iamharveststorm/harvey/код/симуляция/управление с клавиатуры/assets/world/concrete_n.png

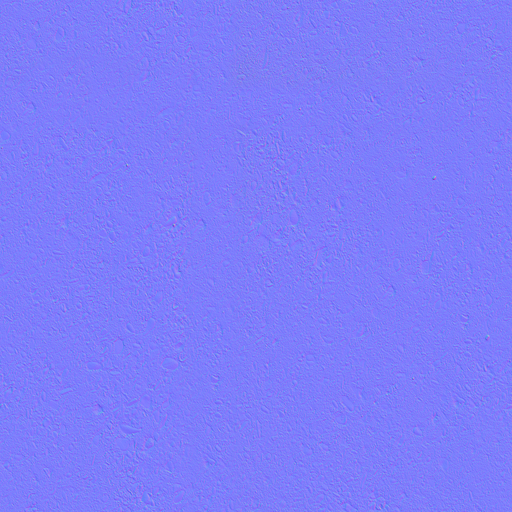
код/симуляция/управление с клавиатуры/assets/world/concrete_n.png
