iamharveststorm/harvey/код/симуляция/управление с клавиатуры/assets/world/pebbles_orm.png

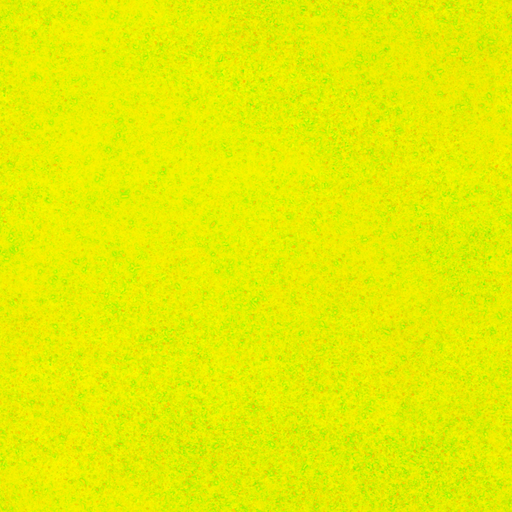
код/симуляция/управление с клавиатуры/assets/world/pebbles_orm.png
