iamharveststorm/harvey/README.md

# Харви — настольный робот-краб

DIY-робот для рабочего стола: компаньон и помощник с добрым характером. Шесть ног, две клешни, глаза-дисплеи. Мозг для речи и зрения работает на домашнем ПК, робот связан с ним по Wi-Fi.

**Начни с [Харви](<Харви.md>)** — там все заметки, модели, код и текущий этап.

## Версии

| Ветка git | Версия | Что это |
| --- | --- | --- |
| `kompakt` (метка `v2-kompakt`) | «Компакт» | STS3215 на ногах, хвост с присоской, Raspberry Pi 5 |
| `kompakt-mini` | «Компакт мини» | все 28 приводов — STS3032, без хвоста, Pi Zero 2 W, станция зарядки |

Чем отличаются и как переключиться — [Версии Харви](<заметки/Версии Харви.md>).

## Сейчас

Этап 1 — стенд одной ноги. Для мини всё заказано, детали приезжают 19–31 октября 2026: [чек-лист](<заметки/Чек-лист стенда мини.md>). Программа стенда и прошивка Pico 2 готовы и проверены в имитации.

## Папки

| Папка | Что внутри |
| --- | --- |
| [заметки](<заметки/>) | концепция, комплектация, питание, этапы, [журнал решений](<заметки/Журнал решений.md>) |
| [модели](<модели/Модели.md>) | CAD и STL: корпус, клешни, глаза, хвост, мини, стенды; рендеры и чертежи |
| [код/симуляция](<код/симуляция/Симуляция.md>) | MuJoCo: походка, сценарии, управление с клавиатуры, фотореализм |
| [код/стенд привода](<код/стенд привода/README.md>) | программа стенда: замеры приводов и ноги, отчёт в Excel |
| [схемы](<схемы/README.md>) | проводка «Компакт мини»: питание, шины приводов, Pi Zero, датчики (WireViz + schemdraw) |
| [код/прошивка](<код/прошивка/Прошивка.md>) | Pico 2 на MicroPython: шина приводов |
| [визуализация](<визуализация/>) | 3D-модель и интерактивный двойник «Компакта», двойник «Компакт мини» — открываются в браузере без интернета |
| [документы](<документы/Документы.md>) | даташиты приводов и плат, протокол шины Feetech |
| [фото](<фото/>) | эскизы, референсы, фото стенда |

## Как открыть

- **Obsidian:** «Открыть папку как хранилище» → эта папка. Главная заметка — «Харви».
- **Claude Code:** запускать в этой папке; контекст проекта — [CLAUDE.md](<CLAUDE.md>).
- **Окружения Python** живут вне OneDrive, в `C:\venvs\` (`harvey` — симуляция, `harvey-bench` — стенд, `harvey-cad` — CAD). Первые два батники в папках кода создают сами; как запускать CAD — в README папок `модели/`.

## Ранние онлайн-версии

Первые артефакты в Claude (до компоновки v2, местами устарели — источник правды здесь, в заметках): [концепт](https://claude.ai/artifact/2FwnsAK9YNNhDf2f2BEky4), [интерактивный двойник](https://claude.ai/artifact/RYYA5ZLK6qtaRUAYd5tzXc), [3D-модель](https://claude.ai/artifact/Ps9CTr6259VduU2Yr22FZN), [комплектация](https://claude.ai/artifact/6K368x5LdZn2f412QVXJA1), [совместимость](https://claude.ai/artifact/D9gDPVZMyHfYxsEXmXBaE7), [питание](https://claude.ai/artifact/VXmcD6U4bhPNbsvyJew3gP), [сборка в Onshape](https://claude.ai/artifact/CMEwwumpoMRSfavFtf1Tat), [этап 1](https://claude.ai/artifact/AMX4DpM3XnacjujbDYmoD6).
