iamharveststorm/harvey/схемы/README.md

---
title: Схемы «Компакт мини» — проводка и шина
date: 2026-10-25
tags: [харви, мини, схемы, питание, проводка]
aliases: [Проводка мини, Схемы мини]
---
# Схемы «Компакт мини»: проводка, токи, шина приводов

Семь листов, все строятся из кода (`make_wiring.py`), поэтому правятся числами, а не мышкой. Источник чисел — [[Компакт мини]], [[Комплектация мини]], [[Питание и проводка]] (принципы) и [[STS3032-C036 — даташит Feetech (6 В).pdf|даташит STS3032-C036]].

| Лист | Что на нём | Файлы |
| --- | --- | --- |
| **Питание и логика** | батарея → BMS → XT30 → плата питания (предохранитель, выключатель, INA226) → DC-DC 6 В и 5 В; заряд со станции; Pi Zero 2 W ↔ RP2350 ↔ плата шин | `mini_power.svg` / `.png` / `.html`, спецификация `mini_power.bom.tsv` |
| **Шины приводов** | 3 шины, 9 отводов от платы шин, 28 приводов с номерами ID, кабели и токи | `mini_bus.svg` / `.png` / `.html`, `mini_bus.bom.tsv` |
| **Pi Zero 2 W** | камера (шлейф CSI), 2 дисплея глаз (SPI), 2 микрофона и усилитель с динамиком (I2S), 4 сенсорные кнопки | `mini_pi.svg` / `.png` / `.html`, `mini_pi.bom.tsv` |
| **Датчики RP2350** | 6 датчиков края VL53L4CD, IMU BMI270, 2 ИК-приёмника маяка, сигнал INA226 | `mini_sensors.svg` / `.png` / `.html`, `mini_sensors.bom.tsv` |
| **Интерфейс шины** | принципиальная схема одной шины: 2 буфера LVC и автопереключение направления по схеме Feetech | `bus_buffer.svg` / `.png` |
| **Станция: питание** | USB-C 5 В 3 А → PTC 3 А → контакты pogo и плата маяка | `station.svg` / `.png` / `.html`, `station.bom.tsv` |
| **Станция: маяк** | RP2350-Zero: пачки 38 кГц по очереди на левый (0,6 мс) и правый (1,2 мс) светодиод TSAL6200 через ключи AO3400A | `beacon.svg` / `.png` |

Листы проводки широкие — смотреть удобнее `.html` или `.svg` в браузере (масштаб колесом). В `.html` под схемой — таблица проводов и спецификация.

![[bus_buffer.png]]

![[mini_bus.png]]

![[mini_power.png]]

![[mini_pi.png]]

![[mini_sensors.png]]

![[beacon.png]]

![[station.png]]

## Токи и сечения

| Участок | Напряжение | Средний ток | Пик | Провод |
| --- | --- | --- | --- | --- |
| Батарея → BMS → XT30 → плата питания → выключатель | 7,4 В (6,0–8,4) | 1,5–2 А при ходьбе | ~10 А | 18 AWG силикон |
| Плата питания → DC-DC 6 В | 7,4 В | 1–1,5 А | ~9 А | 18 AWG |
| DC-DC 6 В → плата шин (все 28 приводов) | 6,0 В | 1–2 А при ходьбе | 8–10 А | 18 AWG |
| Плата шин → нога (3 привода) | 6,0 В | 0,1–0,6 А | 3,6 А (3 × упор 1,2 А) | 22 AWG |
| Плата шин → клешня (4 привода) | 6,0 В | 0,1–0,3 А | 4,8 А | 22 AWG |
| Плата шин → глаза (2 привода) | 6,0 В | до 0,1 А | 2,4 А | 22 AWG |
| Привод → привод внутри конечности | 6,0 В | — | 1,2 А × число приводов дальше | 1,25 мм, 28 AWG (из комплекта) |
| Плата питания → DC-DC 5 В → Pi Zero 2 W | 7,4 / 5 В | 0,5–1,5 А (5 В) | — | 22 AWG |
| Станция → пластины на брюхе → модуль заряда | 5 В | до 3 А | — | 20 AWG |
| Модуль заряда → батарея | 8,4 В | до 1,8 А | — | 22 AWG |
| Логика, шины A/B/C, I2C | 3,3 В | — | — | 28 AWG |
| Pi → камера (шлейф CSI) | 3,3 В | 0,2–0,25 А | — | шлейф Zero 22 → 15 pin |
| Pi → глаз (через стебелёк, × 2) | 3,3 В | ~35 мА с подсветкой | — | 8 × 30 AWG силикон, петля на поворот |
| Pi → усилитель → динамик | 5 В | до 0,3 А | — | 28 AWG; динамик — 26 AWG |
| Pi → микрофоны, кнопки; RP2350 → датчики | 3,3 В | мА | — | 30 AWG |

Бюджет: ходьба 8–12 Вт → 1,5–2 ч от 22 Вт·ч (оценка из симуляции; стенд ноги её проверит — замер Н5).

## Номера приводов (ID)

ID = 10 × конечность + сустав. Шина A — левые ноги, B — правые ноги, C — клешни и глаза.

| Конечность | Шина | ID |
| --- | --- | --- |
| левая передняя / средняя / задняя нога (LF, LM, LB) | A | 11–13 · 21–23 · 31–33 (поворот, бедро, колено) |
| правая передняя / средняя / задняя нога (RF, RM, RB) | B | 41–43 · 51–53 · 61–63 |
| левая / правая клешня (CL, CR) | C | 71–74 · 81–84 (поворот плеча, подъём, локоть, захват) |
| глаза левый / правый (EY) | C | 91 · 92 |

На стенде ноги номера 1–3 — это временно; в роботе их перепишет программа стенда (пункт 2 меню).

## Выводы RP2350-Zero (предварительно)

У RP2350-Zero 20 выводов (GP0–GP15, GP26–GP29) — **заняты все, кроме двух**. Поэтому 4 сенсорные кнопки перенесены на Pi Zero: там свободных выводов много, а реакция на поглаживание и так работает на борту без ПК.

| Вывод | Назначение | Почему здесь |
| --- | --- | --- |
| GP0 / GP1 | шина A (левые ноги): UART0 TX / RX | аппаратный UART |
| GP4 / GP5 | шина B (правые ноги): UART1 TX / RX | второй аппаратный UART |
| GP8 / GP9 | шина C (клешни, глаза): UART на PIO | аппаратных UART всего два |
| GP12 / GP13 | I2C0 SDA / SCL: INA226, BMI270, 6 × VL53L4CD | одна шина на все датчики, 400 кГц |
| GP2, GP3 | XSHUT датчиков края вперёд (слева, справа) | у VL53L4CD один адрес: при включении поднимаем XSHUT по одному и меняем адрес |
| GP6, GP7 | XSHUT датчиков края назад | |
| GP10, GP11 | XSHUT датчиков края по бокам | |
| GP14 / GP15 | ИК-приёмники TSOP38238 слева / справа | направление на маяк станции без ПК |
| GP28 | ИК-приёмник TSOP38238 по центру, под камерой | по какую сторону оси станции корпус — заход в темноте |
| GP26 | INT1 BMI270 | прерывание: рывок, падение, «подняли» — мгновенно, без опроса |
| GP27 | ALERT INA226 | прерывание: низкий заряд, перегрузка |
| GP29 | **резерв** (АЦП) | например, второй замер батареи или датчик касания на брюхе |
| USB-C | связь с Pi Zero 2 W (USB CDC) и питание 5 В от Pi | данные и питание одним кабелем |

## Выводы Pi Zero 2 W (предварительно)

| Пин гребёнки | GPIO | Назначение |
| --- | --- | --- |
| 2 / 4 | — | 5 В: вход от DC-DC 5 В / питание усилителя |
| 1 / 17 | — | 3,3 В: глаза / микрофоны и кнопки |
| 6, 9, 14, 20, 25 | — | GND |
| 23 / 19 | GPIO11 / GPIO10 | SPI0 SCLK / MOSI — оба глаза |
| 24 / 26 | GPIO8 / GPIO7 | SPI0 CE0 — левый глаз / CE1 — правый глаз |
| 22 / 18 | GPIO25 / GPIO24 | DC / RST — общие для обоих глаз |
| 32 | GPIO12 | PWM0 — яркость подсветки глаз |
| 12 / 35 | GPIO18 / GPIO19 | I2S BCLK / LRCLK — микрофоны и усилитель |
| 38 | GPIO20 | I2S DIN ← оба микрофона (левый L/R → GND, правый L/R → 3,3 В) |
| 40 | GPIO21 | I2S DOUT → усилитель MAX98357A |
| 37 | GPIO26 | SD усилителя: 0 — тишина |
| 29, 31, 36, 11 | GPIO5, 6, 16, 17 | 4 сенсорные кнопки TTP223 на крышке |
| CSI | — | Camera Module 3 Wide (шлейф Zero 22 → 15 pin) |
| USB OTG | — | RP2350-Zero |

Свободны: GPIO14/15 (UART), GPIO2/3 (I2C1), GPIO4, GPIO13, GPIO22, GPIO23, GPIO27.

## Что выяснилось при рисовании — поправить до закупки

1. **Pogo-контакты станции.** В списке они на ≥ 2 А, а заряд идёт до 3 А при 5 В (IP2326, 15 Вт). Брать pogo **на 3–5 А** — или ограничить ток заряда до 2 А (10 Вт, заряд дольше).
2. **Выключатель** несёт весь ток робота, пик ~10 А. Мини-тумблеры на 3 А не годятся: нужен ≥ 10 А (или выключатель-кнопка с MOSFET).
3. **Провод 22 AWG** — для отводов от платы шин к конечностям (пик 3,6–4,8 А). В списке были только 18 и 26 AWG.
4. **Разъём 1,25 мм** рассчитан примерно на 1 А на контакт. Первый привод конечности пропускает ток всех следующих: у ноги в упоре — до 3,6 А, у клешни — до 4,8 А. Упор всех приводов сразу редок, но на стенде ноги стоит потрогать разъём после 10 минут шага (замер Н4). Если греется — питание к каждому приводу отдельным проводом от платы шин.
5. **Сколько разъёмов у STS3032?** На чертеже Feetech виден один. Если так и есть, цепочка привод → привод собирается тройниками из комплекта разъёмов 1,25 мм. Схема одинакова в обоих случаях.
6. **Станция.** В сводке [[Компакт мини]] было «блок питания 12 В 2 А», в [[Комплектация мини]] и здесь — USB-C 5 В 3 А (модуль заряда IP2326 принимает 5 В). Сводка исправлена на 5 В.
7. **Все выводы RP2350-Zero заняты.** Кнопки касания перенесены на Pi Zero; на RP2350 остались прерывания IMU и INA226 и 1 резервный вывод (GP28 занял центральный ИК-приёмник). Если понадобится ещё что-то, следующий шаг — расширитель выводов по I2C (например, PCA9555) или RP2350 побольше.
8. **3,3 В от Pi** питают камеру (0,2–0,25 А), оба глаза и микрофоны — всего около 0,35 А. Это в пределах, но запас небольшой. Если глаза будут мерцать при съёмке, подсветку нужно питать от отдельного стабилизатора 3,3 В.
9. **Глаза — 8 проводов через подвижный стебелёк.** Нужен тонкий силиконовый провод (30 AWG) с петлёй на поворот глаза от −90° до +20°, частота SPI — не выше 32 МГц. Двум глазам 160 × 160 при 30 кадр/с нужно около 25 Мбит/с, так что этого хватает.
10. **Кнопки на съёмной крышке.** На крышку идут 6 проводов (3,3 В, GND, 4 сигнала) — нужен разъём, чтобы крышку можно было снять. Микроразъём JST 1,25 мм на 6 контактов.

## Станция-«гнездо»

**Маяк: два светодиода и перегородка.** Один светодиод даёт Харви только направление на себя, но не ось станции. Сбоку Харви приходил к контактам по диагонали и промахивался мимо пластин (допуск вбок ±3,5 мм). Поэтому светодиодов два, левый и правый, а между ними перегородка к Харви. Оба светодиода видны только в узком клине вдоль оси. Центральный приёмник Харви видит оба — значит, Харви на оси; видит только левый — Харви левее оси. В темноте метка AprilTag не видна, а маяк работает.

**Почему RP2350-Zero, а не NE556.** Светодиоды нужно различать. Они светят по очереди пачками разной длины, и TSOP382 повторяет длину пачки на выходе: tpo = tpi ± 5/f0, то есть ±132 мкс (документы/TSOP382 — даташит Vishay.pdf, стр. 3). Нарезать две разные пачки по очереди на двух таймерах NE556 сложно. RP2350-Zero делает это одной программой, и плата та же, что «спинной мозг» Харви.

| Что | Расчёт | Итог |
| --- | --- | --- |
| Пачки | левый 0,6 мс, пауза 0,6, правый 1,2 мс, пауза 0,6 (`код/прошивка/станция/beacon_station.py`) | 23 и 46 периодов, пауза 23; TSOP382: пачка ≥ 10, пауза ≥ 12, ≤ 1700 пачек/с — здесь 667 |
| Несущая | ШИМ RP2350 38 кГц, заполнение 1/3 | — |
| Ключ AO3400A | Vgs(th) ≤ 1,45 В, Rds(on) < 48 мОм при 2,5 В (документы/AO3400A — даташит AOS.pdf) | открывается от 3,3 В вывода |
| Светодиод TSAL6200 | (5 − 1,35) В / 33 Ом | ~110 мА в импульсе (IFM 200 мА), в среднем ≤ 15 мА |

**Где что стоит** (модели/мини, `dock_tower`):
- светодиоды — в стенке башенки на высоте 12 мм, в 3,5 мм по обе стороны оси;
- перегородка — 42,5 мм к Харви, высотой 31 мм, толщиной 1,5 мм. Она ниже метки, иначе камера на оси видит её ребром поперёк метки;
- метка — в окне на высоте 33–63 мм, башенка 67 мм;
- на Харви три TSOP38238: боковые по сторонам камеры развёрнуты наружу на ±30°, центральный стоит под объективом и смотрит вперёд.

Клин, где центральный приёмник видит оба светодиода: половина ширины ≈ 2,75 · D / 42,5 − 3,5 мм на расстоянии D. У контактов это ~1 мм, в 30 см — ~16 мм. Проверка `check_beacon` в модели — что видит каждый приёмник:

| Где Харви (от стенки корпуса до башенки, сдвиг вбок) | слева | центр | справа |
| --- | --- | --- | --- |
| 300 мм, по оси | L | LR | R |
| 300 мм, +15 мм | L | L | LR |
| 300 мм, −15 мм | LR | R | R |
| 100 мм, по оси | L | LR | R |
| 100 мм, ±15 мм | — / L | L / R | R / — |
| 20 мм — уже над площадкой | — | — | — |

Над площадкой маяк не виден: приёмники уже у перегородки. Дальше Харви идёт по курсу гироскопа и останавливается по датчикам края.

**Что проверить на стенде:**
- длина пачек на выходе TSOP (осциллограф или `beacon.py`);
- граница клина у реальной перегородки — отражения от стола могут его расширить; если так, ток светодиодов уменьшить резистором побольше;
- не греются ли резисторы 33 Ом.

## Как перестроить

Двойной клик по `make_schemes.bat` (окружение `C:\venvs\harvey-schemes`: WireViz 0.4, schemdraw 0.23, Graphviz 16). Числа, провода и подписи — в `make_wiring.py`; `.yml` генерируются из него.

Related: [[Компакт мини]] · [[Комплектация мини]] · [[Питание и проводка]] · [[Чек-лист стенда мини]] · [[код/прошивка/pico/README|Pico 2 — шина приводов]] · [[Журнал решений]]
