iamharveststorm/harvey/модели/стенд кисти/README.md

# Харви — детали стенда кисти (STS3032-C036)

Кисть клешни для этапа 1: запястье (привод 21) поворачивает кисть вокруг оси предплечья, захват (привод 22) двигает верхний палец, нижний палец неподвижный. Пальцы 26 мм согнуты вниз на 30°, на рабочих гранях — накладки из TPU. Всё сделано под [[STS3032-C036 — даташит Feetech (6 В).pdf|STS3032-C036]], размеры — с чертежа на с. 6 даташита.

![[рендер кисти.png]]

Рендер — Blender: `python export_render_parts.py`, затем `blender --background --python render_hand.py` (папка `render_parts/` — промежуточные STL для рендера, их не печатать). Чертёж ладони — [[ХАРВИ.02.002 Ладонь кисти.pdf]].

![[сборка кисти.png]]

## Детали (папка `stl/`)

| Файл | Сколько | Материал | Как печатать | Зачем |
| --- | --- | --- | --- | --- |
| `harvey_hand_wrist_stand.stl` | 1 | PETG | основанием на стол | стойка: держит привод 21 валом вперёд, ось на 40 мм над доской |
| `harvey_hand_palm.stl` | 1 | PETG | стенкой на стол, с поддержками под пальцем | ладонь: на качалку привода 21, держит привод 22 и нижний палец |
| `harvey_hand_jaw.stl` | 1 | PETG | плашмя | верхний подвижный палец на качалке привода 22 |
| `harvey_hand_pad_TPU_x2.stl` | 2 | TPU 95A | плашмя, насечкой вверх | накладки на пальцы, вклеить в пазы |
| `harvey_hand_grip_lever_25mm.stl` | 1 | PETG | плашмя | рычаг 25 мм для замера силы захвата (замер 10) |
| `harvey_hand_cradle_sts3032.stl` | 1 | PETG | основанием на стол | держатель одного STS3032 валом вверх — для замеров без кисти |

`_сборка_для_просмотра.stl` — вся кисть вместе с приводами для просмотра, её не печатать.

## Крепёж

- К приводу — 4 винта M2 × 6 в резьбу торца (ряды через 16 мм, шаг 9 мм); головки утоплены в пластине.
- К качалке — винты M2 × 6 в резьбу качалки (8 × M2 на Ø10): верхний палец — 4 винта через одно, ладонь на качалке запястья — 3 винта (четвёртое место закрыто стенкой ладони, к нему не подлезть ключом).
- Ключ — шестигранник 1,5 мм (под M2 с внутренним шестигранником).
- Стойка и держатель — к доске шурупами 4 мм.

## Сборка

1. Привод 21 вставить в стойку сзади (качалка проходит в окно), прикрутить 4 винтами спереди.
2. Привод 22 вставить в ладонь со стороны корпуса, прикрутить 4 винтами со стороны пальцев.
3. Верхний палец — на качалку привода 22. Перед этим выставить привод 22 в положение «закрыто» (пальцы сомкнуты), чтобы рабочий ход был на раскрытие.
4. Ладонь — на качалку привода 21.
5. Вклеить накладки TPU в пазы пальцев. Сомкнутые пальцы с накладками оставляют зазор 1 мм — привод дожимает.

## Перед печатью — измерить

В начале `harvey_hand_parts.py` значения с пометкой «ИЗМЕРИТЬ» взяты с чертежа даташита. Самые важные — расстояние от оси вала до ближнего торца корпуса (`shaft_from_end`, по чертежу ~5,7 мм) и высота качалки над торцом (`horn_top`, ~4,8 мм). Если штангенциркуль покажет другое:

    pip install manifold3d trimesh numpy
    python harvey_hand_parts.py     # пересоздаст stl/ и проверит столкновения

Скрипт проверяет пересечения деталей и приводов во всём ходе: запястье ±90°, захват 0…60°. Сейчас столкновений нет.

![[детали кисти.png]]
