iamharveststorm/harvey/код/прошивка/rp2350/README.md

---
title: RP2350 — «спинной мозг» «Компакт мини»
date: 2026-11-02
tags: [харви, мини, прошивка, micropython, rp2350]
aliases: [Спинной мозг мини, Прошивка RP2350]
---
# RP2350-Zero — «спинной мозг» «Компакт мини»

MicroPython на RP2350-Zero: три шины приводов, 6 датчиков края, IMU, ток батареи, ИК-маяк станции — и рефлексы, которые нельзя ждать от Pi или ПК. С головой (Pi Zero 2 W) говорит строками JSON по USB.

**ПРЕДВАРИТЕЛЬНО.** Выводы — по [[схемы/README|схемам]], железа ещё нет. Всё проверено на ПК против имитаций датчиков, написанных по их даташитам. Что нужно проверить на стенде — в конце.

## Что делает

| Каждый проход (~5 мс) | 10 раз в секунду | 20 раз в секунду |
| --- | --- | --- |
| датчики края, IMU, команды от Pi, рефлексы | батарея (INA226), маяк (TSOP38238) | телеметрия на Pi |

**Рефлексы** (`reflex.py`):
- **Край стола.** Команда движения в сторону, где под датчиками пусто, не уходит к приводам, а Pi получает событие `edge`. Отойти от края можно. Поворот у края запрещён: задние ноги могут сойти со стола.
- **Подняли или падает.** Все 6 датчиков не видят стол, или IMU фиксирует свободное падение (< 0,35 g дольше 30 мс). Тогда все приводы отпускаются, чтобы не бороться с рукой и не ломать шестерни.
- **Батарея.** Ниже 6,8 В — событие `bat_low`, пора на станцию. Ниже 6,4 В — `bat_critical`: можно только стоять или садиться.
- **На станции.** Ток заряда больше 50 мА — событие `docked`.

## Файлы

| Файл | Что | Источник чисел |
| --- | --- | --- |
| `pins.py` | выводы и пороги | [[схемы/README]], [[Комплектация мини]] |
| `vl53l4cd.py` | датчик края: запуск, замер, смена адреса | [[VL53L4CD — даташит ST.pdf]]; регистры — драйвер Adafruit (MIT), перенесённый с ULD ST |
| `edge.py` | 6 датчиков на одной шине: по очереди XSHUT → свой адрес 0x30–0x35, калибровка «стол» (только замеры в ±15 мм от расчётного `pins.EDGE_NOMINAL_MM`), край | там же, разд. 2 (XSHUT, загрузка ≤ 1,2 мс) |
| `bmi270.py` + `bmi270_config.bin` | IMU: запуск с файлом конфигурации 8 КБ, ускорение и вращение | [[BMI270 — даташит Bosch.pdf]], стр. 18–22; файл — Bosch API v2.86.1 (BSD-3, `BMI270-CONFIG-LICENSE.txt`) |
| `ina226.py` | напряжение, ток, мощность батареи, тревога «низкий заряд» | [[INA226 — даташит TI.pdf]], табл. 7-1…7-12, ф. 1 |
| `imu_events.py` | наклон, падение, удар, опрокидывание | пороги — оценка, уточнить |
| `beacon.py` | 3 × TSOP38238 (слева, по центру, справа): длина пачки → какой светодиод станции; куда маяк и по какую сторону оси корпус | [[TSOP382 — даташит Vishay.pdf]], стр. 3: tpo = tpi ± 5/f0 |
| `link.py` | формат сообщений с Pi (им же пользуется голова) | — |
| `reflex.py` | решения рефлексов, номер шины по ID | — |
| `spine.py` | главный цикл: всё вместе | — |
| `pio_uart.py` | третий UART на PIO для шины C | примеры MicroPython rp2 |
| `main.py` | запуск на плате: собирает настоящие устройства | — |

Драйвер шины приводов — общий со стендом: `код/прошивка/pico/sts_bus.py` (копируется на плату рядом).

## Связь с Pi

Одна строка — одно сообщение JSON; формат описан в начале `link.py`.

- **Pi → RP2350:**
  - `j` — цели суставов и куда хочет ехать корпус;
  - `cal` — запомнить стол под датчиками;
  - `relax` — отпустить приводы;
  - `pos?` — где сейчас приводы (для калибровки нулей; ответ `pos`);
  - `hello` — представиться.
- **RP2350 → Pi:**
  - `tel` — телеметрия: расстояния до стола, край, наклон, ускорение, вращение (`gyr`, °/с — по нему голова считает курс), батарея, маяк (`ir` — пачки левого и правого светодиода на каждом приёмнике, `beacon` — куда маяк, `axis` — по какую сторону оси станции корпус);
  - `ev` — событие: `edge`, `fall`, `shock`, `tip`, `lifted`, `bat_low`, `bat_critical`, `docked`;
  - `err` — ошибка;
  - `pos` — позиции приводов по запросу `pos?` и кто не ответил;
  - `hello` — версия протокола и список недостающих устройств.

## Проверка на ПК

```bash
C:\venvs\harvey-bench\Scripts\python.exe -m pytest -q tests
```

173 теста, < 1 с. Вся прошивка без правок работает и в симуляции мини — с имитациями датчиков по физике MuJoCo
(`код/симуляция/мини/mini_sensors.py`, `mini_robot.py`). Имитации в `tests/fakes.py` ведут себя по даташитам:
- INA226 считает ток через шунт и калибровку;
- BMI270 принимает файл конфигурации частями и отказывает, если в нём хоть один неверный байт;
- VL53L4CD отвечает на 0x29 только при поднятом XSHUT и меняет адрес;
- готовность замера VL53L4CD учитывает полярность прерывания.

Пересчёт времени замера VL53L4CD сравнивается с кодом Adafruit на 24 сочетаниях.

Качество кода:
- покрытие 95 %, без тестов только `main.py` и `pio_uart.py` — им нужна плата;
- самая сложная функция — 7 (порог 10);
- повторяющегося кода нет;
- тесты ловят 87–100 % подстроенных ошибок (мутаций) по модулям.

## Стенд без приводов (Pico 2 H)

У Pico 2 H тот же чип RP2350, что у RP2350-Zero, и выводы с теми же номерами. Поэтому до приезда приводов на ней проверяется почти вся прошивка «спинного мозга».

```bash
C:\venvs\harvey-bench\Scripts\python.exe -m pip install mpremote
C:\venvs\harvey-bench\Scripts\python.exe bench_pc.py
```

Порт плата находит сама: USB VID 0x2E8A. `bench_pc.py` делает три шага, их можно запускать по отдельности — `copy`, `selftest`, `link`:
1. **`copy`** — копирует на плату прошивку, `sts_bus.py`, `beacon_station.py` и `bmi270_config.bin`.
2. **`selftest`** — запускает на плате `selftest.py` и печатает отчёт «ОК / НЕТ» с подсказкой, что проверить.
3. **`link`** — перезагружает плату (стартует `main.py`) и проверяет связь по USB: ответ на `hello`, телеметрия 20 раз в секунду, цели 28 приводов без ошибок, ответ на `pos?`.

**Перемычки для самопроверки:**

| Перемычка | Что проверяет |
| --- | --- |
| GP0 → GP1 | шина A (UART0) на 1 Мбит/с |
| GP4 → GP5 | шина B (UART1) |
| GP8 → GP9 | шина C (UART на PIO): по байту и **сплошным потоком** |
| GP16 → GP14, GP28, GP15 | маяк: GP16 изображает выход TSOP38238 — пачки станции 0,6 и 1,2 мс. Каждый из трёх входов должен насчитать по 30 пачек левого и правого светодиода |
| датчики на GP12 SDA / GP13 SCL, 3,3 В | что найдено на I2C. Если подключены — расстояние VL53L4CD, напряжение INA226, ускорение BMI270 (~1 g) |

Ещё меряется проход главного цикла без устройств (бюджет 5 мс). Без перемычки проверка честно скажет «НЕТ» — так видно, какой вывод не работает.

**Почему поток через PIO — отдельная проверка.** У PIO-UART очередь приёма всего 4 байта. Ответ привода — около 20 байт подряд, по байту каждые 10 мкс. Если MicroPython не успевает их забирать, байты теряются, и на шине C (клешни, глаза) это будет выглядеть как «привод не отвечает».

## Залить на плату

1. Прошить MicroPython для RP2350 (как для Pico 2 — [[код/прошивка/pico/README|Pico 2]]).
2. Скопировать в корень платы (Thonny → «Сохранить как… → Raspberry Pi Pico»): все `.py` из этой папки, `bmi270_config.bin` и `../pico/sts_bus.py`. Папку `tests/` не нужно.
3. После перезагрузки `main.py` стартует сам и шлёт `{"t":"hello",…}` с перечнем недостающих устройств.

## Проверить на стенде

1. **Выводы.** Прозвонить все выводы по `pins.py` и схеме: до пайки, а не после.
2. **Шина C на PIO.** Работает ли третий UART (`pio_uart.py`) на 1 Мбит/с: `ping` всех ID шины C и `bus_test.py` на ней.
3. **Датчики края.** Все шесть отвечают на адресах 0x30–0x35. Расстояние до стола у каждого стабильно ±3 мм, а запас края 25 мм не даёт ложных срабатываний на ворсе и стыках стола. Совпадает ли расстояние до стола с расчётным `EDGE_NOMINAL_MM` (72 / 104 мм) — иначе поправить. Боковые лучи пологие (3,5 : 1): в симуляции на повороте у предметов их показания гуляют на 20–30 мм.
4. **Знак тока INA226.** Тока заряда — «−» (иначе поменять знак в `spine.CHARGE_A`). Пиковый ток робота не выходит за 8,19 А: это предел шунта 10 мОм (81,92 мВ).
5. **Оси BMI270** — как датчик стоит в корпусе. Пороги падения, удара и наклона подобрать на стенде и в симуляции.
6. **Маяк.** Сколько пачек каждого светодиода за 100 мс видят три приёмника с 10, 30 и 100 см. Подходят ли `SEEN_MIN = 20`, `SEEN_CODE = 10` и граница 0,9 мс между пачками 0,6 и 1,2 мс. Ширина клина «оба светодиода» у центрального приёмника — сверить с [[схемы/README|расчётом]].
7. **Момент после `relax`.** Spine считает, что запись цели (`sync_write` в регистр 42) снова включает момент приводов STS. Проверить: отпустить приводы, прислать `j` — встаёт ли робот. Если нет — перед целями писать Torque Enable (40) = 1.

Related: [[Компакт мини]] · [[схемы/README|Схемы мини]] · [[код/голова/README|Голова]] · [[код/прошивка/pico/README|Pico 2 — шина приводов]] · [[Журнал решений]]
