iamharveststorm/harvey/код/прошивка/pico/README.md

# Pico 2 — шина приводов (замер 12 стенда)

Первая прошивка «спинного мозга»: Pico 2 сама говорит с приводами по шине Feetech. Проверяет то, что нельзя проверить с ноутбука: три привода на одной шине от Pico, 10 минут, общая команда всем одним пакетом и опрос каждого. Норма — обмен с приводом **≤ 1 мс** и **ни одной ошибки**.

## Файлы

- `sts_bus.py` — драйвер шины на MicroPython: пакеты, эхо полудуплекса, чтение и запись регистров, общая запись (sync write). Тот же протокол, что в `код/стенд привода/harvey_bench/sts.py`.
- `bus_test.py` — сам замер. Наверху файла — настройки: номера приводов, длительность, качать ли суставы (±5°).
- `pc_check.py` — проверка прошивки на ПК без железа: вместо UART — имитация трёх STS3032, с эхом и без. Запускать обычным Python: `python pc_check.py`.

## Подключение

| Pico 2 H | Waveshare Bus Servo Adapter (A) |
| --- | --- |
| GP0 (ножка 1) — TX | RX |
| GP1 (ножка 2) — RX | TX |
| GND (ножка 3) | GND |

- Провода — Dupont «папа-мама»: на адаптере штырьки, Pico стоит в макетке.
- **Перемычки A/B** на адаптере переставь на внешний UART (по надписи на плате: USB — работа с ПК, UART/ESP32 — с Pico). Сверь с надписью на своей плате: если не уверен — пришли фото.
- **Питание приводов:** лабораторный блок, **6,0 В, предел 3 А** — в зелёный клеммник адаптера (+ и −). Pico питается от USB ноутбука.
- Приводы — в белые разъёмы адаптера через переходник 1,25 → 5264 из коробки привода.
- Номера приводов (1, 2, 3) назначаются заранее программой стенда через URT-1 — пункт 2 меню.

## Установка (один раз)

Уже сделано на этом ПК (17.10.2026): Thonny 5.0 установлен, MicroPython скачан, в окружение стенда добавлен `mpremote` (загрузка файлов из командной строки).

1. MicroPython для **Raspberry Pi Pico 2** лежит в `firmware/RPI_PICO2-20260824-v1.29.0.uf2` (в git не хранится — новая версия: micropython.org/download/RPI_PICO2).
2. Зажми кнопку **BOOTSEL** на Pico и подключи USB — появится диск RP2350. Перетащи туда `.uf2` — Pico перезагрузится, диск пропадёт: это нормально.
3. Открой **Thonny** (меню «Пуск»). Внизу справа выбери интерпретатор «MicroPython (Raspberry Pi Pico)» — внизу появится `>>>`.
4. В Thonny открой `sts_bus.py` и `bus_test.py` и сохрани оба **на Pico** (Файл → Сохранить как → Raspberry Pi Pico).

## Запуск

Открой `bus_test.py` на Pico → **Run (F5)**. Каждые 10 с — строка: циклы, ошибки, среднее и максимальное время обмена, напряжение, температура приводов. В конце — итог «ОК / НЕ ОК». Остановить — **Stop** или Ctrl+C: приводы отпустятся.

Скопируй вывод из Thonny и пришли — разберём. Если приводы «не отвечают»:
- нет 6 В на клеммнике или перепутаны + и −;
- перемычки адаптера остались на USB;
- TX и RX перепутаны (GP0 должен идти в RX адаптера);
- нет общей земли Pico и адаптера.

Related: [[код/прошивка/Прошивка|Прошивка]] · [[код/стенд привода/README|Стенд привода]] · [[Чек-лист стенда мини]]
