iamharveststorm/harvey/graphify-out/GRAPH_REPORT.md

# Graph Report - Harvey  (2026-11-02)

## Corpus Check
- 137 files · ~2,686,158 words
- Verdict: corpus is large enough that graph structure adds value.
- Unclassified: 243 file(s) not represented in the graph (top: .stl 221, .bat 9, (none) 3)

## Summary
- 2440 nodes · 5362 edges · 98 communities (82 shown, 16 thin omitted)
- Extraction: 88% EXTRACTED · 12% INFERRED · 0% AMBIGUOUS · INFERRED: 660 edges (avg confidence: 0.86)
- Token cost: 0 input · 0 output

## Graph Freshness
- Built from commit: `54f8ecb0`
- Run `git rev-parse HEAD` and compare to check if the graph is stale.
- Run `graphify update .` after code changes (no API cost).

## Community Hubs (Navigation)
- Teleop
- run_gui
- boxr
- harvey_hand_parts.py
- harvey_drawings.py
- Mini
- harvey_body_parts.py
- Журнал решений
- Комплектация «Компакт мини» — что купить и что напечатать
- Харви — главная заметка
- test_spine.py
- harvey_layout.py
- harvey_leg_parts.py
- harvey_sim.py
- Компакт мини — симуляция (README)
- harvey_mini_parts.py
- sts.py
- sts_bus.py
- Leg
- json
- test_head_parts.py
- numpy
- Bench
- harvey_eye_parts.py
- export_sim
- result
- Servo
- harvey_world.py
- math
- pathlib
- harvey_grasp.py
- harvey_terrain.py
- Харви 1.0 — питание и проводка
- test_head.py
- disk_on_horn
- mujoco
- AdaptiveGait
- bench.py
- Pico 2 — даташит
- render_desk.py
- Харви — детали стенда одной ноги (PDF)
- test_bench.py
- test_drivers.py
- Terrain
- check
- test_logic.py
- harvey_head/main.py
- стенд привода/tests/conftest.py
- FakeServo
- rp2350/main.py
- test_eyes.py
- PhotoView
- FE-URT-1 — адаптер шины (таблица, конвертирована)
- test_edges_of_rules.py
- Харви — этап 1: покупки и стенд одной ноги
- RemoteTeleop
- sys
- LegGeometry
- pytest
- LegCal
- test_exact.py
- Привод Feetech STS3215-C018 (12 В, 30 кг·см)
- Feetech — протокол связи (SCS/SMS)
- INA226
- check_dock
- test_leg.py
- MiniTeleop
- Feetech — таблица регистров (конвертирована)
- README папки проекта Харви
- harvey_tail_parts.py
- time
- export_robot.py
- harvey_teleop.py
- harvey_mini_teleop.py
- Харви «Компакт мини»
- leg_check.py
- harvey_mini.py
- run_bench_linux.sh
- encode
- VL53L4CD
- Audio
- Head
- Animator
- Spine
- test_keys.py
- SerialBus
- FakeBus
- ImuEvents
- ._macro_pick
- posed
- клешни/export_render_parts.py
- GC9D01
- world_model
- leg_assembly
- run_grip_test
- run_test
- Компоновка v2, вид сверху (поза «стоит, клешни поджаты»)

## God Nodes (most connected - your core abstractions)
1. `Журнал решений` - 60 edges
2. `boxr()` - 55 edges
3. `result()` - 50 edges
4. `Bench` - 44 edges
5. `Leg` - 39 edges
6. `MiniTeleop` - 38 edges
7. `answer()` - 37 edges
8. `Харви — главная заметка` - 36 edges
9. `make()` - 31 edges
10. `Mini` - 28 edges

## Surprising Connections (you probably didn't know these)
- `Встроенная защита STS3215 (70 °C, 2 А / 2 с, 4–14 В)` --semantically_similar_to--> `Защиты STS3215: перегрузка, ток >2 А, напряжение 4–14 В, 70 °C`  [INFERRED] [semantically similar]
  заметки/Питание и проводка.md → документы/STS3215-C018 — даташит Feetech (12 В).pdf
- `Регистр ID (адрес 5; 254 — широковещательный)` --semantically_similar_to--> `Регистр ID (адрес 5) и блокировка EPROM`  [INFERRED] [semantically similar]
  graphify-out/converted/Feetech — таблица регистров_c742f36f.md → документы/Feetech — протокол связи.pdf
- `Цель: позиция, время, скорость (адреса 42–46)` --semantically_similar_to--> `Регистр цели 0x2A: позиция, время, скорость (6 байт)`  [INFERRED] [semantically similar]
  graphify-out/converted/Feetech — таблица регистров_c742f36f.md → документы/Feetech — протокол связи.pdf
- `Протирка стола салфеткой (мини)` --semantically_similar_to--> `sc_wipe()`  [INFERRED] [semantically similar]
  код/симуляция/мини/mini_салфетка.png → код/симуляция/управление с клавиатуры/harvey_scenarios.py
- `Два привода STS3032 (запястье и захват) в чёрных корпусах` --references--> `Привод Feetech STS3032-C036 (6 В, 4,5 кг·см)`  [INFERRED]
  модели/стенд кисти/рендер кисти.png → документы/STS3032-C036 — даташит Feetech (6 В).pdf

## Import Cycles
- None detected.

## Hyperedges (group relationships)
- **Детали стенда одной ноги этапа 1** — документы_harvey_stage1_parts_cradle_servo, документы_harvey_stage1_parts_coxa_bracket, документы_harvey_stage1_parts_coxa_strap, документы_harvey_stage1_parts_femur_plate, документы_harvey_stage1_parts_knee_sleeve, документы_harvey_stage1_parts_tibia_fork, документы_harvey_stage1_parts_foot_tpu, документы_harvey_stage1_parts_lever_100mm [EXTRACTED 1.00]
- **Защита питания Харви** — заметки_питание_и_проводка_аварийная_отсечка_приводов, заметки_питание_и_проводка_мёртвые_контакты_идеальный_диод, заметки_питание_и_проводка_порядок_включения, заметки_питание_и_проводка_пороги_напряжения_pico, заметки_питание_и_проводка_отдельные_dc_dc_и_звезда_земли [EXTRACTED 1.00]
- **Кинематическая цепь кисти: стойка → запястье #21 → ладонь → захват #22 → челюсть против пальца** — модели_стенд_кисти_сборка_кисти_стойка_запястья, модели_стенд_кисти_сборка_кисти_привод_запястья_21, модели_стенд_кисти_сборка_кисти_ладонь, модели_стенд_кисти_сборка_кисти_привод_захвата_22, модели_стенд_кисти_сборка_кисти_верхняя_челюсть, модели_стенд_кисти_сборка_кисти_нижний_палец [EXTRACTED 1.00]
- **Blender-рендеры «Компакт мини» на столе (render_desk.py, HARVEY_ROBOT=mini)** — модели_рендер_мини_1, модели_рендер_мини_2, модели_рендер_мини_3, модели_рендер_render_desk, модели_мини_export_render [EXTRACTED 1.00]
- **Параметрический скрипт → STL → чертёж ГОСТ** — модели_стенд_ноги_harvey_leg_parts, модели_стенд_кисти_harvey_hand_parts, модели_чертежи_readme_чертежи_гост_freecad, модели_чертежи_харви_01_001_рычаг_100_мм, модели_чертежи_харви_02_002_ладонь_кисти [EXTRACTED 1.00]
- **Правила движения v2: CAD-проверка, симуляция и прошивка** — модели_корпус_readme_правила_движения, модели_корпус_harvey_layout, код_симуляция_управление_с_клавиатуры_readme_mujoco_simulation, код_прошивка_прошивка, модели_клешни_readme_клешня_5_суставов, модели_хвост_readme_хвост_с_присоской, модели_глаза_readme_глаз_стебелёк_gc9a01 [EXTRACTED 1.00]
- **Оснастка стенда: стойка запястья, люлька STS3032, рычаг 25 мм** — модели_стенд_кисти_детали_кисти_wrist_stand, модели_стенд_кисти_детали_кисти_cradle_sts3032, модели_стенд_кисти_детали_кисти_grip_lever [INFERRED 0.75]
- **Сборка клешни: ладонь + челюсть + накладки TPU** — модели_стенд_кисти_детали_кисти_palm, модели_стенд_кисти_детали_кисти_jaw, модели_стенд_кисти_детали_кисти_pad_tpu [INFERRED 0.85]
- **Узнаваемые части «Компакт» v2 на рендере: глаза-стебельки, клешни, шесть ног, хвост** — модели_рендер_харви_открытый_1_глаза_стебельки, модели_рендер_харви_открытый_1_клешни, модели_рендер_харви_открытый_1_шесть_ног, модели_рендер_харви_открытый_3_хвост [INFERRED 0.85]
- **Рендеры стендов этапа 1: кисть клешни и одна нога** — модели_стенд_кисти_рендер_кисти, модели_стенд_ноги_рендер_ног, модели_стенд_кисти_harvey_hand_parts, модели_стенд_ноги_harvey_leg_parts [INFERRED 0.85]
- **Обзор камеры мини: вид V, поза «поджато», телеуправление** — код_симуляция_мини_mini_глазами_харви_camera_view, код_симуляция_мини_mini_глазами_харви_tucked_pose, код_симуляция_мини_harvey_mini_teleop [INFERRED 0.85]
- **Неподвижная камера мини и поза «поджато» ради обзора** — заметки_журнал_решений_мини_камера_неподвижна, код_симуляция_мини_readme_поза_поджато_для_камеры, код_симуляция_мини_readme_вид_глазами_харви [INFERRED 0.85]
- **Полоса препятствий на полу (harvey_world)** — код_симуляция_управление_с_клавиатуры_harvey_world, код_симуляция_управление_с_клавиатуры_мир_полоса_ramp_board, код_симуляция_управление_с_клавиатуры_мир_полоса_surface_zones, код_симуляция_управление_с_клавиатуры_мир_склоны_slopes_zone [INFERRED 0.85]
- **Режим «фото»: Харви на поверхностях физики веществ (песок, галька, трава, склон)** — код_симуляция_управление_с_клавиатуры_фото_песок_следы, код_симуляция_управление_с_клавиатуры_фото_галька, код_симуляция_управление_с_клавиатуры_фото_трава, код_симуляция_управление_с_клавиатуры_фото_склон, код_симуляция_управление_с_клавиатуры_harvey_terrain, код_симуляция_управление_с_клавиатуры_harvey_photo [INFERRED 0.85]
- **Варианты полудуплексной шины от Pico 2: Waveshare адаптер или буферы LVC** — заметки_комплектация_мини_waveshare_bus_servo_adapter, заметки_комплектация_мини_буферы_lvc_5в, заметки_чек_лист_стенда_мини_pico_2_h, код_прошивка_pico_readme [INFERRED 0.85]
- **Стенд ноги «Компакт мини»: закупка → замер размеров → печать → замеры Н1–Н5** — заметки_чек_лист_стенда_мини, заметки_комплектация_мини_horn_top_shaft_from_end, заметки_журнал_решений_печать_после_замера_horn_top, код_стенд_привода_readme_режим_компакт_мини, код_стенд_привода_readme_нога_замеры_н1_н5, документы_sts3032_c036_даташит_feetech_6_в [INFERRED 0.85]
- **Подвижные узлы компоновки v2 и их зоны движения** — модели_корпус_компоновка_вид_сверху_зоны_движения, модели_корпус_компоновка_вид_сверху_глаза_на_углах, модели_корпус_компоновка_вид_сверху_плечи_клешней, модели_корпус_компоновка_вид_сверху_хвост_за_подносом [INFERRED 0.85]
- **Шина Feetech: драйвер стенда, драйвер Pico, имитации** — код_стенд_привода_harvey_bench_sts, код_прошивка_pico_sts_bus, код_прошивка_pico_readme_замер_12_шина_от_pico, код_стенд_привода_readme_sim_mode, код_прошивка_pico_readme_проверка_на_пк_без_железа [INFERRED 0.85]
- **Рендеры «Компакта» на столе: 2 варианта корпуса (открытый/мягкий) × ракурсы из render_desk.py** — модели_рендер_харви_мягкий_2, модели_рендер_харви_мягкий_3, модели_рендер_харви_открытый_1, модели_рендер_харви_открытый_2, модели_рендер_харви_открытый_3, модели_рендер_render_desk [INFERRED 0.95]
- **Кадры mini_photo.py: стол, предметы, салфетка, привет** — код_симуляция_мини_mini_photo, код_симуляция_мини_mini_стол, код_симуляция_мини_mini_и_предметы, код_симуляция_мини_mini_салфетка, код_симуляция_мини_mini_привет [INFERRED 0.95]
- **Функции harvey_hand_parts.py, порождающие сборку на рендере** — модели_стенд_кисти_harvey_hand_parts_wrist_stand, модели_стенд_кисти_harvey_hand_parts_palm, модели_стенд_кисти_harvey_hand_parts_jaw, модели_стенд_кисти_harvey_hand_parts_assembly, модели_стенд_кисти_сборка_кисти [INFERRED 0.95]

## Communities (98 total, 16 thin omitted)

### Community 0 - "Teleop"
Cohesion: 0.06
Nodes (18): shared(), tp(), KeyReader, run_gui(), act(), close(), keyname(), norm() (+10 more)

### Community 1 - "run_gui"
Cohesion: 0.16
Nodes (8): keyname(), RemoteMini, run_gui(), close(), press(), release(), tick(), toggle_view()

### Community 2 - "boxr"
Cohesion: 0.10
Nodes (21): arm_plate(), base(), elbow_sleeve(), finger_bar(), flange_plate_cut(), forearm(), hand(), hull() (+13 more)

### Community 3 - "harvey_hand_parts.py"
Cohesion: 0.07
Nodes (37): assembly(), box(), check(), cyl(), finger_bar(), grip_lever(), horn_disk(), jaw() (+29 more)

### Community 4 - "harvey_drawings.py"
Cohesion: 0.05
Nodes (36): test_beacon_counts_pulses_per_window(), box(), build(), cut(), cylx(), cyly(), cylz(), dim_circle() (+28 more)

### Community 5 - "Mini"
Cohesion: 0.20
Nodes (14): Mini, fn(), fn(), test_dock(), test_pen(), test_stand(), test_tip(), test_turn() (+6 more)

### Community 6 - "harvey_body_parts.py"
Cohesion: 0.07
Nodes (22): run(), belly(), camera_assembly(), camera_mount(), check(), test(), claw_base_world(), deck() (+14 more)

### Community 7 - "Журнал решений"
Cohesion: 0.07
Nodes (4): Планка-фиксатор привода бедра (harvey_coxa_strap.stl), Журнал решений, Перепроверка 15.10: перепечатать 4 детали, новая стойка ноги, Боковые датчики края с наклоном луча 3,5 : 1

### Community 8 - "Комплектация «Компакт мини» — что купить и что напечатать"
Cohesion: 0.06
Nodes (45): STS3032-C036 — даташит Feetech (6 В), STS3215-C018 — даташит Feetech (12 В), Документы — даташиты и PDF, FE-URT-1 — адаптер шины (xlsx), Feetech — таблица регистров (xlsx), Комплектация «Компакт мини» — что купить и что напечатать, 3D-печать мини: 41 деталь, ≈ 157 г (PLA / PETG / TPU), Размеры horn_top (4,8 мм) и shaft_from_end (5,7 мм) — измерить до печати (+37 more)

### Community 9 - "Харви — главная заметка"
Cohesion: 0.10
Nodes (39): Харви — галерея, Компоновка v2 — вид сверху (цвета по узлам), Режим «фото» (Filament PBR): песок со следами, галька, трава, Рендеры «Компакт мини» на столе 1 : 1 (Blender, Cycles), Рендеры на столе: открытая рама и мягкий кожух, Чертежи ГОСТ: ХАРВИ.01.001 Рычаг 100 мм, ХАРВИ.02.002 Ладонь кисти, Харви «Компакт» — сборка в Onshape и физическая проверка, Variable Studio «Параметры» (#coxa, #femur, #tibia, #body_*) (+31 more)

### Community 10 - "test_spine.py"
Cohesion: 0.09
Nodes (27): FakeBus, FakePort, Beacon, Clock, Imu, Ina, make(), step() (+19 more)

### Community 11 - "harvey_layout.py"
Cohesion: 0.11
Nodes (14): check(), claw(), claw_ok(), claw_parts_chassis(), eye(), eye_ok(), flat(), inter() (+6 more)

### Community 12 - "harvey_leg_parts.py"
Cohesion: 0.13
Nodes (15): to_trimesh(), box(), coxa_bracket(), cradle(), cyl(), femur_plate(), flange_cut(), foot() (+7 more)

### Community 13 - "harvey_sim.py"
Cohesion: 0.07
Nodes (27): Связь с Pi, inertial(), PB, stand(), urdf(), walk(), arm_ik(), arm_xml() (+19 more)

### Community 14 - "Компакт мини — симуляция (README)"
Cohesion: 0.14
Nodes (15): Зарядка мини: латунные пластины на брюхе + станция с AprilTag и ИК-маяком, Питание мини: 2 × 18650 (2S, ~22 Вт·ч), BMS 2S, IP2326, DC-DC 6 В ≥ 6 А и 5 В 3 А, Станция-«гнездо» мини: USB-C 5 В 3 А, ИК-маяк 940 нм / 38 кГц, метка AprilTag, Скриншот: вид глазами Харви (мини), Камера Module 3 Wide — вид глазами Харви (клавиша V), Компакт мини — симуляция (README), Вид глазами Харви: неподвижная Camera Module 3 Wide, наклон корпусом ±12°, Выбор движка: MuJoCo + Filament вместо Isaac Sim, Unreal/Unity, Genesis, Gazebo (+7 more)

### Community 15 - "harvey_mini_parts.py"
Cohesion: 0.11
Nodes (17): chassis(), coxa_servo_leg(), coxa_servos(), edge_sensors(), electronics(), eye_servo_body(), eye_servos(), fixed_parts() (+9 more)

### Community 16 - "sts.py"
Cohesion: 0.21
Nodes (13): checksum(), make_packet(), parse_status(), _status(), test_echo_is_recognisable(), test_leg_ik_fk_roundtrip_and_stance(), test_packet_ping_matches_reference(), test_packet_read_position() (+5 more)

### Community 17 - "sts_bus.py"
Cohesion: 0.14
Nodes (10): run(), main(), Bus, BusError, checksum(), find_status(), le16(), make_packet() (+2 more)

### Community 18 - "Leg"
Cohesion: 0.10
Nodes (3): clamp(), Leg, test_center_all_with_empty_bus_records_nothing()

### Community 19 - "json"
Cohesion: 0.15
Nodes (8): currents(), run(), add(), body_map(), leg_map(), main(), pack(), pack()

### Community 20 - "test_head_parts.py"
Cohesion: 0.09
Nodes (18): load_vendor_init(), Mood, Reaction, test_equal_priority_replaces_and_expired_is_replaced_by_anything(), test_reaction_ends_exactly_on_time(), test_sleepy_and_asleep_exactly_at_limits(), display(), FakeDC (+10 more)

### Community 21 - "numpy"
Cohesion: 0.15
Nodes (14): build_tail(), legs_push(), rel(), T, tail_ik(), tail_move(), test_handover(), test_pick_place() (+6 more)

### Community 23 - "harvey_eye_parts.py"
Cohesion: 0.16
Nodes (12): back_cover(), bumper(), display(), eye_center(), horn_adapter(), housing(), housing_radius(), housing_x() (+4 more)

### Community 24 - "export_sim"
Cohesion: 0.15
Nodes (17): claw_assembly(), T_ay(), T_fore(), T_hand(), T_up(), elbow_servo_up(), export_sim(), export_stl() (+9 more)

### Community 25 - "result"
Cohesion: 0.07
Nodes (35): answer(), result(), test_backlash_not_measured(), test_backlash_over_one_degree_fails(), test_heat_mean_current_over_norm_fails(), test_heat_stops_after_five_seconds_of_overcurrent(), test_heat_stops_at_70_degrees(), test_repeatability_fails_when_returns_scatter() (+27 more)

### Community 26 - "Servo"
Cohesion: 0.12
Nodes (9): Servo, State, to_signed(), u16(), test_amps_from_register_or_from_load(), test_fake_bus_set_id_and_move(), test_set_middle_makes_position_2048(), test_sign_magnitude() (+1 more)

### Community 27 - "harvey_world.py"
Cohesion: 0.11
Nodes (12): apply(), asset_xml(), grab_equalities(), load_assets(), pbr_material(), props_xml(), _ramp(), robot_visual() (+4 more)

### Community 28 - "math"
Cohesion: 0.15
Nodes (10): claw_ok(), assets(), bodies(), _hex_mesh(), _hex_ring(), _hex_tip_mesh(), _mesh(), test_claw_rules() (+2 more)

### Community 29 - "pathlib"
Cohesion: 0.06
Nodes (20): _firmware_dir(), project_file(), selftest(), test_keysyms_elsewhere(), test_windows_keycodes_do_not_depend_on_layout(), _header(), _log_sheet(), _results_sheet() (+12 more)

### Community 30 - "harvey_grasp.py"
Cohesion: 0.21
Nodes (12): build(), build_cup(), finger_mid(), G, obj_forces(), path(), pen_test(), phone_test() (+4 more)

### Community 31 - "harvey_terrain.py"
Cohesion: 0.08
Nodes (23): grass_assets(), grass_geoms(), settle(), stone_assets(), _stone_list(), stones_xml(), _tuft_mesh(), Харви — управление в симуляции (README) (+15 more)

### Community 32 - "Харви 1.0 — питание и проводка"
Cohesion: 0.05
Nodes (58): Pi 5 + AI HAT+ («голова») и Pico 2 («спинной мозг»), Pi Zero 2 W + RP2350-Zero («спинной мозг»), Питание мини: 2 × 18650 (2S, ~22 Вт·ч), DC-DC 6 В 6 А, Без ПК — «сонный питомец»: ходит, не падает, эмоции, сам заряжается, Харви — комплектация и бюджет v0.2, AI HAT+ 26 TOPS (Hailo-8), Raspberry Pi Camera Module 3 Wide, IMU BMI270 / ICM-42688 (+50 more)

### Community 33 - "test_head.py"
Cohesion: 0.08
Nodes (19): backoff(), SpineLink, Port, test_spine_backoff_grows_then_resets_after_success(), opener(), Brain, Display, head() (+11 more)

### Community 34 - "disk_on_horn"
Cohesion: 0.13
Nodes (11): coxa_bracket(), disk_on_horn(), eye_stalk(), femur_link(), forearm(), hull(), plate_on_face(), rod() (+3 more)

### Community 35 - "mujoco"
Cohesion: 0.18
Nodes (16): eye_force(), trial(), edge_sensor(), feet_x(), sc_battery(), sc_edge(), sc_failure(), sc_obstacles() (+8 more)

### Community 37 - "bench.py"
Cohesion: 0.10
Nodes (18): compact_actions(), main(), mini_actions(), whole_leg(), open_bench(), parse_args(), release(), run_menu() (+10 more)

### Community 38 - "Pico 2 — даташит"
Cohesion: 0.15
Nodes (15): AI HAT+ — краткое описание, Raspberry Pi AI HAT+ (13/26 TOPS), Ускоритель Hailo-8 / Hailo-8L (NPU), Связь AI HAT+ по PCIe Gen 3, Pico 2 — даташит, Служебные GPIO23/24/25/29 (SMPS PS, VBUS sense, LED, VSYS/3), MicroPython на Pico 2, Питание Pico 2: VSYS 1,8–5,5 В, SMPS RT6150, 3V3 ≤ 300 мА (+7 more)

### Community 39 - "render_desk.py"
Cohesion: 0.07
Nodes (33): v2 «Компакт» (метка v2-kompakt, ветка kompakt), сохранена 16.10.2026, Круглые дисплеи-глаза GC9A01 1,28″, Версия корпуса «Компакт», Две мощные многосуставные клешни, Глаза на стебельках с магнитной муфтой, Клешня с пятью суставами (звенья 54 / 60 / ≈43 мм), Панцирь 150 × 140 × 70 мм и поднос на спине 87 × 105 мм, Управление мини с клавиатуры (harvey_mini_teleop.py, run_mini_windows.bat): Filament PBR, физика в отдельном процессе (+25 more)

### Community 40 - "Харви — детали стенда одной ноги (PDF)"
Cohesion: 0.20
Nodes (10): Харви — детали стенда одной ноги (PDF), Кронштейн основания (harvey_coxa_bracket.stl), Держатель привода валом вверх (harvey_cradle_servo.stl), Пластина бедра ×2 (harvey_femur_plate_x2.stl), Стопа TPU 95A (harvey_foot_TPU.stl), Обхват привода колена (harvey_knee_sleeve.stl), Рычаг 100 мм (harvey_lever_100mm.stl), Печать и крепёж: PETG 0,2 мм, 40% гироид, вставки M3, зазор 0,3 мм (+2 more)

### Community 41 - "test_bench.py"
Cohesion: 0.06
Nodes (39): heat_abort(), heat_ok(), measure_servo(), model_label(), scaled_lsb(), scan_note(), big(), make() (+31 more)

### Community 42 - "test_drivers.py"
Cohesion: 0.08
Nodes (14): BMI270, init_chunks(), s16(), imu(), FakeBMI270, FakeI2C, test_bmi270_loads_config_and_starts(), test_bmi270_missing_raises() (+6 more)

### Community 44 - "check"
Cohesion: 0.08
Nodes (15): check(), check_beacon(), check_stand(), claw_ok(), claw_points(), display(), dock_cover(), put() (+7 more)

### Community 45 - "test_logic.py"
Cohesion: 0.09
Nodes (21): baseline(), EdgeArray, is_edge(), battery_level(), blocked(), bus_of(), decide(), lifted() (+13 more)

### Community 46 - "harvey_head/main.py"
Cohesion: 0.11
Nodes (12): open_eyes(), BrainLink, pump_out(), hardware(), main(), NoSpine, run(), test_brain_connected_flag() (+4 more)

### Community 47 - "стенд привода/tests/conftest.py"
Cohesion: 0.15
Nodes (7): FakeLegBus, Режим без железа (SIM): имитация привода, bench(), bus(), calibrated(), in_tmp(), leg()

### Community 49 - "rp2350/main.py"
Cohesion: 0.08
Nodes (10): Beacon, bearing(), build(), run(), try_make(), UsbPort, PioUart, _rx() (+2 more)

### Community 50 - "test_eyes.py"
Cohesion: 0.13
Nodes (17): blend(), lerp(), _lids(), Look, render(), to_rgb565(), sheet(), pupil_x() (+9 more)

### Community 52 - "FE-URT-1 — адаптер шины (таблица, конвертирована)"
Cohesion: 0.21
Nodes (12): Приводы — шинные Feetech STS (STS3215 C018 на ногах, STS3032 на кистях), FE-URT-1 — адаптер шины (таблица, конвертирована), FE-URT-1 — USB → TTL/RS485 программатор шины Feetech, Аппаратное автоматическое переключение направления полудуплекса, Драйвер CH340C, Порты SMS (RS485, 5264-4AW) и SCS (TTL, 5264-3AW), 28 × STS3032 (ноги 6 × 3, клешни 2 × 4, глаза 2), Feetech STS3032 (6 В, 4,5 кг·см) (+4 more)

### Community 53 - "test_edges_of_rules.py"
Cohesion: 0.11
Nodes (9): config(), FakePin, FakeVL53L4CD, test_vl53l4cd_wrong_model_raises(), adafruit_range_config(), test_deadband_is_standing(), test_init_sets_continuous_mode_and_timing(), test_range_config_equals_adafruit() (+1 more)

### Community 54 - "Харви — этап 1: покупки и стенд одной ноги"
Cohesion: 0.18
Nodes (14): Первые тесты мини: 4 × STS3032, URT-1, стенд одной ноги (~25 г печати), Харви — этап 1: покупки и стенд одной ноги, Архив Harvey_leg_CAD.zip (детали стенда ноги), Замер люфта лазерной указкой (1° ≈ 17 мм на 1 м), Замер момента: рычаг 100 мм на кухонные весы, Лабораторный блок питания с ограничением тока, Назначение ID приводов: 1–3 нога, 21–22 кисть, Протокол стенда: 12 замеров (+6 more)

### Community 56 - "sys"
Cohesion: 0.15
Nodes (6): coxa_case(), coxa_metal(), leg(), s15_case_y(), s15_metal_y(), tower()

### Community 58 - "pytest"
Cohesion: 0.11
Nodes (20): arm_ik(), test_fast_and_space(), test_grip_limit_steps_and_bounds(), test_pitch_is_limited_to_12_degrees(), foot_world(), mini(), test_28_servos_all_in_the_model(), test_arm_ik_fk_roundtrip() (+12 more)

### Community 59 - "LegCal"
Cohesion: 0.30
Nodes (7): LegCal, test_broken_calibration_file_falls_back_to_defaults(), test_calibration_makes_pose_g_the_middle_and_saves(), test_calibration_survives_save_and_load(), test_missing_checked_flag_means_not_checked(), test_to_pos_uses_offset_and_direction(), test_leg_calibration_mapping()

### Community 60 - "test_exact.py"
Cohesion: 0.14
Nodes (10): TouchDetector, golden_path(), test_eye_matches_golden(), test_repeated_press_and_release_are_ignored(), test_stroke_window_is_inclusive(), test_tap_and_hold_limits_are_inclusive(), test_two_fingers_are_not_a_tap(), test_short_touch_is_tap_long_is_hold() (+2 more)

### Community 62 - "Привод Feetech STS3215-C018 (12 В, 30 кг·см)"
Cohesion: 0.27
Nodes (10): Полудуплексная асинхронная шина 8N1, Порядок сборки ноги: ID 1/2/3, середина 2048, ось бедра 55 мм над столом, Размеры привода для сверки (servo_L 45,2, W 24,7, H 32, shaft_from_end 12,5, flange_D 20), Защиты STS3032: перегрузка, напряжение 4–7,4 В, 70 °C, Привод Feetech STS3032-C036 (6 В, 4,5 кг·см), 12-битный магнитный энкодер: 4096 отсчётов, 0,088°, середина 2048, Калибровка середины: 128 в адрес 40, Режимы 0–3: серво, скорость замкн./разомкн., шаговый; многооборотный ±7 (+2 more)

### Community 63 - "Feetech — протокол связи (SCS/SMS)"
Cohesion: 0.16
Nodes (15): Цель: позиция, время, скорость (адреса 42–46), Feetech — протокол связи (SCS/SMS), Широковещательный ID 254 (0xFE), Порядок байт SMS/STS: младший байт первым, Контрольная сумма ~(ID+Len+Instr+Params) & 0xFF, Регистр цели 0x2A: позиция, время, скорость (6 байт), Регистр ID (адрес 5) и блокировка EPROM, Пакет инструкции 0xFF 0xFF ID Len Instr Params Checksum (+7 more)

### Community 64 - "INA226"
Cohesion: 0.15
Nodes (8): INA226, signed16(), ina(), FakeINA226, test_ina226_configures_and_reads_battery(), test_ina226_low_battery_alert(), test_ina226_missing_raises(), test_ina226_negative_current_while_charging()

### Community 65 - "check_dock"
Cohesion: 0.22
Nodes (5): check_dock(), dock_pad(), dock_pogo(), dock_tower(), leg_pose_for_drop()

### Community 66 - "test_leg.py"
Cohesion: 0.05
Nodes (26): abort_reason(), direction(), gait_ok(), middle_offset(), parse_grams(), stall_current(), stance_ok(), step_pose() (+18 more)

### Community 68 - "Feetech — таблица регистров (конвертирована)"
Cohesion: 0.25
Nodes (11): Feetech — таблица регистров (конвертирована), Блокировка записи EPROM (адрес 48), Защита от перегрузки (регистры 37–39: момент, время, порог 80%), Максимальный момент (адрес 16), Включение момента (адрес 40), Регистр ID (адрес 5; 254 — широковещательный), Регистр скорости шины (адрес 6; 0 = 1 Мбит/с), Обратная связь: позиция, скорость, нагрузка, напряжение, температура (56–63) (+3 more)

### Community 69 - "README папки проекта Харви"
Cohesion: 0.16
Nodes (12): CLAUDE.md — контекст проекта Харви, Ветки kompakt (v2-kompakt) и kompakt-mini, Структура папки проекта (заметки, визуализация, модели, документы, фото, код), README папки проекта Харви, Obsidian-хранилище на всю папку harvey, Окружения Python в C:\venvs (harvey, harvey-bench, harvey-cad), Онлайн-версии документов (артефакты claude.ai), Версии: kompakt «Компакт» и kompakt-mini «Компакт мини» (+4 more)

### Community 70 - "harvey_tail_parts.py"
Cohesion: 0.15
Nodes (11): arm_plate(), base(), cup(), cup_holder(), elbow_sleeve(), forearm(), j2_cols(), link_parts() (+3 more)

### Community 71 - "time"
Cohesion: 0.16
Nodes (10): const(), sleep_ms(), sleep_us(), ticks_ms(), calibration(), test_ina226_calibration_matches_datasheet_example(), test_range_config_grows_with_budget_and_checks_limits(), _encode_timeout() (+2 more)

### Community 72 - "export_robot.py"
Cohesion: 0.19
Nodes (13): Мягкий вариант: графитовый скруглённый панцирь (soft_cover), claws(), coxa_servo_split(), eyes(), frame(), leg_servo_split(), legs(), robot() (+5 more)

### Community 73 - "harvey_teleop.py"
Cohesion: 0.13
Nodes (6): edge_seen(), Управление с клавиатуры и панель управления, Адаптивная походка: корпус ровно по IMU, поиск опоры, шаг выше на неровном, run_linux.sh script, Скриншот: склоны и ступени полосы препятствий, Склоны 10°/15°/20°/25°, косой склон 15° и ступени

### Community 74 - "harvey_mini_teleop.py"
Cohesion: 0.14
Nodes (12): main(), world_model(), Скриншот: мини на столе среди предметов, Реквизит рабочего стола (ручки, карандаш, блокнот, кейс наушников, книга, лампа, ноутбук), Скриншот: приветствие правой клешнёй (мини), Жест «привет» — клешня поднята вверх, Скриншот: протирка салфеткой (мини), Протирка стола салфеткой (мини) (+4 more)

### Community 75 - "Харви «Компакт мини»"
Cohesion: 0.06
Nodes (36): Харви «Компакт мини», Бюджет мини ≈ 115–158 тыс. ₽ (почти как «Компакт»), Задачи мини: протереть стол, подать ручку, общаться, сам заряжаться, Масса мини 893 г (560 г — приводы); цель ≤ 0,8 кг не достигнута, Проверить на стенде до заказа 30 приводов: нагрев бедра, размеры, ток, дисплей, видео, CAD-проверка мини (harvey_mini_parts.py): 0 столкновений, 332 позы клешни, Симуляция мини (harvey_mini.py): ходьба 6,2 см/с, ручка, салфетка, станция, Бюджет «Компакт» 107–179 тыс. ₽ (+28 more)

### Community 76 - "leg_check.py"
Cohesion: 0.21
Nodes (5): coxa_servo(), ik(), links(), plates(), servo()

### Community 77 - "harvey_mini.py"
Cohesion: 0.17
Nodes (11): arm_fk(), build_xml(), dock_xml(), joint_names(), leg_ik(), load_assets(), neutral(), test_edge() (+3 more)

### Community 79 - "encode"
Cohesion: 0.18
Nodes (10): serve(), decode(), encode(), joints(), LineReader, test_decode_needs_object_with_type(), test_line_of_exactly_max_length_is_kept(), test_encode_decode_roundtrip() (+2 more)

### Community 80 - "VL53L4CD"
Cohesion: 0.32
Nodes (3): test_vl53l4cd_init_measure_and_new_address(), test_ready_follows_interrupt_polarity(), VL53L4CD

### Community 81 - "Audio"
Cohesion: 0.18
Nodes (10): Audio, play_cmd(), record_cmd(), Голова «Компакт мини» — Pi Zero 2 W, Как устроено, Проверить на стенде, Проверка на ПК, Установка на Pi Zero 2 W (Raspberry Pi OS Bookworm Lite) (+2 more)

### Community 82 - "Head"
Cohesion: 0.22
Nodes (4): Head, NoSpine, test_look_defaults_and_link_log(), test_telemetry_period_boundary_and_bad_battery_field()

### Community 83 - "Animator"
Cohesion: 0.26
Nodes (8): Animator, animation(), test_blink_ends_exactly_after_its_duration(), test_glance_moves_gaze_in_small_steps_and_reschedules(), test_transition_starts_from_current_look(), test_animator_moves_smoothly_and_blinks(), test_asleep_does_not_blink(), test_look_at_is_clamped()

### Community 85 - "test_keys.py"
Cohesion: 0.15
Nodes (5): test_eye_keys(), test_hex_prism_and_tip_meshes(), test_presets(), test_walk_keys_add_up_and_release(), vertices()

### Community 86 - "SerialBus"
Cohesion: 0.19
Nodes (5): BusError, le16(), SerialBus, test_scan_survives_a_servo_that_does_not_answer_model(), no_answer()

### Community 88 - "ImuEvents"
Cohesion: 0.22
Nodes (8): ImuEvents, magnitude(), tilt(), test_magnitude(), test_thresholds_are_strict(), test_freefall_needs_30_ms(), test_shock_and_tip(), test_tilt()

### Community 90 - "posed"
Cohesion: 0.20
Nodes (8): best_q(), hits(), ik(), posed(), T(), rot(), sweep(), tip_in_forearm()

### Community 91 - "клешни/export_render_parts.py"
Cohesion: 0.27
Nodes (8): pad_pair(), s15_case(), s15_metal(), s32_case(), s32_metal(), scene(), Рендер клешней на стендах (Blender), Многосуставная клешня: цепочка шинных приводов с печатными кронштейнами и вилкой-захватом

### Community 94 - "leg_assembly"
Cohesion: 0.38
Nodes (5): foot(), leg_assembly(), T_fem(), T_leg(), T_tib()

### Community 96 - "run_test"
Cohesion: 0.40
Nodes (3): run_test(), note(), pos()

### Community 97 - "Компоновка v2, вид сверху (поза «стоит, клешни поджаты»)"
Cohesion: 0.33
Nodes (6): Компоновка v2, вид сверху (поза «стоит, клешни поджаты»), Глаза-стебельки на передних углах рамы (~x 90, y ±80 мм), Зоны движения: ноги ±20° в основании, клешни поворот ±15°, хвост ±60°, Плечи клешней спереди (x≈105, y≈±30 мм), Хвост позади рамы (x≈−80 мм), Электроника в центре рамы (жёлтые блоки)

## Ambiguous Edges - Review These
- `Рычаг-качалка 25 мм (grip_lever)` → `Сервопривод Feetech STS3032-C036`  [AMBIGUOUS]
  модели/стенд кисти/детали кисти.png · relation: conceptually_related_to
- `Связь AI HAT+ по PCIe Gen 3` → `PCIe 2.0 x1 у Raspberry Pi 5`  [AMBIGUOUS]
  документы/AI HAT+ — краткое описание.pdf · relation: conceptually_related_to
- `Шинный протокол Feetech STS (TTL, обратная связь по положению, нагрузке, температуре)` → `Таблица регистров SCS15 (прошивка SCServo1.1)`  [AMBIGUOUS]
  graphify-out/converted/Feetech — таблица регистров_c742f36f.md · relation: conceptually_related_to
- `Нужна именно версия C018 (не C001 / C044 / C046), STS, а не SCS` → `Таблица регистров SCS15 (прошивка SCServo1.1)`  [AMBIGUOUS]
  graphify-out/converted/Feetech — таблица регистров_c742f36f.md · relation: conceptually_related_to

## Knowledge Gaps
- **80 isolated node(s):** `Датчики края — между клешнями, ~25 мм от центра`, `Компоновка v2 на настоящих деталях: 0 столкновений при правилах движения`, `Походка на пяти ногах (при отказе ноги)`, `Протирка стола с ограничением усилия по току привода`, `Более 40 смоделированных сценариев` (+75 more)
  These have ≤1 connection - possible missing edges or undocumented components. (Counts symbols only; 780 node(s) total have ≤1 connection when file, concept and rationale nodes are included.)
- **16 thin communities (<3 nodes) omitted from report** — run `graphify query` to explore isolated nodes.

## Suggested Questions
_Questions this graph is uniquely positioned to answer:_

- **Why does `Харви — стенд привода и ноги (README)` connect `Комплектация «Компакт мини» — что купить и что напечатать` to `bench.py`, `README папки проекта Харви`, `render_desk.py`, `Харви — главная заметка`, `стенд привода/tests/conftest.py`, `sts.py`, `Харви — этап 1: покупки и стенд одной ноги`, `pathlib`, `Feetech — протокол связи (SCS/SMS)`?**
  _High betweenness centrality (0.057) - this node is a cross-community bridge._
- **Are the 44 inferred relationships involving `boxr()` (e.g. with `stalk()` and `base()`) actually correct?**
  _`boxr()` has 44 INFERRED edges - model-reasoned connections that need verification._
- **What connects `Датчики края — между клешнями, ~25 мм от центра`, `Компоновка v2 на настоящих деталях: 0 столкновений при правилах движения`, `Походка на пяти ногах (при отказе ноги)` to the rest of the system?**
  _80 weakly-connected nodes found - possible documentation gaps or missing edges._
- **Should `Teleop` be split into smaller, more focused modules?**
  _Cohesion score 0.06363636363636363 - nodes in this community are weakly interconnected._
- **Why does `Харви — главная заметка` connect `Харви — главная заметка` to `Харви 1.0 — питание и проводка`, `README папки проекта Харви`, `Журнал решений`, `Комплектация «Компакт мини» — что купить и что напечатать`, `Харви — детали стенда одной ноги (PDF)`, `render_desk.py`, `Харви «Компакт мини»`, `Компакт мини — симуляция (README)`, `Харви — этап 1: покупки и стенд одной ноги`?**
  _High betweenness centrality (0.039) - this node is a cross-community bridge._

### Low-confidence Hints
_AMBIGUOUS edges — the extractor was unsure. Verify before acting on these._

- **What is the exact relationship between `Рычаг-качалка 25 мм (grip_lever)` and `Сервопривод Feetech STS3032-C036`?**
  _Edge tagged AMBIGUOUS (relation: conceptually_related_to) - confidence is low._
- **What is the exact relationship between `Связь AI HAT+ по PCIe Gen 3` and `PCIe 2.0 x1 у Raspberry Pi 5`?**
  _Edge tagged AMBIGUOUS (relation: conceptually_related_to) - confidence is low._
