iamharveststorm/harvey/заметки/Комплектация мини.md

---
title: Комплектация «Компакт мини»
date: 2026-10-16
tags: [харви, мини, закупка, печать]
aliases: [Запчасти мини, BOM мини]
---
# Харви «Компакт мини» — что купить и что напечатать

Полный список для сборки, отдельно — что нужно для первых тестов, и всё для 3D-печати. Цены ориентировочные, ₽ (осень 2026). Нижняя граница — заказ из Китая, верхняя — маркетплейсы. Приводы — по реальным ценам (16.10.2026), характеристики — [[STS3032-C036 — даташит Feetech (6 В).pdf|даташит STS3032-C036]]: STS3032-C036 в Feetech Official Store на AliExpress — **3 280 ₽**, на Ozon — 4 170 ₽. Конструкция — [[Компакт мини]], детали — [[модели/мини/README|модели/мини]].

## 0. Что уже есть (заказ этапа 1 «Компакта») и что докупить для тестов мини

> Отмечать покупки — в [[Чек-лист стенда мини]]: там всё для стенда по пунктам, включая инструмент. С этапа 1 «Компакта» ничего не куплено (подтверждено 17.10.2026): таблица ниже — что было запланировано, а не что есть. Заказано пока 2 привода — для ноги нужен ещё хотя бы 1. Вариант «2pcs» в Feetech Official Store — 5 989 ₽ за два (2 995 ₽/шт.), дешевле, чем по одному.

По заметке [[Этап 1 — покупки и стенд одной ноги]] и программе стенда (лабораторный блок RDD-3010S) считаю, что заказано и есть:

| Есть | Для мини |
| --- | --- |
| 2 × STS3032-**C036** | ✅ та же версия, что в CAD мини |
| FE-URT-1 | ✅ |
| Pico 2 (RP2350) | 🚚 заказана 17.10.2026: **Pico 2 H**, AliExpress, Joyful Chip Store (1005012769530076), 1 899 + 333 ₽, ожидается 27–30 окт.; кабель micro-USB с данными (Ozon, EMYX 1 м) — заказан Было: ❌ ещё не куплена — брать **Pico 2 H** (штырьки уже припаяны, сразу в макетку) + кабель micro-USB с передачей данных; в робот потом RP2350-Zero (тот же чип, меньше) |
| 74LVC1G125 + 1G126, макетка, Dupont | для стенда не нужны: вместо буферов взят адаптер Waveshare (A); макетка и Dupont заказаны |
| Лабораторный блок RDD-3010S | ✅ выставить **6,0 В** и предел 3 А (у C036 упор 1,2 А), не 12 В |
| Ваттметр, мультиметр с термопарой, весы, лазерная указка | ✅ те же замеры |
| Набор крепежа M2–M3, PETG | ✅ проверить, хватит ли M2 × 6 (на ногу со стендом — 28 шт.) |
| 3 × STS3215-C018, удлинители 5264, адаптер 12 В 10 А, винты PA2.0 | ❌ только для «Компакта» |

**Для стенда ноги мини и проверки шины от Pico заказано всё (17.10.2026), ждём 20–30 окт.:** 2 × STS3032-C036 (AliExpress, Feetech Official Store), винты M2 × 6, провода Dupont 120 шт. (Ozon), Pico 2 H и кабель micro-USB. Также заказаны макетная плата MB-102 830 и комплект разъёмов 3-pin 1,25 мм (Micro JST, без защёлки) с проводами 95 мм, 5 пар (Ozon) — подойдёт, если на приводе разъём без защёлки. Waveshare Bus Servo Adapter (A) — заказан на Ozon (артикул 3951158167, 999 ₽, с 27 окт.): вход UART (TX, RX, GND), перемычки A/B — USB или внешний UART, разъёмы приводов 5264, питание через клеммник или гнездо 5,5 × 2,1. Подключение: Pico GP0 (TX) → RX платы, GP1 (RX) → TX платы, GND — GND; питание приводов 6,0 В от лабораторного блока в клеммник.

**Докупить для этапа 1 мини (нога на стенде):**

| Позиция | Кол-во | ₽ |
| --- | --- | --- |
| STS3032-C036 (та же версия) | 2 (будет 4: 3 — нога, 1 — запас / клешня) | 6 560–8 340 |
| Кабели 3-pin 1,25 мм (15 и 20 см) и переходник 1,25 ↔ 5264 для URT-1 | — | в комплекте с приводом |
| Винты M2 × 6 — если в наборе меньше 50 | 50 | 150–300 |
| TPU для стопы (или стопа из PETG + резиновая накладка) | — | 0–700 |
| **Итого** | | **≈ 6 700–9 400** |

**Где брать.** AliExpress, Feetech Official Store, товар 1005006493400628 — вариант **«STS3032-C036»** (3 280 ₽), а не «servo with URT-1» (3 959 ₽): URT-1 уже есть. На Ozon (артикул 4889735099) тот же привод дороже — 4 168 ₽. В комплекте — кабели 1,25 мм, переходник на 5264 и винты. На стенде проверить, читается ли ток из регистров: в описании магазина обратная связь по току есть, в старом даташите — нет.

**Докупить для этапа 1б (электроника на столе):**

| Позиция | Кол-во | ₽ |
| --- | --- | --- |
| Pi Zero 2 **WH** (с гребёнкой) | 1 | 1 800–3 000 |
| microSD 32 ГБ A1 | 1 | 500–900 |
| Camera Module 3 Wide + шлейф для Zero (22 → 15 pin) | 1 + 1 | 3 650–5 300 |
| Круглый дисплей 0,71″ GC9D01 | 2 | 800–1 800 |
| INMP441 + MAX98357A + динамик 20 мм | 1 + 1 + 1 | 500–1 100 |
| **Итого** | | **≈ 7 250–12 100** |

**Докупить для проверки шины от Pico 2** (замер 12, в самом конце; для ноги на стенде не нужно):

| Позиция | Кол-во | ₽ | Как искать |
| --- | --- | --- | --- |
| Вариант без пайки: Waveshare Bus Servo Adapter (A) — полудуплекс уже на плате, вход UART от Pico | 1 | 600–1 200 | «Waveshare Bus Servo Adapter (A)»; в описании должен быть вход UART и перемычка USB / UART |
| Или по схеме Feetech: SN74LVC1G125DBVR + SN74LVC1G126DBVR (SOT-23-5), по 5 шт. | 5 + 5 | 150–400 | «SN74LVC1G125DBVR», «SN74LVC1G126DBVR» |
| Переходники SOT-23 → DIP (для схемы Feetech) | 4 | 100–250 | «переходник SOT23 DIP», «SOT23-6 to DIP» |
| Резисторы 10 кОм, конденсаторы 100 нФ | по 5–10 | 50–150 | набор резисторов / керамика 0,1 мкФ |
| Макетная плата 830 точек (MB-102) | 1 | 150–350 | «макетная плата 830» |
| Провода Dupont 20 см: папа-папа, папа-мама, мама-мама по 40 | набор | 150–350 | «провода Dupont 120 шт» |
| Кабель 3-pin 1,25 мм с одним свободным концом — **скорее всего не нужен**: переходник 1,25 ↔ 5264 из комплекта привода втыкается в 5264 адаптера шины, а в его гнездо 5264 входят штыри Dupont «папа». Если всё же нужен — сначала посмотреть разъём на приводе (с защёлкой — GH 1,25, без — Micro JST 1,25 / PicoBlade) | 2–3 | 100–400 | «Micro JST 1.25 3 pin с проводами» |
| Raspberry Pi **Pico 2 H** (RP2350, штырьки припаяны) + кабель micro-USB с данными | 1 + 1 | 800–1 400 | «Raspberry Pi Pico 2 H»; на чипе должно быть RP2350 |
| **Итого** | | **≈ 1 400–2 900** без пайки / **≈ 1 550–3 200** по схеме Feetech | |

Буферы — именно LVC: их входы выдерживают 5 В с шины, обычные 74HC при питании 3,3 В — нет.

Можно добавить сразу, чтобы проверить на настоящем столе, — по одному VL53L4CD и BMI270 (+1 000–2 700 ₽). Остальное (26 приводов, питание, станция) — после того, как нога пройдёт стенд.

## 1. Первые тесты (купить сначала — до остальных 26 приводов)

Цель: до большого заказа убедиться, что STS3032 держит ногу без перегрева, и снять реальные размеры для CAD.

| Позиция | Кол-во | ₽ | Зачем |
| --- | --- | --- | --- |
| Feetech STS3032-C036 | 4 | 13 100–16 700 | 3 — нога на стенде, 1 — запасной / первый привод клешни |
| USB-адаптер шины Feetech URT-1 | 1 | 600–1 200 | связь с ПК, назначение ID, программа `код/стенд привода` |
| Блок питания 6 В 5 А (или лабораторный, если есть) | 1 | 500–1 200 | питание приводов |
| Винты M2 × 6 и M2 × 8 | ~40 | (из набора ниже) | нога: 24 винта, стенд: 4 |
| Кабель 3-pin шаг 1,25 мм (как у STS3032), 15 см | — | в комплекте с приводом | цепочка приводов |
| Пластик PLA ~25 г + TPU ~1 г | — | (из катушки) | стенд, 1 нога |
| Кухонные весы, штангенциркуль | — | есть дома | сила стопы, размеры |
| **Итого этап 1** | | **≈ 14 200–19 100** | |

**Напечатать для этапа 1** (~25 г): `leg_stand`, `coxa_bracket`, `femur_link`, `tibia`, `foot` (TPU) — по 1 шт.

**Когда печатать — после того, как приедут приводы.** Сначала измерить два размера, которых нет на чертеже: высоту качалки над корпусом (`horn_top`, в CAD 4,8 мм) и расстояние от вала до торца (`shaft_from_end`, в CAD 5,7 мм). Если они отличаются больше чем на 0,3 мм — поправить CAD и перевыгрузить STL. Потом печать (~1,5 ч на комплект). До этого печатать нет смысла: при ошибке в 1 мм кронштейн не сядет на привод, а диск не совпадёт с качалкой.

**Что проверить на стенде** — программа делает это по шагам: `код/стенд привода/run_bench_mini_windows.bat` (описание — [[код/стенд привода/README|Стенд привода]]), шина от Pico — [[код/прошивка/pico/README|Pico 2]].
1. Штангенциркулем — размеры STS3032 с пометкой «ИЗМЕРИТЬ» в `модели/стенд кисти/harvey_hand_parts.py`. По даташиту C036 корпус 23 × 12 × 27,5 мм, с качалками 37,2, резьба 6 × M2 на обоих торцах через 9 мм — как в CAD; сверить высоту качалки и расстояние от вала до торца.
2. Нога стоит на весах в позе стойки: бедро +20°, колено −110°. Нужно держать 3–4 Н (весы покажут 300–400 г) — такая нагрузка на одну ногу у робота массой 893 г, стоящего на трёх ногах.
3. 10 минут шагать на месте с этой нагрузкой. Читать температуру и ток приводов из регистров. Если бедро греется выше ~60 °C — укорачиваем ноги или облегчаем корпус.
4. Ток в стойке и в шаге — по нему подтвердить батарею (оценка 1,5–2 ч).

**Этап 1б — электроника на столе** (можно параллельно). Купить из списка ниже: Pi Zero 2 W, microSD, камеру со шлейфом, 2 дисплея, микрофоны, усилитель, динамик — ≈ 7 000–12 000 ₽.
Проверить:
- видео 720p по Wi-Fi 2,4 ГГц на ПК и задержку;
- одновременную работу двух дисплеев глаз;
- голос туда и обратно.

## 2. Полный список для сборки

### Приводы и шина
| Позиция | Кол-во | ₽ | Куда |
| --- | --- | --- | --- |
| Feetech STS3032-C036 | 30 (28 + 2 запасных) | 98 400–125 100 | 18 — ноги, 8 — клешни, 2 — глаза; 4 уже есть после этапа 1, докупить 26 (≈ 85 300 ₽ на AliExpress) |
| USB-адаптер URT-1 | 1 | 600–1 200 | настройка с ПК |
| Кабели 3-pin шаг 1,25 мм (разъём STS3032): 30 см (короткие — в комплекте с приводами) | 4 | 100–300 | цепочки: левые ноги (9), правые ноги (9), клешни и глаза (10) |
| Интерфейс шины по схеме Feetech ([[схемы/README|схема bus_buffer]]): SN74LVC1G125 + 1G126, PNP-транзистор BC857 / MMBT3906, резисторы 10 кОм × 2 и 20 кОм, конденсаторы 100 нФ × 2 — на каждую шину; макетка | 3 комплекта | 400–800 | 3 шины от RP2350 |

### Мозг
| Позиция | Кол-во | ₽ |
| --- | --- | --- |
| Raspberry Pi Zero 2 W (лучше WH — с распаянной гребёнкой) | 1 | 1 800–3 000 |
| microSD 32 ГБ, класс A1 | 1 | 500–900 |
| Waveshare RP2350-Zero | 1 | 400–800 |
| Макетная плата-переходник над гребёнкой Pi Zero (pHAT) | 1 | 150–400 |

### Сенсоры, звук, глаза
| Позиция | Кол-во | ₽ | Зачем |
| --- | --- | --- | --- |
| Raspberry Pi Camera Module 3 Wide | 1 | 3 500–5 000 | в передней стенке |
| Шлейф камеры для Zero (22 → 15 pin), 5–10 см | 1 | 150–300 | у Zero узкий разъём |
| Круглый дисплей 0,71″ GC9D01, 160 × 160, SPI | 2 | 800–1 800 | глаза (модуль сверить с моделью: Ø24 × 4,5 мм) |
| VL53L4CD — малые платы ~13 × 18 мм | 6 | 3 000–7 200 | датчики края: 2 вперёд, 2 назад, по 1 в стороны |
| IMU BMI270 или ICM-42688-P | 1 | 500–1 500 | наклон, падение, «подняли» |
| INA226 (шунт 10 мОм) | 1 | 200–500 | заряд, ток, начало зарядки |
| Микрофон I2S INMP441 | 2 | 300–600 | голос, направление на говорящего |
| Усилитель I2S MAX98357A | 1 | 200–400 | |
| Динамик 20 мм, 8 Ом, 1 Вт | 1 | 150–400 | под решёткой крышки |
| Сенсорная кнопка TTP223 | 4 | 100–300 | «погладить»; подключены к Pi Zero (на RP2350 нет свободных выводов) |
| ИК-приёмник TSOP38238 | 3 | 150–450 | найти станцию без ПК и в темноте: слева и справа — куда повернуть, по центру (GP28) — по какую сторону оси |
| Резисторы: подтяжка I2C 2,2 кОм × 2, 100 кОм (SD усилителя) | 3 | — (из набора) | по [[схемы/README|схемам]] |

### Питание
| Позиция | Кол-во | ₽ | Зачем |
| --- | --- | --- | --- |
| 18650 высокотоковые (уровня Molicel P28A / Samsung 30Q) | 2 | 1 200–2 400 | 2S, ~22 Вт·ч |
| Плата защиты BMS 2S 10–15 А с балансировкой | 1 | 200–500 | |
| Конденсаторы низкоимпедансные: 1000 мкФ 10 В × 2 (плата шин и плата питания), 470 мкФ 6,3 В (вход Pi) | 3 | 100–300 | рывки приводов не перезагружают Pi |
| Модуль заряда IP2326 (вход 5 В → 2S, 15 Вт) | 1 | 150–400 | заряд от станции 5 В |
| Понижающий DC-DC 6 В, ≥ 6 А длительно, ~17 × 23 мм | 1 | 400–1 000 | все приводы; пик при рывке 8–10 А — модель подобрать по пиковому току |
| Понижающий DC-DC 5 В 3 А (Mini560 или аналог) | 1 | 150–400 | Pi Zero, дисплеи, датчики |
| Выключатель **≥ 10 А** (несёт весь ток робота), предохранитель 10 А, разъём XT30, провода силикон 18, **22** (отводы к конечностям, пик 3,6–4,8 А) и 26 AWG, тонкий силиконовый **30 AWG** (глаза через стебельки, датчики); разъём JST 1,25 мм на 6 контактов для съёмной крышки (кнопки) | 1 | 600–1 200 | проводка — [[схемы/README|схемы мини]] |

### Механика и крепёж
| Позиция | Кол-во | ₽ | Куда |
| --- | --- | --- | --- |
| Винты M2 × 6 | ~220 | | диски на качалки (4 на сустав) и пластины на торцы приводов (4 на привод) |
| Винты M2 × 8 | ~20 | | крышка, губки |
| Винты M2 × 4–5, гайки M2 | ~30 + 50 | | датчики края, камера, пластины брюха |
| Латунные вставки M2 × 3 (Ø3,2) | 8 | | 4 стойки крышки |
| **Весь крепёж M2 — набор ~300–400 шт.** | | 500–1 000 | |
| Винты M2,5 × 5 + стойки M2,5 × 5 | 4 + 4 | 100–200 | Pi Zero |
| Латунный лист 0,5 мм (2 пластины 40 × 12 мм) | 1 | 100–300 | контакты зарядки на брюхе |
| Pogo-контакты Ø5, ход 1,5 мм, **3–5 А** (заряд идёт до 3 А при 5 В — см. [[схемы/README|схемы]]) | 2 (+2) | 200–500 | станция |
| PLA ~250 г (с запасом), TPU 95A ~30 г | — | 400–800 | печать |

### Станция-«гнездо»
| Позиция | Кол-во | ₽ |
| --- | --- | --- |
| Блок питания USB-C 5 В 3 А + плата-разъём USB-C **с резисторами 5,1 кОм на CC** (без них адаптер не даст 5 В) | 1 | 500–1 000 |
| Маяк: Waveshare RP2350-Zero (пачки 38 кГц, прошивка `код/прошивка/станция`), 2 ИК-светодиода TSAL6200 (левый и правый — по разные стороны перегородки), 2 ключа AO3400A, резисторы 33 Ом × 2 · 100 Ом × 2 · 100 кОм × 2, конденсатор 10 мкФ, макетка 3 × 4 см — [[схемы/README|схема beacon]] | 1 | 500–950 |
| Самовосстанавливающийся предохранитель PTC 3 А — контакты станции открыты (монета, скрепка) | 1 | 30–80 |
| Метка AprilTag 30 × 30 мм (распечатать, наклеить в окно башенки) | 1 | — |

### Итого
| Раздел | ₽ |
| --- | --- |
| Приводы и шина | 99 500–127 400 |
| Мозг | 2 850–5 100 |
| Сенсоры, звук, глаза | 9 050–18 950 |
| Питание | 2 800–6 200 |
| Механика, крепёж, пластик | 1 300–2 800 |
| Станция | 950–1 950 |
| **Всего** | **≈ 116 900–162 700** |

**Изменения по схемам проводки (25.10.2026)** — [[схемы/README|Схемы мини]]: pogo на 3–5 А вместо 2 А, выключатель ≥ 10 А, провода 22 и 30 AWG, разъём крышки JST 1,25 мм на 6 контактов, транзисторы и резисторы интерфейса шин, конденсаторы 1000 и 470 мкФ, переходник над гребёнкой Pi Zero. Итог вырос примерно на 0,5–1 тыс. ₽.

Больше 4/5 суммы — приводы. Из этапа 1 в общий список уже входят 4 привода, URT-1 и крепёж: после этапа 1 осталось докупить на ≈ 100–145 тыс. ₽.

**Как удешевить приводы.** Перед большим заказом (26 шт.) написать в Feetech Official Store про оптовую цену. Ещё — ждать распродаж AliExpress (11.11, «чёрная пятница», весенняя). Каждые −10 % на приводах — это −8,5 тыс. ₽.

### Сколько крепежа куда

| Узел | Винтов M2 | Как считали |
| --- | --- | --- |
| Нога | 24 | 4 — привод поворота в дно гнезда, затем 5 сочленений по 4: диск на качалку поворота, пластина привода бедра, диск бедра, пластина привода колена, диск голени |
| 6 ног | 144 | |
| Клешня | 34 | 4 — привод плеча, 7 сочленений × 4, 2 — неподвижная губка |
| 2 клешни | 68 | |
| Глаза | 12 | |
| Корпус и прочее | ~24 | крышка, датчики, камера, пластины брюха |
| **Всего** | **~250** | |

## 3. 3D-печать

STL — в `модели/мини/stl/`: в имени файла — сколько штук и из какого материала. Масса — при 3 периметрах и заполнении 25 %.

| Деталь | Шт. | Материал | Масса на всё, г | Габарит, мм | Как класть на стол |
| --- | --- | --- | --- | --- | --- |
| `chassis` — ванна корпуса | 1 | PLA / PETG | 34,5 | 114 × 88 × 35 | дном вниз, поддержки — под окно камеры |
| `lid` — крышка | 1 | PLA / PETG | 21,5 | 114 × 88 × 5 | верхом вниз |
| `coxa_bracket` — кронштейн основания | 6 | PETG | 17,5 | 43 × 25 × 37 | полкой вниз, поддержки под стенку |
| `femur_link` — бедро | 6 | PETG | 16,7 | 46 × 9 × 22 | плашмя, диском вниз |
| `tibia` — голень | 6 | PETG | 7,8 | 50 × 26 × 16 | диском вниз, поддержки под излом |
| `foot` — стопа | 6 | TPU 95A, 100 % | 3,7 | Ø10 × 12 | сферой вверх |
| `yaw_bracket` — кронштейн плеча | 2 | PETG | 3,4 | 27 × 25 × 27 | полкой вниз |
| `upper_arm` — плечо клешни | 2 | PETG | 6,0 | 56 × 9 × 22 | плашмя |
| `forearm` — предплечье | 2 | PETG | 3,5 | 52 × 30 × 48 | диском вниз, поддержки |
| `fixed_jaw`, `fixed_jaw_R` | 1 + 1 | PETG | 1,5 | 36 × 18 × 13 | плашмя |
| `moving_jaw`, `moving_jaw_R` | 1 + 1 | PETG | 1,6 | 34 × 15 × 8 | диском вниз |
| `eye_stalk`, `eye_stalk_R` | 1 + 1 | PETG | 2,4 | 6 × 27 × 59 | на боку, поддержки под кольцо |
| `dock_pad` — площадка станции | 1 | PLA | 7 | 64 × 56 × 4 | низом вниз |
| `dock_tower` — башенка станции с отсеком электроники и перегородкой маяка | 1 | PLA | 25 | 136 × 64 × 67 | основанием вниз, отсек открыт назад; перегородка печатается стоя вместе с башенкой |
| `dock_cover` — крышка отсека (окно USB-C, 2 × M2) | 1 | PLA | 2 | 48 × 47 × 1,6 | плашмя |
| `calib_jig` — калибровочная подставка (поза A для нулей приводов) | 1 | PLA | 80 | 195 × 216 × 34 | плитой на стол; нужна один раз после сборки |
| `leg_stand` — стенд ноги (этап 1) | 1 | PLA | 13 | 70 × 70 × 52 | основанием вниз, поддержки под гнездо |
| **Всего** | 43 | | **≈ 247 г** | | робот 120 г, станция и стенд 47 г, подставка 80 г |

Масса — сразу на все штуки детали. В массу робота (893 г) входят только детали на самом роботе: 120 г.

**Настройки.** Сопло 0,4, слой 0,16–0,2 мм, 3 периметра, 25 % гироид.
- Детали ног и клешней лучше печатать из PETG: прочнее на изгиб, винты M2 держит лучше PLA. Ванну и крышку можно из PLA.
- Отверстия под M2 в модели — Ø2,3 мм. Винты вкручиваются в резьбу приводов и качалок, не в пластик.
- Перед печатью всех 6 комплектов ноги напечатать 1 комплект на стенд (этап 1) и проверить посадку на настоящих STS3032.

**Время печати (оценка):** один комплект ноги — ~1,5 ч, 6 ног — ~9 ч; клешни — ~2 ч; ванна и крышка — ~4 ч; станция и стенд — ~2 ч. Итого ~17 ч.

Related: [[Компакт мини]] · [[Харви]] · [[Журнал решений]] · [[модели/мини/README|Детали мини]]
