iamharveststorm/harvey/документы/Документы.md

# Документы

Даташиты, описания плат и PDF для печати. Сюда же — новые схемы и статьи.

## Приводы и шина

- [[STS3215-C018 — даташит Feetech (12 В).pdf]] — приводы ног, подъёма и локтя клешней и хвоста
- [[STS3032-C036 — даташит Feetech (6 В).pdf]] — запястья, захваты, повороты плеч, глаза, камера, хвост
- [[Feetech — протокол связи.pdf]] — протокол шины
- [[Feetech — таблица регистров.xlsx]] — регистры приводов
- [[FE-URT-1 — адаптер шины.xlsx]] — адаптер шины к компьютеру

## Электроника

- [[Raspberry Pi 5 — краткое описание.pdf]]
- [[AI HAT+ — краткое описание.pdf]]
- [[Pico 2 — даташит.pdf]] · [[Pico 2 — краткое описание.pdf]]

## «Компакт мини»: датчики, глаза, станция (скачаны 02.11.2026)

- [[VL53L4CD — даташит ST.pdf]] — датчики края (DS13812): адрес 0x52 (7 бит — 0x29), XSHUT, загрузка ≤ 1,2 мс, 2,6–3,5 В, I2C до 1 МГц. Регистров в даташите нет — ST даёт драйвер ULD; порт в прошивке — по драйверу Adafruit (MIT), перенесённому с ULD
- [[BMI270 — даташит Bosch.pdf]] — IMU (BST-BMI270-DS000-08): CHIP_ID 0x24, адрес 0x68 (SDO на GND), запуск с файлом конфигурации 8 КБ (стр. 18–19), диапазоны ACC_RANGE / GYR_RANGE
- [[INA226 — даташит TI.pdf]] — ток и напряжение батареи (SBOS547C): регистры 00h–07h, FEh = 5449h, шина 1,25 мВ, шунт 2,5 мкВ, CAL = 0,00512 / (Current_LSB × R)
- [[TSOP382 — даташит Vishay.pdf]] — ИК-приёмник маяка: 2,0–5,5 В, пачки ≥ 10 периодов, пауза ≥ 12, ≤ 1700 пачек/с; непрерывную несущую подавляет
- [[NE556 — даташит TI.pdf]] — сдвоенный таймер маяка станции: tH = 0,693 (RA + RB) C, tL = 0,693 RB C (ф. 1–2)
- [[TSAL6200 — даташит Vishay.pdf]] — ИК-светодиод 940 нм маяка: IF 100 мА, VF 1,35 В, ±17°
- [[GC9D01N — даташит Galaxycore.pdf]] — контроллер круглых дисплеев глаз 160 × 160: команды 2Ah/2Bh/2Ch/36h/3Ah, 5 мс после 11h, такт записи SPI ≥ 10 нс
- [[GC9D01 — код запуска Waveshare 0.71.txt]] — последовательность запуска панели 0,71″ от производителя модуля (из демо Waveshare)

## Печать

- [[harvey-stage1-parts.pdf]] — детали этапа 1, настройки печати, порядок сборки

Related: [[Харви]] · [[Комплектация и бюджет v0.2]] · [[Питание и проводка]] · [[Комплектация мини]] · [[Чек-лист стенда мини]] · [[код/стенд привода/README|Стенд привода]] · [[Журнал решений]]
