iamharveststorm/harvey/заметки/Комплектация и бюджет v0.2.md

# Харви — комплектация и бюджет v0.2

Oct 9, 2026 · @HarvestStorm

## Итог

Харви в версии «Компакт» обойдётся примерно в **107–179 тыс. ₽** без 3D-принтера и инструментов. Больше половины суммы — сервоприводы.

| Раздел | От, ₽ | До, ₽ |
| --- | --- | --- |
| Приводы | 61 000 | 101 500 |
| Вычисления на борту | 22 800 | 34 300 |
| Сенсоры, звук, дисплеи | 13 900 | 25 700 |
| Питание | 3 700 | 7 500 |
| Корпус и крепёж | 3 600 | 6 900 |
| Станция-гнездо | 1 500 | 3 300 |
| **Итого** | **106 500** | **179 200** |

Нижняя граница — заказ напрямую из Китая (AliExpress, магазины Seeed и Feetech), верхняя — российские маркетплейсы с наценкой и быстрой доставкой. Пересчёт по курсу около 78 ₽ за доллар (ЦБ, лето 2026). Цены ориентировочные: память для одноплатников в 2026 году сильно подорожала, Raspberry Pi повышал цены несколько раз.

## Приводы

Все приводы — шинные Feetech с обратной связью по положению, нагрузке и температуре, на одном протоколе STS.

| Позиция | Кол-во | Цена за шт., ₽ | Сумма, ₽ | Куда |
| --- | --- | --- | --- | --- |
| [Feetech STS3215-C018](https://robotshop.com/products/feetech-12v-30kgcm-magnetic-encoding-servo-sts3215): 12 В, 30 кг·см пик, 10 кг·см номинал, 55 г | 24 | 1 900–2 800 | 45 600–67 200 | 18 в ногах, плечо и локоть обеих клешней и хвоста |
| STS3215-C018, запас | 2 | 1 900–2 800 | 3 800–5 600 | замена при поломке |
| [Feetech STS3032](https://aifitlab.com/collections/servo-motor/products/feetech-sts3032-servo-motor): 6 В, 4,5 кг·см, 20 г | 11 | 1 000–2 500 | 11 000–27 500 | поворот плеча, запястье и захват обеих клешней, стебельки глаз, наклон камеры, поворот и запястье хвоста |
| USB-адаптер шины Feetech (URT-1 или аналог) | 1 | 600–1 200 | 600–1 200 | калибровка и назначение ID с ноутбука |

STS3215 работает [от 4 до 14 В](https://eckstein-shop.de/Motors?mf=1602), поэтому питается прямо от аккумулятора 3S (до 12,6 В) без стабилизатора. Номинальный момент 10 кг·см с запасом перекрывает расчётную нагрузку бедра в версии «Компакт» с грузом 0,5 кг на спине (≈ 6,8 кг·см). За рубежом STS3215-C018 стоит [около 22–26 $](https://aifitlab.com/collections/servo-motor/products/feetech-sts3215-servo-motor).

## Вычисления на борту

Raspberry Pi 5 с ускорителем AI HAT+ — «голова» Харви, Pico 2 — «спинной мозг» для приводов и датчиков края.

| Позиция | Кол-во | Цена, ₽ | Зачем |
| --- | --- | --- | --- |
| Raspberry Pi 5, 8 ГБ ([125 $ после повышения цен](https://trashbox.ru/link/2026-02-02-raspberry-pi-snova-podnimaet-ceny)) | 1 | 11 000–16 000 | Wi-Fi, камера, звук, глаза, слово «Харви» |
| [AI HAT+ 26 TOPS](https://tomshardware.com/raspberry-pi/raspberry-pi-release-higher-performance-ai-hat-13-and-26-tops-variants) (Hailo-8, 110–132 $) | 1 | 10 000–15 000 | YOLO на борту для наведения клешней |
| Active Cooler для Pi 5 | 1 | 500–900 | охлаждение под нагрузкой |
| microSD 64 ГБ, класс A2 | 1 | 800–1 500 | система и калибровка |
| Raspberry Pi Pico 2 | 1 | 500–900 | походка, датчики края, аварийная остановка |

AI HAT+ занимает разъём PCIe, поэтому NVMe-диск вместе с ним не поставить — система живёт на microSD. Сэкономить на старте 10–15 тыс. ₽ можно, отложив AI HAT+: пока зрение считается на ноутбуке, он не нужен.

## Сенсоры, звук и дисплеи

Вместо старой платы ReSpeaker 4-Mic для Pi берём USB-массив на XMOS XVF3800: старая плата [снята с производства](https://www.switch-science.com/products/3885) и не имеет выхода звука, а у Pi 5 нет аналогового аудиовыхода.

| Позиция | Кол-во | Цена за шт., ₽ | Сумма, ₽ | Зачем |
| --- | --- | --- | --- | --- |
| Raspberry Pi Camera Module 3 Wide + кабель для Pi 5 | 1 | 3 500–5 000 | 3 500–5 000 | стол, предметы, лицо |
| [reSpeaker XVF3800, 4 микрофона, USB](https://thepihut.com/products/respeaker-xmos-xvf3800-ai-powered-4-mic-array-for-clear-voice-even-in-noise) | 1 | 5 000–8 000 | 5 000–8 000 | версия без XIAO ESP32S3 (заводская USB-прошивка); направление на говорящего, подавление эха — только если звук идёт через него |
| Динамик 2–3 Вт, подключается к выходу reSpeaker | 1 | 500–1 000 | 500–1 000 | голос и звуки |
| Круглый дисплей GC9A01 1,28″ | 2 | 400–800 | 800–1 600 | глаза |
| IMU BMI270 или ICM-42688 | 1 | 500–1 500 | 500–1 500 | наклон, падение, «меня подняли» |
| ToF-датчик VL53L4CD (модуль) | 6 | 500–1 200 | 3 000–7 200 | край стола: 2 вперёд (между клешнями), 2 назад, по 1 в стороны; дальность до ~1,3 м — луч 2,3 : 1 (~112 мм) в середине диапазона, а не на пределе, как у VL6180X (100 мм); у всех адрес 0x29 — каждому линия XSHUT на Pico (GP14–GP19) |
| Датчик тока INA226 | 1 | 200–500 | 200–500 | заряд батареи, начало зарядки |
| Сенсорная кнопка TTP223 | 4 | 25–75 | 100–300 | «погладить» Харви |
| 3 буфера полудуплексной шины (три шины приводов), макетка, разъёмы | 1 | 300–600 | 300–600 | связь Pico с приводами |

XVF3800 подавляет эхо от собственного динамика, поэтому Харви слышит тебя, даже когда говорит или шумит приводами.

## Питание

Сборка 3S из трёх высокотоковых банок 21700 даёт около 50 Вт·ч, это 1,5–2 часа работы.

| Позиция | Кол-во | Цена за шт., ₽ | Сумма, ₽ | Зачем |
| --- | --- | --- | --- | --- |
| Аккумулятор 21700 высокотоковый (уровня Molicel P45B или Samsung 40T) | 3 | 600–1 200 | 1 800–3 600 | основная батарея |
| Плата защиты BMS 3S с балансировкой, 40 А | 1 | 300–700 | 300–700 | защита от перезаряда, разряда и КЗ |
| DC-DC 5 В 5 А | 1 | 500–1 000 | 500–1 000 | питание Pi 5 |
| DC-DC 6 В 8 А | 1 | 300–700 | 300–700 | питание STS3032 |
| Провода 14–20 AWG, разъёмы XT30, предохранитель 20 А, выключатель | 1 | 800–1 500 | 800–1 500 | силовая разводка |

STS3215 питаются от батареи напрямую, через распределительную плату с предохранителями и силовой ключ аварийной отсечки — полная схема, сечения проводов и ещё \~2,5–5 тыс. ₽ на плату, ключ, «идеальный диод» зарядного входа и конденсаторы в документе «Харви 1.0 — питание и проводка». Пиковый ток при одновременном рывке многих приводов достигает 10–20 А, поэтому нужны высокотоковые банки, толстые силовые провода и предохранитель.

## Корпус и крепёж

Корпус версии «Компакт» 150 × 140 × 70 мм печатается на 3D-принтере, размеры — на эскизном чертеже.

| Позиция | Кол-во | Цена, ₽ | Зачем |
| --- | --- | --- | --- |
| Пластик PETG | 2 кг | 1 500–3 000 | каркас, ноги, панцирь, гнездо |
| Пластик TPU | 0,5 кг | 1 000–1 800 | подушечки ног, кончики клешней |
| Винты M2–M3 и резьбовые вставки | набор | 800–1 500 | разборный корпус |
| Неодимовые магниты 6 × 3 мм | \~20 шт. | 300–600 | панцирь, фиксация в гнезде |

Хвост — третья рука с присоской: 2 × STS3215 и 2 × STS3032 учтены в приводах, плюс мини-насос 6 В, клапан сброса, присоска Ø20–25 мм с сильфоном и трубка — ещё 800–1 500 ₽; пальцами плоский телефон со стола поднять не получается, а хвост кладёт его на спину и помогает Харви перевернуться. Защита глаз — ещё 300–700 ₽: 2 линзы из поликарбоната Ø41,5 × 1,5 мм, бамперы из TPU (печать) и 8 магнитов 6 × 3 мм на муфты стебельков (по 2 + 2 на глаз). Суммы рассчитаны на свой 3D-принтер. Печать на заказ обойдётся ориентировочно ещё в 8–15 тыс. ₽, и каждая доработка детали будет стоить заново.

## Станция-гнездо

Контактная зарядка: Харви ложится брюхом на подпружиненные площадки, полный заряд занимает около 1,5 часа.

| Позиция | Кол-во | Цена, ₽ | Зачем |
| --- | --- | --- | --- |
| Зарядное устройство 12,6 В 3 А (режим CC/CV) | 1 | 700–1 500 | заряд сборки 3S |
| Подпружиненные контакты, медные площадки, магниты | набор | 500–1 000 | контакт и самоцентровка |
| Схема включения: MOSFET и маленький микроконтроллер | 1 | 300–800 | напряжение только когда Харви на месте |

Чаша гнезда печатается из PETG корпуса, метка ArUco для поиска печатается на обычном принтере.

## Инструменты и порядок закупки

Покупать лучше по этапам: сначала проверить одну ногу и только потом заказывать все 24 STS3215.

Если инструментов нет, ориентировочно понадобятся:

| Инструмент | Цена, ₽ |
| --- | --- |
| Паяльная станция | 3 000–6 000 |
| Мультиметр | 1 000–3 000 |
| Лабораторный блок питания 0–30 В 5 А | 3 000–6 000 |
| 3D-принтер начального уровня | 25 000–45 000 |

Порядок закупки:

1. Одна нога: 3 × STS3215, USB-адаптер шины, лабораторный блок питания — около 7–10 тыс. ₽. Проверка нагрева и тока под грузом.
2. «Голова» без ускорителя: Pi 5, Pico 2, камера, микрофоны, дисплеи, датчики. Харви уже говорит и видит, зрение считает ноутбук.
3. Остальные приводы, питание и корпус: сборка и обучение походки.
4. AI HAT+ и станция-гнездо: наведение клешней на борту и самостоятельная зарядка.

## Источники

- [[STS3215-C018 — даташит Feetech (12 В).pdf|STS3215-C018: заводской даташит Feetech]] (в папке `документы/`)
- [STS3215-C018: характеристики](https://robotshop.com/products/feetech-12v-30kgcm-magnetic-encoding-servo-sts3215) и [рабочее напряжение 4–14 В](https://eckstein-shop.de/Motors?mf=1602)
- [STS3215: цена](https://aifitlab.com/collections/servo-motor/products/feetech-sts3215-servo-motor)
- [STS3032: характеристики и цена](https://aifitlab.com/collections/servo-motor/products/feetech-sts3032-servo-motor)
- [Raspberry Pi: повышение цен 2026](https://trashbox.ru/link/2026-02-02-raspberry-pi-snova-podnimaet-ceny)
- [AI HAT+: варианты и цены](https://tomshardware.com/raspberry-pi/raspberry-pi-release-higher-performance-ai-hat-13-and-26-tops-variants), [SparkFun](https://www.sparkfun.com/raspberry-pi-ai-hat-26-tops.html)
- [ReSpeaker 4-Mic: снят с производства](https://www.switch-science.com/products/3885)
- [reSpeaker XVF3800](https://thepihut.com/products/respeaker-xmos-xvf3800-ai-powered-4-mic-array-for-clear-voice-even-in-noise)

Цены остальных позиций и инструментов — ориентировочные, по типичным ценам маркетплейсов.

## Связанные заметки

[[Харви]] · [[Концепция]] · [[Питание и проводка]] · [[Этап 1 — покупки и стенд одной ноги]] · [[Журнал решений]]
