iamharveststorm/harvey/код/прошивка/Прошивка.md

# Прошивка

Код для Pico 2 (MicroPython) и бортового компьютера.

- [[код/прошивка/pico/README|pico]] — шина приводов Feetech на Pico 2 и замер 12 стенда: три привода, 10 минут, обмен ≤ 1 мс, без ошибок. Проверено на имитации (`pc_check.py`).

Прошивка обязана соблюдать правила движения из [[модели/корпус/README|компоновки v2]] — при них конечности не задевают друг друга и раму.

Related: [[Харви]] · [[Питание и проводка]] · [[код/стенд привода/README|Стенд привода]]
