iamharveststorm/harvey/код/симуляция/Симуляция.md

# Симуляция

MuJoCo-модель Харви (компоновка v2: плечи клешней впереди передних ног, кисть с отогнутыми пальцами, глаза на углах, хвост с реальными пределами), сценарии проверок и управление с клавиатуры.

- [[код/симуляция/управление с клавиатуры/README|Симуляция и управление с клавиатуры]] — запуск `run_windows.bat`, все проверки
- Режим «фото» (Filament, PBR) — `run_photo_windows.bat`; физика веществ (песок со следами, камни, трава) — `harvey_terrain.py`; адаптивная походка — `harvey_gait.py`

- [[код/симуляция/мини/README|Компакт мини]] — модель маленькой версии из CAD: ходьба, ручка, салфетка, край стола, станция зарядки

Итоги проверок — [[Проверка совместимости и сценарии]].

Related: [[Харви]] · [[Журнал решений]]
