iamharveststorm/harvey/модели/мини/README.md

# Харви «Компакт мини» — детали для печати и компоновка

Маленький настольный Харви: протереть стол салфеткой, взять и подать ручку или карандаш. Все 28 приводов — STS3032.
Всё в одном параметрическом скрипте `harvey_mini_parts.py`: детали для печати, приводы и электроника габаритами, сборка в любой позе, проверка столкновений, масса, станция зарядки. Обзор версии — [[Компакт мини]].

![[мини_компоновка.png]]

## Размеры

| | Компакт мини | Компакт |
| --- | --- | --- |
| Корпус | 114 × 88 × 39 мм | 150 × 140 × 70 мм |
| Размах стоп в стойке | 198 мм | ~300 мм |
| Длина с поджатыми клешнями | ~220 мм | ~300 мм |
| Высота до верха глаз | ~119 мм | ~170 мм |
| Масса | **893 г** (печать 120 г, приводы 560 г, батарея 94 г) | ~2,85 кг |
| Приводы | 28 × STS3032 | 24 × STS3215 + 11 × STS3032 |

## Состав

| Деталь | Шт. | Масса всех, г | Что это |
| --- | --- | --- | --- |
| `chassis` | 1 | 34 | ванна корпуса: гнёзда 6 приводов ног и 2 приводов плеч, окно камеры, пазы под контакты зарядки |
| `lid` | 1 | 22 | крышка на 4 винтах M2: верх приводов плеч проходит сквозь неё, решётка динамика, площадки приводов глаз |
| `coxa_bracket` | 6 | 17,5 | кронштейн основания ноги: диск на качалке привода поворота (под корпусом) + стенка на опорном торце привода бедра |
| `femur_link` | 6 | 16,7 | бедро 30 мм: диск на качалке бедра, пластина на опорном торце привода колена |
| `tibia` | 6 | 7,8 | голень 48 мм с изломом к плоскости ноги |
| `foot` (TPU) | 6 | 3,7 | колпачок-стопа Ø10 |
| `yaw_bracket` | 2 | 3,4 | кронштейн плеча: диск на приводе поворота + стенка привода подъёма |
| `upper_arm` | 2 | 6,0 | плечо клешни 40 мм |
| `forearm` | 2 | 3,5 | предплечье 30 мм, держит привод захвата сверху |
| `fixed_jaw`, `moving_jaw` | 2 + 2 | 1,5 + 1,6 | губки (смыкаются вбок), правые — `_R` |
| `eye_stalk` | 2 | 2,4 | стебелёк 26 мм с рамкой круглого дисплея ~0,71″ |
| `leg_stand` | 1 | 12,7 | стенд одной ноги для первых тестов (гнездо как в корпусе, основание позади) |
| `dock_pad`, `dock_tower` | 1 + 1 | 7 + 16,6 | станция: площадка 64 × 56 × 4 мм с 2 подпружиненными контактами, башенка с меткой AprilTag и ИК-маяком |

STL — в `stl/` (в имени — сколько штук и материал). PLA: 3 периметра, заполнение 25 % (так посчитана масса). Стопы — TPU 95A, 100 %.

## Как собрано

- **Нога.** Привод поворота стоит в гнезде корпуса валом вниз. Кронштейн висит на его качалке под корпусом и держит привод бедра с опорного торца. Привод колена закреплён на бедре опорным торцом, голень — на его рабочей качалке. Оси суставов — как в симуляции.
- **Клешня.** Привод поворота плеча стоит в корпусе валом вверх и смотрит корпусом к средней линии, чтобы не задевать переднюю ногу. Плечо и предплечье устроены как у ноги. Привод захвата сидит на конце предплечья валом вниз. Неподвижная губка — на его корпусе, подвижная — на качалке.
- **Глаз.** Привод крена лежит на крышке валом вперёд, стебелёк — на качалке.
- **Корпус.**
  - Электроника лежит в три этажа: внизу 2 банки 18650 вдоль оси, над ними Pi Zero 2 W, сверху RP2350-Zero.
  - Спереди — DC-DC 6 В и 5 В, камера Module 3 в передней стенке между плечами.
  - Сзади — плата заряда и защиты 2S, микрофоны, IMU с INA226 и динамик под решёткой крышки.
  - 6 датчиков края VL53L4CD — снаружи стенок у дна.

## Правила движения (проверены, их соблюдают симуляция и прошивка)

1. **Клешни.**
   - Подъём −20…+90°, локоть −140…+60°.
   - Поворот внутрь до −10° (другая клешня), наружу до 70°. Пока клешня ниже крышки — наружу не больше 8°: там передняя нога.
   - Поднятая выше 60° — только прямо или наружу.
2. Клешня поднята выше 60° — свой глаз отклонён наружу на 45°.
3. **Ноги.** Поворот ±20°, соседние ноги навстречу — не больше 20° суммарно; бедро −45…+85°, колено −130…−60°.
4. Ниже крышки локоть, запястье и губки клешни не заходят за переднюю кромку корпуса (x ≤ 67 мм): там камера, ноги и датчики.
5. Поза «поджато» — (8°; 50°; −130°): кисти подняты и чуть наружу, камере закрыто 18 % кадра, центр свободен.

## Проверка

```bash
C:\venvs\harvey-cad\Scripts\python.exe harvey_mini_parts.py
```

Строит все детали и печатает массу. Проверяет столкновения:
- нога сама с собой и с корпусом: 9 поз × 5 поворотов;
- соседние ноги;
- клешня: 332 разрешённые позы — против корпуса, передней ноги, другой клешни, глаза и самой себя;
- глаза от −90 до +20°;
- детали внутри корпуса друг с другом;
- станция стоя и лёжа;
- калибровочная подставка `calib_jig` в позе A (стопы в гнёздах, корпус на опоре, губки клешней на столбиках): 0 мм³, и клешни не задевают ноги. Подставка 195 × 216 × 34 мм — помещается на стол принтера 220 × 220.

Итог: **0 столкновений**. На станции: стоя зазор брюха до контактов 11,7 мм, лёжа контакты поджаты на 1,3 мм из 1,5 мм хода. Затем скрипт выгружает STL и детали для симуляции (`код/симуляция/мини/assets`).

**Перед печатью** сверить штангенциркулем размеры STS3032 с пометкой «ИЗМЕРИТЬ» в `модели/стенд кисти/harvey_hand_parts.py`. Отдельно проверить:
- шаг резьбовых отверстий на опорном торце (модель считает его таким же, как на рабочем);
- размер модуля круглого дисплея 0,71″ (в модели Ø24 × 4,5 мм).

Что купить и как печатать — [[Комплектация мини]].

Related: [[Компакт мини]] · [[Харви]] · [[код/симуляция/мини/README|Симуляция мини]]
