iamharveststorm/harvey/код/стенд привода/README.md

# Харви — стенд привода и ноги

Программа проводит замеры стенда этапа 1 и сохраняет результаты в Excel. Два режима:

- **«Компакт»** — привод STS3215-C018, 12 В, замеры 1–7 (ниже). Запуск — `run_bench_windows.bat`.
- **«Компакт мини»** — приводы STS3032-C036, 6 В, и собранная нога на стенде. Запуск — `run_bench_mini_windows.bat`. Описание — в разделе «Компакт мини» ниже.

## «Компакт мини» — STS3032 и нога

Что проверяем: держит ли нога вес мини без перегрева, сколько она берёт тока (→ время работы от батареи) и реальные размеры привода для CAD. Список покупок — [[Чек-лист стенда мини]]. Нормы программы — из [[STS3032-C036 — даташит Feetech (6 В).pdf|даташит STS3032-C036]]: 6 В, упор 4,5 кг·см при 1,2 А, номинал 1,5 кг·см, 0,09 с/60°, люфт ≤ 0,5°, датчика тока нет, защита выше 7,4 В и 70 °C; протокол шины — [[Feetech — протокол связи.pdf|протокол Feetech]], адаптер — [[FE-URT-1 — адаптер шины.xlsx|FE-URT-1]] (питание 4,8–25 В, до 6 А).

### Подключение (проще, чем у «Компакта»)

1. **Блок питания:** включи без нагрузки, выставь **6,0 В** и предел тока **3 А**, выключи. **Никогда 12 В**: у STS3032 защита выше 7,4 В.
2. **Провода «банан — крокодил»:** красный — «+» блока → «+» клеммника FE-URT-1, чёрный — «−» → «−». Адаптер пропускает это питание к приводам (допускает 4,8–25 В, до 6 А) — резать провода, как у «Компакта», не нужно.
3. **Привод → адаптер:** переходник 1,25 → 5264 из коробки привода — в трёхконтактный разъём **TTL (SCS)** адаптера.
4. **Адаптер** — в USB ноутбука, драйвер CH340, если Windows не видит порт.
5. Включи блок питания. Ток покоя одного привода — 0,02 А по паспорту.

У привода разъём 1,25 мм. Если на корпусе **один** разъём, три привода ноги соединяй через тройник: его можно спаять из комплекта разъёмов 1,25 мм. Если разъёмов два — цепочкой, кабелями из коробки.

### Порядок

1. **Пункт 2 — номера.** По одному приводу на шине: поворот — 1, бедро — 2, колено — 3. Новый привод отвечает под номером 1.
2. **Пункт 4 — размеры.** Штангенциркулем, каждый размер 3 раза. Программа сравнит с CAD (допуск ±0,3 мм) и запишет `servo_measurements.json` — пришли его, поправлю детали перед печатью. Главные — `horn_top` и `shaft_from_end`.
3. **Пункты 5–8 — один привод** без нагрузки: ток покоя (датчика тока у STS3032 нет — программа спросит показания блока), скорость, люфт (указка скотчем на бедре или на диске), точность возврата.
4. **Печать и сборка ноги** (после замеров). **Пункт 3 — центровка**: все приводы встают в середину 2048. Надень детали так, чтобы нога была буквой **«Г»**: поворот прямо от стенда, бедро горизонтально, голень вертикально вниз. В этой позе стопа на 10 мм ниже стола — стенд ставь у края стола.
5. **Пункт 9 — калибровка.** Момент выключен; рукой точно поставь «Г» (бедро — по уровню в телефоне), программа запишет эту позу как середину каждого привода и спросит, в какую сторону двинулся каждый сустав. Файл `leg_calibration.json` — не удаляй.
6. **Пункт 14 — всё с ноги подряд:**

| № | Что | Как | Норма |
| --- | --- | --- | --- |
| Н1 | Позы | медленно по крайним позам из правил движения (позы со стопой ниже стола пропускает) | ошибка ≤ 2°, ничего не задевает |
| Н2 | Стойка на весах | стенд на подставке высотой с весы, стопа на весах; программа опускает стопу по 0,5 мм, пока ты не введёшь 300–400 г; держит 60 с | ≥ 300 г, просадка ≤ 10 %, нагрузка бедра ≤ 80 % |
| Н3 | Момент бедра | стопа давит в весы изо всех сил ≤ 1,5 с; момент = вес × плечо от оси бедра до стопы | ≥ 0,36 Н·м (паспорт 0,44); ток в упоре ≈ 1,2 А |
| Н4 | Шаг на месте 10 мин | опора 0,6 с с нажимом как в треноге, перенос 0,6 с с подъёмом на 12 мм; запись температуры и нагрузки трёх приводов каждые 2 с | бедро ≤ 60 °C |
| Н5 | Батарея | ток ноги × 6 + электроника 2,5 Вт, батарея 22 Вт·ч | оценка в заметке 1,5–2 ч |

**Стенд обязательно прижми** струбциной или книгой ≥ 2 кг: в замере Н3 нога поднимает до 1,5 кг.

### Безопасность в режиме мини

- перед каждым замером — напряжение 5,4–6,6 В и температура < 60 °C;
- углы суставов всегда в пределах правил движения: поворот ±20°, бедро −45…+85°, колено −130…−60°;
- упор — не дольше 1,5 с (защита привода срабатывает при 80 % упора дольше 2 с);
- шаг останавливается при 65 °C на датчике привода или напряжении ниже 5,4 В;
- при выходе, ошибке или Ctrl+C все приводы отпускаются.

После стенда ноги — проверка шины от Pico 2: `код/прошивка/pico/README.md`.

## «Компакт» — STS3215-C018

### Что нужно

- Python 3.10–3.13, ноутбук с Windows или Linux;
- адаптер шины FE-URT-1 (USB);
- лабораторный блок питания RDD-3010S;
- привод STS3215-C018, рычаг 100 мм и держатель из деталей для печати;
- весы, лазерная указка, мультиметр с термопарой, груз 1 кг (например, бутылка воды 1 л в пакете).

### Подключение — важно

1. **Блок питания:** переключатель сзади — на **220 В**. Включи **без нагрузки**, выставь **12,0 В** и предел тока **3 А**, выключи.
2. **Кабель «адаптер → привод»:** на штатном кабеле аккуратно вынь из разъёма **со стороны адаптера** средний (красный) контакт иголкой или перекуси красный провод и заизолируй. По этому кабелю идут только сигнал и земля: клемма адаптера рассчитана на 6–9 В, а 12 В ей нельзя.
3. **Кабель от адаптера** — в разъём **G-V-S** (SCS) адаптера и в одно гнездо привода.
4. **12 В в привод:** во второе гнездо привода — короткий кабель с разъёмом 5264, у которого красный провод идёт на **«+» (красную клемму)** блока, чёрный — на **«−» (чёрную)**. Жёлтая клемма GND — заземление корпуса, её не трогай. Жёлтый (сигнальный) провод этого кабеля ни к чему не подключай.
5. **Адаптер** — в USB ноутбука. Переключатель уровня на адаптере не трогай: для работы через USB он не нужен.
6. Включи блок питания.

Если Windows не видит адаптер (нет нового COM-порта в «Диспетчере устройств»), поставь драйвер **CH340/CH341**.

### Запуск

- Windows: двойной клик по `run_bench_windows.bat`, введи порт (например `COM5`). Окружение Python создаётся в `C:\venvs\harvey-bench`, вне OneDrive (другой путь — переменная `HARVEY_BENCH_VENV`).
- Linux: `./run_bench_linux.sh`, порт обычно `/dev/ttyUSB0`.
- Без железа: введи `SIM` или просто нажми Enter — программа сымитирует привод, можно заранее пройти все шаги.
- Подсказки в окне запуска — на английском: в `.bat` нельзя писать по-русски, cmd путает кодировку и ломает команды. Сама программа стенда говорит по-русски.

### Порядок

1. **«Найти приводы».** У нового привода номер 1.
2. **«Назначить номер»** — по одному приводу на шине: ноге дай номера 1, 2, 3 (основание, бедро, колено). Номер запоминается в приводе навсегда.
3. **«Все замеры 2–7 подряд»** — программа подскажет, что сделать перед каждым шагом, и спросит то, что видно только тебе: показания блока питания, весов, пятна указки, термопары. Чтобы пропустить вопрос, введи «-».
4. **«Сохранить отчёт и выйти»** — появятся `bench_results_<дата>.xlsx` (лист «Результаты» с нормами и итогом, лист «Нагрев» — запись каждые 2 с) и такой же `.json`. Пришли мне `.xlsx` — разберём числа.

### Что делает каждый замер

| № | Что | Как |
|---|---|---|
| 1 | Связь | ищет приводы с номерами 1–253 и читает модель (STS3215 — 777) |
| 2 | Ток покоя и в упоре | держит позицию 1 с, затем давит в преграду ≤ 2 с; сравнивает ток привода с экраном блока и уточняет масштаб тока (`bench_calibration.json`) |
| 3 | Момент | давит рычагом на весы ≤ 2 с при 12 В (по желанию и при 10,2 В); ты вводишь показание весов |
| 4 | Скорость | поворот на 90° и обратно без нагрузки, время по датчику привода |
| 5 | Люфт | привод держит позицию, ты качаешь рычаг и вводишь размах пятна указки |
| 6 | Точность возврата | 10 раз на 45° и обратно, разброс по датчику (и по указке, если отметишь) |
| 7 | Нагрев | груз 1 кг на рычаге 100 мм (номинал 10 кг·см) 10 мин, запись температуры и тока |

### Безопасность в программе

- перед каждым замером с моментом — проверка напряжения 10–13 В и температуры < 60 °C;
- упор — не дольше 2 с, после него усилие сразу снимается;
- нагрев останавливается при 70 °C или токе > 2,2 А дольше 5 с;
- при выходе, ошибке или Ctrl+C все приводы отпускаются (команда «момент выкл.» всем сразу).

### Допущения, которые проверит стенд

Адреса регистров — таблица Feetech SMS/STS (та же, что в LeRobot и фирменном SDK). Масштаб тока по умолчанию — 6,5 мА на единицу; замер 2 сверяет его с блоком питания и запоминает поправку. Если программа покажет что-то странное (ноль тока, неверную модель), пришли текст из консоли.

## Файлы

- `harvey_bench/sts.py` — драйвер шины (пакеты, эхо полудуплекса, чтение и запись регистров), профили приводов и их нормы;
- `harvey_bench/bench.py` — замеры одного привода и меню: таблицы пунктов `compact_actions` / `mini_actions`, цикл `run_menu`, на выходе `release` отпускает все приводы;
- `harvey_bench/leg.py` — нога мини: кинематика из CAD, калибровка, позы, стойка, момент, шаг, оценка батареи;
- `harvey_bench/fake.py` — имитация приводов и ноги с весами (`--sim`);
- `harvey_bench/report.py` — отчёт Excel;
- `tests/` — 219 проверок на имитации (`python -m pytest`, ≈ 30 с): драйвер шины (`test_sts.py`), замеры одного привода (`test_bench.py`), нога (`test_leg.py`), меню и программа целиком (`test_bench_main.py`), отчёт Excel (`test_report.py`);
- `check_quality.bat` — тесты с покрытием, сложность (`crapper`), дубли (`dryer`); `check_quality.bat mutate leg` — ещё и мутанты (≈ 10 мин).

Related: [[Этап 1 — покупки и стенд одной ноги]] · [[Чек-лист стенда мини]] · [[код/прошивка/pico/README|Pico 2 — шина приводов]]
