iamharveststorm/harvey/модели/рендер/README.md

# Харви — рендеры и сетки для визуализаций

- `export_robot.py` — весь робот (компоновка v2) по материалам в позе «привет» → `parts/tech`, `parts/soft` (не печатать).
- `render_desk.py` — фотореалистичная сцена в Blender 5.2 (Cycles): дубовый стол в комнате, тёплый свет лампы, блокнот, ручки, телефон, кейс наушников, зажигалка, очки, кружка, растение. 3 ракурса × 2 варианта корпуса.
- `export_web.py` — сетки звеньев для `визуализация/3D-модель.html` и `визуализация/Интерактивный двойник.html` (`визуализация/lib/harvey_meshes.js`).
- `export_web_mini.py` — сетки «Компакт мини» для `визуализация/Двойник мини.html` (`визуализация/lib/harvey_mini_meshes.js`): берёт детали симуляции мини, поэтому после правок CAD сначала `модели/мини/harvey_mini_parts.py`, потом этот скрипт.

![[Харви_открытый_1.png]]

| | Открытый (основной) | Мягкий (кожух) |
| --- | --- | --- |
| Спереди | ![[Харви_открытый_1.png]] | ![[Харви_мягкий_1.png]] |
| Слева, весь стол | ![[Харви_открытый_2.png]] | ![[Харви_мягкий_2.png]] |
| Сверху сзади | ![[Харви_открытый_3.png]] | ![[Харви_мягкий_3.png]] |

## Как пересобрать

```bash
python export_robot.py
```

Потом в Blender (пути с кириллицей — через переменную):

```bash
set HARVEY_RENDER_DIR=C:\Users\iamha\OneDrive\Документы\Harvey\модели\рендер
"C:\Program Files\Blender Foundation\Blender 5.2\blender.exe" --background --python render_desk.py
```

Ресурсы Poly Haven (CC0) — в `C:\harvey-assets\polyhaven`: HDRI `lythwood_room`, текстура дуба `oak_veneer_01`, модели `office_notepads`, `stationery_supplies`, `vintage_lighter`, `desk_lamp_arm_01`, `potted_plant_02`, `round_spectacles`, `standing_picture_frame_01`. Телефон, кейс наушников в стиле Nothing Ear (2) (прозрачный корпус, белые вкладыши, без логотипов) и кружку сцена строит сама. Картинки глаз и экрана телефона — `tex/`.

## «Компакт мини» на том же столе

```bash
C:\venvs\harvey-cad\Scripts\python.exe ..\мини\export_render.py
```

Скрипт кладёт в `parts_mini/` детали по материалам в позе «машет клешнёй». Потом:

```bash
set HARVEY_ROBOT=mini && "C:\Program Files\Blender Foundation\Blender 5.2\blender.exe" --background --python render_desk.py
```

Получаются кадры `Мини_1…3.png`.

**Масштаб 1 : 1 для обоих роботов.**
- Предметы Poly Haven — в своих реальных размерах: лист A4 210 × 290 мм, ручки 131–161 мм, карандаш 194 мм, стакан Ø84 мм, зажигалка 39 × 53 мм.
- Свои модели — тоже реального размера: телефон 71,5 × 147 мм, кейс наушников 55,5 мм, кружка Ø82 × 92 мм.
- Предметы лежат на столе или друг на друге: ручки — на блокнотах, карандаши стоят в стакане с наклоном.
- Скрипт сам проверяет, что предметы не пересекаются и не уходят под стол.

**Исправлено 16.10.**
- Кружка была наполовину утоплена в стол, а её ручка и кофе привязаны неправильно.
- Лампа была уменьшена до 0,75; теперь она в реальном размере.
- Напольный цветок (горшок Ø47 см), сжатый до 0,36, убран со стола.
- Красная ручка была утоплена в блокнот.
- Два лишних карандаша набора лежали внутри робота.

- «Компакт» в выгрузке (`export_robot.py`) висел на 6,5 мм над столом: корпус ставился на фиксированную высоту. Теперь робот ставится на стол по самой нижней точке — стопы касаются стола.
- «Компакт» шире мини, поэтому он стоит на 6–7 см в стороне от бумаг (камеры сдвинуты вместе с ним). Ручка, зажигалка и кейс наушников справа — чуть дальше.

Кадры «Компакта» (`Харви_открытый_1…3`, `Харви_мягкий_1…3`) перерендерены 16.10 с этими исправлениями.
