iamharveststorm/harvey/модели/глаза/README.md

# Харви — глаза-стебельки (для печати)

Два глаза на передних углах корпуса, снаружи полос, где ходят клешни. Привод наклона STS3032 лежит вдоль корпуса (вал вперёд): глаз **наклоняется вбок** — «склоняет голову» для эмоций (−20…+20°) и складывается наружу до **−75°** (переворот, защита). Всё строит и проверяет `harvey_eye_parts.py`; правый глаз — зеркальный (`R_`).

## Устройство

- **Магнитная муфта**: переходник на качалку STS3032 (4 × M2) и диск стебелька — по 2 магнита 6 × 3 мм. Два конуса на стебельке входят в ямки переходника, поэтому после удара глаз встаёт обратно ровно, а привод не ломается.
- **Стебелёк**: трубка Ø11 с каналом Ø6 под кабель дисплея, коленом (вверх снаружи привода, потом над ним), заодно с задней крышкой оправы. Кабель выходит у основания внутрь — оставьте петлю на наклон.
- **Оправа**: модуль GC9A01 1,28″ (Ø40 × 4 мм) за линзой из поликарбоната Ø41,5 × 1,5 мм, окно Ø35; крышка — 3 × M2 саморез.
- **Бампер** из TPU натягивается на переднюю часть оправы.

## Что проверено

- Детали глаза между собой и с приводом — без пересечений во всём ходе −150…+45°; все детали цельные.
- Совместимость (`модели/корпус`): глаз не задевает ноги, раму и хвост при наклоне −75…+20°. Клешня, которая переносит предмет над головой, проходит мимо глаза, если тот отклонён наружу хотя бы на 20° — это правило прошивки (в симуляции и визуализациях оно уже работает). Бедро передней ноги — не выше 90° (иначе задевает сложенный глаз).

## Детали (папка `stl/`, на один глаз)

| Файл | Материал | Масса | Что это |
| --- | --- | --- | --- |
| `01_horn_adapter` | PETG | 1 г | переходник на качалку с гнёздами магнитов |
| `02_stalk_with_cover` | PETG | 9 г | стебелёк + задняя крышка оправы |
| `03_housing` | PETG | 8 г | оправа дисплея |
| `04_bumper_TPU` | TPU 95A | 5 г | бампер (в слайсере уменьшить внутренний Ø на 0,3 мм — натяг) |

## Покупное на два глаза

2 × GC9A01 1,28″, 2 × STS3032-C036, 8 магнитов 6 × 3 мм, 2 линзы ПК Ø41,5 × 1,5 мм, 8 × M2 × 6 (переходник), 6 × M2 × 6 саморезов (крышки), кабель 8 жил к SPI Pi 5.
