iamharveststorm/harvey/модели/клешни/README.md

# Харви — клешни (обе, для печати)

Две клешни по 5 суставов: поворот плеча **J1** (STS3032) → подъём плеча **J2** (STS3215) → плечо 54 мм → локоть **J3** (STS3215) → предплечье 60 мм → вращение запястья **J4** (STS3032) → кисть с захватом **J5** (STS3032). Левая клешня — зеркальная копия правой. Всё строит и проверяет `harvey_claw_parts.py`.

![[рендер клешней.png]]

## Что проверено скриптом

- Детали садятся на свои приводы без пересечений; все детали цельные.
- Ходы суставов без столкновений: подъём плеча **−15…+175°**, локоть **−105…+130°**, запястье — полный оборот, захват **0…60°** (до 90° свободно). Эти пределы надо прописать в приводы. Ниже −15° руке не нужно: кончики отогнутых пальцев достают до стола уже при −5°.
- Рабочие точки из сценариев симуляции: взять телефон или ручку со стола, поднять, положить на спину, поджать — **достижимы без столкновений**. Весь путь «телефон на спину» по суставам пройден с шагом — столкновений нет.
- Три промежуточные точки симуляции вплотную к плечу (55–67 мм) недостижимы: локоть пришлось бы сложить на 135–160°, корпуса приводов этого не дают. В симуляции они заменены точками подальше — проходят.
- Симуляция пересчитана с настоящими длинами и с отогнутыми пальцами (кончик на 41,6 мм вперёд и 17,5 мм вниз от оси запястья): телефон и ручка ложатся на спину и держатся при ходьбе, касаний с корпусом и глазами нет.
- **Совместимость с корпусом** (`модели/корпус/`): плечи стоят в (105; ±30; 65) мм — впереди передних ног; во всех рабочих позах клешня не задевает ноги, глаза, раму и вторую клешню при соблюдении правил движения (см. `harvey_layout.py`, `RULES`): в низких позах поворот ±15°, наружу до 75° — только с поднятой рукой, над головой и при укладке на спину — без поворота внутрь, внутрь обе клешни одновременно не поворачиваются.

## Отличия от симуляции (симуляция обновлена)

| | было | стало | почему |
| --- | --- | --- | --- |
| плечо J2 → J3 | 45 мм | **54 мм** | два корпуса STS3215 не помещаются: угол корпуса J2 выходит на 17,5 мм от оси, обхват J3 — на 36 мм |
| кисть до кончика | 35 мм | **≈ 43 мм** | привод захвата и пальцы 18 мм |
| вылет / до стола перед панцирем | 140 / 90 мм | 157 / 117 мм | следствие |

## Детали (папка `stl/`, `R_` — правая, `L_` — левая)

| Файл | На клешню | Материал | Масса | Что это |
| --- | --- | --- | --- | --- |
| `01_base` | 1 | PETG | 17 г | основание плеча: в панцирь, держит J1; опорное кольцо под диск поворота |
| `02_yaw_bracket` | 1 | PETG | 22 г | поворотная стойка: на качалку J1, держит J2 (длинной частью почти вниз, β = −100°: стойка компактная, выступает назад на 23 мм) |
| `03_arm_plate_outer`, `04_arm_plate_inner` | по 1 | PETG | 2 × 4 г | пластины плеча: фланцы J2 → обхват J3 |
| `05_elbow_sleeve` | 1 | PETG | 8 г | обхват привода локтя J3, 4 латунные вставки M3 |
| `06_forearm` | 1 | PETG | 17 г | предплечье: вилка на фланцах J3, рамка вокруг J4 |
| `07_hand` | 1 | PETG | 4 г | кисть: на качалку J4, держит J5, нижний палец |
| `08_jaw` | 1 | PETG | 1 г | верхний палец на качалке J5 |
| `09_pad_TPU` | 2 | TPU 95A | — | накладки на пальцы |
| `00_test_stand` | 1 общая | PETG | 150 г | подставка, чтобы проверять клешню на столе |

Пластик на клешню ≈ 90 г при 100 % (≈ 55 г при 40 %), приводы ≈ 170 г. Печать: PETG, слой 0,2 мм, 3 периметра, заполнение 40 %. Детали выгружены в рабочем положении — в слайсере положить на самую большую плоскую грань. `_сборка_для_просмотра.stl` — не печатать.

## Покупное на одну клешню

- Приводы: 2 × STS3215-C018, 3 × STS3032-C036 (уже в списке «Комплектации»).
- Винты M2 × 6 с внутренним шестигранником — 26 шт. (J1 → основание 4, стойка → качалка J1 3, J4 спереди 4 и сзади 4, кисть → качалка J4 3, J5 → кисть 4, палец → качалка J5 4); ключ 1,5 мм.
- Винты M3 × 5 во фланцы STS3215 — 16 шт.; M3 × 8 — 4 шт. и 4 латунные вставки M3 (пластины → обхват локтя).
- Самонарезающие винты PA2.0 **на 1,5 мм длиннее штатных винтов корпуса** STS3215 — 8 шт.: меняют задние винты корпуса J2 и J3, держат корпус в обхвате.
- Тефлоновая лента или шайба Ø39/44 мм на опорное кольцо основания.
- Кабели: 3 переходника 5264 ↔ 1,25 мм (у STS3032 разъём другой).
- На роботе основание — часть передней палубы корпуса (`модели/корпус/stl/03_front_deck.stl`); для подставки — 4 вставки, 4 × M3 × 8, 4 шурупа в доску.

## Порядок сборки

1. J1 снизу в основание, 4 × M2 сверху; основание — на подставку (или в переднюю палубу корпуса).
2. Тефлон на опорное кольцо. J1 в середину (2048) → стойку на качалку J1, винты M2 — **отвёрткой сквозь пустой обхват J2** (в дне обхвата колодцы над винтами: 4 места и центральный винт).
3. Только потом J2 — в обхват поворотной стойки, длинные винты корпуса — сквозь стенки.
4. J3 — в обхват локтя, длинные винты корпуса; вплавить 4 вставки M3.
5. J2 в середину → пластины на фланцы J2 (4 × M3 × 5 каждая) → к обхвату локтя (M3 × 8 во вставки).
6. J4 — в предплечье спереди: 4 × M2 в передний торец, 4 × M2 в задний.
7. J3 в середину → вилку предплечья защёлкнуть на фланцы J3 (уши немного разводятся), 4 × M3 × 5 с каждой стороны.
8. J5 — к пластине кисти, 4 × M2 со стороны пальцев (сквозь каналы для ключа).
9. J4 в середину → кисть на качалку J4, 3 × M2.
10. J5 в «закрыто» → верхний палец на качалку J5, 4 × M2; вклеить накладки TPU.
11. Прописать пределы суставов в приводы (см. выше).

## Обязательно измерить, когда придут приводы

1. **Разъёмы STS3215.** По чертежу даташита оба разъёма 5264 стоят на нижней стороне корпуса, в 7–17 мм от второго вала. Вставленный кабель может упереться в пластины плеча и уши предплечья, которые крутятся вокруг этого вала. Измерить высоту штекера над корпусом. Если упирается — повернуть привод разъёмами наружу или взять угловые штекеры. **Это касается и стенда ноги.**
2. Размеры STS3215 (длина, ширина, ось вала, фланцы) и положение винтов корпуса — значения с пометкой «ИЗМЕРИТЬ» в скриптах стендов и в `harvey_claw_parts.py`.
3. STS3032-C036: ось вала до торца и высота качалки (как для стенда кисти).

После правки чисел: `python harvey_claw_parts.py` — пересоберёт STL и заново проверит ходы, точки и путь.
