iamharveststorm/harvey/модели/корпус/README.md

# Харви — корпус: компоновка v2 и открытая рама

Здесь — как всё стоит вместе и на чём держится.

- `harvey_layout.py` — все конечности (готовые модели ног, клешней, хвоста, глаз) в системе корпуса, точки крепления и **правила движения** (`RULES`); `python harvey_layout.py` строит вид сверху и проверяет, что соседние конечности не задевают друг друга во всех рабочих позах.
- `harvey_body_parts.py` — открытая рама (14 деталей для печати) и электроника габаритами; `python harvey_body_parts.py` выгружает STL и проверяет раму, электронику, камеру и датчики против всех конечностей во всех позах.

![[компоновка_вид_сверху.png]]

## Точки крепления (мм, от центра корпуса на уровне осей бедра)

| Узел | Где | Почему так |
| --- | --- | --- |
| Ноги (оси оснований) | (±55; ±58), (0; ±66), (−55; ±58) — как раньше | походка уже проверена |
| Плечи клешней | (105; ±30; 65) | впереди передних ног: поворотная стойка клешни не задевает их кронштейны |
| Хвост | (−80; 0; 72) | колонна поворота за подносом |
| Глаза (оси наклона) | (70; ±80; 76) | снаружи полос, где руки переносят предметы над головой |
| Камера | (60; 0; 40), привод наклона | в «голове», под траекторией рук |
| Датчики края | вперёд (127; ±12), назад (−104; ±14), вбок (−28; ±52) | лучи ничем не закрыты |

## Правила движения (обязательны для прошивки)

1. Клешни: в низких позах (подъём < 80°) поворот ±15°; наружу до 75° — только с поднятой рукой; над головой и при укладке на спину — без поворота внутрь; внутрь обе клешни одновременно не поворачиваются.
2. Хвост: к столу — только назад (±30°) и когда робот стоит; вбок до ±100° — поднятым над горизонталью на 20° и больше.
3. Ноги: бедро выше 90° — только при перевороте (основание 0°); у передних ног — не выше 90°.
4. Глаза: пока своя клешня поднята (≥ 60°), глаз отклонён наружу на 20°.

Проверки: рама и электроника × все конечности — **0 столкновений**; конечности между собой — **0**.

## Рама (папка `stl/`)

| Файл | Размер, мм | Масса (40 %) | Что это |
| --- | --- | --- | --- |
| `01_belly` | 166 × 99 × 4 | 28 г | днище: ячейки аккумулятора, Pi, Pico, насос; снизу — 2 контакта зарядки, решётка динамика |
| `02_ring_frame` | 116 × 115 × 67 | 78 г | верхнее кольцо + 6 обхватов приводов оснований ног (удлинённые винты корпуса) + стойки до днища |
| `03_front_deck` | 81 × 104 × 32 | 26 г | передняя палуба: основания обеих клешней (кольца под диски поворота, J1 висят снизу), стенки до днища |
| `04_tail_mount` | 50 × 48 × 39 | 20 г | узел хвоста: основание T1, стенки, проход трубки, кнопка «стоп» сзади |
| `05_tray` | 87 × 105 × 14 | 13 г | поднос для телефона на 4 стойках (M3 во вставки кольца) |
| `06_eye_mount_L/R` | 22 × 50 × 30 | 2 × 4 г | держатели приводов глаз над кронштейнами ног |
| `07_camera_mount` | 18 × 36 × 28 | 2 г | кронштейн привода наклона камеры на палубе |
| `08_edge_sensor_1…6` | 11 × 18 × 23 | 6 × 1,4 г | кронштейны VL53L4CD, плата под 23,5° вниз |

Рама ≈ 180 г (PETG, 40 %). Печать: PETG, слой 0,2, 3–4 периметра; кольцо — верхней плоскостью на стол.

## Электроника — где стоит

- **Pi 5 + AI HAT+** — ребром в центральном канале между приводами ног (|y| ≤ 14 мм), лучше обдувается.
- **3 банки 21700 (3S)** — раздельно: по одной слева и справа внизу, третья под передней палубой; BMS 3S рядом.
- **Pico 2, насос и клапан** — сзади под хвостом; **DC-DC 5 В / 6 В** — внизу справа; **динамик** — под палубой, решётка в днище.

## Варианты

Основной — открытая рама (так видны приводы и проще обслуживать). Для рендеров есть «мягкий» вариант: графитовый скруглённый панцирь с крышкой вместо подноса (`модели/рендер/export_robot.py`, `soft_cover()`), он тоже проверен — 0 столкновений.
