iamharveststorm/harvey/модели/стенд ноги/README.md

# Харви — детали стенда одной ноги

![[рендер ног.png]]

## ⚠ Перепроверка 15.10.2026 — перепечатать 4 детали и напечатать стойку

В первой версии привод колена и его обхват **упирались в привод бедра и в кронштейн основания** при любом положении бедра: от 160 до 2 500 мм³ пересечения. Ногу было не собрать. Старая проверка `assembly_check.py` эту пару не смотрела. Теперь её заменяет полная проверка `leg_check.py`.

Что изменено:

| Деталь | Было | Стало | Перепечатать? |
| --- | --- | --- | --- |
| `harvey_coxa_bracket` | канал вокруг всего привода бедра и стенка над бедром | одна стенка; обхват только задней половины привода бедра, держат 4 удлинённых винта корпуса | **да** |
| `harvey_femur_plate_x2` | 45 мм между осями | **51 мм**, конец короче, карманы под головки винтов | **да, 2 шт.** |
| `harvey_knee_sleeve` | с задней стенкой | без задней стенки (она упиралась в кронштейн), держат 4 удлинённых винта корпуса | **да** |
| `harvey_coxa_strap` | планка-фиксатор | не нужна | — |
| рычаг, держатель, голень, стопа | — | без изменений | нет |

Описание в [[harvey-stage1-parts.pdf]] (папка `документы/`) относится к первой версии. Настройки печати и порядок сборки в нём верны, а размеры бедра и кронштейна — уже нет.

## Что проверено (`python leg_check.py`)

- Детали садятся на свои приводы без пересечений.
- Поворот основания ±60°: без столкновений. Стенка кронштейна стоит в 18,5 мм от оси основания, а угол корпуса привода основания — в 17,6 мм.
- Колено ходит −130…+30°. Сильнее не складывается: вилка голени ложится на пластины бедра. Пределы суставов прописать в приводы.
- Рабочая стойка (бедро +20°, колено −110°), покой «на корточках» (колено −125°) и **весь цикл шага с подъёмом стопы 25 мм** — без столкновений.
- Симуляция пересчитана с бедром 51 мм. Ходьба легче, чем было: на быстром шаге пик колена 1,87 вместо 2,40 Н·м, время выше номинала 7 вместо 14 %, запас устойчивости 21 вместо 17 мм. «Сесть — встать» работает.

## Покупное — добавилось

- Самонарезающие винты PA2.0 **на 1,5 мм длиннее штатных винтов корпуса** STS3215 — 8 шт. Ими заменяют задние винты корпуса привода бедра (4) и привода колена (4), винты проходят сквозь стенки обхватов.

## Обязательно измерить, когда придут приводы

1. **Разъёмы STS3215.** По чертежу даташита они на нижней стороне корпуса, в 7–17 мм от второго вала. Вставленный кабель может упереться в пластину бедра (привод бедра) и в ухо голени (привод колена). Если упирается — поставить привод разъёмами в другую сторону или взять угловые штекеры.
2. Размеры привода, фланца и положение винтов корпуса — значения с пометкой «ИЗМЕРИТЬ» в `harvey_leg_parts.py`. После правки:

        pip install manifold3d trimesh numpy
        python harvey_leg_parts.py        # пересоздаст stl/
        python leg_check.py               # полная проверка ноги

## Рендер

`python export_render_parts.py`, затем `blender --background --python render_legs.py`. Папка `render_parts/` — промежуточные файлы, их не печатать. На рендере — настоящая стойка `harvey_leg_tower`; на роботе привод основания держит панцирь.
