iamharveststorm/harvey/модели/хвост/README.md

# Харви — хвост с присоской (для печати)

«Третья рука» на корме: поворот **T1** (STS3032) → подъём **T2** (STS3215, длинной частью вниз) → плечо 70 мм → локоть **T3** (STS3215) → предплечье 70 мм → наклон запястья **T4** (STS3032) → держатель присоски (присоска Ø22 на сильфоне, 26 мм от оси запястья). Основание, поворотная стойка, пластины плеча и обхват локтя — те же узлы, что у клешни (`модели/клешни`), со своими длинами. Всё строит и проверяет `harvey_tail_parts.py`, пути из симуляции — `tail_path_check.py`.

## Что проверено

- Детали садятся на свои приводы без пересечений; все детали цельные.
- Ходы без столкновений: подъём **−40…+180°**, локоть **−130…+155°**, запястье — полный оборот. Эти пределы прописаны в симуляции (`harvey_tail.py`).
- Предплечье — вилка: уши на обоих фланцах T3, балки **снаружи** пластин плеча (±25…29 мм), поэтому локоть складывается почти вдвое; поперечина снизу (при сгибе уходит вверх, мимо обхвата локтя). Привод запястья держится задним торцом за плиту на балке +y, держатель присоски крутится внутри вилки.
- Все пути хвоста из симуляции — подбор телефона со стола сзади, передача клешням, переворот со спины (вбок 90°) — пройдены на модели по шагам без столкновений.
- Со стола сзади хвост берёт в положении «локоть вверх»: подъём не ниже −27°.
- Поза покоя — присоска над задней частью спины, на 95 мм над центром (ниже — задевает поворотную стойку).
- Совместимость с корпусом и ногами (`модели/корпус`): вбок хвост поворачивается до ±100° только поднятым на 20° над горизонталью, к столу — только назад (±30°) и когда робот стоит.

## Детали (папка `stl/`)

| Файл | Шт. | Материал | Масса (100 %) | Что это |
| --- | --- | --- | --- | --- |
| `01_base` | — | — | — | на роботе не печатается: основание — часть рамы (`модели/корпус/stl/04_tail_mount.stl`) |
| `02_yaw_bracket` | 1 | PETG | 20 г | поворотная стойка: на качалку T1, держит T2 |
| `03_arm_plate_outer`, `04_arm_plate_inner` | по 1 | PETG | 2 × 6 г | пластины плеча |
| `05_elbow_sleeve` | 1 | PETG | 8 г | обхват привода локтя T3, 4 вставки M3 |
| `06_forearm` | 1 | PETG | 26 г | предплечье-вилка с плитой под T4 и клипсами трубки |
| `07_cup_holder` | 1 | PETG | 3 г | держатель присоски: на качалку T4, гнездо штока Ø8, штуцер под трубку Ø4 |

## Покупное

- Приводы: 2 × STS3215-C018, 2 × STS3032-C036.
- Присоска Ø20–25 мм с сильфоном и штоком M8 (или Ø8 на клей), мини-насос 6 В, клапан сброса, силиконовая трубка 4/2,5 мм ≈ 40 см.
- Винты M2 × 10 — 6 шт. (плита → задний торец T4), M2 × 6 — 4 шт. (держатель → качалка T4), M3 × 5 — 16 шт. во фланцы, 4 вставки M3 + M3 × 8.

## Порядок сборки

1. T1 — в узел хвоста рамы снизу; поворотную стойку — на качалку T1 через пустой обхват T2 (колодцы для отвёртки), затем T2 в обхват, длинные винты корпуса.
2. T3 — в обхват локтя; пластины — на фланцы T2 и к обхвату.
3. T4 — задним торцом к плите предплечья (6 × M2 × 10); вилку — на фланцы T3.
4. Держатель присоски — на качалку T4; трубку — по клипсам предплечья к штуцеру.
5. Прописать пределы суставов (см. выше).
