iamharveststorm/harvey/код/симуляция/мини/README.md

# Харви «Компакт мини» — симуляция

MuJoCo-модель мини. Размеры, массы и видимые детали взяты из CAD: [[модели/мини/README|Компакт мини — детали]]. Приводы — STS3032 с ограничением момента и падением момента со скоростью, как у настоящих. Физика считается по простым формам, детали CAD только рисуются.

![[mini_стол.png]]

![[mini_салфетка.png]]

![[mini_привет.png]]

![[mini_и_предметы.png]]

## Запуск

```bash
python harvey_mini.py
```

Это все проверки, итог пишется в `mini_results.json`. Другие режимы:
- поведение по датчикам: `python mini_behave.py` (раздел ниже);
- выборочные проверки: `python harvey_mini.py walk pen dock` (`stand`, `walk`, `turn`, `pen`, `wipe`, `tip`, `edge`, `dock`);
- `python harvey_mini.py --view` — окно MuJoCo, Харви идёт;
- `python mini_photo.py` — фотореалистичные кадры на рабочем столе (Filament); нужен MuJoCo 3.15+.

После правок CAD сначала запустите `C:\venvs\harvey-cad\Scripts\python.exe модели/мини/harvey_mini_parts.py` — это обновит `assets/`.

## Управление с клавиатуры (фотореалистично)

Двойной клик по `run_mini_windows.bat` или `python harvey_mini_teleop.py`; простое окно MuJoCo — `--classic`, самопроверка без окон — `--test`.

![[mini_управление.png]]

**Сцена.** Тот же рабочий стол, что у «Компакта», в реальном масштабе 1 : 1: ручки, карандаш, блокнот, кружка, кейс наушников, зажигалка, книга, ноутбук, лампа. Ещё есть салфетка перед левой клешнёй и станция зарядки на столе слева сзади.

**Картинка** — рендер Filament: PBR-материалы, текстуры Poly Haven, мягкие тени, около 30 кадров/с на RTX 5070 Laptop. Физика — MuJoCo в отдельном процессе, с теми же приводами STS3032, что в проверках.

| Клавиши | Что делают |
| --- | --- |
| W / S, A / D, Q / E (зажать) | вперёд / назад, поворот, шаг вбок |
| F | быстрый шаг |
| R | присесть (для работы на столе) |
| Z | лечь на брюхо |
| Пробел | стоп |
| B | выбрать клешню: левая / правая / обе |
| I / K, J / L, U / O (зажать) | клешня вперёд / назад, влево / вправо, вверх / вниз |
| N / M (зажать) | раскрывать / сжимать губки (~90°/с, как привод захвата) |
| , / . | слабее / сильнее сжимать: предел момента привода захвата 0,01–0,20 Н·м |
| 1 / 2 / 3 / 4 | поджать / к столу / помахать / подать |
| T | взять ручку или карандаш перед выбранной клешнёй (предмет должен лежать вдоль клешни) |
| H | домой: дойти до станции в обход башенки и лечь на контакты |
| V | вид глазами Харви: его камера Module 3 Wide (67° × ~100°) / обычный вид |
| [ / ] | посмотреть вниз / вверх: корпус наклоняется ногами до ±12° (камера в корпусе неподвижна) |
| 7 / 8 / 9 | глаза: грусть / интерес / радость |
| G | защита края стола вкл/выкл |
| C | показать физические формы |
| 0 | начать заново |
| X / Esc | выход |

Мышь в фото-окне: левая кнопка — вращать, правая или колесо — приблизить. Клешни двигаются только в пределах правил движения из CAD: на запретную позу панель пишет «предел клешни».

### Ручки, карандаш и захват — как в жизни

Предметы на столе сделаны по настоящим (`mini_objects.py`):

| Предмет | Форма | Масса | Как ведёт себя |
| --- | --- | --- | --- |
| шариковая ручка | Ø9,6, колпачок с клипом, наконечник, центр тяжести смещён к колпачку | 11 г | клип не даёт укатиться |
| гелевая ручка | гладкая Ø11, резиновая зона хвата | 14 г | катится по столу |
| карандаш HB | шестигранник 7,2 мм под ключ, заточка, ластик в обойме, 182 мм | 7 г | ложится на грань, не катится |

**Трение.**
- Пластик по лакированному дубу — 0,35, дерево карандаша — 0,40, резина — 0,7, накладки губок из TPU по пластику — 0,9.
- В паре берётся трение более «важного» тела, а не большее из двух. Иначе в MuJoCo ручка скользила бы по столу с трением 0,8.
- Включены точный конус трения и коррекция проскальзывания. Без них лёгкий предмет медленно выползал из губок, хотя сила трения больше его веса. У настоящих губок такого нет.

**Захват.** Губки сжимаются, пока зажата M, и давят не сильнее заданного предела момента — как регистр Torque Limit у STS3032. На панели видно, что зажато и с какой силой. Клавиша T берёт предмет перед клешнёй сама. Если задний конец предмета лежит под корпусом, Харви сначала отступает назад. Иначе при подъёме брюхо придавливает хвост ручки, она наклоняется и выскакивает из губок, как рычаг.

**Проверка `--grip-test`:**

| Предмет | Предел момента | Поднят | Через 2 с | Сжатие |
| --- | --- | --- | --- | --- |
| ручка | 0,06 Н·м | 85 мм | 85 мм | 2,2 Н |
| гелевая ручка | 0,06 Н·м | 82 мм | 82 мм | 2,7 Н |
| карандаш | 0,06 Н·м | 93 мм | 93 мм | 0,6 Н |
| ручка | 0,01 Н·м | 84 мм | 84 мм | 0,4 Н |
| ручка | 0,004 Н·м | не взял | — | — |

После раскрытия губок предметы падают и откатываются на 8–13 мм.

### Вид глазами Харви (V)

![[mini_глазами_Харви.png]]

**Камера.** Стоит там, где в CAD объектив Camera Module 3 Wide: в передней стенке между плечами, на 8,5 мм выше осей бедра. Поле зрения — 67° по вертикали и около 100° по горизонтали, как у настоящей. Видно ровно то, что попадает в её кадр, и свои клешни тоже. Камера в мини **неподвижна**: отдельного привода нет, «осматривается» Харви корпусом. Поворачивается ногами, а наклоняет корпус клавишами [ / ] до ±12°: передние ноги поджимаются, задние вытягиваются, ходить в наклоне тоже можно.

**Поза «поджато» изменена ради камеры.** В прежней позе (0°, 15°, −115°) приводы захвата висели прямо перед объективом и закрывали 48 % кадра, включая центр. В новой позе (8°, 50°, −130°) кисти подняты и чуть разведены наружу: закрыто 18 %, центр свободен. Человеку, сидящему перед роботом, глаза видны полностью. Проверка CAD — по-прежнему 0 столкновений.

**Батарея — модель 22 Вт·ч.** Ток каждого привода считается по его моменту (у STS3032-C036 0,44 Н·м при 1,2 А). Сверху — 1,8 Вт на Pi Zero, дисплеи и датчики. На станции, когда оба контакта прижаты, батарея заряжается мощностью 12 Вт. Заряд показан на панели.

**Самопроверка (`--test`):**
- ходьба, поворот, шаг вбок, клешни работают;
- T — ручку взял (с отступом назад), поднял на 85 мм, подал на высоте 140 мм;
- H — дошёл до станции в обход башенки и лёг на контакты с точностью 1 мм, заряд растёт;
- шаг вбок к краю — остановился в 39 мм от края (по средней стопе).

**Боковые датчики края.** Их луч наклонён положе, чем у передних: 3,5 : 1, около 16° вниз, а у передних 2,3 : 1. Так край виден за 100 мм, потому что средние стопы выходят за корпус на 57 мм. С наклоном 2,3 : 1 запас был бы всего 12 мм.

## Поведение по датчикам

```bash
python mini_behave.py            # все сценарии, итог в behave_results.json (~8 мин)
```

Здесь Харви ведёт себя так, как будет на столе: только по своим датчикам, без ПК.
- **«Спинной мозг».** Работает настоящая прошивка RP2350 без правок: `Spine`, рефлексы, датчики края, маяк, протокол.
- **Имитации датчиков** (`mini_sensors.py`):
  - 6 лучей VL53L4CD;
  - IMU в центре корпуса;
  - INA226;
  - шины приводов: ID и позиции STS;
  - три ИК-приёмника и маяк станции из двух светодиодов с перегородкой. Расчёт по даташитам TSOP382 и TSAL6200, угловые кривые cos^n — **предварительно**; тень перегородки считает луч MuJoCo.
- **«Зрение»** — заглушка разбора кадра:
  - где рука в кадре камеры: ±50° × ±33,5°, до 60 см;
  - направление и расстояние до метки AprilTag на башенке. Столько же даёт настоящий разбор на голове: `код/голова/harvey_head/dock_tag.py`.
- **Голова — настоящая** (`код/голова/harvey_head`): `Head` + `Body` — поведение `behavior.py` и походка `gait.py`, цели суставов 50 раз в секунду, как на Pi. `mini_robot.py` даёт ей порт, как USB на роботе: `j` → Spine → физика.
- **Походка симуляции — та же, что у головы.** `harvey_mini.py` берёт из `gait.py` обратную задачу ног и шаг, поэтому тест «стопа туда, куда просили» сверяет код головы с MuJoCo.
- **Заряд** засчитывается, только когда каждый контакт под своей латунной пластиной (40 × 12 мм, контакт Ø5): допуск вбок ±3,5 мм, вдоль ±17,5 мм.

**Как Харви идёт домой без ПК:**
1. Найти станцию: метка в кадре или пачки маяка.
2. Повернуться к ней. По метке — сразу. По маяку — пройти сектор, где маяк видят оба боковых приёмника, туда и обратно и встать на середину.
3. Выйти на ось станции. Шагом вбок пройти клин, где центральный приёмник видит оба светодиода, туда и обратно и встать на середину клина. Станцию при этом держать перед собой: доворот на шаг вбок, курс против увода держит гироскоп. Потом снова повернуться к станции: с оси это и есть курс по оси.
4. Идти прямо с курсом по гироскопу. Вышел из клина — шаг вбок 5 мм/с.
5. Остановиться над контактами по передним датчикам края: площадка ближе стола, снова стол, башенка ближе. Отступить на 17 мм и лечь. Нет заряда за 3 с — отойти на 20 см, сразу снова выйти на ось и повторить один раз.

| Сценарий | Итог |
| --- | --- |
| Домой при свете (метка и маяк), 10 стартов в 18–35 см, с любого курса | **10 из 10** на зарядке за 14–36 с; промах вбок 0–3 мм, вдоль 1–14 мм |
| Домой в темноте (только маяк), те же 10 стартов | **10 из 10** за 35–90 с; промах вбок 0–3 мм, вдоль 0–16 мм. Самый дальний старт — 21 см вбок, 45° от оси — со второй попытки |
| Станция позади башенки | «не вижу станцию» за 13 с, остался на столе |
| Осмотреться | 365° за 18,5 с, корпус сдвинулся на 2 мм |
| Рука в 30 см под 30° | встал в 89 мм от руки за 6 с |
| Рука сзади | нашёл осмотром, подошёл на 89 мм |
| Рука за краем стола, 4 стороны | рефлекс остановил, поведение увело назад; ни разу не упал, наклон ≤ 0,6° |
| Подняли на 5 см (15 см/с) и поставили | приводы отпущены через 0,25 с; поставили — снова осматривается |

**Что нашла симуляция (03.11.2026):**
- **Метка 30 мм не выводит на ось станции.** Камера надёжно даёт только направление (±0,3°) и расстояние (±2 %). Поворот Харви на 2° в кадре неотличим от сдвига вбок на 13 мм: маленькая метка почти не искажается в перспективе. Это проверено на синтетических кадрах. Прежний итог «10 из 10 по метке» опирался на точную позу из заглушки — так не будет.
- **Один ИК-светодиод тоже даёт только направление.** Сбоку Харви приходил по диагонали: при 20 мм сдвига на старте он промахивался на 6,5 мм, а допуск ±3,5 мм. Ось станции дают два светодиода с перегородкой: оба видны только в клине вдоль оси, у контактов ~±1 мм.
- **Направление на маяк считается по самому заметному светодиоду, а не по сумме.** Иначе приёмник, который видит оба светодиода, «перевешивает»: сектор «прямо» сужался до 8° и смещался.
- **Корпус догоняет команду шага с запаздыванием ~0,3 с.** Края клина, замеченные на ходу, сдвинуты по ходу на 7–10 мм. Поэтому клин проходится туда и обратно, и четыре края усредняются.
- **Приёмник клина стоит в 71 мм перед центром корпуса.** Важен курс: 2,5° мимо оси — это 3 мм брюха мимо пластин. У станции нельзя доворачивать на метку, это раскачивает. Курс задаётся поворотом к станции с оси, дальше его держит гироскоп.
- **Резкая смена шага вбок дёргает корпус на несколько миллиметров:** опорные стопы перескакивают. Поэтому поправка на заходе — 5 мм/с.
- **У края площадки луч датчика края дрожит от шага:** «стол» — «площадка» — «стол». Башенку засчитывать, только если стол держался 0,6 с.
- **Направление на маяк приходит с опозданием до 100 мс**: окно счёта пачек. При проходе сектора в одну сторону это 2° мимо станции, поэтому проход туда и обратно.
- **Повороты по времени неточны.** Поэтому в телеметрии RP2350 есть вращение `gyr`, и повороты идут на угол.
- **Калибровка носом к предмету портила край.** Теперь берутся только замеры в ±15 мм от расчётного (72 / 104 мм).
- **Ноги на площадку не наступают**: стопы шире её. Остановка — по датчикам края.
- **Повторные проходы клина не сходятся** (04.11.2026). Середина клина в физике находится с точностью ±5–8 мм, а каждый круг «клин + поворот к маяку» стоит 20 с. Помогли другие правки: гироскоп держит курс на проходе, повтор после неудачной попытки идёт сразу на ось, сектор маяка проходится на 30 °/с.

## Мозг ведёт Харви

«Большой мозг» (`код/мозг`, `harvey_brain`) на ПК говорит с головой Харви в окне MuJoCo так же, как будет говорить с настоящей: мозг -> голова (`Head` + `Body`) -> прошивка RP2350 (`Spine`) -> робот.

```bash
run_brain_sim.bat                       # или: python mini_brain.py --with-brain
```

Откроются окно MuJoCo (камера следит за Харви) и отдельная консоль мозга (`harvey_brain --text`, нужен venv `C:\venvs\harvey-brain`, другой путь - в `HARVEY_BRAIN_VENV`). Набирайте фразы в консоли мозга:
- «Харви, иди домой» - Харви идёт к станции и встаёт на зарядку;
- «Харви, посмотри на меня» - осматривается;
- «иди ко мне» - идёт к руке (рука лежит на столе спереди-слева);
- «стоп» - останавливается.

В консоли симуляции печатаются смены поведения и глаз: «Поведение: home_search», «Глаза: happy», «Мозг: на связи / не на связи». Эмоции ответа видны и в консоли мозга. Без мозга Харви ведёт себя сам и раз в 5 с пробует подключиться. Закрыли окно MuJoCo - закрывается и консоль мозга.

Параметры: `--headless` (без окна), `--fast` (быстрее реального времени), `--seconds N`, `--port 8765`, `--with-brain`. Проверки: `tests/test_brain_link.py`, `test_brain_sim.py`, `test_brain_main.py`.

## Почему MuJoCo + Filament, а не другой движок

| Движок | Картинка | Физика маленького робота | Для нас |
| --- | --- | --- | --- |
| **MuJoCo + Filament** (сейчас) | PBR, мягкие тени, ~30 к/с | лучшая для приводов и контактов; на ней проверены ходьба и захват | ✅ уже работает |
| NVIDIA Isaac Sim (PhysX 5 + RTX) | трассировка лучей, почти фото | хорошая, для роботов | возможно; 8 ГБ видеопамяти — на нижней границе, установка ~20 ГБ |
| Unreal Engine 5 / Unity HDRP | лучшая (Lumen, HDRP) | игровая (Chaos, PhysX): контакты мелких приводов неточны | только как «картинка» для физики MuJoCo — плагин MuJoCo для Unity |
| Genesis | трассировка лучей | быстрая, на GPU | молодой проект, мало проверен |
| Gazebo / Webots | средняя | хорошая | не красивее Filament |

Если захочется «как в кино» в реальном времени, следующий шаг — Isaac Sim или связка MuJoCo + Unity. Физика при этом остаётся проверенной.

## Результаты (масса 893 г из CAD)

| Проверка | Итог |
| --- | --- |
| Стойка | бедро 26 % номинала STS3032, просвет под корпусом 22 мм |
| Ходьба трипод | 6,2 см/с, увод 4 мм за 8 с, наклон ≤ 0,5°; бедро в среднем 77 % номинала, пики 74 % предела; колено 50 % |
| Разворот на месте | 44°/с в сторону команды (при 45,8°/с заданных) |
| Ручка | присел на 16 мм, губки сверху, сжал, поднял на 68 мм, пронёс 2 с шагом, подал на высоте 105 мм — в пальцах; правила не нарушены; подъём плеча 15 % номинала |
| Протирка салфеткой | губки прижимают салфетку, рука ходит вперёд-назад, полосы смещаются разворотом корпуса; салфетка ходит за рукой (45 мм), правила не нарушены |
| Клешни вперёд | не клюёт носом (наклон 0,1°), но привод подъёма плеча — **96 % упора**: держать клешни вытянутыми долго нельзя |
| Край стола | передний датчик видит край за 67 мм до корпуса; запас до края у стопы 42 мм, у клешни 30 мм |
| Станция зарядки | 20 см шагом за 3,2 с, промах 5 мм вперёд и 2 мм вбок, опустился на 13 мм; на контактах 3,5 и 4,0 Н — заряжается |

**Что это значит для приводов.** При ходьбе бедро нагружено в среднем на ~76% номинала. Ходить можно, но долго без отдыха привод будет греться. Поэтому Харви ходит перебежками и отдыхает лёжа на брюхе. На стенде проверить нагрев STS3032 за 10 минут ходьбы.

**Что это значит для станции.**
- Промах вбок допустим до 4 мм: пластины на брюхе 40 × 12 мм, контакты Ø5.
- В симуляции Харви шёл к станции вслепую, по известному положению. На роботе путь подправляется по метке AprilTag на башенке (камера, ПК) или по ИК-маяку (без ПК).

## Тесты

```bash
C:\venvs\harvey\Scripts\python.exe -m pytest -q tests
```

122 теста за ~2 мин. Что проверяют:
- кинематика ног — обратная задача против MuJoCo: стопа приходит туда, куда просили, ±0,5 мм;
- клешни — прямая и обратная задача сходятся, правила движения 1, 2 и 4 соблюдаются;
- походка — треноги чередуются, подъём стопы 15 мм;
- сценарии с нормами: стойка, ходьба 5–8 см/с, поворот в сторону команды, ручка в пальцах, салфетка, станция заряжает;
- все клавиши управления и самопроверка `harvey_mini_teleop.py --test`;
- датчики для прошивки (`test_sensors.py`): лучи края по геометрии, край стола, IMU, маяк по углам, метка и рука в кадре, шины;
- робот через настоящий Spine (`test_robot.py`): ходьба, поворот, рефлекс края, «подняли», заряд только под пластинами, калибровка носом к предмету;
- поведение с нормами (`test_behave.py`): домой при свете и в темноте, станция сзади, осмотр, рука, рука за краем, подняли.

**Найдено тестами и исправлено (02.11.2026):**
- В модели привод локтя весил 0,0001 кг вместо 20 г, а привод подъёма плеча сидел в качающемся звене, хотя по CAD он на поворотном кронштейне. Клешни были легче на 20 г каждая. Теперь модель весит 896 г против 893 г в CAD.
- Замер поворота давал обратный знак: за 4 с при 45°/с курс проходит 180° и перескакивает через ±180°. Теперь угол копится по шагам.

Related: [[Компакт мини]] · [[код/симуляция/Симуляция|Симуляция]]
