iamharveststorm/harvey/Харви.md

# Харви — главная

Настольный робот-краб: шесть ног, две клешни, хвост с присоской, глаза-стебельки с дисплеями. Версия корпуса «Компакт», компоновка v2.

**Сейчас:** этап 1 — покупки и стенд одной ноги → [[Этап 1 — покупки и стенд одной ноги]]

**Версии:** «Компакт» (ветка `kompakt`, метка `v2-kompakt`) и «Компакт мини» (ветка `kompakt-mini`) — [[Версии Харви]]. Для мини всё на стенд ноги заказано (17.10.2026), детали приезжают 19–31 октября → [[Чек-лист стенда мини]].

![[Харви_открытый_1.png]]

Все рендеры, компоновка и чертежи — [[Галерея]].

## Заметки

1. [[Концепция]] — идея, характер, форма, железо
2. [[Комплектация и бюджет v0.2]] — что покупать и сколько стоит
3. [[Питание и проводка]] — батарея, токи, схема, защита
4. [[Проверка совместимости и сценарии]] — что проверили симуляция и модели деталей (компоновка v2 — 0 столкновений)
5. [[Сборка в Onshape и физическая проверка]] — CAD-модель и настройки печати
6. [[Этап 1 — покупки и стенд одной ноги]] — список покупок и протокол стенда
7. [[Журнал решений]] — что и почему решили
8. [[Галерея]] — все картинки проекта
9. [[Версии Харви]] — «Компакт» и «Компакт мини»: чем отличаются и как вернуться к каждой

### «Компакт мини»

1. [[Компакт мини]] — маленькая версия: 28 приводов STS3032, Pi Zero 2 W, без хвоста; размеры, масса, проверки
2. [[Комплектация мини]] — полный список для сборки и печати, смета по реальным ценам (≈ 116–161 тыс. ₽)
3. [[Чек-лист стенда мини]] — всё для стенда ноги по пунктам: что заказано, где и за сколько
4. [[схемы/README|Схемы мини]] — 5 листов: питание и логика, шины приводов с ID, Pi Zero (камера, глаза, звук, кнопки), датчики RP2350, интерфейс шины; токи, сечения, карты выводов

## Робот целиком (компоновка v2)

![[компоновка_вид_сверху.png]]

- [[модели/корпус/README|Корпус и компоновка]] — открытая рама из 14 деталей, где что стоит, **правила движения** для прошивки
- [[модели/клешни/README|Клешни]] — две клешни по 5 суставов, плечи впереди передних ног
- [[модели/хвост/README|Хвост]] — третья рука с присоской
- [[модели/глаза/README|Глаза]] — стебельки на передних углах, дисплеи GC9A01 на магнитной муфте
- [[модели/рендер/README|Рендеры]] — Харви на рабочем столе, открытый и мягкий варианты

## Визуализация (открывается в браузере)

Все собраны из настоящих деталей CAD:

- [3D-модель](<визуализация/3D-модель.html>) — **только «Компакт»**: вращать, стойка, клешни, хвост, мягкий кожух
- [Интерактивный двойник](<визуализация/Интерактивный двойник.html>) — **«Компакт»**: поза, досягаемость, камера, центр масс, столкновения
- [Двойник мини](<визуализация/Двойник мини.html>) — **«Компакт мини»**: поза, клешни по углам приводов с правилами движения, глаза (правило 2), камера (что закрывают клешни, видно ли лицо), 6 датчиков края, опора, момент бедра. Переключатель версий — вверху панели обоих двойников

## Этап 1 — стенды

- [[модели/стенд ноги/README|Стенд ноги]] — 7 STL в `модели/стенд ноги/stl/` (⚠ 15.10: перепечатать 4 детали — см. README)
- [[модели/стенд кисти/README|Стенд кисти]] — 6 STL под STS3032-C036
- [[модели/чертежи/README|Чертежи по ГОСТ]] — рычаг 100 мм и ладонь кисти (PDF, STEP, FreeCAD)
- [[harvey-stage1-parts.pdf]] — описание деталей, настройки печати, порядок сборки

Все модели — [[Модели]].

## Код

- [[Симуляция]] — MuJoCo, сценарии, управление с клавиатуры (`run_windows.bat`)
- [[код/стенд привода/README|Программа стенда]] — «Компакт»: замеры STS3215 (`run_bench_windows.bat`); мини: STS3032 и нога целиком (`run_bench_mini_windows.bat`), есть имитация без железа
- [[Прошивка]] — [[код/прошивка/pico/README|Pico 2: шина приводов]] (замер 12), MicroPython и Thonny уже установлены
- [[код/симуляция/мини/README|Симуляция мини]] — управление с клавиатуры, ручки и карандаш, вид глазами Харви
- [[модели/мини/README|Детали мини]] — CAD, STL, станция зарядки, стенд ноги

## Документы и фото

- [[Документы]] — даташиты приводов, плат, протокол шины
- [[Фото]] — эскизы, референсы, фото стенда (клади сюда)

Для Claude: [[CLAUDE]] — короткий контекст проекта.
