iamharveststorm/harvey/заметки/Журнал решений.md

# Журнал решений

| Дата | Решение | Почему |
| --- | --- | --- |
| 2026-10-09 | Версия «Компакт» вместо ~30 × 38 см | исходный габарит слишком большой для стола |
| 2026-10-09 | Шесть ног + две многосуставные клешни | устойчивость, лазание, работа с предметами |
| 2026-10-09 | Закупка поэтапно, сначала стенд одной ноги | проверить STS3215 до заказа ~20 приводов |
| 2026-10-10 | Скрипты симуляции — в `код/симуляция/управление с клавиатуры/`, окружение Python — в `C:\venvs\harvey` | порядок в папке проекта; OneDrive не синхронизирует ~9000 файлов окружения |
| 2026-10-14 | Программа стенда привода — в `код/стенд привода/`, окружение — в `C:\venvs\harvey-bench` | работает на ноутбуке, а не на Pico/Pi, поэтому не в `прошивка/`; окружение вне OneDrive |
| 2026-10-14 | Главная заметка `Харви.md`, детали стенда в `модели/стенд ноги/`, даташиты в `документы/` | весь проект доступен из Obsidian, граф связей связный |
| 2026-10-14 | Заводской даташит STS3215-C018 в `документы/`; числа проекта сверены с ним | все паспортные значения совпали; учтена встроенная защита привода (2 А / 2 с) |
| 2026-10-14 | Заводской [[STS3032-C036 — даташит Feetech (6 В).pdf|даташит STS3032-C036]] в `документы/` | электрика совпала с расчётами (4,5 кг·см, 1,2 А); найдено: разъём 1,25 мм вместо 5264 — нужны переходники; корпус C036 32 × 12 × 27,5 мм, а в CAD заложен 23,2 × 12,1 × 28,5 |
| 2026-10-14 | Кисть стенда — под STS3032-C036, модели в `модели/стенд кисти/` | под C036 есть заводской чертёж; размер в заметке Onshape исправлен; захват: верхний палец подвижный, нижний неподвижный |
| 2026-10-14 | Чертежи — FreeCAD 1.1 (ГОСТ, скриптом из параметров STL), рендеры — Blender 5.2 (Cycles) | обе программы бесплатные; чертёж и деталь из одних чисел, объёмы сверяются автоматически |
| 2026-10-14 | Ладонь на качалке запястья — 3 винта вместо 4; в проверку кисти добавлен доступ к винтам | 4-е место закрывала стенка, головки двух других упирались в рёбра — нашлось при выпуске чертежа |
| 2026-10-15 | Стойка ноги для стенда — печатная (`harvey_leg_tower`): держит заднюю часть привода основания, фланец на 110,6 мм над столом, колонна позади ноги | готовой стойки не было (держатель `cradle_servo` — только для одного привода с рычагом); проверено: поворот ±60° во всех позах без задеваний |
| 2026-10-15 | Датчиков края 6: 2 вперёд (между клешнями), 2 назад, по 1 в стороны | край виден в любую сторону движения; распиновка уже была на 6 (XSHUT GP14–GP19, адреса 0x30–0x35), в «Комплектации» ошибочно стояло 4 |
| 2026-10-15 | Датчики края — VL53L4CD вместо VL6180X, луч 2,3 : 1 (~23,5° вниз), порог 150 мм | с широкой стойкой (бедро 51) запас у края в худшем случае стал −10 мм; более пологий луч смотрит дальше, но ему нужно ~112 мм — больше паспортных 100 мм VL6180X; с VL53L4CD запас в симуляции 14–51 мм во всех сценариях; проверить на реальных поверхностях на этапе «голова» |
| 2026-10-15 | Нога: бедро 51 мм вместо 45; новый кронштейн основания (одна стенка, обхват задней половины привода бедра); обхват колена без задней стенки; приводы держат удлинённые винты корпуса; перепечатать 4 детали | в первой версии привод колена упирался в привод бедра и в кронштейн при любом угле бедра — ногу было не собрать; полная проверка leg_check.py; симуляция: ходьба легче (пик колена 1,87 вместо 2,40 Н·м) |
| 2026-10-15 | Пределы ноги: поворот ±60°, колено −130…+30°; покой — «на корточках» (стопы на месте, колено −125°) | старая поза покоя требовала колено −154°, конструкция складывается только до −130° |
| 2026-10-15 | Поза клешней «поджато» на 10 мм выше | в позе покоя кончики клешней задевали стол |
| 2026-10-15 | Клешни спроектированы целиком (`модели/клешни/`): плечо 54 мм вместо 45, кисть ≈ 43 мм вместо 35; J2 повёрнут на 45° назад-вниз; корпуса STS3215 держатся длинными винтами корпуса; диск поворота лежит на опорном кольце | при 45 мм два корпуса STS3215 не помещаются; симуляция пересчитана — моменты в норме (локоть 2,37 из 2,94 Н·м), телефон и ручка ложатся на спину; три точки вплотную к плечу заменены |
| 2026-10-15 | Пределы суставов клешни: подъём −45…+140°, локоть −105…+130°, захват 0…60° | ходы без столкновений по проверке модели |
| 2026-10-14 | Камера — только наклон (1 × STS3032), без поворота | влево-вправо Харви поворачивается корпусом, объектив Wide видит почти весь стол; шлейф камеры гнётся в одной оси — надёжнее, дешевле и легче |
| 2026-10-15 | **Компоновка v2**: плечи клешней — в (105; ±30; 65) мм, впереди передних ног; привод подъёма клешни — почти вниз (β = −100° вместо −135°) | при старых плечах (85; ±50) поворотная стойка клешни (выступала назад на 37 мм) пересекалась с кронштейном и приводом передней ноги во всех позах; с β = −100° стойка — компактная колонна (23 мм назад), подъём стал −15…+175° (для стола хватает −5° — пальцы отогнуты); ноги не двигали — их походка уже проверена |
| 2026-10-15 | Глаза-стебельки — на передних углах (ось в (70; ±80; 76) мм), привод вдоль корпуса: глаз наклоняется вбок (эмоции) и складывается наружу до −75° | клешня переносит предметы через голову на спину в полосе 8…52 мм от средней линии — глаза между клешнями мешали бы при любом наклоне; правило: пока своя клешня поднята (≥ 60°), глаз отклонён наружу на 20° |
| 2026-10-15 | Хвост спроектирован целиком (`модели/хвост/`): привод подъёма вертикально (β = −90°), предплечье-вилка снаружи пластин плеча, присоска крутится внутри вилки; ходы: подъём −40…+180°, локоть −130…+155°, запястье полный оборот; со стола сзади — «локоть вверх»; поза покоя — присоска на 95 мм над центром | с горизонтальным приводом стойка нависала над подносом; все пути хвоста из симуляции проверены на модели без столкновений; переворот со спины теперь проходит и с хвостом вбок на 60° |
| 2026-10-15 | Корпус — открытая рама из 14 печатных деталей ≈ 180 г (`модели/корпус/`): днище, кольцо с обхватами приводов ног, передняя палуба (основания клешней), узел хвоста, поднос 87 × 105 мм, держатели глаз, кронштейн камеры, 6 кронштейнов датчиков края | поднос укорочен сзади (было 120 × 105): там колонна поворота хвоста; Pi 5 + AI HAT+ стоит ребром в центральном канале, три банки 21700 — раздельно (две по бокам внизу, одна под передней палубой); проверка: рама и электроника × все конечности во всех рабочих позах — 0 столкновений |
| 2026-10-15 | Правила движения (`модели/корпус/harvey_layout.py`, `RULES`) — обязательны для прошивки | при них конечности не задевают друг друга и раму: клешни в низких позах ±15°, наружу до 75° — с поднятой рукой; хвост к столу — только назад ±30° и стоя, вбок до ±100° — поднятым на 20°; бедро передних ног не выше 90° |
| 2026-10-15 | Датчики края: вперёд — (127; ±12), назад — (−104; ±14), в стороны — (−28; ±52) мм, между средней и задней ногой | вынесены вперёд под клешни: стопы останавливаются в 108–146 мм от края стола (было 14–51); боковой луч раньше шёл вдоль средней ноги; порог дальности в ручном управлении — 0,3 м (дальний датчик при наклоне корпуса видит стол дальше 0,2 м) |
| 2026-10-15 | Симуляция под компоновку v2: кисть с отогнутыми пальцами (кончик 41,6 мм вперёд и 17,5 мм вниз от оси запястья), впереди плеча — решение «локоть вверх», «поджато» — (143; ±30; −24) | без этого точки симуляции требовали невозможных углов (локоть −116° при пределе −105°), а тест захвата промахивался мимо ручки |
| 2026-10-15 | Мягкий скруглённый кожух — вариант для рендеров (графитовый панцирь, крышка вместо подноса); основной — открытая рама | рендер в двух вариантах; кожух тоже проверен на совместимость — 0 столкновений |
| 2026-10-15 | Мир симуляции для управления: комната, рабочий стол (старт) с реквизитом, доска-спуск 20°, полоса препятствий (трава, песок, гравий, галька, склоны 10–25°, косой склон, ступени, асфальт); Харви нарисован деталями из CAD; клешнями можно управлять вручную и брать предметы | реалистичная проверка управления и походки; физика робота прежняя (простые формы), детали только рисуются; захват держит предмет, если сжатые пальцы касаются его обеими накладками |
| 2026-10-15 | В симуляции бедро и голень сталкиваются с миром и предметами (раньше — только стопа) | ноги проходили сквозь книги и препятствия и застревали в них; между собой и с корпусом звенья ног не сталкиваются — как в CAD-проверке |
| 2026-10-15 | Рефлекс глаз при опрокидывании — до упора наружу, −105° (при ходьбе — не дальше −75°) | на −75° Харви лежал на спине на дисплеях (12 Н), на −105° — на арке хвоста (0 Н); через нос — 0 Н; вбок глаз сложить не успеть (падение 0,1–0,2 с, привод 0,35–0,9 с) — защищают магнитная муфта и бампер TPU |
| 2026-10-16 | Адаптивная походка (`harvey_gait.py`) — основная, пойдёт в прошивку Pico 2: корпус ровно по IMU, поиск опоры каждой ногой (касание — по нагрузке привода колена), шаг выше и медленнее на неровном | средний наклон корпуса на склонах 5–9° → 0,3–3,6°, на 25° путь 239 → 338 мм, на косом склоне 15° идёт вперёд вместо сползания |
| 2026-10-16 | Физика веществ в симуляции (`harvey_terrain.py`): песок продавливается (несущая способность растёт с глубиной, валики вокруг следов, осыпание круче 33°), гравий и галька — отдельные камни, трава — стебли с сопротивлением | проверка походки на настоящем рыхлом грунте и россыпи вместо жёстких «рельефных» поверхностей; стоя проседание 6–9 мм; MuJoCo ≥ 3.15 (режим сна для камней) |
| 2026-10-16 | Режим «фото»: рендер Filament (PBR, мягкие тени) с той же панелью; физика — в отдельном процессе | фотореалистичная картинка в реальном времени (~27 к/с); в одном процессе Filament и поток физики иногда роняли программу |
| 2026-10-16 | Новая версия «Компакт мини» (ветка `kompakt-mini`): все приводы STS3032, ноги 3 сустава, 2 клешни по 4 сустава, подвижные глаза с дисплеями ~0,71″, без хвоста, Pi Zero 2 W на борту | цель — удобный настольный робот для салфетки и ручки; первая симуляция: ходьба 6,2 см/с, ручку берёт и подаёт, нагрузка бедра ~70 % номинала при ходьбе |
| 2026-10-16 | Мини — CAD целиком (`модели/мини/`): 14 печатных деталей + станция, масса 889 г; плечи клешней (57; ±32; 38,5) над крышкой, привод плеча корпусом к центру, передние ноги на 52°, камера в передней стенке; правила движения клешней по кинематике | 0 столкновений во всех разрешённых позах; при 45° передняя нога задевала опущенную клешню, камера на крышке — кронштейн плеча при повороте |
| 2026-10-16 | Мини: зарядка — пластины 40 × 12 мм на брюхе, станция 64 × 56 × 4 мм между кронштейнами ног, pogo-контакты, метка AprilTag и ИК-маяк на башенке в 140 мм впереди | лёжа (корпус ниже на 13 мм) контакты поджаты на 1,3 мм; ниже нельзя — кронштейны ног висят под корпусом; в симуляции зашёл и замкнул оба контакта |
| 2026-10-16 | Мини: протирка — салфетка прижата губками, рука ходит вперёд-назад, полосы — разворотом корпуса | поворотом плеча вбок низко нельзя (передняя нога); в симуляции салфетка идёт за рукой |
| 2026-10-16 | Рендеры на столе — строго 1 : 1: предметы в реальных размерах, лежат друг на друге без пересечений; напольный цветок убран, лампа без уменьшения | на сжатых предметах робот казался другого размера; проверка в скрипте нашла утопленную в стол кружку и карандаши внутри робота |
| 2026-10-16 | Мини: DC-DC 6 В реального размера (17 × 23 мм, ≥ 6 А) между гнёздами плеч, стойки крышки под латунные вставки M2, 4 винта M2 снизу в каждый привод ноги, стенд одной ноги для первых тестов | при подсчёте крепежа: у крышки не было стоек, модуль DC-DC на 6 А был нарисован 9 × 17 мм; масса 893 г |
| 2026-10-16 | Рендеры «Компакта» перерендерены в масштабе 1 : 1; робот ставится на стол по нижней точке | «Компакт» висел на 6,5 мм над столом (корпус ставился на фиксированную высоту), кружка была утоплена в стол, лампа и цветок уменьшены |
| 2026-10-16 | Мини: управление с клавиатуры (`harvey_mini_teleop.py`): физика MuJoCo в своём процессе, картинка Filament PBR на столе 1 : 1, станция и модель батареи; боковые датчики края — луч 3,5 : 1 (~16°) | MuJoCo точнее игровых движков для мелких приводов, Filament даёт PBR без смены физики; с лучом 2,3 : 1 средняя стопа останавливалась в 12 мм от края, с 3,5 : 1 — в 37 мм |
| 2026-10-16 | Мини, симуляция: ручки и карандаш по настоящим (форма, масса, центр тяжести, трение пластика, дерева и TPU); губки — по пределу момента, пока зажата клавиша; трение без «ползучести» (эллиптический конус, noslip) | для честной проверки захвата: с упрощёнными капсулами и трением 0,8 захват выглядел проще, чем будет в жизни; найден настоящий эффект — длинный предмет под брюхом выскакивает при подъёме, Харви теперь сначала отступает |
| 2026-10-16 | Мини: камера неподвижна, обзор — поворотом и наклоном корпуса ногами (±12°); поза «поджато» (8°; 50°; −130°) вместо (0°; 15°; −115°) | привод наклона камеры не ставим (места между плечами нет, +20 г); в прежней позе кисти закрывали 48 % кадра камеры и центр, в новой — 18 %, центр свободен, глаза человеку видны, столкновений нет |
| 2026-10-16 | Смета мини — по реальной цене STS3032-C036 ([[STS3032-C036 — даташит Feetech (6 В).pdf|даташит STS3032-C036]]): 3 280 ₽ (Feetech Official Store, AliExpress), 4 170 ₽ (Ozon); весь мини ≈ 116–161 тыс. ₽ вместо 48–111 | первая оценка 1 000–2 500 ₽ за привод была занижена втрое; приводы — больше 4/5 бюджета, перед заказом 26 шт. спросить оптовую цену |
| 2026-10-16 | Детали стенда ноги мини печатать после того, как приедут приводы и измерены `horn_top` и `shaft_from_end` | этих размеров нет на чертеже; ошибка в 1 мм — кронштейн не сядет, диск не совпадёт с качалкой |
| 2026-10-17 | Стенд мини: программа стенда работает и с STS3032 (6 В, нормы из [[STS3032-C036 — даташит Feetech (6 В).pdf|даташит STS3032-C036]]), добавлена нога целиком — калибровка нуля записью «середины» в привод, позы, стойка на весах, момент бедра, шаг 10 мин, оценка батареи; прошивка Pico 2 для шины (замер 12) | у STS3032 нет датчика тока (даташит) — ток по нагрузке и по блоку питания; поза сборки «Г» на стенде даёт стопу ниже стола — калибровка у края стола; всё проверено на имитации до прихода деталей |
| 2026-10-25 | Двойник «Компакт мини» в браузере (визуализация/Двойник мини.html, сетки — модели/рендер/export_web_mini.py); 3D-модель и прежний двойник помечены «только „Компакт“»; заметки стенда мини ссылаются на даташиты | разбор графа знаний: визуализация была связана только с «Компактом», стенд мини не ссылался на даташит, из которого взяты его нормы |
| 2026-10-25 | Граф graphify — карта проекта: в CLAUDE.md правило «сначала граф, потом файлы»; git-хуки graphify обновляют код в графе после каждого коммита и смены ветки | меньше перечитывания файлов в новых сессиях; код в графе обновляется бесплатно (без LLM), заметки — вручную `/graphify --update` |
| 2026-10-25 | Схемы мини в коде: проводка (WireViz), шины с ID = 10 × конечность + сустав, интерфейс шины по схеме Feetech (schemdraw) — `схемы/` | при рисовании нашлись ошибки списка: pogo нужны на 3–5 А (заряд до 3 А), выключатель ≥ 10 А, провод 22 AWG для отводов, станция 5 В (не 12 В); разъём 1,25 мм (~1 А) у первого привода конечности проверить на нагрев на стенде |
| 2026-10-25 | Схемы мини: листы Pi Zero 2 W (камера, глаза по SPI, звук по I2S, кнопки) и датчиков RP2350; назначение выводов обоих — предварительное | у RP2350-Zero заняты 20 выводов из 20 → кнопки касания на Pi Zero, на RP2350 — прерывания BMI270 и INA226, 2 вывода в резерве; глаза — 8 проводов 30 AWG через стебелёк, SPI ≤ 32 МГц; 3,3 В Pi нагружено ~0,35 А — следить за мерцанием глаз |
| 2026-10-25 | Правило работы с даташитами в CLAUDE.md: числа по железу — только из `документы/` с источником, непроверенное помечать; копия проекта — закрытый репозиторий на GitHub | совет из разбора инструментов: не придумывать распиновку и токи; вторая копия проекта вне компьютера и OneDrive, с полной историей |
| 2026-10-25 | Репозиторий https://github.com/iamharveststorm/harvey открыт для всех | решение автора: проект можно показывать и читать без приглашения |
| 2026-10-31 | Качество кода: скил ub-mode (unclebob) в `.claude/skills/`, плагин superpowers для проекта, инструменты crapper / dryer / mutator в `C:\venvs\harvey-quality`; правило в CLAUDE.md | решение автора: код стенда и прошивки — с тестом до правки, без сложных функций (CRAP < 10) и дублей; первый замер стенда: самая сложная функция `bench.main` — 38 ветвлений |
| 2026-10-31 | crapper / mutator доведены для стенда: покрытие считает `check_quality.bat` в окружении стенда, в локальной копии mutator исправлена остановка зависшего мутанта на Windows (`taskkill /T` вместо `os.killpg`) | без этого crapper на Windows показывал 0 %, а mutator падал на первом зацикленном мутанте. Первые цифры стенда: покрытие 28 % (тесты есть только у шины `sts.py`), 28 из 95 функций с CRAP ≥ 10, дублей нет; мутанты `sts.py`: убито 46 из 68 (67,6 %), выжили 22 — больше всего в разборе ответа `parse_status` (5), `Servo.move` и `Servo.set_id` (по 4) |
| 2026-11-02 | Программа стенда: тесты ноги и меню (80 тестов, ≈ 25 с), `bench.main` разбит на `parse_args`, `open_bench`, `compact_actions` / `mini_actions`, `run_menu`, `release`; траектория шага вынесена в чистую `step_pose` | до приезда приводов отлаживать программу, а не железо. Было → стало: покрытие 28 → 89 % (`leg.py` 22 → 99 %), CRAP `main` 1482 → 5, функций с CRAP ≥ 10 — 28 → 12; мутанты `leg.py` пойманы на 76 %. Во второй правке mutator (запись мутанта байтами) — без неё на Windows файлы с CRLF давали ложные 100 % |
| 2026-11-02 | `stance_scale` и `gait` разбиты: нормы и разбор ввода — чистые функции (`parse_grams`, `stance_ok`, `abort_reason`, `gait_ok`), шаги с приводами — отдельные методы | CRAP 24 → 6 и 17 → 5. Все проверки: 102 теста стенда, прошивка Pico на ПК, CAD ноги и путей хвоста — проходят; покрытие стенда 90 %; мутанты: `leg.py` 76,6 %, `sts.py` 63,8 %, `bench.py` 24,5 % — замеры одного привода (`heat_test`, `speed_test`, `current_test`) тестами почти не проверяются |
| 2026-11-02 | Тесты замеров одного привода (`tests/test_bench.py`, 58 тестов): калибровка тока, проверка напряжения и температуры, связь и номер, ток покоя и упора, момент, скорость, люфт, точность, нагрев, размеры, отчёт — с точными числами и границами норм | замеры STS3215 и STS3032 проверялись только на попадание в отчёт. Итог: 160 тестов, покрытие стенда 93 % (`bench.py` 85 → 96 %), мутанты `bench.py` 24,5 → 65,4 %; функций с CRAP ≥ 10 — 8 из 116 (сложнее всех `heat_test` — 16) |
| 2026-11-02 | `heat_test` разбит: нормы — чистые `heat_abort` (70 °C, ток > 2,2 А дольше 5 с) и `heat_ok`, цикл — `_heat_run`, нагрузка имитации — `_sim_load` | CRAP 16 → 5; 174 теста; функций с CRAP ≥ 10 — 7 из 120; мутанты кода нагрева пойманы на 72 % (нормы — 100 %) |
| 2026-11-02 | Прошивка RP2350 «спинной мозг» (`код/прошивка/rp2350`): VL53L4CD × 6, BMI270, INA226, маяк, протокол с Pi, рефлексы (край, подняли, падение, батарея, станция) | регистры и тайминги — из скачанных даташитов (документы/), VL53L4CD — по драйверу Adafruit (порт ULD), файл BMI270 — Bosch API; 138 тестов против имитаций по даташитам, мутанты 87–100 % |
| 2026-11-02 | Программа головы Pi Zero 2 W (`код/голова`): глаза на GC9D01 (10 выражений, моргание, взгляд), настроение, касания, звук, связь с RP2350 и ПК | характер — добрый, без ПК голова живёт сама; 83 теста, эталонные картинки глаз; найдено и исправлено: взгляд правого глаза зеркалился (глаза смотрели врозь) |
| 2026-11-02 | Симуляция мини: 69 тестов (кинематика против MuJoCo, правила, сценарии с нормами, клавиши); исправлено: масса привода локтя в модели 0,0001 кг вместо 0,020 и привод подъёма плеча не в том звене — клешни были легче на 20 г; замер поворота давал обратный знак (переход курса через ±180°) | после правки: модель 896 г против 893 г в CAD; вытянутые вперёд клешни — 96 % упора привода подъёма (было 93 %): держать так долго нельзя |
| 2026-11-02 | Станция: маяк на NE556 (пачки 1,40 / 0,57 мс, несущая 38 кГц), PTC 3 А, отсек электроники в башенке с крышкой; на корпусе робота — 2 × TSOP38238 по бокам камеры, развёрнуты на ±30° | TSOP382 подавляет непрерывную несущую — нужны пачки (≥ 10 периодов, пауза ≥ 12); проверка `check_beacon`: со 100–300 мм прямо — видят оба, сдвиг 40 мм — один (куда довернуть), у самой станции — никто (там ведут метка и ток заряда) |
| 2026-11-02 | `calibrate` и `femur_torque` разбиты: чистые `middle_offset`, `direction`, `torque_nm`, `stall_current`; методы `_write_middle`, `_ask_direction`, `_sim_table`, `_press_femur`, `_torque_report` | CRAP 11 → 3 и 12 → 7; 194 теста; функций с CRAP ≥ 10 — 5 из 129 (остались `_txrx` — только на стенде, `FakeServo.step` — имитация, `scan`, `current_test`, `report.write` — по 10); чистые функции — 100 % мутантов, ещё 3 теста по выжившим: бедро отпущено после замера, подъём на 3° после упора, ход 10° от настоящей «Г» при несписанной середине |
| 2026-11-02 | `scan` и `current_test` разбиты (`model_label`, `scan_note`, `scaled_lsb`, `_model`, `_idle_current`, `_stall_current`, `_sim_block`, общий `_save_lsb`); исправлены 2 ошибки: `scan` падал, если привод не ответил на чтение модели (второе чтение без защиты), а ток в упоре STS3215 перезаписывал `bench_calibration.json` целиком и стирал калибровку мини | CRAP обеих 10 → 4; 208 тестов, покрытие 94 %; функций с CRAP ≥ 10 — 3 из 137 (`_txrx` — только на стенде, `FakeServo.step` — имитация, `report.write` — 10) |
| 2026-11-03 | Мини: поведение по своим датчикам в симуляции — настоящая прошивка RP2350 с имитациями датчиков (`mini_sensors.py`, `mini_robot.py`), поведение — в голове (`harvey_head/behavior.py`): осмотреться, к руке, у края, подняли, домой | чтобы прошивка и поведение проверялись вместе до железа; нормы — в `tests/test_behave.py` |
| 2026-11-03 | Домой — по метке AprilTag (выйти на ось в 25 см, прямо с поправками по метке), ИК-маяк — запасной путь | в симуляции один светодиод даёт только направление: сбоку Харви приходит по диагонали и промахивается мимо пластин (допуск вбок ±3,5 мм). По метке — 10 стартов из 10, вбок 0–1 мм. Маяку без камеры нужны два светодиода с разными пачками или пластины шире — решить позже |
| 2026-11-03 | В телеметрии RP2350 — вращение `gyr` (°/с); повороты поведения — на угол по гироскопу | по времени поворот ошибался на 20°: корпус разгоняется и тормозит с запаздыванием |
| 2026-11-03 | Калибровка датчиков края — только замеры в ±15 мм от расчётного (`pins.EDGE_NOMINAL_MM` = 72 / 104 мм), иначе расчётное | включённый носом к предмету Харви запоминал предмет как стол, и потом стол казался краем |
| 2026-11-03 | Над контактами Харви останавливается по передним датчикам края: площадка, снова стол, башенка — и отступ на 17 мм | стопы шире площадки и на неё не наступают; наклон по IMU станцию не замечает |
| 2026-11-03 | **Исправлено:** метка AprilTag даёт Харви только направление и расстояние до станции, а не позу; запись выше «домой — по метке, 10 из 10» устарела | на синтетических кадрах поворот Харви на 2° неотличим от сдвига вбок на 13 мм: метка 30 мм в 30 см почти не искажается в перспективе. Заглушка «зрения» в симуляции давала точную позу — так не будет |
| 2026-11-03 | Маяк станции — два ИК-светодиода TSAL6200 (в 3,5 мм от оси, высота 12 мм) с перегородкой 42,5 × 31 × 1,5 мм между ними; пачки по очереди: левый 0,6 мс, правый 1,2 мс; вместо NE556 — RP2350-Zero и ключи AO3400A | оба светодиода видны только в клине вдоль оси (у контактов ~±1 мм) — это ось станции без ПК и в темноте. Пачки разной длины TSOP382 передаёт с точностью ±132 мкс (стр. 3); нарезать их по очереди проще программой, плата та же, что у Харви |
| 2026-11-03 | На Харви третий TSOP38238 — по центру под объективом, на GP28 (был резерв) | по нему видно, по какую сторону оси станции корпус; боковые приёмники развёрнуты на ±30° и для этого не годятся |
| 2026-11-03 | Башенка станции 67 мм (было 52), окно метки z 33–63 мм — над перегородкой | камера на оси видела бы перегородку ребром поперёк метки |
| 2026-11-03 | Домой без ПК: повернуться к станции → выйти на ось по клину (проход вбок туда и обратно) → снова повернуться → прямо по гироскопу с поправкой вбок 5 мм/с. В симуляции: при свете 10 из 10, в темноте 8 из 10, промах вбок ≤ 3 мм | корпус догоняет команду шага с запаздыванием ~0,3 с — края клина усредняются по двум проходам; приёмник в 71 мм перед центром — важен курс, а не доворот на метку |
| 2026-11-03 | Направление на маяк — по самому заметному светодиоду на каждом боковом приёмнике, а не по сумме | приёмник, видящий оба светодиода, «перевешивал»: сектор «прямо» сужался до 8° и смещался |
| 2026-11-04 | Походка — на голове (`harvey_head/gait.py`: трипод, обратная задача ног, «лечь»), номера приводов — `servos.py`, тело — `body.py` (поведение + походка → `j` 50 раз в секунду, `cal` через 1,5 с), камера — `camera.py`; размеры ног — `mini_geometry.json` из CAD (`export_head`) | без походки на голове робот не шагнёт; симуляция берёт ту же походку и ведёт робота настоящей головой (Head + Body), так её сценарии проверяют код, который поедет на Pi |
| 2026-11-04 | Домой в темноте: на проходе клина гироскоп держит курс против увода; повтор после «не замкнулось» — сразу на ось, без поиска; проход сектора маяка — 30 °/с (было 20). Итог в симуляции с настоящей головой: при свете 10 из 10 (14–36 с), в темноте 10 из 10 (35–90 с), промах вбок ≤ 3 мм | раньше не доходили старты под 45° и 35° от оси; повторные проходы клина пробовал — не сходятся: середина клина в физике находится с точностью ±5–8 мм, а круг стоит 20 с |
| 2026-11-04 | Стенд без приводов на Pico 2 H: `selftest.py` на плате (петли UART0/UART1/PIO, поток PIO 1 Мбит/с, маяк через «TSOP» на GP16, I2C, время цикла) и `bench_pc.py` на ПК (копирование через mpremote, отчёт, проверка связи по USB) | Pico 2 H — тот же RP2350: прошивку «спинного мозга» можно проверить на железе до приводов. Поток PIO — отдельно: очередь приёма 4 байта, ответ привода ~20 байт подряд |
| 2026-11-04 | Калибровка нулей приводов: подставка `calib_jig` (поза A: ноги 0 / 0 / −90°, клешни 0 / 0 / −90° — предплечье вниз, губки на столбике; подставка 195 × 216 мм, на стол принтера 220 × 220; с вытянутыми клешнями было бы 287 мм) + сдвиг каждого сустава рукой (поза B) → ноль и направление в `servo_calib.json`; запрос RP2350 `pos?` (регистр 56) | без неё голова считает нули 2048 и направления как в симуляции — при сборке так не бывает. Проверка хода через край 0/4095 подсказывает переставить качалку на шлиц |
| 2026-11-02 | `report.write` разбит (`verdict_fill`, `_results_sheet`, `_log_sheet`); тесты читают сам `.xlsx` (`tests/test_report.py`) | раньше Excel-отчёт не проверял никто — только JSON. Итог программы стенда: 219 тестов (≈ 30 с), покрытие 94 %, функций с CRAP ≥ 10 — 2 из 140: `_txrx` (обмен с адаптером — проверить можно только на стенде с FE-URT-1) и `FakeServo.step` (физика имитации, не программа стенда); мутанты `report.py` — 100 % |
| 2026-11-04 | «Большой мозг» на ПК — `код/мозг/harvey_brain` (stdlib): слово «Харви» ищется в распознанном тексте, быстрые команды без LLM, остальное — Ollama (ответ JSON по схеме, `think: false`), голове — TCP-сервер :8765 тем же форматом, что RP2350. Модель по умолчанию `qwen3.6:35b` (тёплый ответ ~2,3 с, `dolphin3:8b` ~0,9 с) | не ждать железа и загрузок: вся логика проверена в текстовом режиме; голос (sherpa-onnx) — этап B после разрешения на загрузки |
| 2026-11-04 | Голос «большого мозга» (этап B): Silero VAD -> GigaAM v2 CTC -> Piper ru_RU через sherpa-onnx, полудуплекс (слух выключен, пока говорит Харви, +0,4 с). Модели вне репозитория, в `~/.harvey/models` (`--models` / `HARVEY_MODELS`, `get_models.py`); sherpa-onnx закреплён на 1.13.8; имя «Харви» ищется по звучанию (ключ KARVI: карви, корве, харбе, фарви…), а не по списку написаний | espeak-ng в Windows не открывает кириллические пути, а репозиторий лежит в «Документы»; Windows-колесо sherpa-onnx 2.0.1 без рабочего Piper/espeak; GigaAM слышит «Харви» как «карви» в ~половине синтезированных проб, а команда после слова распознаётся всегда |
| 2026-11-05 | Готовая установка головы на Pi Zero 2 W (`код/голова/setup/`): `deploy.py` с ПК копирует голову по ssh (tar, та же раскладка папок), `provision.py` на Pi — пакеты, venv, блок Харви в `config.txt` (в конец `[all]`, с копией), служба `harvey-head`, `check.py` — проверка железа и связи; адрес ПК, порт RP2350 и устройство ALSA — из `HARVEY_*` (`/etc/harvey/head.env`) | пользователю остаётся записать карту в Raspberry Pi Imager и запустить две команды; пароли и Wi-Fi скрипты не трогают. Оверлей `googlevoicehat-soundcard`, имя карты ALSA и порт RP2350 — предварительно, проверить на стенде |
| 2026-11-05 | «Мозг ведёт Харви в симуляции»: `код/симуляция/мини/mini_brain.py` (+ `run_brain_sim.bat`) - голова в симуляции связана с настоящим мозгом (`harvey_brain`, TCP :8765) через `BrainLink` в отдельном потоке; мозг запускается в своём окне консоли (`--with-brain`); цикл в реальном времени, без мозга Харви работает сам и раз в 5 с пробует подключиться | проверить всю цепочку мозг -> голова -> RP2350 -> робот до железа, без правок головы, прошивки и мозга; рука в сцене - неподвижная, видна со старта и не мешает заходу домой |
| 2026-11-05 | Помощник в «большом мозге» без LLM: время и дата, таймеры, напоминания («через полчаса», «в 18:30», «в 7 вечера»), имя и факты о человеке (`numbers.py`, `assistant.py`, `memory.py`); память — `~/.harvey/memory.json` (`--home` / `HARVEY_HOME`), вне репозитория, запись атомарная; сработавшее само произносится и отправляется голове, Харви ещё 8 с слушает без «Харви»; имя и факты подмешиваются в системное сообщение LLM | таймеры и «который час» не должны зависеть от Ollama и интернета; напоминание не теряется при выключении — при запуске говорится «Пока меня не было: …» |
| 2026-11-05 | Звук и картинка между головой и ПК: второе TCP-соединение «медиа» (порт 8766, двоичные кадры `код/голова/harvey_head/media.py`, команды на 8765 не тронуты). Голова шлёт звук своих микрофонов (моно int16 16 кГц, кадры 20 мс) и по просьбе — JPEG камеры (по умолчанию выключено), играет присланную речь; мозг с `--head-audio` слушает и говорит через голову (`MediaServer`, `RemoteMicListener`, `RemoteSpeaker`); полудуплекс делает голова (микрофон молчит во время речи и 0,3 с после) | распознавание, LLM и голос остаются на ПК, а слышит и говорит сам робот; очереди отправки ограничены (звук 1 с, видео 2 кадра), потому что Wi-Fi медленный; живой канал INMP441, уровни и совместная работа arecord + aplay на карте I2S - предварительно, проверить на стенде |
| 2026-11-05 | Зрение на ПК: лица — `harvey_brain/vision.py` (YuNet через OpenCV `FaceDetectorYN`, модель `~/.harvey/models/vision/`), кадр с головы (`MediaServer.latest_frame`, не старше 1 с) или камера ноутбука (`--vision head\|webcam\|off`); глаза следят за самым крупным лицом (`look` ≤ 5 раз в секунду, сглаживание), «пропало» — через 3 с без лица; «Привет!» (с именем из памяти), когда лицо появилось после ≥ 10 мин без него; «посмотри на меня» при видимом лице — голове `{"t":"turn","deg":азимут}` → цель `turn` (поворот на месте по гироскопу короткой дорогой), без лица — осмотреться, как раньше. Знаки — как у метки станции (+ налево). Кто это — не узнаём | зрение на ПК не нагружает Pi Zero; мигание детектора не должно дёргать глаза и повторять приветствие; один раз сказанное «Привет!» не повторяется, пока человек сидит рядом; опознавание лиц — позже и отдельным решением; камера Wide и смещение 66 мм от центра корпуса дают ошибку азимута единицы градусов на 30 см, на метре — доли градуса: проверить на роботе |

## Связанные заметки

[[Харви]] · [[Концепция]]
