iamharveststorm/harvey/заметки/Чек-лист стенда мини.md

---
title: Чек-лист стенда «Компакт мини»
date: 2026-10-17
tags: [харви, мини, закупка, стенд]
aliases: [Чек-лист мини, Покупки стенда мини]
---
# Чек-лист: всё для стенда ноги «Компакт мини»

Всё, что нужно, чтобы собрать одну ногу мини на стенде, провести замеры и проверить шину от Pico 2. Отмечайте, что куплено: номер, модель, магазин и цена — я внесу в таблицу. Характеристики привода — [[STS3032-C036 — даташит Feetech (6 В).pdf|даташит STS3032-C036]], адаптера — [[FE-URT-1 — адаптер шины.xlsx|FE-URT-1]]. Подробности и полный список робота — [[Комплектация мини]].

**Статусы:** ✅ заказано · 🛒 выбрано (корзина) · ⚠️ есть замечание · ⬜ не куплено. С этапа 1 «Компакта» ничего не было — всё покупается сейчас (подтверждено 17.10.2026).

## A. Приводы и связь

| № | Статус | Что | Кол-во | ₽ (оценка) | Купил: модель, магазин, цена |
| --- | --- | --- | --- | --- | --- |
| 1 | ✅ | Feetech **STS3032-C036**, 6 В | 2 | ✅ | Ещё 2 × STS3032-C036 — всего 4: поворот, бедро, колено + запасной | 2 | 5 989 | AliExpress 1005006493400628, Feetech Official Store, вариант «2pcs», 5 989 ₽ |
| 2 | ⬜ | **Ещё STS3032-C036** — нога из 3 суставов: поворот, бедро, колено. Сейчас приводов 2 — нужен минимум 1, лучше 2 (третий + запасной) | 1–2 | 3 280 / 5 989 | |
| 3 | ✅ | USB-адаптер шины **FE-URT-1** | 1 | 600–1 200 | AliExpress 32965635099, vvhobby Store, 1 289 ₽ |
| 4 | ✅ | **Waveshare Bus Servo Adapter (A)** — шина от Pico | 1 | 999 | Ozon 3951158167, 999 ₽ |
| 5 | ✅ | **Raspberry Pi Pico 2 H** | 1 | 2 232 | AliExpress 1005012769530076, Joyful Chip Store, 1 899 + 333 ₽ |
| 6 | ✅ | Кабель micro-USB с данными, 1 м | 1 | 141 | Ozon 1255511876, EMYX, 141 ₽ |
| 7 | ✅ | Провода Dupont 20 см, 120 шт. (М-М, П-П, П-М) | 1 | 228 | Ozon 1534070622, 228 ₽ |
| 8 | ✅ | Макетная плата MB-102, 830 точек | 1 | 238 | Ozon 1314123588, 238 ₽ |
| 9 | ✅ | Разъёмы 3-pin 1,25 мм с проводами 95 мм, 5 пар | 1 | 405 | Ozon 1658584873, 405 ₽ |

## B. Питание

| № | Статус | Что | Кол-во | ₽ (оценка) | Купил |
| --- | --- | --- | --- | --- | --- |
| 10 | ✅ | **Лабораторный блок питания** с ограничением тока. На стенде — **6,0 В, предел 3 А** | 1 | 3 500–6 000 | Ozon 5511212554, RDDSPON RDD-3010S (30 В, 10 А, CV/CC), 5 879 ₽ |
| 11 | ✅ | Провода «банан — крокодил» | 1 пара | 200–400 | Ozon 1513651332, 1 м, красный + чёрный, 182 ₽ (провод тонкий, 2 А — для стенда хватает) |

## C. Измерения

| № | Статус | Что | Кол-во | ₽ (оценка) | Купил |
| --- | --- | --- | --- | --- | --- |
| 12 | ✅ | **Мультиметр с термопарой K** | 1 | 1 500–3 000 | Ozon 3389646253, Орбита OT-INM14 (режим TEMP °C, термопара), 415 ₽ |
| 13 | ✅ | Каптоновый скотч — приклеить термопару к корпусу привода | 1 | 150–300 | Ozon 2124830048, Armdotal, 30 мм × 33 м, 335 ₽ |
| 14 | ✅ | **Штангенциркуль** цифровой 0–150 мм | 1 | 500–1 500 | Ozon 4030108656, пластиковый, ±0,1 мм, 382 ₽ |
| 15 | ✅ | **Кухонные весы** | 1 | 500–1 000 | Ozon 5489575013, FaizFull, до 10 кг, шаг 1 г, 595 ₽ |
| 16 | ✅ | Лазерная указка — люфт шестерён | 1 | 200–400 | Ozon 262374610, указка 7 в 1, 384 ₽ |
| 17 | ⬜ | Ваттметр-амперметр — не нужен: ток показывает блок RDD-3010S и регистры приводов | — | — | |

## D. Пайка

| № | Статус | Что | Кол-во | ₽ (оценка) | Купил |
| --- | --- | --- | --- | --- | --- |
| 18 | ✅ | **Паяльная станция** | 1 | 800–6 000 | Ozon 1847741263, W.E.P 948DB+ II, 75 Вт, жало T12, 3 750 ₽ |
| 19 | ✅ | Подставка с латунной стружкой | 1 | — | в комплекте станции |
| 20 | ✅ | Припой с канифолью, 0,8 мм | 1 | 200–500 | Ozon 2047434207, ПМП (Рязань) ПОС-61 с канифолью, ГОСТ 21931-76, 0,8 мм, 100 г — 767 ₽ (50 г дешевле и хватит надолго). Вместо Vitatools 4468581009 «с кислотным флюсом» — его не брать |
| 21 | ✅ | Флюс ЛТИ-120 — один флакон, не два | 1 | 150–400 | Ozon 3421736512, Solins, 22 мл с кисточкой, 177 ₽ (14,5 тыс. отзывов; вместо 1698282728 за 182 ₽ — тот же флюс). Активированный: остатки смывать изопропиловым спиртом |
| 22 | ✅ | Термоусадка, набор | 1 | 150–400 | Ozon 1196462435, 900 шт., 1–13 мм, 2:1, 398 ₽ |
| 23 | ✅ | Бокорезы и стриппер для тонкого провода | 1 + 1 | 300–1 300 | Ozon 151864706, бокорезы VIRA мини 115 мм, 234 ₽ + Ozon 2153106109, стриппер Pro'sKit 8PK-3001D (0,05–0,5 мм², 30–20 AWG), 1 058 ₽. Автоматический TAYKER 0,2–6 мм² не подходит: провода стенда 0,08–0,13 мм² |

## E. Механика и печать

| № | Статус | Что | Кол-во | ₽ (оценка) | Купил |
| --- | --- | --- | --- | --- | --- |
| 24 | ✅ | Винты **M2 × 6** — нужно 28 (нога 24 + стенд 4) | 60 | 150–300 | Ozon 2052700039, DIN 912 (внутренний шестигранник 1,5 мм), A2: 20 шт. — 119 ₽ + ещё 40 шт. — всего 60 |
| 25 | ⬜ | Винты M2 × 8 и гайки M2 — запас | ~20 | 300–700 | |
| 26 | ✅ | Шестигранник 1,5 мм под M2 DIN 912 | 1 | 150 | Ozon 1010236459, Norgau Industrial 1,5 мм, CrV, 152 ₽ (ключ 2,5 мм Jesda, 94 ₽, тоже заказан — пригодится для M3) |
| 26б | ✅ | Отвёртка с битами PH0 / PH00 / H1.5 | 1 | 3 524 | Ozon 5837124674, электроотвёртка Xiaomi Duka ATuMan E3 95 в 1 (86 бит: PH000–PH1, H1.5–H2, Torx), 3 524 ₽. M2 — слабый режим, дотягивать рукой |
| 27 | ⬜ | **Печать** ~25 г: PETG (кронштейн, бедро, голень) + PLA (стенд) — свой принтер или услуга печати | — | 0 / 300–800 | |
| 28 | ⬜ | TPU для стопы — или стопа из PETG + резиновая самоклейка-«бампон» | 1 | 0–700 | |
| 29 | ⬜ | Небольшая струбцина — прижать стенд к столу (по желанию) | 1 | 200–500 | |
| 30 | ⬜ | Стяжки 2,5 мм, двусторонний скотч | 1 | 100–300 | |

## Итого

| Группа | ₽ |
| --- | --- |
| Заказано (всё, кроме 25, 27–30) | **≈ 37 000** |
| Обязательно докупить | **ничего — для стенда всё есть** |
| Желательно: изопропиловый спирт | 150–250 |
| Печать и мелочи (27–30) | 300–2 300 |

Детали стенда печатать после того, как приедут приводы и измерены `horn_top` и `shaft_from_end`.

**После схем проводки (25.10.2026) для стенда докупать ничего не нужно.** Добавилось одно наблюдение: после 10 минут шага (Н4) потрогать разъём 1,25 мм первого привода ноги — через него идёт ток трёх приводов, а контакт рассчитан примерно на 1 А. Изменения для полного робота — в [[Комплектация мини]] и [[схемы/README|Схемы мини]].

**Программы готовы:** стенд — `код/стенд привода/run_bench_mini_windows.bat` (можно заранее пройти все шаги в имитации: Enter вместо порта), шина от Pico — `код/прошивка/pico/`. Порядок и подключение — [[код/стенд привода/README|Стенд привода]].

Related: [[Комплектация мини]] · [[Компакт мини]] · [[Этап 1 — покупки и стенд одной ноги]]
