iamharveststorm/harvey/заметки/Компакт мини.md

---
title: Харви «Компакт мини»
date: 2026-10-16
tags: [харви, версии, мини]
aliases: [Мини, Компакт мини]
---
# Харви «Компакт мини»

Ветка `kompakt-mini`, ответвлена от версии [[Версии Харви|v2 «Компакт»]]. Цель — настольный робот как можно меньше.

Задачи:
- протереть стол салфеткой;
- взять и подать ручку или карандаш;
- общаться, узнавать людей, показывать эмоции, танцевать;
- самому заряжаться на станции.

Тяжёлые предметы и перенос на спину не нужны.

![[мини_компоновка.png]]

![[Мини_3.png]]

![[Мини_1.png]]

## Решения (16.10.2026)

| Узел | Решение |
| --- | --- |
| Ноги | 6 × 3 сустава, все приводы STS3032 (23 × 12 × 27,5 мм, 20 г); основание 27, бедро 30, голень 48 мм; передние ноги развёрнуты на 52° (клешням нужно место) |
| Клешни | 2 × 4 сустава на STS3032: поворот плеча, подъём, локоть, захват. Губки смыкаются вбок; запястья нет — угол к ручке задаётся разворотом корпуса. Плечо 40, предплечье 30 мм |
| Глаза | подвижные стебельки 26 мм (по 1 STS3032), круглые дисплеи ~0,71″ |
| Камера | Module 3 Wide в передней стенке между плечами — смотрит на стол перед клешнями; **неподвижна**, обзор — поворотом и наклоном корпуса ногами (±12°); поза «поджато» (8°; 50°; −130°) не загораживает кадр |
| Хвост | нет. Подъёма со спины нет; падать не даёт низкий центр тяжести и датчики края |
| Бортовой мозг | **Pi Zero 2 W** (65 × 30 мм, 11 г, аппаратный кодер H.264) + RP2350-Zero — «спинной мозг»; в отсек того же размера встанет Radxa Zero 3W, если 512 МБ не хватит |
| «Большой мозг» | ПК (потом мини-ПК), связь по Wi-Fi |
| Питание | 2 × 18650 (2S, ~22 Вт·ч), DC-DC 6 В 6 А (приводы), 5 В (Pi), плата заряда и защиты 2S на борту |
| Зарядка | две латунные пластины 40 × 12 мм на брюхе + станция-«гнездо» с подпружиненными контактами, меткой AprilTag и ИК-маяком |
| Проводка | схемы с разъёмами, проводами и токами — [[схемы/README|Схемы мини]] |

## Размеры и масса (из CAD)

| | Компакт мини | Компакт |
| --- | --- | --- |
| Корпус | 114 × 88 × 39 мм | 150 × 140 × 70 мм |
| Размах стоп | 198 мм | ~300 мм |
| Длина с поджатыми клешнями | ~220 мм | ~300 мм |
| Высота до верха глаз | ~119 мм | ~170 мм |
| Масса | **893 г** | ~2,85 кг |

Из чего складываются 893 г:

| Узел | г |
| --- | --- |
| 28 × STS3032 | 560 |
| печать: PLA 116 г + TPU 4 г | 120 |
| батарея 2 × 18650 | 94 |
| остальная электроника | 74 |
| провода, винты, накладки | 45 |

Цель «≤ 0,8 кг» не достигнута: 560 г — это сами приводы. Нагрузку это почти не меняет: при ходьбе её задаёт походка, а не масса. В симуляции 0,75 и 0,95 кг дают одинаковый итог.

## Что умеет и где это считается

| Что | Где |
| --- | --- |
| Разговор, ответы на вопросы, LLM, распознавание и синтез речи | ПК |
| Узнавание людей и запоминание лиц | ПК, по видео с камеры |
| Поиск ручки, салфетки, кружки; наведение клешни | ПК находит предмет; последние миллиметры захвата доводит RP2350 по нагрузке привода |
| Куда идти по столу | ПК по камере; не упасть со стола — датчики края и IMU на борту, работают всегда |
| Эмоции, танцы, реакция на поглаживание | на борту, работают и без ПК; с ПК эмоции подбираются по разговору |
| Заряд батареи, путь на станцию | INA226 на борту; станцию находит по метке на ПК или по ИК-маяку без ПК |

Без ПК Харви — «сонный питомец»: ходит, не падает со стола, показывает эмоции, танцует, следит за зарядом и сам идёт заряжаться.

## Проверки

**CAD** (`модели/мини/harvey_mini_parts.py`): **0 столкновений**. Проверено:
- нога сама с собой и с корпусом;
- соседние ноги;
- 332 разрешённые позы клешни против корпуса, передней ноги, другой клешни, глаза и самой себя;
- глаза;
- детали внутри корпуса;
- станция стоя и лёжа.

Правила движения — в [[модели/мини/README|README деталей]].

**Симуляция** (`код/симуляция/мини/harvey_mini.py`, массы и размеры из CAD):

| Проверка | Итог |
| --- | --- |
| Ходьба | 6,2 см/с, ровно (наклон ≤ 0,4°); бедро в среднем 76 % номинала STS3032, пики 74 % предела |
| Разворот на месте | 45°/с |
| Ручка | взял со стола, поднял на 68 мм, пронёс шагом, подал на высоте 105 мм |
| Салфетка | прижал и протёр три полосы |
| Клешни вытянуты вперёд | вперёд не опрокидывается |
| Край стола | видит край за 67 мм, запас 38–42 мм |
| Станция | дошёл за 3,2 с, промах 6 / 2 мм, контакты 3,6 и 4,0 Н — заряжается |

Подробнее — [[код/симуляция/мини/README|симуляция мини]]. Управление с клавиатуры на столе, фотореалистично: `код/симуляция/мини/run_mini_windows.bat` (`harvey_mini_teleop.py`).

![[mini_управление.png]]

![[mini_глазами_Харви.png]]

## Комплектация и бюджет (оценка, ₽)

Полный список с крепежом, первыми тестами и печатью — [[Комплектация мини]] (≈ 116–161 тыс. ₽; привод STS3032-C036 — 3 280 ₽ в Feetech Official Store). Ниже — краткая сводка.

| Позиция | Кол-во | Сумма |
| --- | --- | --- |
| STS3032-C036 (28 + 2 запасных) | 30 | 98 400–125 100 |
| USB-адаптер шины Feetech (URT-1) | 1 | 600–1 200 |
| Pi Zero 2 W + microSD 32 ГБ | 1 | 2 300–3 900 |
| RP2350-Zero | 1 | 400–800 |
| Camera Module 3 Wide + шлейф для Zero | 1 | 3 500–5 000 |
| Круглый дисплей 0,71″ (GC9D01, 160 × 160) | 2 | 800–1 800 |
| VL53L4CD (датчики края) | 6 | 3 000–7 200 |
| IMU BMI270 / ICM-42688 + INA226 | 1 + 1 | 700–2 000 |
| 2 × INMP441 + MAX98357A + динамик 20 мм | 1 | 650–1 400 |
| Сенсорные кнопки TTP223 | 4 | 100–300 |
| Буферы шины, макетка, разъёмы | 1 | 300–600 |
| 18650 высокотоковые | 2 | 1 200–2 400 |
| Плата заряда + защиты 2S с балансировкой | 1 | 400–900 |
| DC-DC 6 В 6 А и 5 В 3 А | 1 + 1 | 700–1 500 |
| Провода, предохранитель, выключатель | 1 | 600–1 200 |
| Винты M2 (~150), латунные пластины, 2 pogo-контакта | 1 | 500–1 000 |
| Пластик PLA ~200 г + TPU ~30 г | 1 | 300–600 |
| Станция: блок питания USB-C 5 В 3 А, ИК-светодиод, провода | 1 | 600–1 200 |
| **Итого** | | **≈ 115 000–158 000** |

Для сравнения: «Компакт» — 107–179 тыс. ₽. По реальной цене STS3032-C036 (3 280 ₽, дороже STS3215 при вчетверо меньшей силе) мини стоит почти как «Компакт»: он выигрывает размером и массой, а не ценой. Больше 4/5 суммы — приводы. Нижняя граница — заказ напрямую из Китая.

## Проверить на стенде (до заказа всех 30 приводов)

1. Нагрев STS3032 на бедре за 10 минут ходьбы (в симуляции средняя нагрузка 76 % номинала).
2. Размеры STS3032 с пометкой «ИЗМЕРИТЬ» и шаг резьбы на опорном торце.
3. Модуль дисплея 0,71″ — габарит (в модели Ø24 × 4,5 мм).
4. Реальный ток при ходьбе: оценка 8–12 Вт, значит 1,5–2 часа от 22 Вт·ч.
5. Pi Zero 2 W: тянет ли видео 720p по Wi-Fi 2,4 ГГц вместе с двумя дисплеями глаз.

Related: [[Харви]] · [[Журнал решений]] · [[Версии Харви]] · [[модели/мини/README|Детали мини]] · [[код/симуляция/мини/README|Симуляция мини]]
