iamharveststorm/harvey/заметки/Этап 1 — покупки и стенд одной ноги.md

# Харви — этап 1: покупки и стенд одной ноги

Oct 9, 2026 · @HarvestStorm

## Итог

Этап 1 — это одна нога Харви и одна кисть на столе: около 9–16 тыс. ₽ на детали и ещё 6–12 тыс. ₽ на инструменты для стенда, если их нет. За 2–3 вечера замеров станет ясно, держат ли настоящие STS3215 те числа, на которых построен весь расчёт, и только после этого стоит заказывать остальные 20+ приводов.

На стенде проверяем пять вещей, которые симуляция показать не может: реальный момент и ток приводов, люфт шестерён (от него зависит точность клешней), нагрев под нагрузкой, уровень сигнала шины и работу трёх приводов по одной шине от Pico 2.

Сам стенд можно запускать прямо с ноутбука через USB-адаптер шины и готовую библиотеку Feetech на Python, а Pico 2 подключается в конце — для проверки будущей прошивки.

## Список покупок

Цены ориентировочные: нижняя граница — AliExpress (официальный магазин Feetech), верхняя — Ozon, Wildberries, «Чип и Дип».

**Детали Харви** — пригодятся и в готовом роботе:

| Позиция | Как искать | Кол-во | Цена за шт., ₽ | Зачем |
| --- | --- | --- | --- | --- |
| Сервопривод Feetech STS3215, версия **C018** (12 В, 30 кг·см, 1:345) | «Feetech STS3215 C018 12V» | 3 | 1 900–2 800 | основание, бедро и колено одной ноги |
| Сервопривод Feetech STS3032-C036 (6 В, 4,5 кг·см) | «Feetech STS3032» | 2 | 3 280–4 170 | захват и запястье кисти |
| USB-адаптер шины Feetech (FE-URT-1 или Waveshare Bus Servo Adapter) | «Feetech FE-URT-1» / «bus servo adapter» | 1 | 600–1 200 | управление и настройка с ноутбука |
| Raspberry Pi Pico 2 **H** (RP2350, штырьки уже припаяны) | «Raspberry Pi Pico 2 H» | 1 | 700–1 200 | проверка будущей прошивки; H — сразу в макетку, без пайки |
| Буферы 74LVC1G125 и 74LVC1G126 (по схеме из даташита Feetech, питание 3,3 В) | «74LVC1G125», «74LVC1G126» + переходник SOT-23 | 2 | 100–250 | полудуплексная шина между Pico и приводами |
| Удлинители кабелей сервоприводов, 3 контакта | по типу разъёма приводов | 4 | 50–150 | подключение без натяга |
| Макетная плата и провода Dupont | — | набор | 300–600 | сборка стенда |

Итого детали: ≈ 14–19 тыс. ₽.

**Инструменты для стенда** — только то, чего у тебя ещё нет:

| Позиция | Кол-во | Цена, ₽ | Зачем |
| --- | --- | --- | --- |
| Лабораторный блок питания 30 В 5 А с ограничением тока | 1 | 3 500–6 000 | безопасное питание: при ошибке ток ограничится, ничего не сгорит |
| Сетевой адаптер 12 В 10 А и гнездо 5,5 × 2,1 мм | 1 | 800–1 500 | ходьба ноги, где пики выше 5 А |
| Встраиваемый ваттметр-амперметр постоянного тока на 20 А | 1 | 300–800 | средний и пиковый ток ноги |
| Мультиметр с термопарой | 1 | 1 000–3 000 | напряжения, уровень сигнала, температура корпуса привода |
| Кухонные весы до 5 кг | 1 | 500–1 000 | момент привода через рычаг |
| Лазерная указка | 1 | 200–400 | люфт: 1° поворота даёт \~17 мм сдвига пятна на стене в метре |
| Крепёж M2–M3 и резьбовые вставки | набор | 800–1 500 | сборка ноги |
| Самонарезающие винты PA2.0 на 1,5 мм длиннее штатных винтов корпуса STS3215 | 8 | 100–200 | держат приводы бедра и колена в обхватах (с 15.10) |
| Пластик PETG 1 кг (если есть принтер) | 1 | 1 200–2 000 | детали ноги и рычаг |

Итого инструменты: ≈ 6–12 тыс. ₽, большая часть останется на всю сборку.

## Как не купить не то

У STS3215 несколько версий с одинаковым названием, и самая частая ошибка — взять не ту.

- **Нужна именно версия C018: 12 В, 30 кг·см, редуктор 1:345.** Версия C001 — на 7,4 В и 19,5 кг·см, её силы с грузом в приседе не хватает. Версии C044 и C046 — с другим передаточным числом, они быстрее, но слабее. Версия написана на наклейке корпуса и в названии лота; если на фото её не видно — спросить продавца.
- **STS, а не SCS.** STS — магнитный датчик положения на 12 бит (4096 шагов на оборот); SCS — потенциометр, точность хуже и он изнашивается.
- **Покупать у официального магазина Feetech или у продавцов с большим числом отзывов.** Подделки встречаются; признак — сильно заниженная цена и нет версии на наклейке.
- **Проверить комплект:** у каждого STS3215 обычно в коробке качалка 25T, винты и кабель. Если кабеля нет — докупить удлинители.
- **Разъёмы у STS3215 и STS3032 разные** (по даташитам): у STS3215-C018 — 5264-3P (шаг 2,5 мм), у STS3032-C036 — мелкий 3-контактный с шагом 1,25 мм. Протокол и порядок контактов одинаковые (GND, Vcc, сигнал), поэтому на одной шине они работают, но нужен переходной кабель 5264 ↔ 1,25 мм — купить 2–3 штуки или спаять. И питание у STS3032 своё: 6 В, защита срабатывает выше 7,4 В — от 12 В его питать нельзя.
- **STS3032 — какая версия.** Даташит есть на [[STS3032-C036 — даташит Feetech (6 В).pdf|C036]]: два вала, алюминиевый корпус, 23 × 12 × 27,5 мм (с качалками 37,2), 20,6 г; на обоих торцах резьба 6 × M2 с шагом 9 мм, 1:205, 4,5 кг·см и 1,2 А в упоре на 6 В. Модели деталей кисти сделаны под C036 — `модели/стенд кисти/`. У STS3032 в обратной связи нет тока (только положение, скорость, нагрузка, напряжение, температура) — силу захвата меряем по «нагрузке» и весам.
- **Pico 2, а не Pico.** Pico 2 на RP2350 — больше памяти и выводов PIO для третьей шины; плата Pico первой версии (RP2040) по виду почти такая же.
- **Лабораторный блок питания — с регулировкой ограничения тока.** Это главный инструмент безопасности: при ошибке в проводке он просто ограничит ток.

## Что напечатать

Готовые файлы для печати (STL и STEP), листы деталей и проверка столкновений — в архиве Harvey\_leg\_CAD.zip из чата: башня стенда, кронштейн основания, бедро, голень, TPU-стопа, крышки обойм и рычаг 100 мм. Детали крепятся к дискам-фланцам привода (4 × M3 на окружности 14 мм); первым напечатать рычаг и проверить, что отверстия совпали с диском. Таблица ниже — что для чего.

| Деталь | Размеры | Зачем |
| --- | --- | --- |
| Рычаг на качалку 25T | 100 мм от оси до отверстия под крючок | момент: привод тянет рычаг, весы показывают силу |
| Кронштейн основания ноги | крепление привода основания + две щёки под привод бедра, звено 40 мм | первый сустав ноги |
| Пластины бедра | 2 шт., 4 × 18 мм, **51 мм** между осями (было 45 — см. ниже) | второй сустав |
| Голень | трубка Ø20 → Ø12, 62,5 мм до центра стопы | третий сустав |
| Стопа | полусфера Ø15 (TPU или PLA с резиновой накладкой) | опора |
| Стойка ноги (`harvey_leg_tower`) | 110 × 90 × 109 мм; фланец привода основания на 110,6 мм над столом, 4 шурупа в доску | нога стоит на столе, как на роботе; поворот ±60° без задеваний |
| Держатель лазерной указки | хомут на рычаг | замер люфта |

Готовые STL всех деталей, параметрическая модель и описание печати — в архиве harvey-stage1-parts (выложен в чате). **Перепроверка 15.10.2026 ([[модели/стенд ноги/README|leg_check.py]]):** в первой версии привод колена упирался в привод бедра и в кронштейн основания при любом положении бедра — ногу было не собрать. Исправлено: бедро 51 мм, новый кронштейн основания, обхват колена без задней стенки, приводы держат удлинённые винты корпуса. **Перепечатать 4 детали:** кронштейн основания, 2 пластины бедра, обхват колена; **напечатать новую стойку ноги**; планка-фиксатор больше не нужна; рычаг, держатель, голень и стопа — прежние. Колено складывается до −130°, поворот ±60°, вся походка проходит без столкновений; между фланцем основания и осью бедра — 58 мм. Если принтера нет, на первые замеры хватит рычага из линейки или полоски фанеры: момент и люфт меряются и без печатных деталей.

Детали кисти под STS3032-C036 — [[модели/стенд кисти/README|стенд кисти]]: стойка запястья, ладонь с нижним пальцем, верхний палец, накладки TPU, рычаг 25 мм для замера 10 и держатель одного STS3032. Перед печатью сверить штангенциркулем два размера привода: ось вала до торца и высоту качалки.

## Протокол стенда

Двенадцать замеров по порядку; каждый сравнивается с нормой, которую дал расчёт и симуляция. Результаты стоит записывать прямо в таблицу ниже.

Перед началом: блок питания на 12,0 В с ограничением тока 3 А для одного привода и 5 А для ноги; упор и опыты «в упоре» — не дольше 2 секунд; нога закреплена на подставке.

Встроенная защита привода по [[STS3215-C018 — даташит Feetech (12 В).pdf|даташиту C018]]: ток больше 2 А дольше 2 с или нагрузка больше 80% упорной дольше 2 с — привод отключает выход до следующей команды позиции; выше 70 °C — снимает момент; вне 4–14 В — защита до возврата напряжения. Если на стенде привод «замолчал» в упоре — это она, а не поломка. Паспорт: упор 30 кг·см и 2,7 А, номинал 10 кг·см и 0,9 А, покой 30 мА, 60° за 0,222 с, люфт ≤ 0,5°, рабочая температура −10…60 °C.

| № | Что проверяем | Как | Норма | Результат |
| --- | --- | --- | --- | --- |
| 1 | Связь и настройка | адаптер, шина 1 Мбит/с; назначить номера 1–3 приводам ноги и 21–22 приводам кисти, прочитать модель | все отвечают, модель STS3215 / STS3032 |  |
| 2 | Ток покоя и в упоре одного STS3215 | удержание позиции без нагрузки, затем кратко в упоре | покой ≤ 0,1 А; упор 2,4–3,0 А |  |
| 3 | Момент | рычаг 100 мм давит на весы в упоре, на 12,0 и 10,2 В | ≥ 2,5 кг (25 кг·см) на 12 В; ≥ 2,0 кг на 10,2 В |  |
| 4 | Скорость | поворот на 90° без нагрузки, время по телеметрии | ≤ 0,4 с |  |
| 5 | Люфт | привод держит позицию, рычаг с лазером; луч на стену в 1 м, рычаг слегка покачать в обе стороны | размах пятна ≤ 17 мм (1°), хорошо ≤ 9 мм |  |
| 6 | Точность возврата | 10 раз уйти на ±45° и вернуться, отметить пятно | разброс ≤ 5 мм (0,3°) |  |
| 7 | Нагрев на номинале | рычаг 100 мм держит груз 1 кг (10 кг·см) 10 минут | корпус ≤ 65 °C, датчик привода ≤ 70 °C, ток ≤ 1,1 А |  |
| 8 | Нога под весом | нога на подставке, груз такой, чтобы на стопу приходилось \~1,7 кг (половина Харви с грузом), 10 минут | ток бедра в среднем ≤ 1 А, корпус ≤ 65 °C |  |
| 9 | Нога шагает | цикл шага 10 минут от адаптера 12 В 10 А через ваттметр | средний ток 0,6–1,2 А, пики ≤ 10 А; отличие от симуляции ≤ 30% |  |
| 10 | Сила захвата STS3032 | ограничение момента 0,07 Н·м, рычаг 25 мм на весы, 6 В | ≈ 0,29 кг (2,8 Н) |  |
| 11 | Уровень сигнала шины | мультиметр между сигналом и землёй в покое | по даташиту C018: «1» — от 2 до 5 В, «0» — до 0,45 В, значит 3,3 В от Pico подходит; проверить, что шина работает от 3,3 В |  |
| 12 | Шина от Pico 2 | три привода через буферы 74LVC1G125/126: общая команда и опрос состояния, 10 минут | ≤ 1 мс на привод, ни одной ошибки |  |

Для замеров 1–9 хватит ноутбука и библиотеки Feetech на Python; для 12 — Pico 2 с MicroPython. Скрипт стенда, который сам проведёт замеры 1–7 и запишет таблицу, я могу подготовить до прихода деталей.

## Решение по итогам стенда

Результаты стенда решают, заказывать ли остальные \~20 приводов STS3215 и 9 STS3032 и что поменять до заказа.

| Если на стенде… | Значит | Что делаем |
| --- | --- | --- |
| Все нормы выполнены | расчёт подтверждён | заказываем этап 3: «голова» на столе и остальные приводы |
| Момент меньше 22 кг·см | приводы слабее паспорта или подделка | проверить версию и продавца; если всё верно — облегчить Харви или уменьшить груз на спине, пересчитать |
| Люфт больше 2° | клешни будут неточными, письмо хуже | хвост и клешни — с поджатием (пружина на звене), на запястья — приводы точнее |
| Нагрев выше 70 °C за 10 минут | долгая ходьба перегреет ноги | больше покоя в поведении, вентиляция панциря, ограничение быстрого шага |
| Ток ноги больше симуляции на 30% и больше | батарея и предохранители рассчитаны впритык | пересчитать питание: батарея 3S2P (6 банок) и предохранители на ступень выше |
| Ошибки шины от Pico | проблема уровней или скорости | преобразователь уровня с другим питанием, шина 500 кбит/с |

После стенда — короткий отчёт с числами в этом документе, обновление спецификации в скилле и заказ следующего этапа.

## Связанные заметки

[[Харви]] · [[Комплектация и бюджет v0.2]] · [[Питание и проводка]] · [[модели/стенд ноги/README|Детали стенда ноги]] · [[harvey-stage1-parts.pdf]] · [[код/стенд привода/README|Программа стенда привода]]
