iamharveststorm/harvey/заметки/Галерея.md

---
title: Галерея
date: 2026-10-15
tags: [харви, рендеры, чертежи]
aliases: [Картинки, Рендеры]
---
# Харви — галерея

Все картинки проекта в одном месте: рендеры робота, компоновка, детали стендов, чертежи. Свои фото и эскизы клади в папку `фото/` ([[Фото]]) — и добавляй сюда строкой `![[имя файла.jpg]]`.

## Робот целиком — на рабочем столе (компоновка v2)

Открытая рама (основной вариант): оранжевые детали на графитовой раме, видны приводы и электроника.

![[Харви_открытый_1.png]]

![[Харви_открытый_2.png]]

![[Харви_открытый_3.png]]

Мягкий скруглённый кожух (вариант): графитовый панцирь вместо подноса.

![[Харви_мягкий_1.png]]

![[Харви_мягкий_2.png]]

![[Харви_мягкий_3.png]]

Как сделаны: [[модели/рендер/README|Рендеры]].

## Компоновка — вид сверху

![[компоновка_вид_сверху.png]]

Серое — рама; синее — ноги; оранжевое и красное — клешни; фиолетовое — глаза; зелёное — хвост; жёлтое — электроника. Подробно: [[модели/корпус/README|Корпус и компоновка]].

## Клешни

![[рендер клешней.png]]

[[модели/клешни/README|Клешни целиком]] · [[модели/хвост/README|Хвост с присоской]] · [[модели/глаза/README|Глаза-стебельки]]

## Стенды этапа 1

Нога:

![[рендер ног.png]]

Кисть:

![[рендер кисти.png]]

![[сборка кисти.png]]

![[детали кисти.png]]

[[модели/стенд ноги/README|Стенд ноги]] · [[модели/стенд кисти/README|Стенд кисти]]

## Симуляция — мир для управления

![[мир_харви_на_столе.png]]

![[мир_стол.png]]

![[мир_полоса.png]]

![[мир_склоны.png]]

Режим «фото» (рендер Filament, PBR): следы на продавленном песке, настоящие камни гальки, трава со стеблями.

![[фото_стол.png]]

![[фото_песок_следы.png]]

![[фото_галька.png]]

![[фото_трава.png]]

![[фото_склон.png]]

[[код/симуляция/управление с клавиатуры/README|Симуляция и управление с клавиатуры]]

## «Компакт мини» (ветка `kompakt-mini`)

На том же столе, что и «Компакт» (Blender, Cycles), всё в реальном масштабе 1 : 1: лист A4, ручки, кружка, зажигалка, кейс наушников.

![[Мини_1.png]]

![[Мини_2.png]]

![[Мини_3.png]]

![[мини_компоновка.png]]

![[mini_стол.png]]

![[mini_салфетка.png]]

![[mini_привет.png]]

![[mini_и_предметы.png]]

![[mini_управление.png]]

![[mini_глазами_Харви.png]]

[[Компакт мини]] · [[модели/мини/README|Детали мини]] · [[код/симуляция/мини/README|Симуляция мини]]

## Чертежи по ГОСТ

![[ХАРВИ.01.001 Рычаг 100 мм.pdf]]

![[ХАРВИ.02.002 Ладонь кисти.pdf]]

[[модели/чертежи/README|Чертежи]]

Related: [[Харви]] · [[Журнал решений]] · [[Сборка в Onshape и физическая проверка]]
