iamharveststorm/harvey/заметки/Версии Харви.md

---
title: Версии Харви
date: 2026-10-16
tags: [харви, версии]
---
# Версии Харви

Вся папка проекта — локальный git-репозиторий. Каждая версия робота — **метка** (снимок, который не меняется) и **ветка** (по ней версию можно развивать дальше).

| Версия | Метка | Ветка | Что это |
| --- | --- | --- | --- |
| **v2 «Компакт»** | `v2-kompakt` | `kompakt` | шесть ног STS3215, две клешни с пятью суставами, хвост с присоской, глаза-стебельки на углах; компоновка v2 (плечи клешней в (105; ±30) мм), открытая рама из 14 деталей ≈ 180 г и вариант с мягким кожухом; стенды ноги и кисти (этап 1); симуляция с миром, адаптивной походкой, физикой песка, камней и травы и режимом «фото». Сохранена 16.10.2026 |
| **«Компакт мини»** | — (в работе) | `kompakt-mini` | всё на STS3032 (28 шт.), 889 г, размах стоп 198 мм; 2 клешни по 4 сустава, глаза 0,71″, без хвоста; Pi Zero 2 W; станция зарядки — [[Компакт мини]] |

## Как вернуться к версии и продолжить

В терминале в папке проекта:

- посмотреть версии: `git tag` и `git branch`
- перейти на «Компакт» и развивать её: `git switch kompakt`
- посмотреть снимок ровно как был сохранён (без правок): `git switch --detach v2-kompakt`
- сохранить свои изменения в текущей ветке: `git add -A` и `git commit -m "что сделали"`

Перед переключением веток сохраните изменения (commit) — иначе git не даст переключиться или перенесёт правки с собой.
Obsidian при переключении ветки сам покажет файлы выбранной версии.

Related: [[Харви]] · [[Журнал решений]]
