iamharveststorm/harvey/модели/Модели.md

# Модели

Детали для печати (STL), скрипты, которые их строят и проверяют, рендеры и чертежи. Картинки всех моделей — в [[Галерея|Галерее]].

## Робот целиком (компоновка v2)

- [[модели/корпус/README|Корпус и компоновка]] — открытая рама из 14 деталей, где что стоит, правила движения, проверка совместимости
- [[модели/клешни/README|Клешни]] — две клешни по 5 суставов
- [[модели/хвост/README|Хвост]] — третья рука с присоской
- [[модели/глаза/README|Глаза]] — стебельки с дисплеями на магнитной муфте
- [[модели/рендер/README|Рендеры]] — Харви на рабочем столе, сетки для визуализаций

## Этап 1

- [[модели/стенд ноги/README|Стенд ноги]] — нога и стойка для стола
- [[модели/стенд кисти/README|Стенд кисти]] — кисть с захватом
- [[модели/чертежи/README|Чертежи]] — ГОСТ из FreeCAD

Related: [[Харви]] · [[Сборка в Onshape и физическая проверка]] · [[Проверка совместимости и сценарии]]

- [[модели/мини/README|Компакт мини]] — все детали маленькой версии, станция зарядки, проверка столкновений (ветка `kompakt-mini`)
