iamharveststorm/harvey/заметки/Концепция.md

# Харви — концепция

## Идея
Настольный робот-краб — ИИ-помощник «всего понемногу»: компаньон, помощник и рабочий ассистент.
Умеет слушать и говорить, видеть, показывать эмоции глазами, лапками и звуками, подать предмет, протереть стол.

## Характер
Имя — Харви (выбран из вариантов Элмо, Харви, Хурро). Добрый характер, как у ВАЛЛ-И.

## Форма
- Шесть ног (вариант с четырьмя отклонён из-за устойчивости).
- Две мощные клешни, удлинённые и многосуставные (поворот плеча, запястье): брать ручку или телефон,
  класть себе на спину, протирать стол, писать ручкой.
- Хочет уметь забираться куда-то, держась ногами и клешнями.
- Размер: исходный габарит ~30 × 38 см в стойке показался слишком большим → версия «Компакт».

## Железо и мозги
- Приводы с запасом по моменту (чтобы мог нести что-то на себе), вычислители с запасом по мощности.
- «Большой мозг» сначала на домашнем ПК, позже на отдельном мини-ПК, с роботом по Wi-Fi.
- Зарядка: контактная станция-«гнездо» (не беспроводная).

## Документы
- [[Комплектация и бюджет v0.2]]
- [[Проверка совместимости и сценарии]]
- [[Питание и проводка]]
- [[Сборка в Onshape и физическая проверка]]
- [[Этап 1 — покупки и стенд одной ноги]]

## Связанные заметки

[[Харви]] · [[Журнал решений]]
