iamharveststorm/harvey/заметки/Проверка совместимости и сценарии.md

# Харви — проверка совместимости и сценарии

Oct 9, 2026 · @HarvestStorm

## Итог

Механика Харви проходит больше 40 смоделированных ситуаций без падений, и два независимых физических движка дают совпадающие результаты в пределах 10–15%. Главные риски нашлись не в механике, а в стыковке электроники: пять мест, где детали в исходной комплектации друг с другом не работали бы, — они уже исправлены в списке покупок.

Самые важные находки:

- **Датчики края стола нельзя ставить за клешнями**: там луч перекрыт в 100% случаев. Только между клешнями, примерно в 25 мм от центра.
- **Обработка края — на Pico, а не через Wi-Fi.** При задержке 150 мс на быстром шаге до края остаётся 1 мм, при 50 мс — 4–5 см.
- **Эхоподавление микрофонов работает, только если звук идёт через сам reSpeaker.** Отдельный усилитель на Raspberry Pi его ломает.
- **Протирать стол нужно с ограничением усилия по току привода**, а не по положению: иначе прижим скачет от 6 до 14 Н и разгружает передние ноги.
- **Сильный толчок (60 Н) сдвигает Харви на 16 см** — он не опрокидывается, а скользит. У края стола это опасно.

Всё проверено в MuJoCo и PyBullet на ноутбучном уровне точности; что симуляция не покажет — в последнем разделе вместе с порядком закупки.

## Два физических движка

Одну и ту же модель (геометрия, массы, походка, регулятор с паспортной характеристикой «момент — скорость» STS3215) прогнал в MuJoCo и в PyBullet. Движки по-разному считают контакт и трение, поэтому совпадение результатов говорит, что они не артефакт одной программы.

| Тест | MuJoCo | PyBullet |
| --- | --- | --- |
| Стоит, груз 0–0,5 кг: момент бедра, Н·м | 0,19–0,21 | 0,12–0,14 |
| Комфортная ходьба, груз 0,5 кг: скорость | 12,9 см/с | 13,1 см/с |
| Комфортная ходьба: пиковый момент / время выше номинала | 1,66 Н·м / 4,9% | 1,83 Н·м / 4,1% |
| Быстрая ходьба: скорость | 17,1 см/с | 18,5 см/с |
| Быстрая ходьба: пиковый момент / время выше номинала | 2,31 Н·м / 12,9% | 2,48 Н·м / 8,0% |
| Медленно с грузом 1 кг: скорость / пик | 9,6 см/с / 1,27 Н·м | 9,5 см/с / 1,25 Н·м |
| Скользкая поверхность μ = 0,3: скорость | 13,0 см/с | 12,4 см/с |

Расхождение в стоячем моменте ожидаемо: на шести ногах вес делится неоднозначно, и движки по-разному распределяют его между ногами. Оба значения далеко ниже номинала 0,98 Н·м.

## Компоновка v2 — проверка на настоящих деталях (2026-10-15)

Все узлы собраны из моделей деталей (`модели/корпус/harvey_layout.py`, `harvey_body_parts.py`) и проверены попарно во всех рабочих позах — ноги (основания ±25°, бедро и колено в позах шага, покоя и переворота), клешни (поворот −30…+75°, 13 поз пути «со стола на спину»), хвост (поворот ±100°, позы над корпусом и у стола), глаза (наклон −75…+20°).

| Что с чем | Результат |
| --- | --- |
| Рама, электроника, камера, датчики края × все конечности | 0 столкновений |
| Ноги × клешни, хвост × задние ноги, клешня × клешня, глаза × клешни, ноги, хвост | 0 столкновений (при правилах движения) |
| Мягкий кожух (вариант для рендера) × всё | 0 столкновений |
| Пути хвоста из симуляции (подбор сзади, передача, переворот) | 0 столкновений по шагам |

Правила движения, при которых это верно (их обязана соблюдать прошивка):
1. Клешни: в низких позах (подъём < 80°) поворот ±15°; наружу до 75° — только с поднятой рукой; над головой и при укладке на спину — без поворота внутрь; внутрь обе клешни одновременно не поворачиваются.
2. Хвост: к столу — только назад (поворот ±30°) и когда робот стоит; вбок до ±100° — поднятым над горизонталью на 20° и больше.
3. Ноги: бедро выше 90° — только при перевороте (основание 0°); у передних ног — не выше 90°.
4. Глаза: пока своя клешня поднята (подъём ≥ 60°), глаз отклонён наружу на 20° (это и выглядит живо — Харви «пригибает» глаз).

Симуляция на компоновке v2 (все сценарии — без падений): телефон и ручка ложатся на спину, касаний с корпусом и глазами 0; ходьба 12,9 и 17,2 см/с, запас устойчивости 14–15 мм (было 20–21: клешни теперь дальше впереди); датчики края останавливают Харви в 108–146 мм от края (было 14–51); хвост поднимает телефон сзади и кладёт на спину, переворот со спины проходит и с хвостом вбок на 90°, и на 60° (раньше только 90°); удар рукой по пальцу: 26 Н без ограничения, 13 Н при пределе 0,8 Н·м, 10 Н при 0,4 Н·м. Не получается пока: передать телефон с присоски клешням, перенести ручку пальцами над головой (поднимает, но роняет при переносе) — это задачи для обучения на реальном роботе. Ручной переворот у самого края стола не выходит, если толкаться ногами, висящими над краем, — прошивка должна выбирать сторону толчка от края.

## Сценарии

Харви не упал ни в одном сценарии; слабые места — край стола при большой задержке, прижим салфетки и отказ ноги.

| Ситуация | Результат | Вывод |
| --- | --- | --- |
| Ходьба по дереву, стеклу, глянцевой бумаге, μ от 0,8 до 0,15 | 12,9–13,0 см/с везде, крен 0,2° | скольжение не мешает: в трипод-походке ноги не спорят друг с другом |
| Кабель Ø8 мм поперёк пути | перешагнул, крен до 2° | — |
| Тетрадь 10 мм | забрался, крен до 4° | — |
| Книга 25 мм (подъём стопы 25 и 40 мм) | забрался, крен 12–13° | выше без обучения не стоит |
| Край стола, комфортный шаг, задержка 0–50 мс | остановился, до края 39–40 мм | безопасно |
| Край стола, быстрый шаг, задержка 50 мс | остановился, до края 47 мм | безопасно |
| Край стола, быстрый шаг, задержка 150 мс | остановился, до края 1 мм | край обрабатывать на Pico |
| Датчики края за клешнями | луч перекрыт 100% времени | ставить между клешнями |
| Подъём по уклону 10–25° | 12,1 → 10,0 см/с, крен до 2° | уверенно |
| Стоит поперёк уклона 10–25° | не падает, оседает вбок на 14–44 мм | податливость приводов |
| Тычок 5 Н, толчок 15 Н, удар 30 Н сбоку (стоит и идёт) | крен не больше 0,3°, сдвиг до 2 см | устойчив, низкий центр масс |
| Толчок 60 Н | скользит на 16 см, не опрокидывается | у края стола опасно |
| Отказ средней ноги, стоит | крен 6°, стоит | — |
| Отказ средней ноги, идёт триподом | 6,5 см/с, крен 6° | нужна походка на пяти ногах |
| Батарея 11,1 В и 10,2 В, комфортный шаг | 12,9–13,0 см/с, выше номинала 7–8% времени | — |
| Батарея 10,2 В, быстрый шаг | 16,1 см/с, запас устойчивости 12 мм | на разряде ходить спокойнее |
| Разброс: трение, масса ±10–15%, сила приводов −20%, задержка 0–30 мс, шум датчиков (6 прогонов) | 12,8–13,0 см/с, падений нет | запас по надёжности есть |
| Протирка стола, прижим по положению | 6–14 Н, передние ноги разгружаются | нужен прижим по току |
| Телефон 200 г двумя клешнями на спину | лёг, не задел глаза, не съехал при ходьбе | переносить за 10–15 с |
| Ручка одной клешнёй на спину | легла, не скатилась | бортики подноса нужны |

Не моделировались: лазание выше 25 мм, переворот на спину и падение со стола — это задачи для обучения в симуляции (RL).

## Совместимость деталей

Проверка «кто к кому подключается» нашла пять проблем в исходной комплектации; все исправлены в документе с бюджетом.

| Узел | Проблема | Исправление |
| --- | --- | --- |
| Микрофоны и динамик | эхоподавление XVF3800 видит только звук, который идёт через него; усилитель MAX98357A на Pi его обходит | звук через выход reSpeaker, усилитель убран; брать версию без XIAO ESP32S3 — с заводской USB-прошивкой |
| Датчики края VL53L4CD (было VL6180X) | у всех шести один адрес I2C 0x29 — на одной шине конфликтуют | у каждого линия XSHUT на Pico 2 (адреса переназначаются при старте) или мультиплексор TCA9548A |
| Шина приводов | 30 приводов на одной линии: опрос всех занимает \~10 мс, на 50 Гц впритык | три шины (левые ноги, правые ноги, клешни и глаза) на Pico 2, у каждой свой полудуплексный буфер |
| Плата защиты BMS | рывок многих STS3215 даёт 20–30 А, BMS на 20–30 А может отключать питание | BMS на 40 А; банки уровня Molicel P45B держат 45 А |
| Питание STS3032 | 8 приводов по 1,2 А в упоре, DC-DC 6 В 3 А мал | DC-DC 6 В 5 А |

Что проверено и стыкуется:

- **STS3215 от батареи напрямую**: допустимо 4–14 В, полная батарея даёт 12,6 В.
- **STS3215 и STS3032 на одной линии данных**: протокол один (STS, TTL), питание раздельное — 12 и 6 В.
- **Raspberry Pi 5 + AI HAT+**: ускоритель занимает PCIe, 40-контактный разъём проходит насквозь — дисплеи по SPI и I2C остаются доступны.
- **Питание Pi 5 от DC-DC 5 В 5 А через GPIO**: Pi по умолчанию ограничит ток USB до 600 мА; для микрофонов по USB в `config.txt` нужно `usb_max_current_enable=1`.
- **Камера Module 3 к Pi 5**: нужен кабель 22→15 контактов (в списке есть).
- **Качалки приводов**: у STS3215 и STS3032 шлицы 25T, но разного диаметра — посадочные места в печатных деталях разные, модели брать у каждого своей.

Перед заказом сверить по даташиту продавца: тип 3-контактного разъёма у STS3215 и STS3032 и есть ли у reSpeaker Flex выход на динамик (если нет — маленький усилитель с линейного выхода reSpeaker).

## Что симуляция не покажет и как закупать

Симуляция проверяет физику движения, но не то, как реальные детали ведут себя в руках. Эти вещи закрываются только стендом:

- люфт шестерён STS3215 (в оценке точности клешни заложено 1–2 мм, реальное значение надо измерить);
- нагрев приводов и ускорителя в закрытом корпусе за 30 минут работы;
- гибкость печатных деталей и прочность винтов в пластике;
- реальный ток и просадка напряжения при рывках;
- посадка разъёмов, длины проводов, работа драйверов (Hailo, reSpeaker, дисплеи) в одной системе.

Поэтому закупать лучше по этапам, и каждый следующий заказ — только после прохождения контрольной точки предыдущего:

1. **Модель в Onshape (бесплатно).** Собрать по инструкции, включить проверку пересечений, выгрузить через onshape-to-robot и прогнать этот же набор сценариев на точной модели. Контрольная точка: нет пересечений, массы и моменты в пределах 20% от этого отчёта.
2. **Одна нога и одна кисть (\~12–15 тыс. ₽).** 3 × STS3215, 2 × STS3032, USB-адаптер шины, лабораторный блок питания, Pico 2, печать кронштейнов. Контрольная точка: ток и нагрев под грузом за 10 минут в норме, люфт на конце ноги не больше 1–2 мм, разъёмы обоих приводов подходят к одной шине.
3. **«Голова» на столе (\~35–45 тыс. ₽).** Pi 5, AI HAT+, камера, reSpeaker, дисплеи, DC-DC, датчики края. Контрольная точка: Pi стабильно работает от DC-DC под нагрузкой, эхоподавление включено, шесть ToF отвечают на разных адресах и уверенно видят стол на поверхностях Харви — дерево, светлый пластик, чёрный глянец, стекло (луч 2,3 : 1, над столом ~112 мм; на стекле датчик может видеть пол — это ложная, но безопасная остановка), температура ускорителя в закрытой коробке ниже 80 °C.
4. **Остальные приводы, батарея и корпус.** Сборка по чек-листу совместимости выше, первые шаги — на мягком коврике.
5. **Станция-гнездо и обучение** походки на пяти ногах, лазания и аккуратной работы клешнями.

Скрипты всех проверок приложены в чате: `harvey_sim.py` (модель и базовые тесты), `harvey_scenarios.py` (сценарии из этого отчёта), `harvey_pybullet.py` (сверка во втором движке). Запуск: `pip install mujoco pybullet numpy`, файлы в одной папке.

## Связанные заметки

[[Харви]] · [[Сборка в Onshape и физическая проверка]] · [[Этап 1 — покупки и стенд одной ноги]] · [[код/симуляция/управление с клавиатуры/README|Скрипты симуляции]]
