iamharveststorm/harvey/заметки/Сборка в Onshape и физическая проверка.md

# Харви «Компакт» — сборка в Onshape и физическая проверка

Oct 9, 2026 · @HarvestStorm

## Физическая проверка

В симуляции MuJoCo Харви весом 2,6 кг уверенно стоит, садится, ходит и разворачивается с грузом до 1,5 кг, ни разу не выходя за пиковый момент STS3215 (2,94 Н·м). Узкое место одно: на быстрой ходьбе колени и бёдра 12–14% времени работают выше номинала (0,98 Н·м), поэтому быстрый шаг — только короткими отрезками.

Модель: корпус 150 × 140 × 70 мм, звенья ноги 40 / 51 / 70 мм (бедро удлинено с 45 — иначе приводы бедра и колена упираются; симуляция пересчитана), стопы из TPU, трение о стол 0,8. Приводы смоделированы с паспортной характеристикой «момент — скорость» (2,94 Н·м в упоре, 60° за 0,222 с без нагрузки) и инерцией редуктора 1:345. Походка — трипод с подъёмом стопы 25 мм и шагом 56 мм.

| Тест | Скорость | Пиковый момент, Н·м | Выше номинала | Мин. запас устойчивости | Мощность приводов |
| --- | --- | --- | --- | --- | --- |
| Стоит на 6 ногах, груз 0–1,5 кг | — | 0,19–0,27 (бедро) | 0% | 94–107 мм | 17–24 Вт |
| Садится и встаёт с грузом 0,5 кг | — | 0,45 (колено) | 0% | — | — |
| Ходьба комфортная, груз 0,5 кг | 12,9 см/с | 1,66 | 3–5% | 24 мм | ≈ 72 Вт |
| Ходьба быстрая, груз 0,5 кг | 17,1 см/с | 2,40 | 12–14% | 21 мм | ≈ 101 Вт |
| Ходьба медленная, груз 1 кг | 9,6 см/с | 1,27 | 1–2% | 28 мм | ≈ 55 Вт |
| Ходьба медленная, груз 1,5 кг | 9,6 см/с | 1,28 | 1–3% | 31 мм | ≈ 57 Вт |
| Разворот на месте | 47°/с | 1,43 | — | — | — |

Крен и тангаж корпуса при ходьбе не превышали 0,6°, груз на подносе ни разу не съехал. Запас устойчивости — расстояние от проекции центра масс до края опорного треугольника; он положительный во всех тестах, то есть Харви статически устойчив даже на трёх ногах.

**Клешни с пятью суставами.** Кончик достаёт до стола на 90 мм перед панцирем, полный вылет — 140 мм. С новыми клешнями Харви весит 2,6 кг, а ходьба почти не изменилась: те же 12,9 см/с и то же время работы выше номинала.

| Тест клешней | Результат |
| --- | --- |
| Держит 200 г на полностью вытянутой клешне | подъём плеча 0,40 Н·м, локоть 0,25 Н·м — около 40% номинала |
| Обводит квадрат 20 мм над столом | ошибка слежения в среднем 0,35 мм, максимум 0,7 мм; люфт шестерён добавит ещё 1–2 мм (оценка) |
| Телефон 200 г двумя клешнями со стола на спину | лёг на поднос, ни разу не задел глаза и панцирь, не съехал за 3 с ходьбы; запас устойчивости не меньше 73 мм |
| Ручка 15 г одной клешнёй со стола на спину | легла на поднос, не скатилась при ходьбе |

При быстром переносе (весь путь за 7 с) пики момента доходили до 2,9 Н·м, а за 14 с — всего 0,25 Н·м: вещи на спину Харви должен класть неторопливо. Когда телефон несут две клешни, модель держит его жёстко, и запястья упираются до предела STS3032; в жизни пальцы немного проскальзывают, но на время такого переноса запястьям стоит ограничить усилие. Чтобы рука не ложилась на панцирь и не задевала дисплеи, плечи пришлось поднять на передний верхний край панциря, а глаза сдвинуть ближе друг к другу. Хвост с присоской (версия 1.0) поднимает телефон со стола позади и кладёт на спину — с телефоном на спине Харви идёт те же 12,9 см/с, и телефон не съезжает; передача телефона с присоски клешням в воздухе пока не работает; переворот со спины с помощью хвоста получается лишь в части вариантов и ломается даже от смены модели стола, поэтому надёжным его сделает только обучение (RL).

**Батарея 50 Вт·ч.** С электроникой (\~10 Вт) непрерывная ходьба съедает её примерно за 30 минут, стоянка — за 1,5 часа, а лёжа на брюхе с отключёнными приводами Харви продержится 4 часа и больше. При обычном настольном режиме (немного ходьбы, больше покоя) выходит около 1,5–2 часов. Ток приводов посчитан по упрощённой модели, реальный может отличаться на ±30%. Вывод для поведения: в покое Харви должен ложиться на брюхо и отпускать приводы.

**Что симуляция не проверяла:** работу клешнями, лазание на ступеньки, падения и удары, нагрев приводов, люфт шестерён, гибкость печатных деталей и скользкие поверхности. Это проверяется обучением в симуляции (RL, как в Jumper) и на одной собранной ноге. Скрипт проверки `harvey_sim.py` можно запустить самому: `pip install mujoco numpy`, затем `python harvey_sim.py`.

## Подготовка

Всё строится в одном документе Onshape от общих переменных и настоящих 3D-моделей покупных деталей. Бесплатного тарифа хватает, но документы на нём публичные.

1. Создайте документ «Харви Компакт», в настройках выберите единицы — миллиметры.
2. Добавьте вкладку **Variable Studio** «Параметры» и задайте переменные: `#coxa = 40 mm`, `#femur = 51 mm`, `#tibia = 70 mm`, `#body_l = 150 mm`, `#body_w = 140 mm`, `#body_h = 70 mm`, `#wall = 2.5 mm`, `#plate = 4 mm`, `#clear = 0.3 mm` (зазор печати). Все эскизы ссылаются на них, и размеры потом меняются в одном месте.
3. Загрузите STEP-модели покупных деталей (кнопка «+» → Import):

| Деталь | Где взять модель | Если модели нет |
| --- | --- | --- |
| STS3215 | файл STS3215.stp на странице Feetech или у продавцов | блок 45,2 × 24,7 × 35 мм, вал в 12 мм от торца |
| STS3032-C036 | [[STS3032-C036 — даташит Feetech (6 В).pdf\|даташит C036]], чертёж на с. 6 | корпус 23 × 12 мм в сечении, 27,5 мм вдоль вала, валы с двух сторон; вал в ~5,7 мм от ближнего торца (по чертежу, измерить); на каждом торце 6 × M2 (шаг 9 мм, ряды через 16 мм); качалка Ø13, 8 × M2 на Ø10; 20,6 г |
| Raspberry Pi 5, Pico 2, Camera Module 3 | портал документации Raspberry Pi (pip.raspberrypi.com) | плата 85 × 56 мм с отверстиями 58 × 49 мм |
| AI HAT+ | там же | плата 65 × 56,5 мм на стойках 16 мм |
| reSpeaker Flex | вики Seeed Studio | размеры по даташиту |
| Аккумулятор 21700 | — | цилиндр Ø21 × 70 мм |
| Дисплей GC9A01 | у продавца модуля | диск Ø40 × 4 мм |

4. В каждой импортированной детали поставьте **Mate connector** на ось вала и на крепёжные отверстия: к ним будут привязаны сопряжения в сборке.
5. Назначьте массу покупным деталям (правый клик → Assign material или Override mass properties): STS3215 — 55 г, STS3032-C036 — 20,6 г, 21700 — 70 г, Pi 5 — 46 г. Печатным деталям — материал PETG (1,27 г/см³) и TPU (1,21 г/см³).

## Нога

Одна нога моделируется в отдельной вкладке **Part Studio** «Нога» и потом ставится в сборку шесть раз; левые ноги — её зеркальная копия.

1. Вставьте в Part Studio три STS3215 (Insert → Derived): основания, бедра и колена. Привод основания поверните валом вверх, бедра и колена — валом поперёк ноги.
2. Расставьте оси по переменным: ось бедра в `#coxa` от оси основания, ось колена в `#femur` от оси бедра. Привод основания поднимите над приводом бедра так, чтобы корпуса не пересекались: корпус STS3215 выходит за ось вала на 12 мм, это и заставило удлинить основание до 40 мм.
3. **Кронштейн основания**: верхняя пластина 4 мм на качалку привода основания и две боковые щёки 4 мм, между которыми зажат привод бедра. Отверстия под винты M2,5 возьмите прямо с модели привода (Use, проекция кромок).
4. **Бедро**: две пластины 4 × 18 мм по бокам привода колена, одна из них крепится к качалке привода бедра. Зазор `#clear` между пластиной и корпусом привода.
5. **Голень**: эскиз профиля от Ø20 у колена до Ø12 у стопы, Revolve, затем Shell со стенкой 2 мм и каналом под провод. Сверху — посадочное место под качалку колена.
6. **Стопа**: полусфера Ø15 из TPU, надевается на голень с натягом 0,2 мм.
7. Скругления 1–2 мм на всех внешних кромках, бобышки Ø7 мм под резьбовые вставки M2,5.
8. Левая нога: Mirror всех печатных деталей относительно плоскости симметрии; покупные приводы просто вставьте ещё раз.

## Корпус, клешни и глаза

Корпус собирается снизу вверх: плита, аккумуляторы, приводы основания, платы, панцирь.

1. **Опорная плита** `#plate` = 4 мм: эскиз скруглённого прямоугольника 145 × 135 мм, рёбра 2 мм снизу, облегчающие вырезы между рёбрами (минус \~30% массы). На плите — гнёзда под 6 приводов основания и ложемент под три банки 21700.
2. **Аккумуляторы** в ложементе по центру, над ними стойки M2,5 под Raspberry Pi 5 и AI HAT+ (стойки 16 мм идут в комплекте с HAT). Pico 2, плата защиты и преобразователи — в свободных местах спереди и сзади.
3. **Панцирь**: эскиз 150 × 140 мм со скруглением R40, Extrude на `#body_h`, скругление верхних кромок R10, затем Shell со стенкой `#wall` = 2,5 мм, открытая грань — низ. Изнутри — рёбра 1,5 мм крест-накрест.
4. В панцире: боковые вырезы под качалки и кронштейны приводов основания (с зазором на поворот ±60°), окно камеры спереди, решётка для микрофонов сверху, вентиляционные прорези над ускорителем, гнёзда под магниты 6 × 3 мм по краю.
5. **Клешни**: пять суставов на каждой: поворот плеча (STS3032), подъём плеча и локоть (STS3215), вращение запястья и захват (STS3032). Плечи — впереди передних ног, в (105; ±30; 65) мм от центра корпуса (компоновка v2, [[модели/корпус/README|модели/корпус]]), звенья 54 / 60 / ≈43 мм; привод подъёма стоит почти вертикально (β = −100°) — поворотная стойка компактная (готовая модель клешни — [[модели/клешни/README|модели/клешни]]). Пальцы длиной \~26 мм согнуты вниз на 30° относительно кисти, чтобы у стола стоять вертикально; накладки из TPU с насечкой. Присоска стоит не на клешне, а на хвосте. Хвост ([[модели/хвост/README|модели/хвост]]): колонна поворота над задним краем, поворот (STS3032), подъём (STS3215, длинной частью вниз) и локоть (STS3215), наклон запястья (STS3032), звенья 70 + 70 мм, присоска Ø22 мм на сильфоне в 26 мм от оси запястья, трубка к мини-насосу в корпусе. В покое хвост дугой над задней частью спины (присоска на 95 мм над центром) — проверено: не мешает телефону и задним ногам. Поднос на спине — 87 × 105 мм с бортиком (сзади его ограничивает колонна хвоста), телефон ложится поперёк.
6. **Глаза** ([[модели/глаза/README|модели/глаза]]): стебельки на передних углах корпуса, привод STS3032 лежит вдоль корпуса (вал вперёд), глаз наклоняется вбок: −75° наружу (сложен) … +20° внутрь. Трубка Ø11 с каналом Ø6 под кабель, заодно с задней крышкой оправы GC9A01 (модуль Ø40 × 4) с линзой из поликарбоната Ø41,5 × 1,5 мм и бампером из TPU. Стебелёк сидит на качалке через магнитную муфту (2 + 2 магнита 6 × 3 мм и два конуса-фиксатора): при ударе глаз отскакивает и встаёт обратно ровно.
7. Проверьте вес: инструмент Mass properties должен показать около 2,6 кг для всего робота. Если больше — облегчайте панцирь и плиту.

## Сборка

Во вкладке **Assembly** детали соединяются сопряжениями так, чтобы каждый сустав вращался, как настоящий.

1. Вставьте корпус и закрепите его (Fix).
2. Вставьте 6 ног: три правые и три левые (зеркальные). Привод основания каждой ноги — **Fastened** к плите по mate connector гнезда.
3. Суставы — **Revolute** по mate connector на валу привода, с пределами: основание ±60°, бедро от −60° до +100°, колено от −130° до +30° (сильнее колено не складывается — вилка голени ложится на пластины бедра; проверено leg_check.py).
4. Хвост: поворот ±120°, плечо от −110° до +180°, локоть ±165°, запястье ±160°. Клешни, все суставы Revolute: поворот плеча ±75°, подъём плеча от −15° до +175°, локоть от −105° до +130°, запястье ±180°, захват 0–60°. Стебельки глаз — Revolute (ось вдоль корпуса) от −75° до +20°. Хвост: подъём от −40° до +180°, локоть от −130° до +155°, запястье ±180°.
5. **Проверка коллизий**: в меню сборки включите показ пересечений (Show clashes). Затем покрутите каждый сустав до пределов и проверьте худшие позы: поджатые ноги, клешни, вытянутые вперёд, соседние ноги, сведённые друг к другу.
6. **Mass properties** на всю сборку: масса около 2,6 кг, центр масс примерно в центре корпуса и чуть впереди из-за клешней. Если центр масс уходит вперёд больше чем на 15 мм — перенесите аккумуляторы назад.
7. **Named positions**: сохраните позы «Рабочая стойка» (бедро +20°, голень вертикально) и «В покое» (бедро +55°, голень −10° внутрь), чтобы быстро переключаться.

## Из Onshape в симуляцию и на печать

Готовую сборку можно выгрузить прямо в физическую модель и проверить её так же, как упрощённую.

1. Установите открытый инструмент onshape-to-robot (`pip install onshape-to-robot`) и создайте ключи API в настройках Onshape (Developer → API keys).
2. В папке проекта положите `config.json` с адресом документа и форматом вывода MuJoCo или URDF, запустите `onshape-to-robot` — он соберёт модель с массами, инерциями и суставами из ваших сопряжений.
3. Подставьте полученную модель в `harvey_sim.py` вместо встроенной и прогоните те же тесты. Если моменты отличаются от таблицы выше больше чем на 20% — смотрите, где модель потяжелела.
4. Эту же модель потом используйте для обучения походки и лазания в mjlab (как в Jumper).

Настройки печати:

| Деталь | Материал | Стенки | Заполнение | Ориентация |
| --- | --- | --- | --- | --- |
| Панцирь | PETG | 3–4 периметра | 20% | куполом вверх, с поддержками внутри |
| Опорная плита, кронштейны | PETG | 4 периметра | 40% | плашмя |
| Пластины бедра | PETG | 4 периметра | 50% | на ребро, чтобы слои шли вдоль нагрузки |
| Голени, стебельки | PETG | 3 периметра | 30% | стоя, вдоль оси |
| Стопы, накладки клешней | TPU 95A | 2 периметра | 15% | плашмя |

Резьбовые вставки M2,5 вплавляйте паяльником при 230–240 °C. Начинайте печать с одной ноги и кронштейна основания: их и стоит первыми проверить на настоящих приводах.

## Связанные заметки

[[Харви]] · [[Проверка совместимости и сценарии]] · [[модели/стенд ноги/README|Детали стенда ноги]] · [[код/симуляция/управление с клавиатуры/README|Скрипты симуляции]]
