iamharveststorm/harvey/фото/Фото.md

# Фото и эскизы

Сюда: эскизы, референсы, фото стенда и сборки (jpg, png). Obsidian покажет картинку в заметке строкой `![[имя файла.jpg]]`.

Пока здесь пусто. Рендеры и картинки моделей — в [[Галерея|Галерее]].

Related: [[Харви]] · [[Галерея]]
