iamharveststorm/harvey/docs/superpowers/plans/2026-11-05-brain-assistant.md

# Харви-помощник: время, таймеры, напоминания, память — план реализации

> **For agentic workers:** REQUIRED SUB-SKILL: Use superpowers:subagent-driven-development (recommended) or superpowers:executing-plans to implement this plan task-by-task. Steps use checkbox (`- [ ]`) syntax for tracking.

**Goal:** «Харви, который час?», «поставь таймер на десять минут», «напомни через полчаса выключить чайник», «напомни в 18:30 позвонить маме», «сколько осталось?», «отмени таймер», «меня зовут Аня», «запомни, что я люблю чай», «что ты обо мне знаешь?», «забудь всё обо мне» — работают без LLM и без интернета; напоминание срабатывает само, даже если Харви «спит»; имя и факты помнятся между запусками и подсказываются LLM.

**Architecture:** В `код/мозг/harvey_brain/`: `numbers.py` (русские числа словами и цифрами → длительность / время суток), `assistant.py` (`Assistant.handle(text, wall) -> Reply | None` и `due(wall) -> list[Reply]`), `memory.py` (`Memory` — JSON-файл: имя, факты, таймеры). `Dialog._answer`: быстрые команды тела → `Assistant.handle` → LLM. `OllamaChat` получает строку о человеке из `Memory` в системное сообщение. `__main__` раз в 0,5 с спрашивает `assistant.due(time.time())` и отдаёт сработавшее как обычный ответ (голос + глаза голове).

**Tech Stack:** Python stdlib (json, datetime, re), pytest; venv `C:\venvs\harvey-brain`.

**Spec:** этот документ; решения — ведущего.

## Global Constraints
- Всё локально. Файл `~/.harvey/memory.json` (каталог как у моделей: `HARVEY_HOME`, иначе `~/.harvey`), не в репозитории; запись атомарная (временный файл + `os.replace`); битый файл — не падение, а пустая память и `memory.json.broken` рядом.
- Часы подменяются в тестах: стена — `wall: float` (epoch, местное время через `datetime.fromtimestamp`), монотонные — как сейчас в `Dialog`.
- Ответы — по-русски, коротко, с правильными окончаниями («1 минута», «2 минуты», «5 минут»; «1 час», «2 часа», «5 часов»; «1 секунда», «2 секунды», «5 секунд») — функция `plural(n, one, few, many)`.
- Код — по `.claude/skills/ub-mode/SKILL.md` (падающий тест первым). Тесты: `C:\venvs\harvey-brain\Scripts\python.exe -m pytest -q tests` из `код/мозг`; прежние 142 зелёные.

## Review Focus
1. Числа словами из распознавания: «двадцать пять минут», «полтора часа», «полчаса», «одну минуту», «пару минут» (= 2) (задача 1).
2. «Напомни в 7» вечером (сейчас 20:00) — завтра в 7:00, а не «в прошлом»; «в 7 вечера» — 19:00 (задача 1).
3. Харви выключали — при запуске напоминание, время которого прошло, срабатывает с «Пока меня не было: …», а не теряется и не срабатывает дважды (задача 3).
4. «Отмени таймер», когда таймеров два — отменяет ближайший и говорит, какой остался; когда нет — «Таймеров нет» (задача 2).
5. «Таймер» без числа — «На сколько поставить таймер?» и следующая фраза с длительностью ставит его (Харви ещё не уснул) (задача 2).

---

### Task 1: Числа и время
**Files:** Create `harvey_brain/numbers.py`; Test `tests/test_numbers.py`.

**Produces:**
- `parse_number(words: list[str], i: int) -> tuple[int | None, int]` — число с позиции i (цифры «25»; слова 0–59: «ноль»…«девятнадцать», «двадцать»…«пятьдесят» + единицы; «одну/одна/один», «две/два», «пару» = 2), возвращает (число, следующая позиция).
- `parse_duration(text: str) -> float | None` — секунды: «10 минут», «десять минут», «двадцать пять секунд», «1 час 20 минут», «час» (= 1 ч), «полчаса», «полтора часа», «полторы минуты», «пару минут»; единицы — все падежи (секунд/секунду/секунды, минут/минуту/минуты, час/часа/часов). Нет длительности — None.
- `parse_clock(text: str, wall: float) -> float | None` — epoch ближайшего будущего момента: «в 18:30», «в 18 30», «в 7», «в семь», «в семь вечера» (+12), «в восемь утра», «в 12 дня», «в половине восьмого» не нужно (None). Прошло сегодня — завтра.
- `plural(n: int, one: str, few: str, many: str) -> str` и `say_duration(seconds: float) -> str` («1 час 20 минут», «2 минуты», «45 секунд»).
- [ ] Step 1: тесты на все примеры выше + Review Focus 1–2 (стена 20:00 → «в 7» — завтра 07:00; «в 7 вечера» в 20:00 → завтра 19:00; в 10:00 → сегодня 19:00).
- [ ] Step 2: падают. Step 3: реализовать. Step 4: зелёные.

### Task 2: Помощник и память
**Files:** Create `harvey_brain/memory.py`, `harvey_brain/assistant.py`; Tests `tests/test_memory.py`, `tests/test_assistant.py`.

**Produces:**
- `Memory(path: Path)`: `name: str | None`, `facts: list[str]`, `timers: list[dict]` (`{"id": int, "due": float, "text": str | None, "seconds": float | None}`); `load()`, `save()`; `about() -> str` — «Человека зовут Аня. Он рассказывал: любит чай; …» (не больше 20 последних фактов), пусто — «».
- `Assistant(memory: Memory)`; `handle(text: str, wall: float) -> Reply | None` (текст — нормализованный остаток после «Харви»):
  - «который час», «сколько времени» → «Сейчас 14:05.»; «какое сегодня число», «какой сегодня день» → «Сегодня среда, 5 ноября.»
  - «таймер на …», «поставь таймер …», «засеки …» → «Ставлю таймер на 10 минут.» (`happy`); без длительности → «На сколько поставить таймер?» (`curious`) и следующая фраза с длительностью в течение 30 с (по `wall`) ставит его.
  - «напомни через … <текст>» и «напомни в … <текст>» → «Хорошо, напомню в 18:30: позвонить маме.»; без текста — «Хорошо, напомню через 20 минут.»
  - «сколько осталось» → по ближайшему: «Осталось 7 минут.»; нет — «Таймеров нет.»
  - «отмени таймер», «отмени напоминание» → отменяет ближайший: «Отменил. Остался таймер на 18:30.» / «Отменил.»; «отмени все таймеры» → все; нет — «Таймеров нет.»
  - «меня зовут <имя>» → «Приятно познакомиться, Аня!» (`love`); «как меня зовут» → «Тебя зовут Аня.» / «Ты ещё не сказал, как тебя зовут.»
  - «запомни что <факт>» / «запомни <факт>» → «Запомнил.»; «что ты обо мне знаешь» → имя и до 5 фактов; «забудь всё обо мне» → чистит имя и факты (таймеры остаются) → «Хорошо, забыл.»
  - иное → None (дальше — LLM).
  - Каждое изменение — `memory.save()`.
- `due(wall: float) -> list[Reply]` — сработавшие (`due <= wall`), удаляет их и сохраняет: таймер — «Динь! Прошло 10 минут.» (`surprised`), напоминание — «Напоминаю: позвонить маме.» (`curious`); если просрочено больше чем на 60 с — «Пока меня не было: …».
- [ ] Step 1: тесты на каждую фразу выше, Review Focus 3–5, атомарную запись и битый файл (`memory.json.broken`), «Харви» с именем «Аня» — `about()` содержит «Аня».
- [ ] Step 2: падают. Step 3: реализовать. Step 4: зелёные.

### Task 3: Подключение к диалогу, LLM и запуску
**Files:** Modify `harvey_brain/dialog.py`, `harvey_brain/llm.py`, `harvey_brain/__main__.py`, `код/мозг/README.md`, `CLAUDE.md` (строка `код/мозг/`), `заметки/Журнал решений.md` (2026-11-05); Tests — дополнить `tests/test_dialog.py`, `tests/test_llm.py`, `tests/test_main.py`.

**Produces:**
- `Dialog(llm, assistant=None, follow_s=8.0, wall_fn=time.time)`: `_answer` = quick_reply → `assistant.handle(rest, wall_fn())` → `llm.ask`; цели LLM — как сейчас (только по просьбе).
- `OllamaChat(..., about=lambda: "")` — непустая строка `about()` добавляется вторым system-сообщением.
- `__main__`: `--home PATH` (иначе `HARVEY_HOME` / `~/.harvey`), `Memory` + `Assistant`; раз в 0,5 с `assistant.due(time.time())` → каждый ответ как обычный (печать, голос при `--voice`/`--mic`, голове `to_head`) и `Dialog` бодрствует ещё `follow_s` (чтобы «отмени» без «Харви» сработало).
- README: что умеет помощник, где лежит память, как её стереть («забудь всё обо мне» или удалить файл).
- [ ] Step 1: тесты — «Харви, который час» не зовёт LLM; «как дела» зовёт LLM; `OllamaChat` с `about` → в payload два system; `main` с поддельными часами: «Харви, таймер на 1 минуту», затем часы +61 с → печать «Харви: Динь! Прошло 1 минута.» — **внимание:** правильно «Прошла 1 минута» / «Прошло 2 минуты» / «Прошло 5 минут» — согласовать глагол (`plural` для «Прошла/Прошло/Прошло»).
- [ ] Step 2: падают. Step 3: реализовать. Step 4: зелёные; все тесты мозга зелёные.
