iamharveststorm/harvey/docs/superpowers/plans/2026-11-05-brain-sim.md

# Мозг ведёт Харви в симуляции — план реализации

> **For agentic workers:** REQUIRED SUB-SKILL: Use superpowers:subagent-driven-development (recommended) or superpowers:executing-plans to implement this plan task-by-task. Steps use checkbox (`- [ ]`) syntax for tracking.

**Goal:** Пользователь набирает в окне мозга «Харви, иди домой» — Харви в окне MuJoCo идёт к станции; «Харви, посмотри на меня» — осматривается; «иди ко мне» — идёт к руке; эмоции ответа видны (глаза в консоли и картинкой). Вся цепочка настоящая: мозг (`harvey_brain`, TCP :8765) → голова (`Head` + `Body`, как на Pi) → прошивка RP2350 (`Spine` в `SimRobot`) → робот.

**Architecture:** Новый скрипт `код/симуляция/мини/mini_brain.py`. Голова в симуляции подключается к мозгу настоящим `harvey_head.links.BrainLink`, который крутится в отдельном потоке со своим asyncio-циклом (`ThreadedBrain`: `poll()` и `offer()` потокобезопасны). Цикл симуляции — как `mini_behave.run`: физика, голова 50 раз в секунду, перед каждым тиком головы — сообщения мозга в `Head.on_brain`; темп — реальное время (кроме `--fast`). Мозг — отдельный процесс в своём окне (`harvey-brain` venv), его запускает сам `mini_brain.py --with-brain` (пути с кириллицей — из Python, не из .bat).

**Tech Stack:** Python, MuJoCo (venv `C:\venvs\harvey`), asyncio + threading, `harvey_brain` (stdlib-часть: `server.py` для тестов).

**Spec:** этот документ; решения — ведущего.

## Global Constraints
- Голову, прошивку и мозг не менять, кроме явно названного ниже. Если без правки не обойтись — эскалация, не тихая правка.
- `.bat` — только ASCII и CRLF; путь к `код/мозг` вычисляет Python.
- Тесты — `C:\venvs\harvey\Scripts\python.exe -m pytest -q tests` из `код/симуляция/мини`; все прежние тесты симуляции зелёные; окно MuJoCo в тестах не открывается.
- Пути вне своей папки (`код/голова`, `код/мозг`) — и как есть, и через `resolve()`.
- Код — по `.claude/skills/ub-mode/SKILL.md` (падающий тест первым).

## Review Focus
1. Мозг не запущен — симуляция работает, голова ведёт себя сама (как без ПК), раз в 5 с пробует подключиться; в консоли «мозг не на связи» один раз, а не каждый тик (задача 1).
2. Мозг закрыли посреди пути домой — Харви продолжает идти домой (цель уже у головы), без падения скрипта (задача 2).
3. Цель «hand» на сцене без руки — Харви осматривается и не падает со стола (задача 2: в сцене рука есть всегда, тест — что она видна из старта).
4. Две команды подряд («иди домой», через 2 с «стоп») — вторая отменяет первую (`idle`) (задача 2).
5. Закрыли окно MuJoCo — поток связи и окно мозга (если запускали `--with-brain`) закрываются, процесс не висит (задача 3).

---

### Task 1: ThreadedBrain
**Files:** Create `код/симуляция/мини/mini_brain.py` (пока только класс); Test `код/симуляция/мини/tests/test_brain_link.py`.

**Produces:** `ThreadedBrain(host: str = "127.0.0.1", port: int = 8765)`; `start() -> None` (поток-демон с `asyncio.run(link.run(stop))`); `poll() -> list[dict]` (все накопленные сообщения от мозга, без блокировки); `offer(msg: dict) -> None` (потокобезопасно в `BrainLink.outbox` через `loop.call_soon_threadsafe`); `connected -> bool`; `close(timeout: float = 2.0) -> None`. Совместим с `Head(brain=...)` (голова зовёт только `offer`).

- [ ] Step 1: тесты с настоящим `harvey_brain.server.HeadServer` в отдельном потоке на свободном порту: после подключения `poll()` содержит `{"t": "link", "brain": "up"}`; `server.send({"t":"goal","goal":"home"})` → появляется в `poll()`; `offer({"t":"ev","ev":"lifted"})` → в `server.inbox`; без сервера `poll()` → `[]`, `connected is False`, `close()` за ≤ 2 с.
- [ ] Step 2: падают. Step 3: реализовать. Step 4: зелёные.

### Task 2: Живая сцена и цикл
**Files:** Modify `mini_brain.py`; Test `tests/test_brain_sim.py`.

**Produces:**
- `make_robot() -> mr.SimRobot` — стол `mini_behave.HOME_TABLE`, станция `mini_behave.DOCK`, рука неподвижно спереди-слева в 0,25 м (видна из старта), старт `(-0.15, 0.0, 0.0)`.
- `class Session(robot, brain, now_fn=time.monotonic, fast: bool = False)`: собирает `Body` + `Head(port, brain=brain, body=body)` как `mini_behave.run`; `step() -> None` — один шаг физики; на тике головы — `brain.poll()` → `head.on_brain(msg, robot.t)`; в реальном времени ждёт, чтобы `robot.t` не обгонял часы (при `fast` — не ждёт); `events() -> list[str]` — строки для консоли при смене состояния поведения или выражения глаз: «Поведение: home_search», «Глаза: happy».
- [ ] Step 1: тесты (`fast=True`, поддельный brain: список сообщений по времени): `{"t":"goal","goal":"home"}` на 0,5 с → за ≤ 120 с симуляции состояние `docked`; `{"t":"emote","name":"happy","s":3}` → в `events()` «Глаза: happy»; «home», затем через 2 с `{"t":"goal","goal":"idle"}` → состояние `idle`; brain «отключился» (poll возвращает `{"t":"link","brain":"down"}`) посреди «home» → дошёл до `docked`; телеметрия идёт в `brain.offer`.
- [ ] Step 2: падают. Step 3: реализовать. Step 4: зелёные.

### Task 3: Запуск, окно, мозг в своём окне
**Files:** Modify `mini_brain.py` (`main`), Create `код/симуляция/мини/run_brain_sim.bat`; Modify `код/симуляция/мини/README.md`, `CLAUDE.md` (строка `код/симуляция/` — `mini_brain.py`), `заметки/Журнал решений.md` (строка 2026-11-05).

**Produces:**
- `python mini_brain.py [--with-brain] [--headless] [--fast] [--port 8765] [--seconds N]`: окно `mujoco.viewer.launch_passive` (как в `harvey_mini_teleop.py`), камера следит за Харви; `--headless` — без окна, только консоль (для проверки). Печатает `events()`.
- `brain_command(port: int) -> tuple[list[str], Path]` — `["C:/venvs/harvey-brain/Scripts/python.exe", "-m", "harvey_brain", "--text", "--port", str(port)]` (venv — из env `HARVEY_BRAIN_VENV`, иначе этот путь) и cwd = найденная `код/мозг`; с `--with-brain` — `subprocess.Popen(..., creationflags=subprocess.CREATE_NEW_CONSOLE)`, при выходе — `terminate()`.
- `run_brain_sim.bat` (ASCII, CRLF, по образцу `run_mini_windows.bat`): `python mini_brain.py --with-brain %*`.
- README: «Мозг ведёт Харви»: запуск, что набирать в окне мозга, что видно.
- [ ] Step 1: тесты — `brain_command(9000)` → список и cwd с `harvey_brain`; разбор аргументов; `--headless --fast --seconds 5` с поддельным brain завершается с кодом 0; при выходе вызывается `terminate()` у поддельного Popen.
- [ ] Step 2: падают. Step 3: реализовать. Step 4: зелёные; все тесты симуляции зелёные.
- [ ] Step 5: ведущему — вывод `--headless --fast --seconds 60` с настоящим мозгом без LLM нельзя (нужен ввод) → вместо этого интеграционный прогон: настоящий `HeadServer` в потоке шлёт «home» — лог `events()` до `docked`.
