iamharveststorm/harvey/docs/superpowers/plans/2026-11-03-mini-behaviour.md

# Поведение «Компакт мини» в симуляции по своим датчикам — план

> **For agentic workers:** REQUIRED SUB-SKILL: Use superpowers:subagent-driven-development (recommended) or superpowers:executing-plans to implement this plan task-by-task. Steps use checkbox (`- [ ]`) syntax for tracking.

**Goal:** Харви в MuJoCo ведёт себя только по своим датчикам: идёт домой по ИК-маяку, уходит от края, осматривается, подходит к руке, отпускает приводы, когда его подняли.

**Architecture:** Имитации датчиков (лучи VL53L4CD, ИК-приёмники, IMU, INA226, шины приводов) подключаются к **настоящему** `Spine` из прошивки RP2350 — так в симуляции работают `edge.py`, `reflex.py`, `beacon.py`, `imu_events.py` и протокол `link.py` без изменений. Поведение — чистый модуль головы (`harvey_head/behavior.py`): получает телеметрию и события, отдаёт команду корпусу. Связка «команда → походка → цели суставов → `j`» в симуляции заменяет будущий модуль походки головы.

**Tech Stack:** Python 3.14, MuJoCo, pytest; окружения `C:\venvs\harvey` (симуляция), `C:\venvs\harvey-head` (голова).

**Spec:** описание в разговоре от 03.11.2026, одобрено пользователем («всё верно, делай»): датчики в симуляции → настоящий код прошивки; поведение — отдельный модуль, который переедет в голову; 4 сценария (домой по маяку, у края, осмотреться, подойти к руке с заглушкой зрения по кадру 100°), «подняли — отпустить приводы»; тесты с нормами; числа, которых нет в даташитах, — «предварительно».

## Global Constraints

- Прошивку RP2350 (`код/прошивка/rp2350/*.py`) не менять ради симуляции: имитации подстраиваются под её интерфейсы (`EdgeArray(make=…)`, `imu.read() → (acc g, gyr °/с)`, `ina.volts()/amps()`, `beacon.take() → (L, R)`, `bus.sync_write(reg, {id: pos})`, `bus.release_all()`).
- Протокол — `link.py`: `v` в мм/с и °/с; ID = 10 × конечность + сустав (схемы/README.md «Номера приводов»): LF 1, LM 2, LB 3, RF 4, RM 5, RB 6, клешни L 7, R 8 (суставы y p e g = 1–4), глаза 91, 92; ноги c f k = 1–3.
- Позиция STS: 4096 на оборот, 2048 — ноль сустава (предварительно: нули задаются при сборке).
- Числа датчиков — из `документы/`:
  - TSAL6200: Ie тип. 72 мВт/ср при 100 мА, угол половинной силы ±17° (стр. 2);
  - TSOP382: Ee min до 0,25 мВт/м² (NEC, макс.), Ee max 30 Вт/м², половинная дальность ±45° (стр. 2–3);
  - маяк: пик 105 мА, 508 пачек/с (схемы/README.md «Станция»).
- Модель угловых кривых — `cos^n` по этим точкам (LED n = 15,9; приёмник — чувствительность ∝ cos⁴, т. к. дальность ∝ √E) — **предварительно, проверить на стенде**.
- Геометрия датчиков края — как `edge_seen` в `harvey_mini_teleop.py` (передние/задние 2,3 : 1, боковые 3,5 : 1); ИК-приёмники — `ir_axis` из CAD; камера — `harvey_eye` (x 66,2 мм, поле ≈ 100° по горизонтали).
- Правила кода: ub-mode (тест → минимум → чистка), CRAP < 10, без дублей ≥ 0,8; пути к файлам вне папки в тестах — и с `absolute()`, и с `resolve()`.

## Review Focus

1. Маяк сзади станции (башенка заслоняет) — поведение не крутится бесконечно, а сообщает «не вижу станцию» после полного оборота.
2. Край во время захода на станцию или осмотра — рефлекс `Spine` всё равно останавливает; поведение уходит в «у края».
3. Подняли посреди любого сценария — приводы отпущены, после возвращения на стол поведение начинает с «осмотреться», а не продолжает старую команду.
4. Рука вышла из кадра при подходе — остановиться и искать, а не идти по последнему направлению.
5. Контакты станции не замкнулись после «лечь» — встать, отойти и повторить заход один раз, потом сдаться.

---

### Task 1: общая походка по команде скорости и стол с краями

**Files:**
- Modify: `код/симуляция/мини/harvey_mini.py` (класс `Walker`, `CAMERA`, `contact_force`, `table_xml`)
- Modify: `код/симуляция/мини/harvey_mini_teleop.py` (`TeleopSim.step` — через `Walker`; `CAMERA`, `_contacts_charging` — из `harvey_mini`)
- Test: `код/симуляция/мини/tests/test_mini.py`

**Interfaces — Produces:**
- `Walker(sim: Mini)`; `walker.step(cmd: np.ndarray[3] (vx м/с, vy м/с, wz рад/с), dz: float = 0.0, pitch: float = 0.0, t_half: float = 0.30) -> None` — плавный разгон 0,0004 за шаг, фаза треноги, IK ног в `sim.q`. Поле `walker.vel`.
- `CAMERA: str` (тот же XML, что сейчас в teleop).
- `contact_force(m, d, geom_a: int, geom_b: int) -> float` — сумма нормальных сил.
- `table_xml(x0, x1, y0, y1) -> str` — столешница-ящик (верх z = 0) и пол на 0,75 м ниже.

- [ ] Тест `test_walker_walks_at_commanded_speed`: `Walker` с `cmd=(0.06,0,0)` 6 с → скорость 5–8 см/с, увод < 15 мм.
- [ ] Тест `test_table_has_edges`: на `table_xml(-0.3, 0.3, -0.3, 0.3)` луч вниз в (0,4; 0) попадает в пол на 0,75 м.
- [ ] Увидеть FAIL, реализовать, PASS; прогнать все тесты симуляции (69 + новые) — teleop тесты зелёные.
- [ ] Коммит.

### Task 2: имитации датчиков и шин для настоящего `Spine`

**Files:**
- Create: `код/симуляция/мини/mini_sensors.py`
- Test: `код/симуляция/мини/tests/test_sensors.py`

**Interfaces — Consumes:** Task 1. **Produces:**
- `FIRMWARE: Path` — `код/прошивка/rp2350` (добавляется в `sys.path`).
- `EDGE_RAYS: list[(origin_body(3), dir_body(3))]` в порядке `pins.EDGE_NAMES`.
- `tof_factory(sim) -> make` для `EdgeArray(make=…)`; объект: `set_address, init, start, ready() -> True, measure() -> (мм, статус)`; нет цели или > 1300 мм → `SIGNAL_TOO_WEAK`.
- `SimImu(sim).read() -> (acc g, gyr °/с)` в системе корпуса (из `sensordata` акселерометра и гироскопа на торсе).
- `SimIna(sim, charging: Callable[[], bool]).volts() -> 7.4`, `.amps() -> -0.5` при заряде, иначе `+1.0` (предварительно).
- `SimBeacon(sim, led_world(3)).take() -> (L, R)`: 51 пачка за окно, если `Ee·s(φ) ≥ 0,25 мВт/м²`, `Ee ≤ 30 Вт/м²` и луч до светодиода не закрыт, иначе 0.
- `SimBus(sim, ids)`: `sync_write(42, {id: pos})` → `sim.q`; `release_all()` → `sim.relaxed = True` (в `Mini.step` момент 0).
- `see_hand(sim, hand_body: str) -> dict | None` → `{"bearing_deg", "dist_mm"}`, если рука в ±50° по горизонтали, ±33,5° по вертикали, ближе 600 мм и не закрыта.
- `SERVO_IDS: dict[str, int]`, `to_pos(rad) -> int`, `to_rad(pos) -> float`.

- [ ] Тесты: на ровном столе 6 датчиков дают расстояние по геометрии луча ±2 мм; у края (корпус в 40 мм от края по +x) `far` передних = 1 после калибровки, задних = 0; маяк прямо в 30 см → оба ≥ `SEEN_MIN`, `bearing == "ahead"`; маяк сзади-сбоку 120° → `"none"`; маяк сбоку 70° слева → только левый; станция за башенкой → `"none"`; `to_rad(to_pos(x)) ≈ x`; рука за спиной → `None`, рука в 30 см прямо → `dist_mm` 300 ± 15.
- [ ] FAIL → реализация → PASS → коммит.

### Task 3: робот в симуляции целиком

**Files:**
- Create: `код/симуляция/мини/mini_robot.py`
- Test: `код/симуляция/мини/tests/test_robot.py`

**Interfaces — Produces:** `SimRobot(world: str = "table", dock_pos=(x, y) | None, start=(x, y, yaw_deg), hand=(x, y) | None)`:
- `.step(cmd: dict)` — один шаг 5 мс: команда `{"v": (мм/с, мм/с, °/с), "pose": "stand"|"lie"}` → `Walker` → `link.joints(q, v)` → порт → настоящий `Spine.step()` (рефлексы, телеметрия 20 Гц) → `SimBus` → физика;
- `.tel: dict` (последняя `tel`), `.events: list[str]` (новые с прошлого шага);
- `.vision() -> dict | None`, `.on_table() -> bool`, `.charging() -> bool`, `.pose() -> (x, y, yaw_deg)`, `.lift(sec)` — поднять силой за торс;
- при `relaxed` команды движения игнорирует, пока не придёт новая.

- [ ] Тесты: `cal` при старте даёт 6 опорных расстояний; ход вперёд к краю стола → `Spine` шлёт `edge`, робот на столе, все стопы на столешнице; `lift(0.5)` → событие `lifted`, `tel["relaxed"] == 1`.
- [ ] FAIL → реализация → PASS → коммит.

### Task 4: поведение (голова)

**Files:**
- Create: `код/голова/harvey_head/behavior.py`
- Test: `код/голова/tests/test_behavior.py`

**Interfaces — Produces:** `Behavior(now: float)`; `.update(tel: dict, events: list[str], vision: dict | None, now: float) -> dict` → `{"v": (vx, vy, wz), "pose": "stand"|"lie", "state": str}`; `.request(goal: "home"|"look"|"hand")`; `.state: str`.

Состояния и правила (числа — мои, предварительно):
- `look`: поворот 40 °/с по кругу, 6 остановок по 1 с; рука в кадре → `hand`; круг пройден → `idle`.
- `hand`: поворот к `bearing_deg` (|угол| > 8° — поворот 30 °/с × знак), идти 40 мм/с, стоп при `dist_mm ≤ 90`; рука пропала > 0,5 с → `look`.
- `edge` (событие `edge` или `far` в сторону движения): назад 30 мм/с 1,5 с, поворот на 120° (по времени), затем прежняя цель.
- `home`: `search` — поворот 30 °/с, пока `beacon == "none"`, полный оборот без маяка → `lost`; `center` — проход сектора «ahead» на 20 °/с: время входа и выхода, поворот назад на половину; `approach` — вперёд 40 мм/с с повторным центрированием каждые 4 с; `climb` — тангаж вырос ≥ 1,5° (передние ноги на площадке) → ещё 1,6 с вперёд → ровно (|тангаж| < 0,8°) → `lie`; `lie` → событие `docked` или ток < −50 мА за 3 с → `docked`, иначе один повтор: встать, назад 2 с, снова `search`; второй раз → `failed`.
- `lifted` → `pose: relax`-ожидание, без движения; все `far == 0` 1 с подряд → `look`.
- `bat_low` → `home`.

- [ ] Тесты (чистые, без MuJoCo) на каждое правило выше, включая все 5 строк Review Focus.
- [ ] FAIL → реализация → PASS (все 83 + новые тесты головы) → коммит.

### Task 5: сценарии с нормами

**Files:**
- Create: `код/симуляция/мини/mini_behave.py` (`python mini_behave.py` → `behave_results.json`)
- Test: `код/симуляция/мини/tests/test_behave.py`

**Interfaces — Consumes:** Task 3 `SimRobot`, Task 4 `Behavior` (импорт по пути `код/голова`).
`run(goal, robot: SimRobot, limit_s: float) -> dict`; `scenario_home(start) / scenario_edge(heading) / scenario_look() / scenario_hand(hand) / scenario_lift()`.

Нормы (мои, предварительно):
- домой: 10 стартов в секторе ±20° от оси станции, 15–35 см, курс ±30° → заряжается ≥ 8 из 10, ≤ 40 с; ещё 6 стартов шире (±60°) — только в отчёт;
- старт за станцией → `lost` за ≤ 20 с, на столе;
- край: идти к каждому из 4 краёв → ни разу не упал, ушёл от края ≥ 30 мм, наклон < 5°;
- осмотр: поворот 360° ± 30°, ≤ 20 с, сдвиг корпуса < 30 мм;
- рука в 30 см под 30° → остановился в 70–110 мм от руки за ≤ 15 с; рука сзади → найдена осмотром;
- подняли → `relaxed` за ≤ 0,2 с.

- [ ] Тесты по нормам → FAIL → реализация → PASS → коммит.

### Task 6: документы и проверка качества

**Files:** `код/симуляция/мини/README.md`, `код/голова/README.md`, `заметки/Журнал решений.md`, `CLAUDE.md` (строка о `mini_behave.py`).

- [ ] Все наборы тестов: симуляция, голова, RP2350 (не тронута — 138 зелёных).
- [ ] crapper < 10 и dryer по новым файлам; mutator по `behavior.py`.
- [ ] Итоги сценариев и найденное (точность маяка, промах станции) — в README и журнал; коммит; `git push --all; git push --tags`.

---

## Итог выполнения (03.11.2026) — что пошло не по плану

- **Подъём на площадку по тангажу не работает:** стопы шире площадки 64 × 56 мм и на неё не наступают. Остановка над контактами — по передним датчикам края: площадка (−11 мм), снова стол, башенка; отступ 0,45 с.
- **Повороты по времени ошибались на ~20°** → в телеметрию RP2350 добавлен `gyr`, повороты — на угол по гироскопу (правка прошивки с тестом, хотя план говорил «прошивку не менять»: это нужно и настоящему роботу).
- **Один ИК-маяк не выводит на ось станции** → домой по метке AprilTag (заглушка «зрения» `see_tag`), маяк — запасной путь; центрирование по маяку — проход сектора туда и обратно (гасит опоздание окна 100 мс).
- **Калибровка носом к предмету** → `edge.baseline(nominal, tol)` и `pins.EDGE_NOMINAL_MM`.
- **Заряд в модели засчитывался касанием любого места брюха** → только под латунными пластинами.
- Повторное центрирование на заходе не понадобилось: курс держит гироскоп, сдвиг вбок — метка.
- «Зрение» — словарь находок `{"hand": …, "dock": …}`.
- Нормы домой: по метке 10 стартов из 10 (план: ≥ 8 из 10).
