iamharveststorm/harvey/код/голова/глаза_анимация.gif

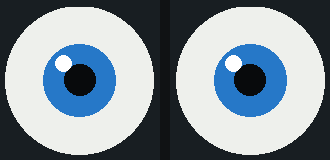
код/голова/глаза_анимация.gif
