iamharveststorm/harvey/код/голова/глаза_выражения.png

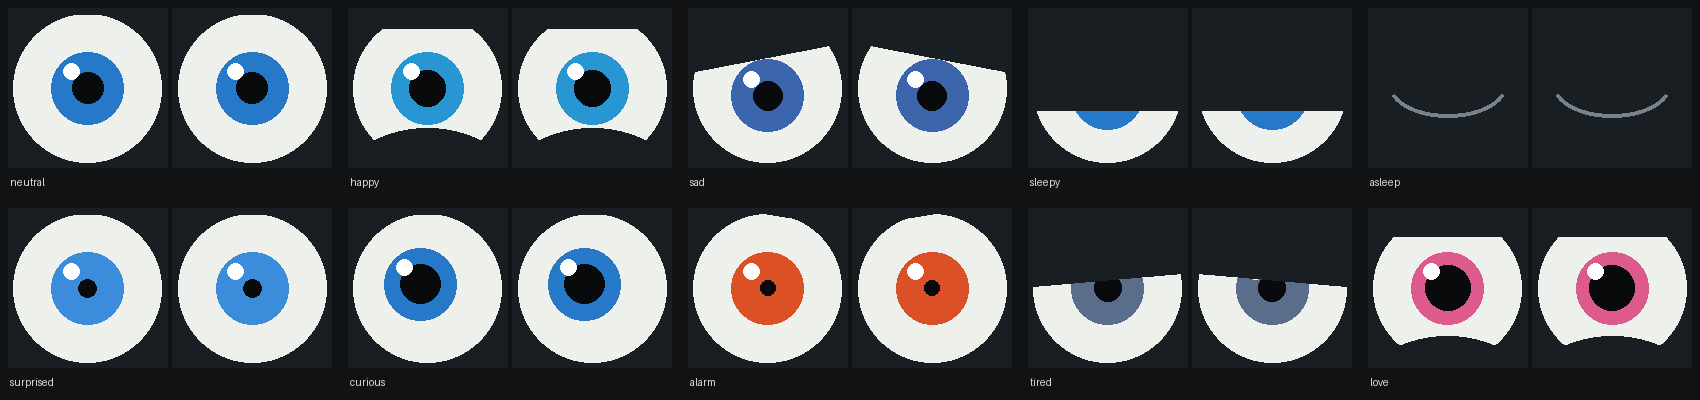
код/голова/глаза_выражения.png
