iamharveststorm/harvey/код/симуляция/мини/mini_глазами_Харви.png

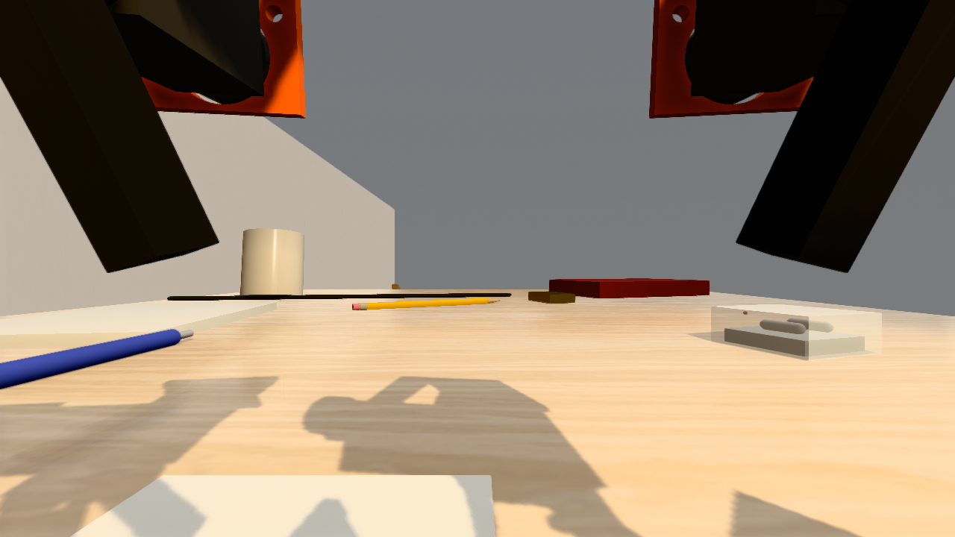
код/симуляция/мини/mini_глазами_Харви.png
