iamharveststorm/harvey/код/симуляция/мини/mini_и_предметы.png

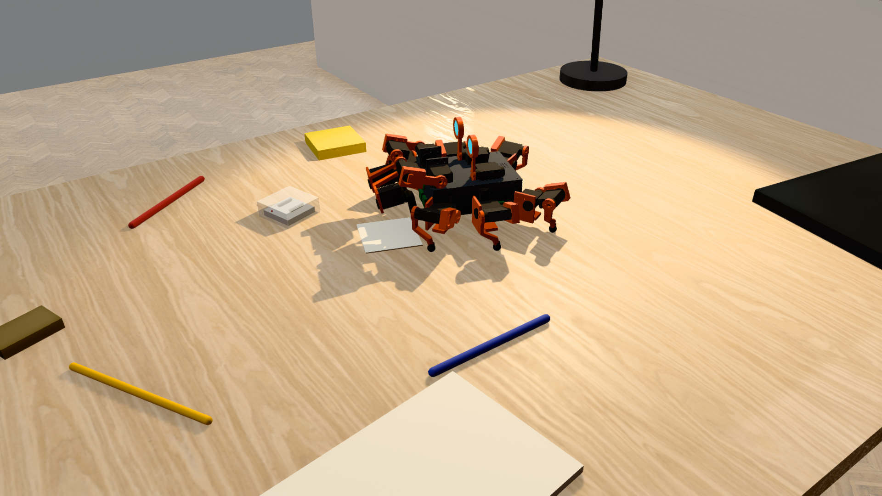
код/симуляция/мини/mini_и_предметы.png
