iamharveststorm/harvey/код/симуляция/мини/mini_привет.png

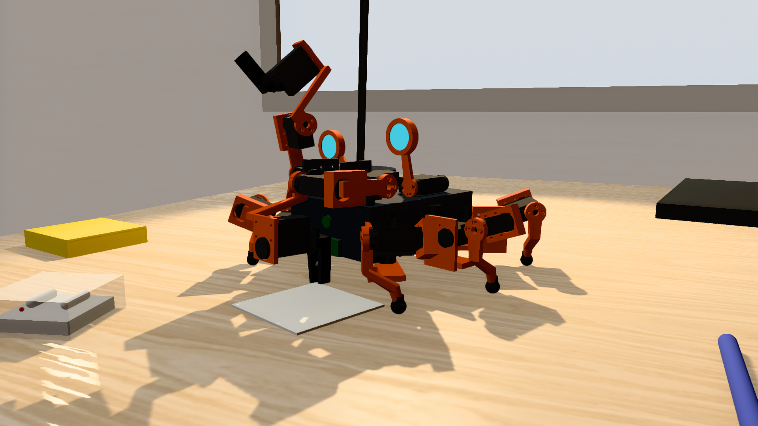
код/симуляция/мини/mini_привет.png
