iamharveststorm/harvey/код/симуляция/мини/mini_салфетка.png

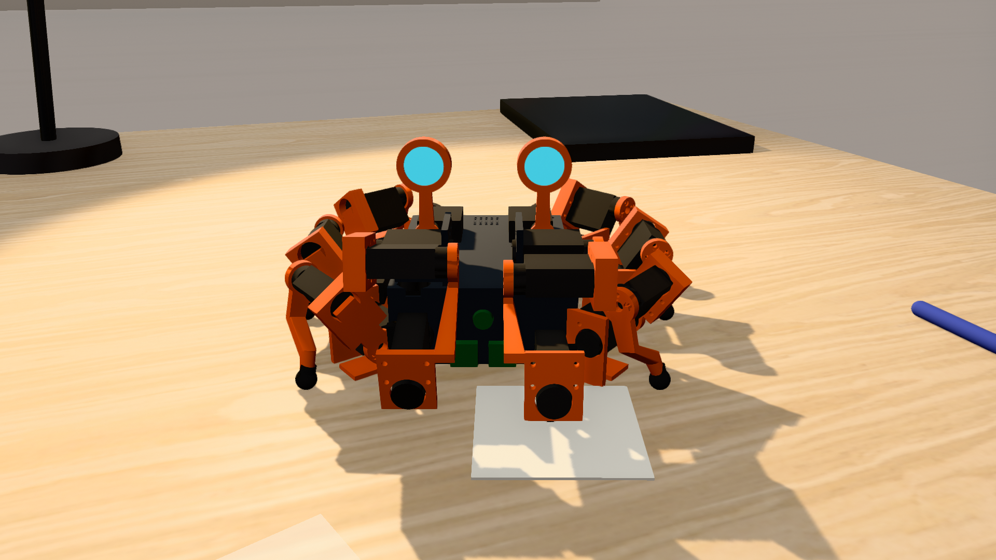
код/симуляция/мини/mini_салфетка.png
