iamharveststorm/harvey/код/симуляция/мини/mini_стол.png

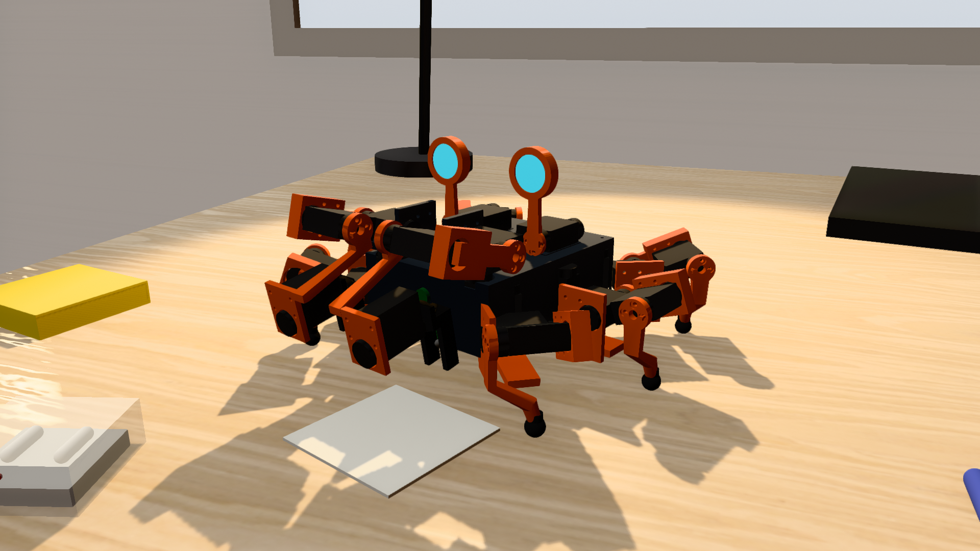
код/симуляция/мини/mini_стол.png
