iamharveststorm/harvey/код/симуляция/мини/mini_управление.png

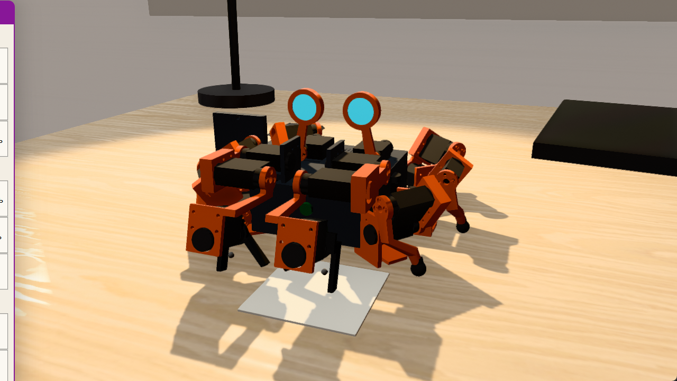
код/симуляция/мини/mini_управление.png
