iamharveststorm/harvey/код/симуляция/управление с клавиатуры/assets/world/asphalt_n.png

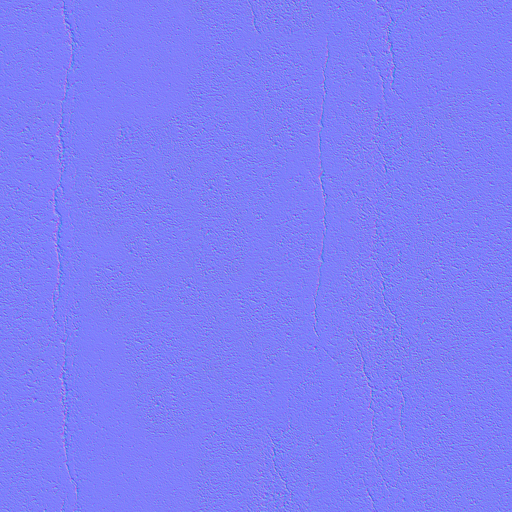
код/симуляция/управление с клавиатуры/assets/world/asphalt_n.png
