iamharveststorm/harvey/код/симуляция/управление с клавиатуры/assets/world/concrete.png

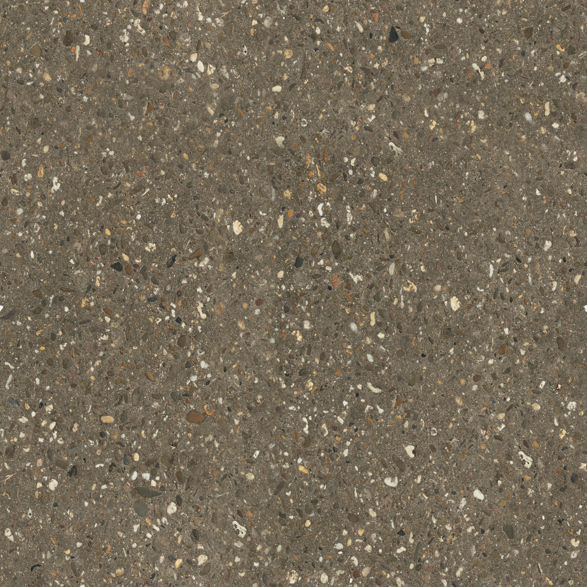
код/симуляция/управление с клавиатуры/assets/world/concrete.png
