iamharveststorm/harvey/код/симуляция/управление с клавиатуры/assets/world/concrete_orm.png

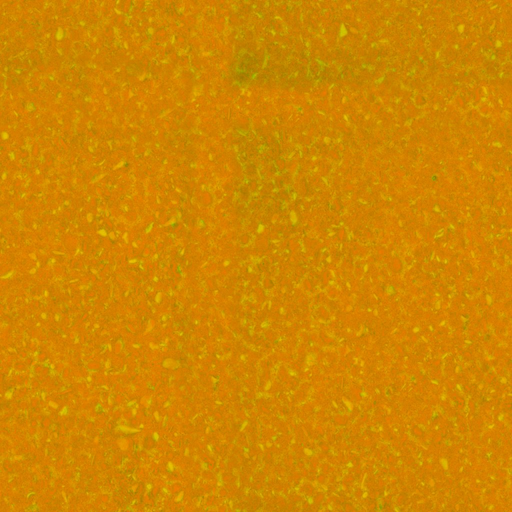
код/симуляция/управление с клавиатуры/assets/world/concrete_orm.png
