iamharveststorm/harvey/код/симуляция/управление с клавиатуры/assets/world/grass.png

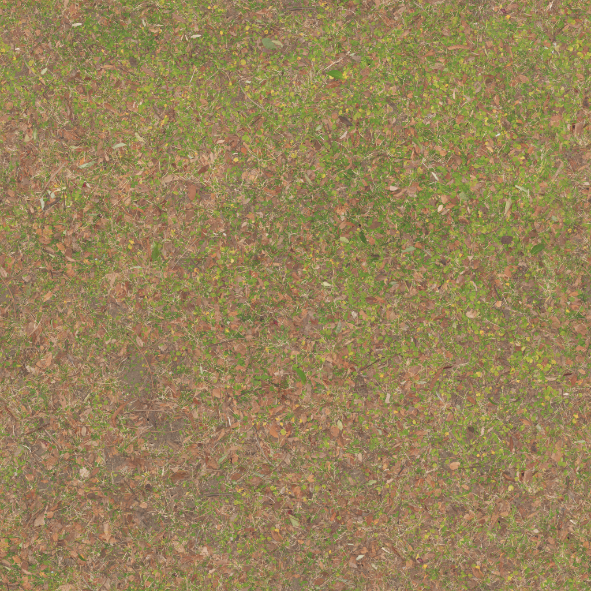
код/симуляция/управление с клавиатуры/assets/world/grass.png
