iamharveststorm/harvey/код/симуляция/управление с клавиатуры/assets/world/grass_h.png

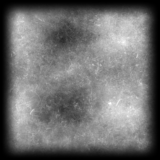
код/симуляция/управление с клавиатуры/assets/world/grass_h.png
