iamharveststorm/harvey/код/симуляция/управление с клавиатуры/assets/world/grass_n.png

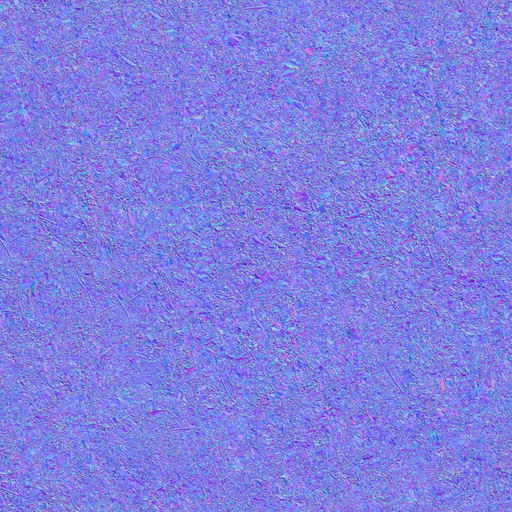
код/симуляция/управление с клавиатуры/assets/world/grass_n.png
