iamharveststorm/harvey/код/симуляция/управление с клавиатуры/assets/world/grass_orm.png

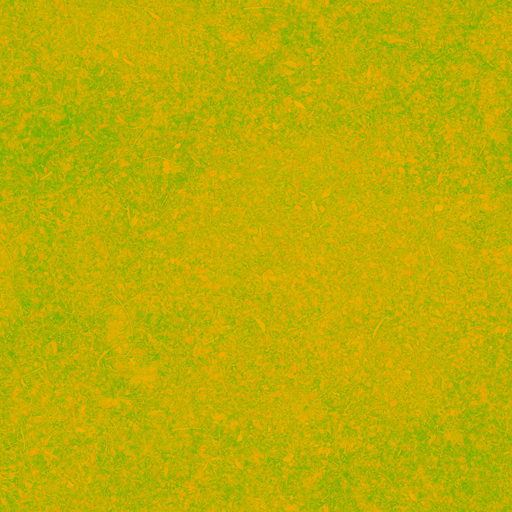
код/симуляция/управление с клавиатуры/assets/world/grass_orm.png
