iamharveststorm/harvey/код/симуляция/управление с клавиатуры/assets/world/gravel.png

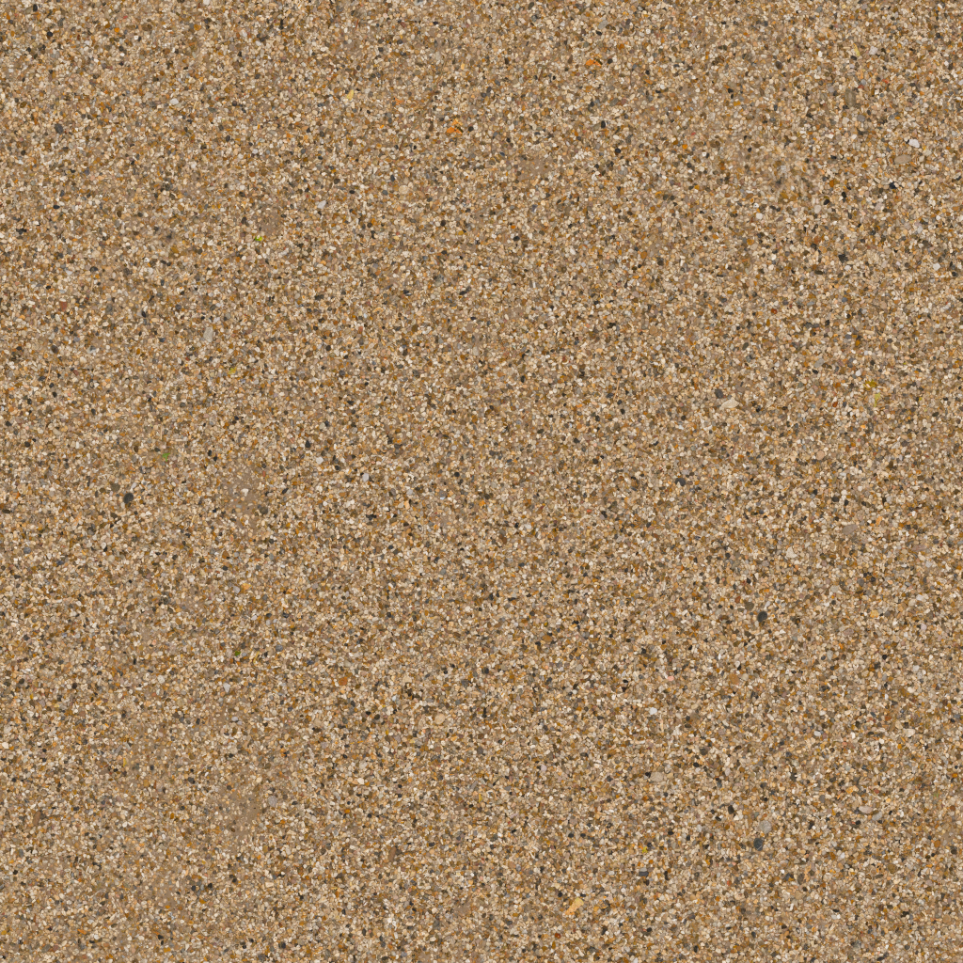
код/симуляция/управление с клавиатуры/assets/world/gravel.png
