iamharveststorm/harvey/код/симуляция/управление с клавиатуры/assets/world/gravel_h.png

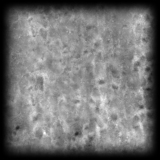
код/симуляция/управление с клавиатуры/assets/world/gravel_h.png
