iamharveststorm/harvey/код/симуляция/управление с клавиатуры/assets/world/gravel_n.png

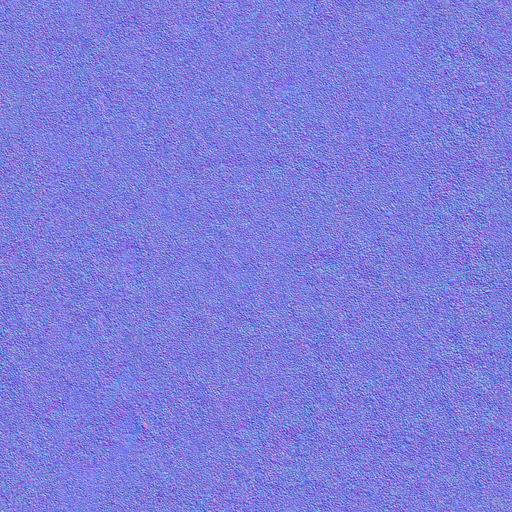
код/симуляция/управление с клавиатуры/assets/world/gravel_n.png
