iamharveststorm/harvey/код/симуляция/управление с клавиатуры/assets/world/gravel_orm.png

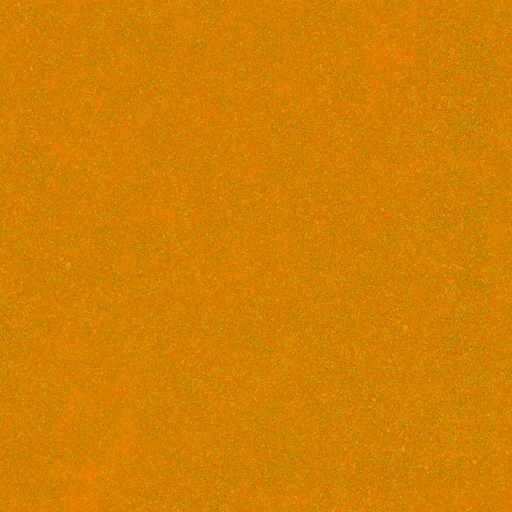
код/симуляция/управление с клавиатуры/assets/world/gravel_orm.png
