iamharveststorm/harvey/код/симуляция/управление с клавиатуры/assets/world/oak.png

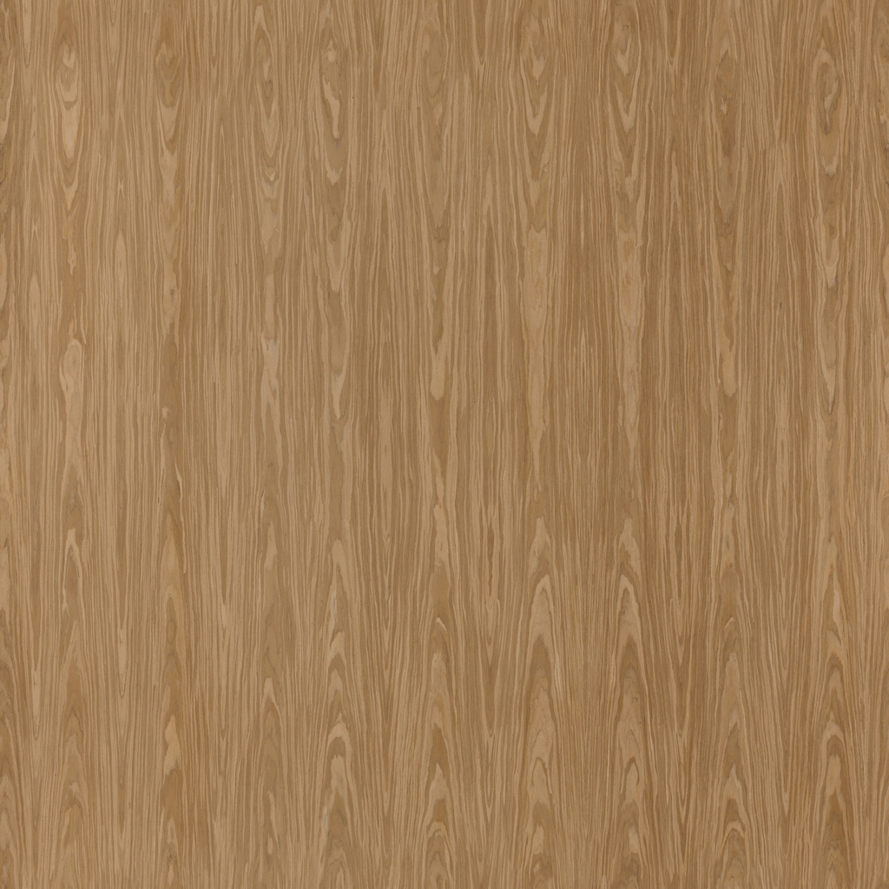
код/симуляция/управление с клавиатуры/assets/world/oak.png
