iamharveststorm/harvey/код/симуляция/управление с клавиатуры/assets/world/oak_orm.png

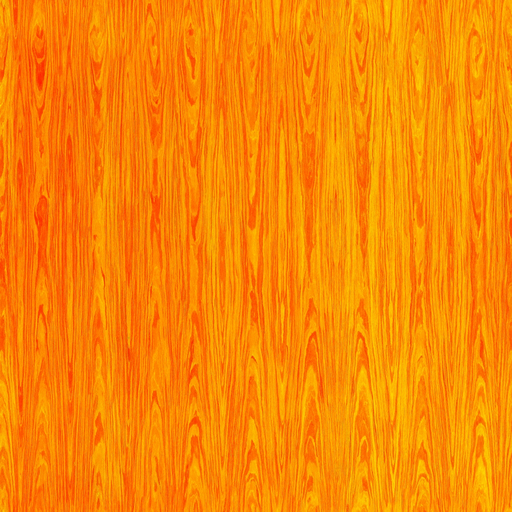
код/симуляция/управление с клавиатуры/assets/world/oak_orm.png
