iamharveststorm/harvey/код/симуляция/управление с клавиатуры/assets/world/parquet.png

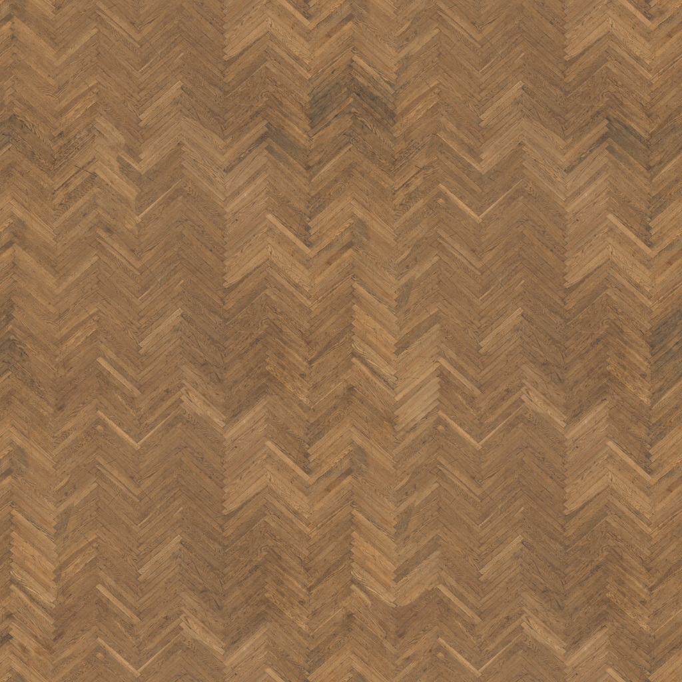
код/симуляция/управление с клавиатуры/assets/world/parquet.png
