iamharveststorm/harvey/код/симуляция/управление с клавиатуры/assets/world/parquet_orm.png

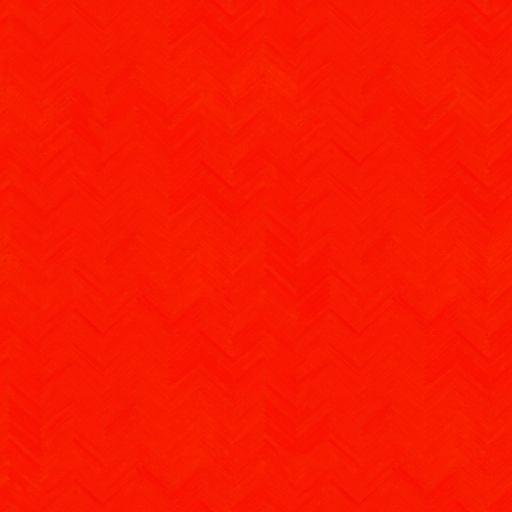
код/симуляция/управление с клавиатуры/assets/world/parquet_orm.png
