iamharveststorm/harvey/код/симуляция/управление с клавиатуры/assets/world/pebbles.png

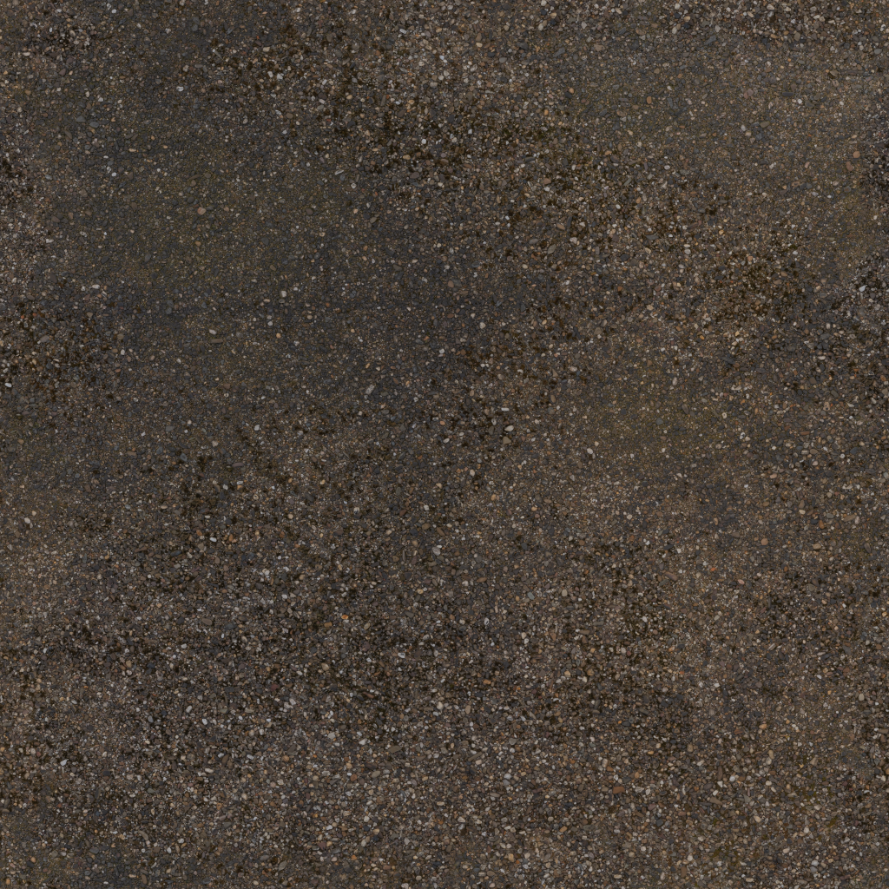
код/симуляция/управление с клавиатуры/assets/world/pebbles.png
