iamharveststorm/harvey/код/симуляция/управление с клавиатуры/assets/world/pebbles_h.png

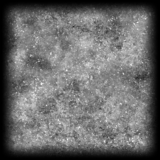
код/симуляция/управление с клавиатуры/assets/world/pebbles_h.png
