iamharveststorm/harvey/код/симуляция/управление с клавиатуры/assets/world/pebbles_n.png

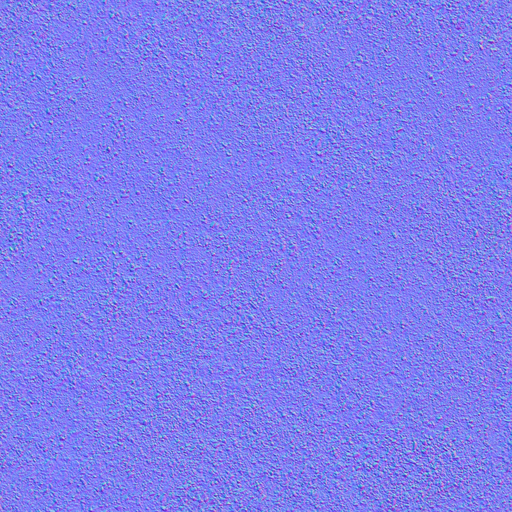
код/симуляция/управление с клавиатуры/assets/world/pebbles_n.png
