iamharveststorm/harvey/код/симуляция/управление с клавиатуры/assets/world/phone_wall.png

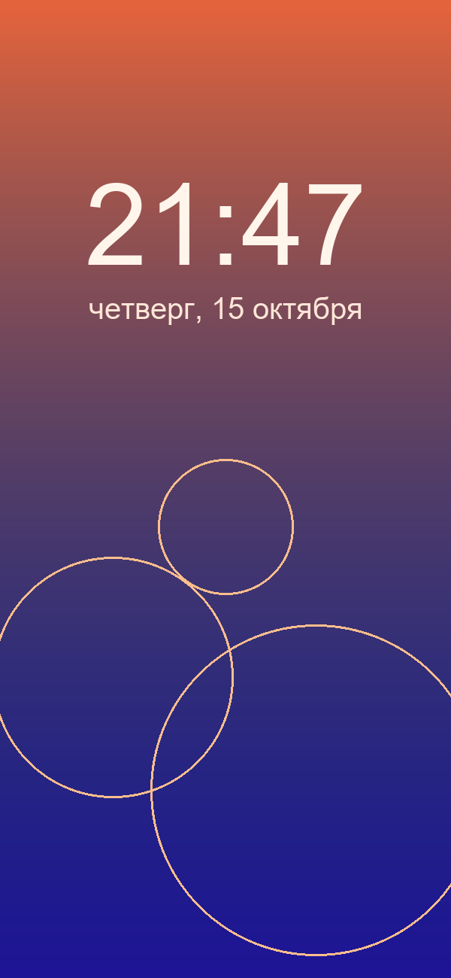
код/симуляция/управление с клавиатуры/assets/world/phone_wall.png
