iamharveststorm/harvey/код/симуляция/управление с клавиатуры/assets/world/sand.png

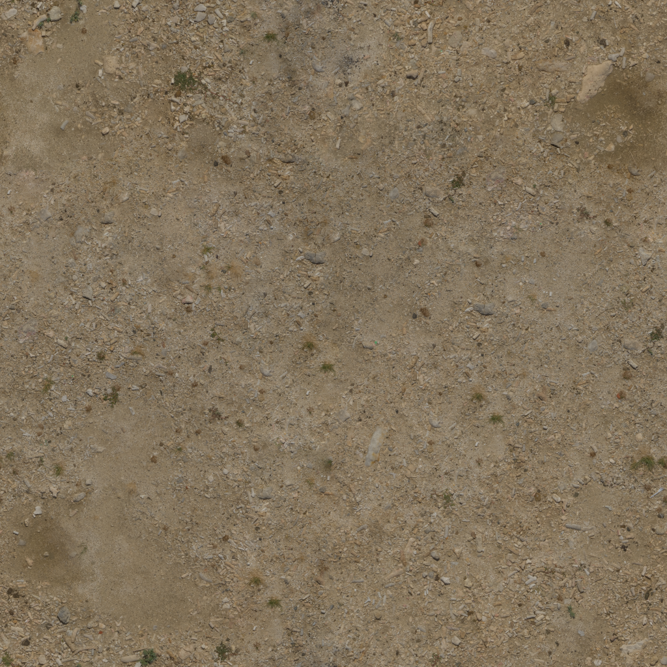
код/симуляция/управление с клавиатуры/assets/world/sand.png
