iamharveststorm/harvey/код/симуляция/управление с клавиатуры/assets/world/sand_h.png

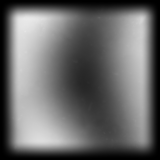
код/симуляция/управление с клавиатуры/assets/world/sand_h.png
