iamharveststorm/harvey/код/симуляция/управление с клавиатуры/assets/world/sand_n.png

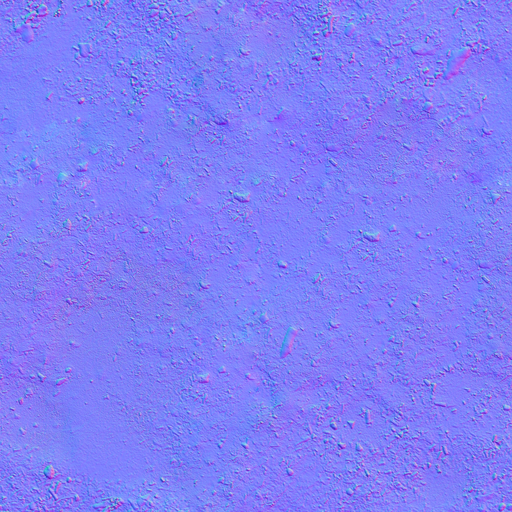
код/симуляция/управление с клавиатуры/assets/world/sand_n.png
