iamharveststorm/harvey/код/симуляция/управление с клавиатуры/assets/world/sand_orm.png

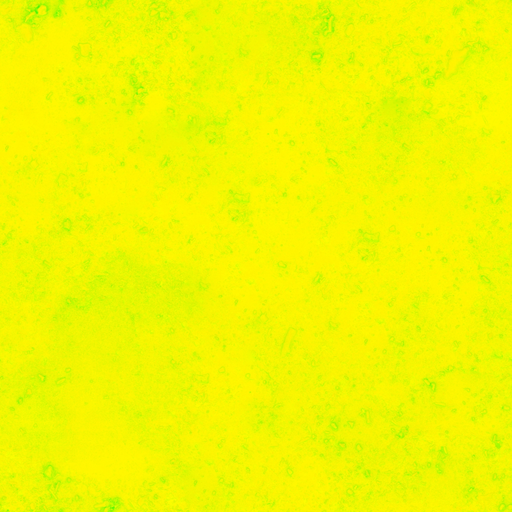
код/симуляция/управление с клавиатуры/assets/world/sand_orm.png
