iamharveststorm/harvey/код/симуляция/управление с клавиатуры/мир_полоса.png

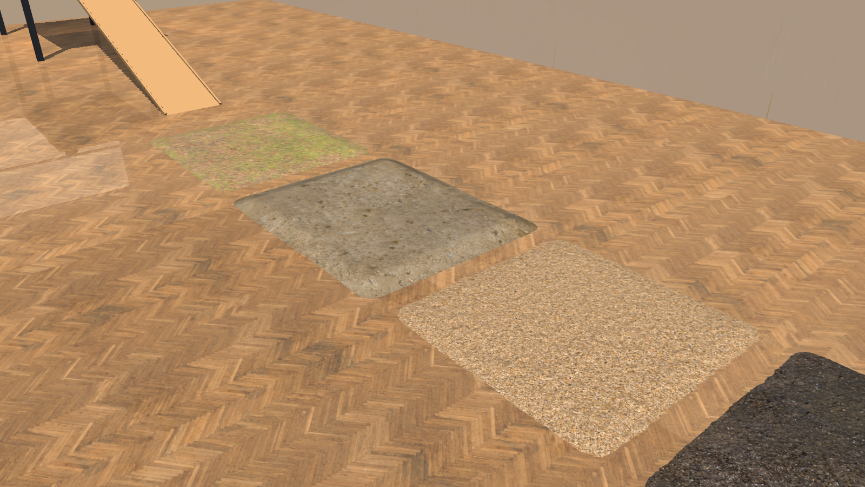
код/симуляция/управление с клавиатуры/мир_полоса.png
