iamharveststorm/harvey/код/симуляция/управление с клавиатуры/мир_склоны.png

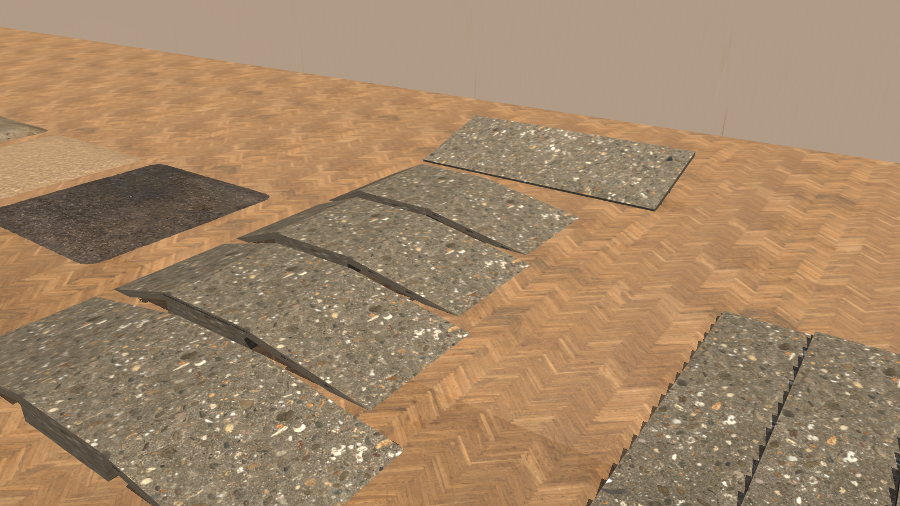
код/симуляция/управление с клавиатуры/мир_склоны.png
