iamharveststorm/harvey/код/симуляция/управление с клавиатуры/мир_стол.png

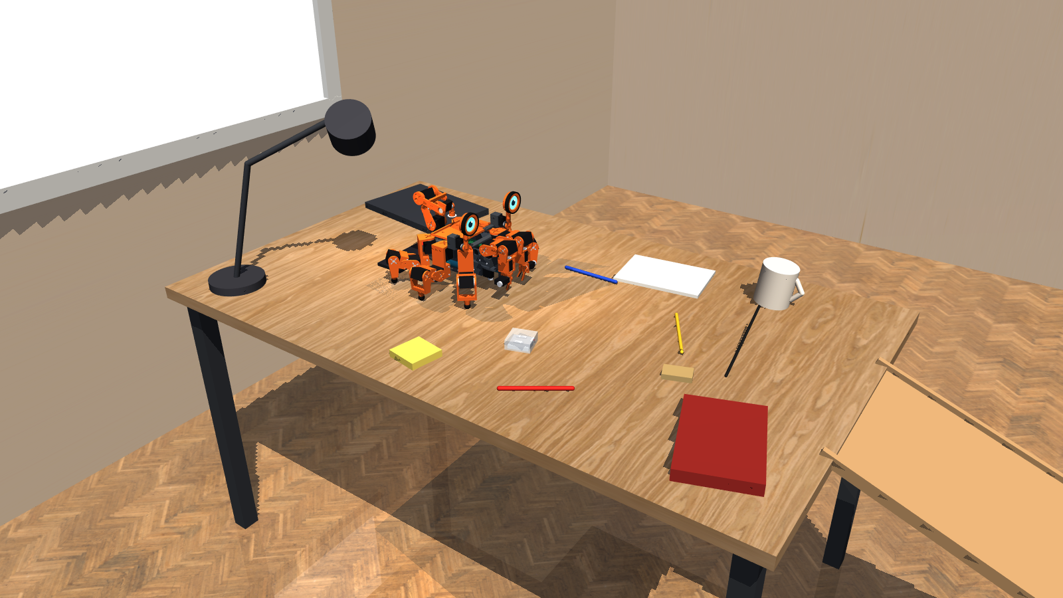
код/симуляция/управление с клавиатуры/мир_стол.png
