iamharveststorm/harvey/код/симуляция/управление с клавиатуры/мир_харви_на_столе.png

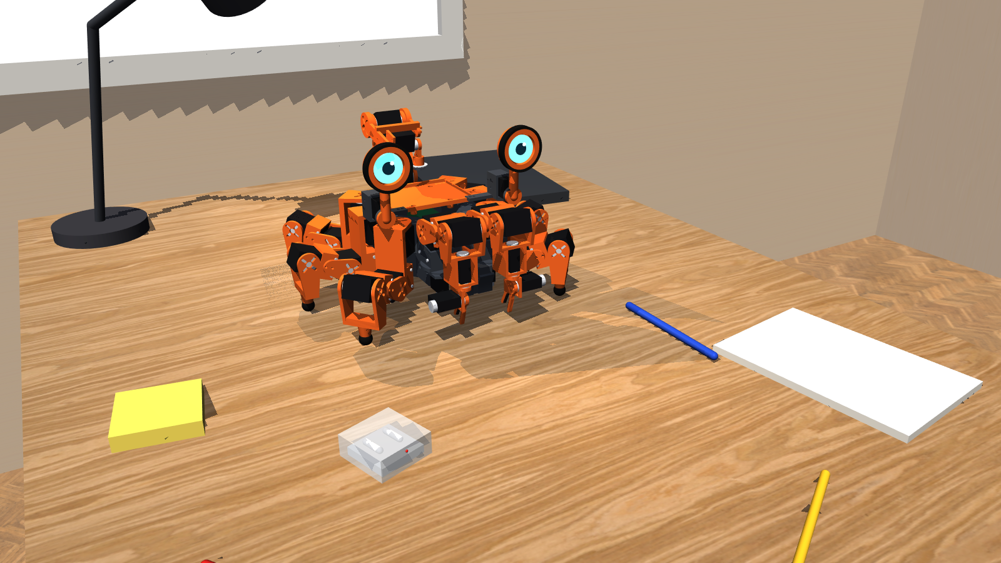
код/симуляция/управление с клавиатуры/мир_харви_на_столе.png
