iamharveststorm/harvey/код/симуляция/управление с клавиатуры/фото_галька.png

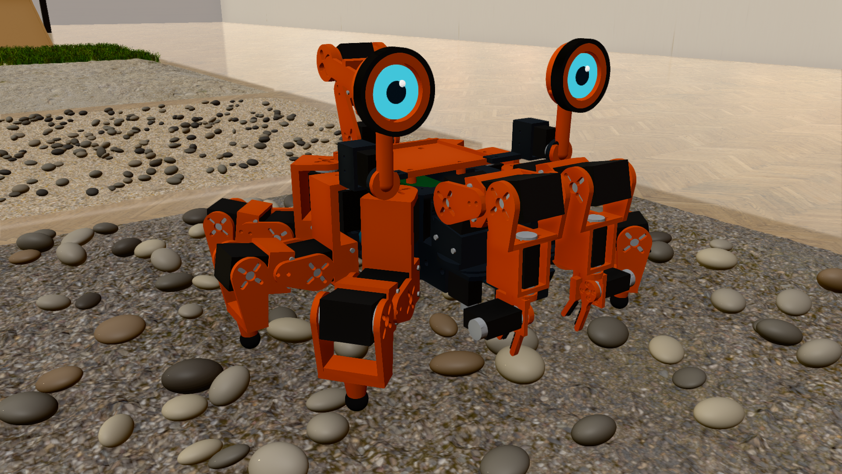
код/симуляция/управление с клавиатуры/фото_галька.png
