iamharveststorm/harvey/код/симуляция/управление с клавиатуры/фото_песок_следы.png

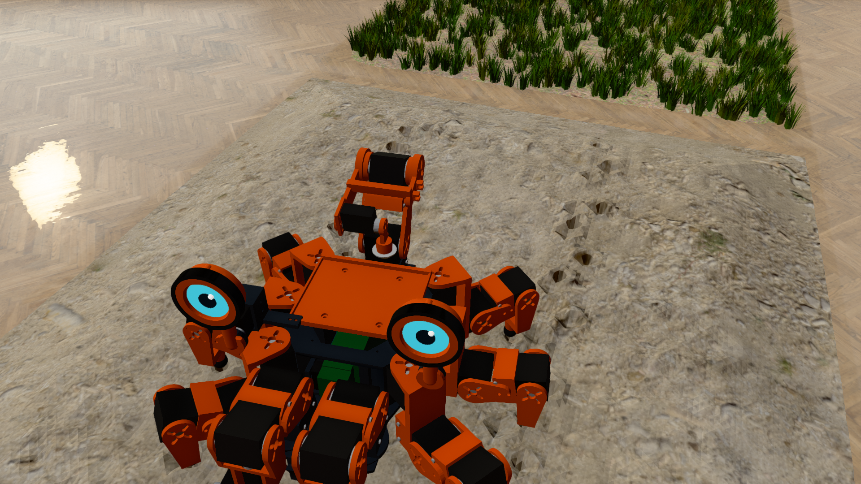
код/симуляция/управление с клавиатуры/фото_песок_следы.png
