iamharveststorm/harvey/код/симуляция/управление с клавиатуры/фото_склон.png

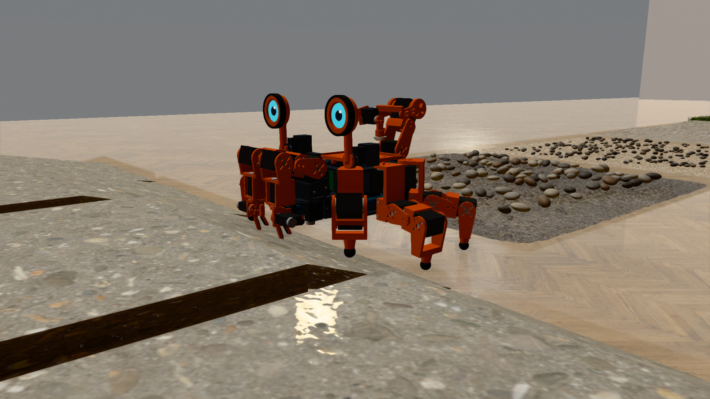
код/симуляция/управление с клавиатуры/фото_склон.png
