iamharveststorm/harvey/код/симуляция/управление с клавиатуры/фото_стол.png

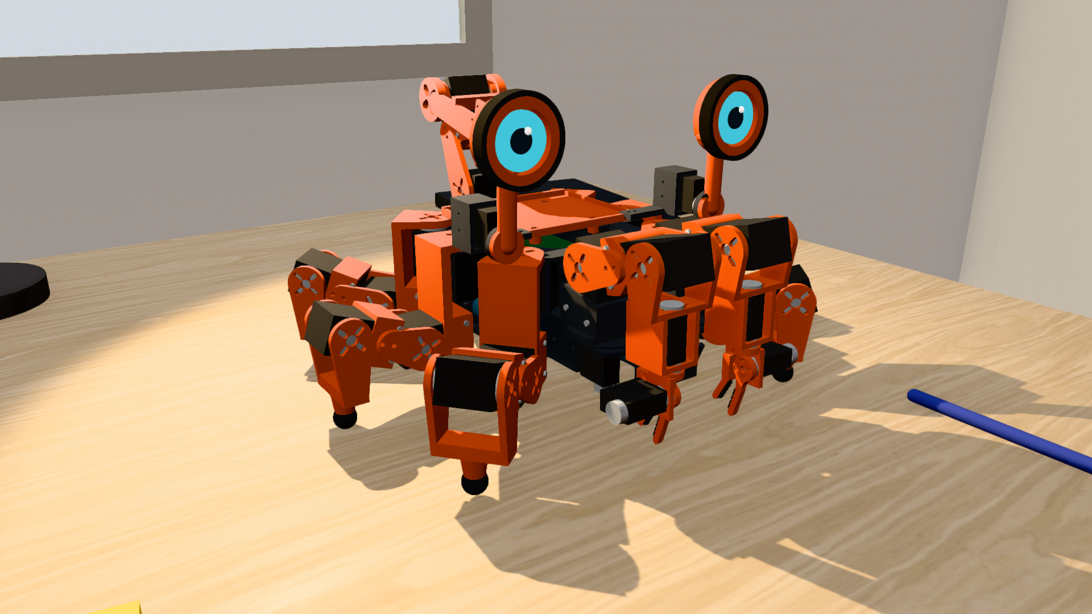
код/симуляция/управление с клавиатуры/фото_стол.png
