iamharveststorm/harvey/код/симуляция/управление с клавиатуры/фото_трава.png

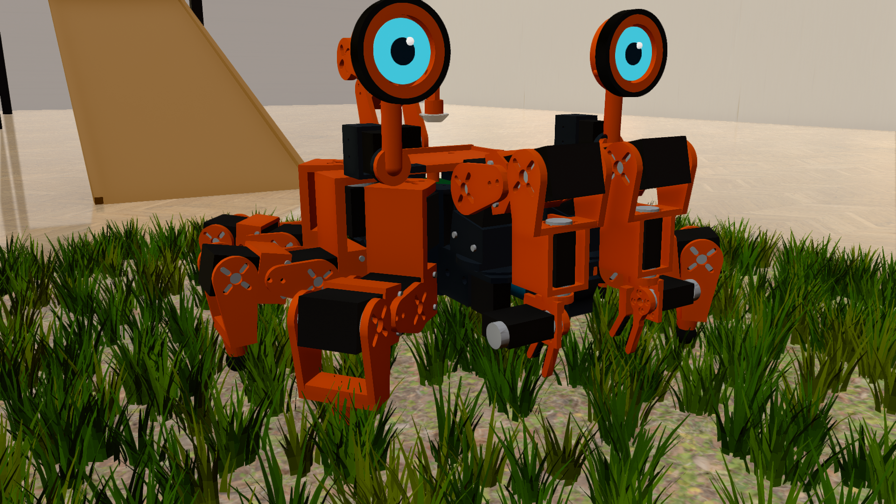
код/симуляция/управление с клавиатуры/фото_трава.png
