iamharveststorm/harvey/модели/клешни/рендер клешней.png

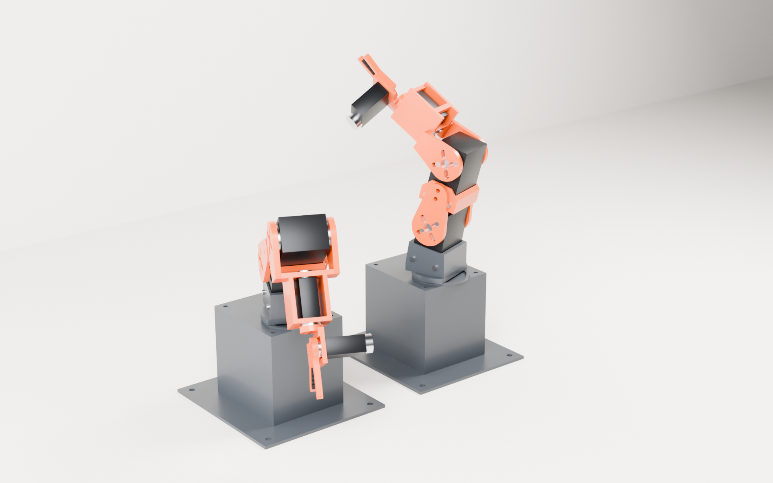
модели/клешни/рендер клешней.png
