iamharveststorm/harvey/модели/корпус/компоновка_вид_сверху.png

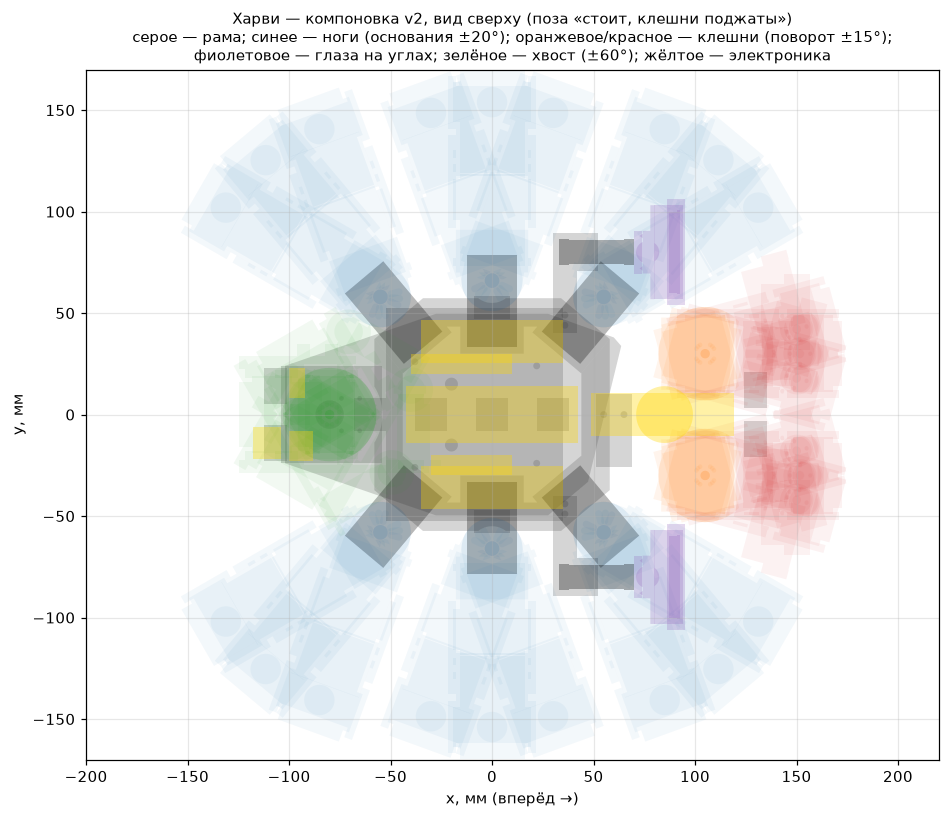
модели/корпус/компоновка_вид_сверху.png
