iamharveststorm/harvey/модели/мини/мини_компоновка.png

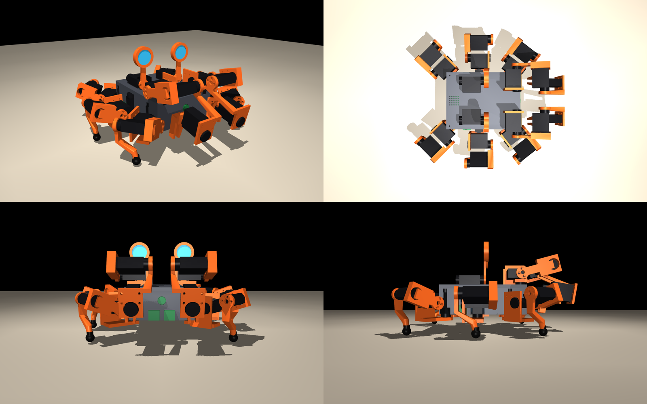
модели/мини/мини_компоновка.png
