iamharveststorm/harvey/модели/рендер/tex/eye_L.png

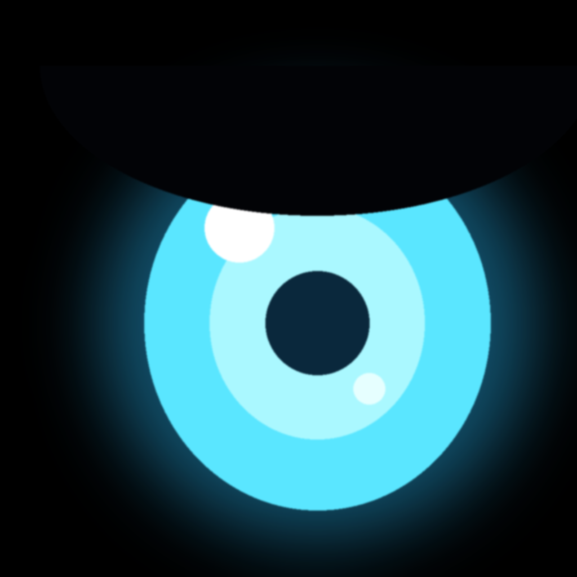
модели/рендер/tex/eye_L.png
