iamharveststorm/harvey/модели/рендер/tex/eye_R.png

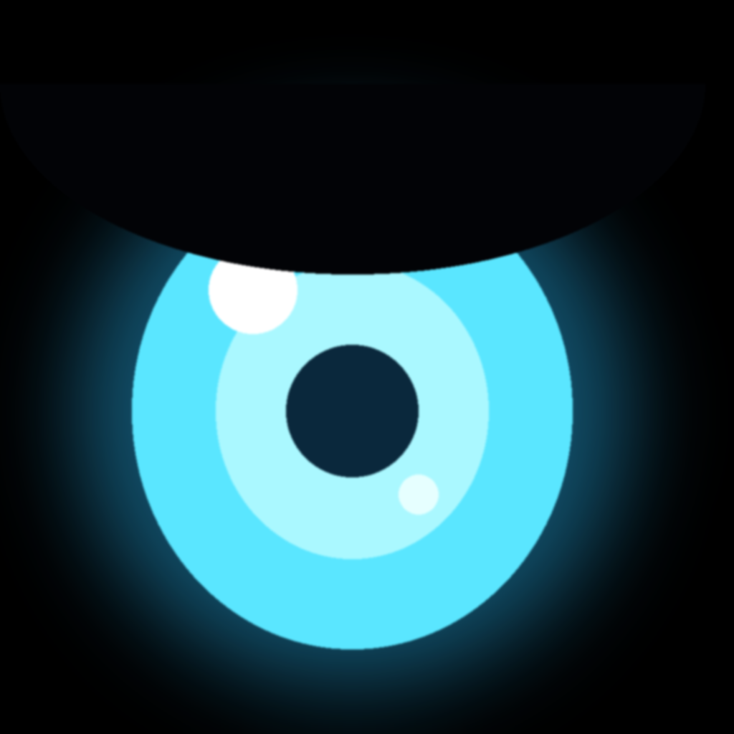
модели/рендер/tex/eye_R.png
