iamharveststorm/harvey/модели/рендер/Мини_1.png

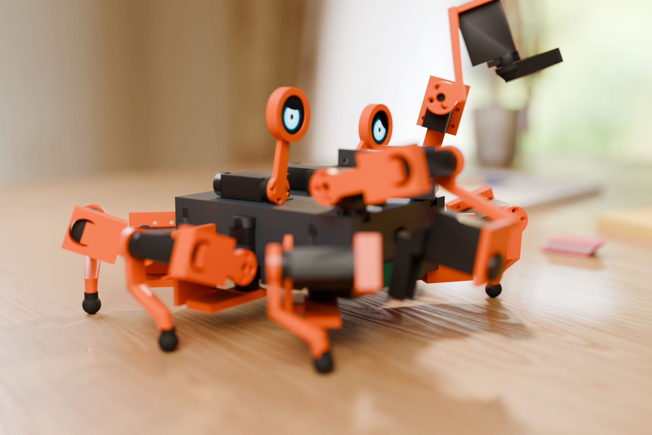
модели/рендер/Мини_1.png
