iamharveststorm/harvey/модели/рендер/Мини_2.png

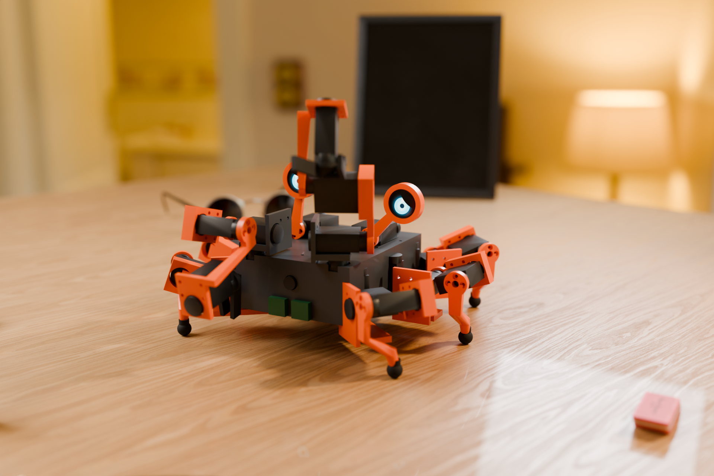
модели/рендер/Мини_2.png
