iamharveststorm/harvey/модели/рендер/Мини_3.png

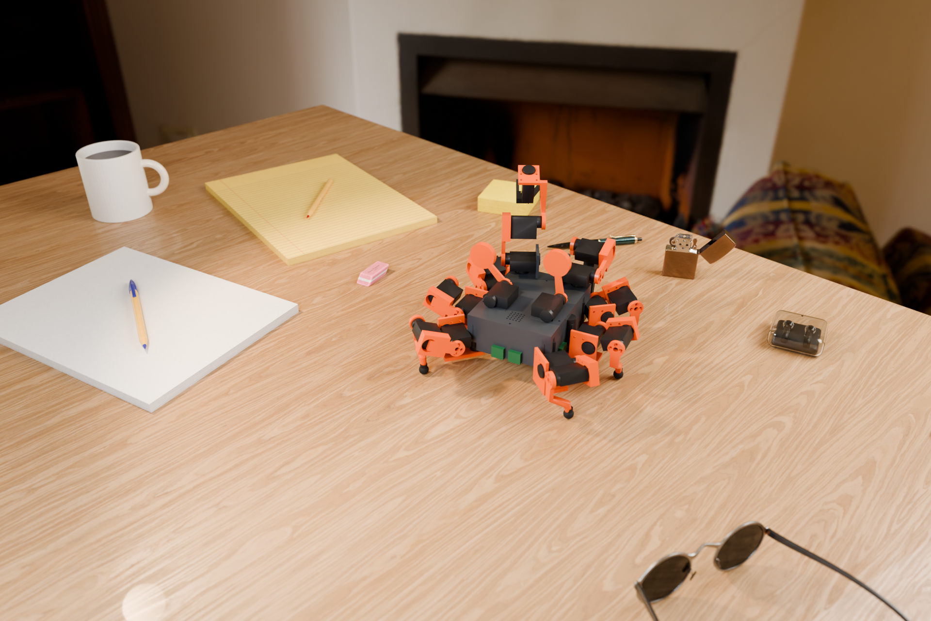
модели/рендер/Мини_3.png
