iamharveststorm/harvey/модели/рендер/Харви_мягкий_1.png

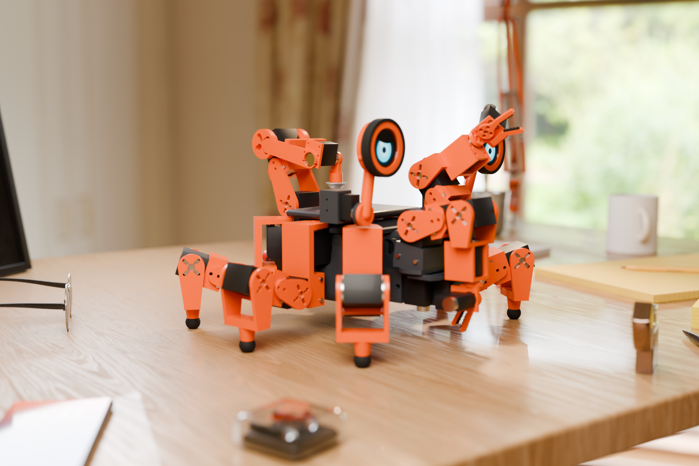
модели/рендер/Харви_мягкий_1.png
