iamharveststorm/harvey/модели/рендер/Харви_мягкий_2.png

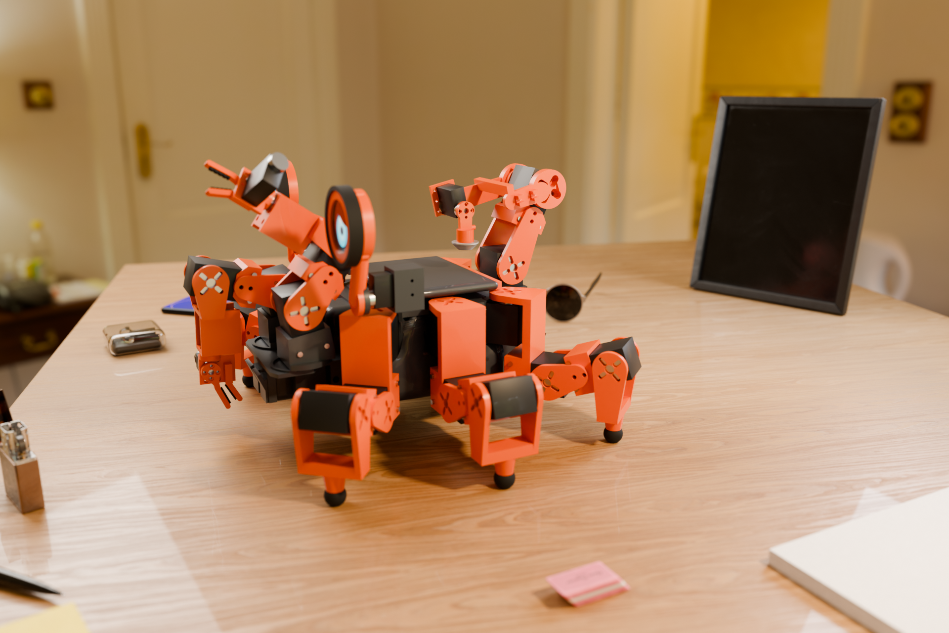
модели/рендер/Харви_мягкий_2.png
