iamharveststorm/harvey/модели/рендер/Харви_мягкий_3.png

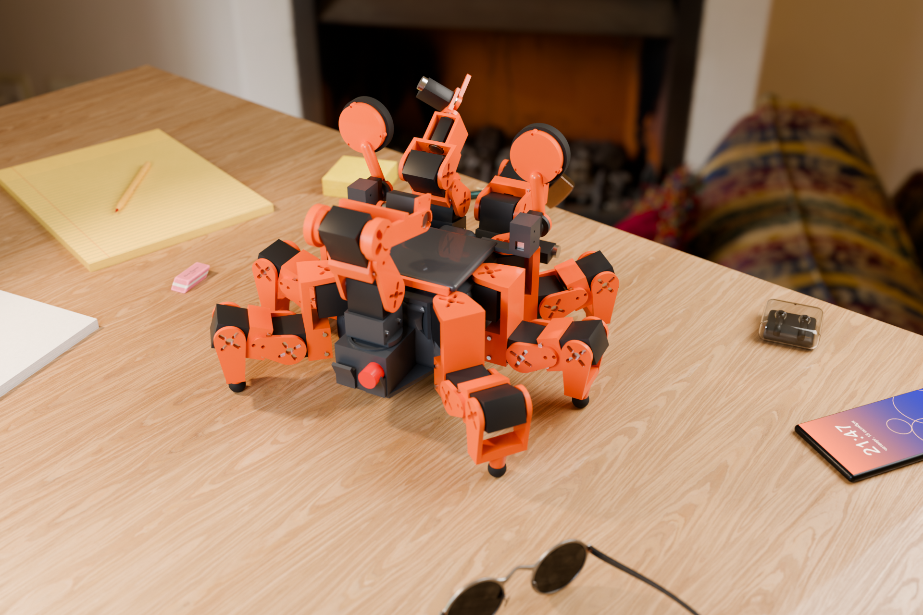
модели/рендер/Харви_мягкий_3.png
