iamharveststorm/harvey/модели/стенд кисти/детали кисти.png

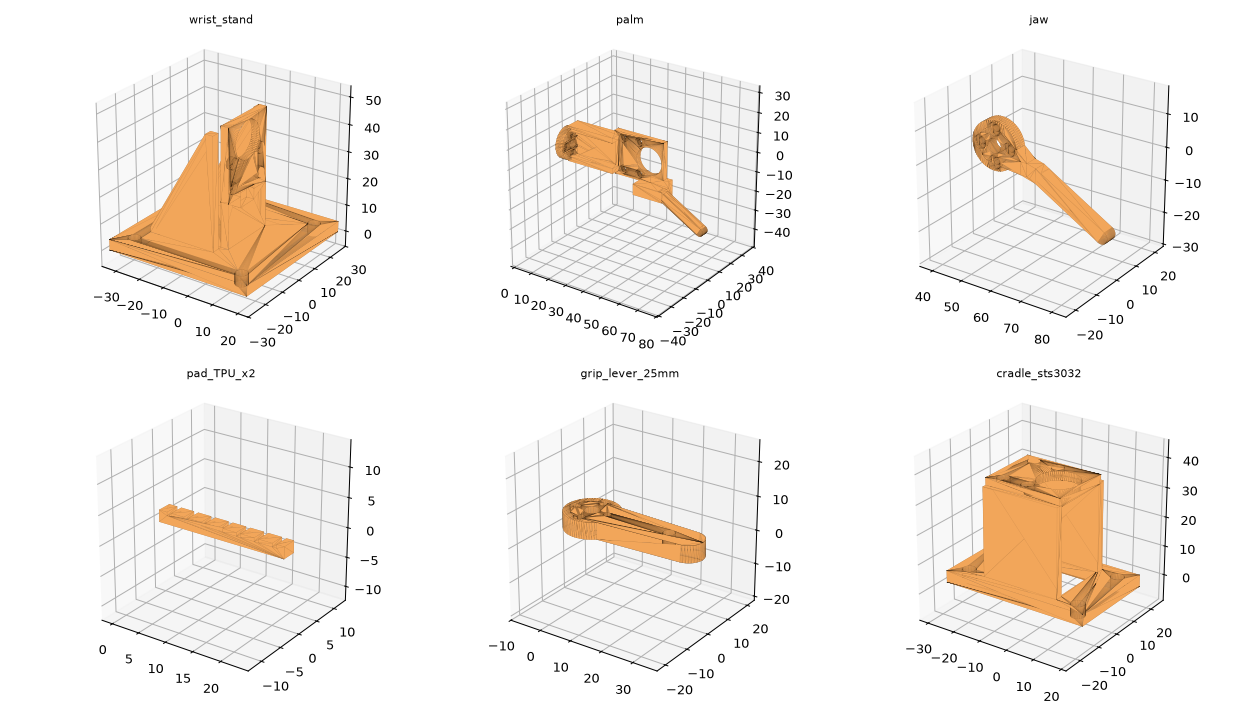
модели/стенд кисти/детали кисти.png
