iamharveststorm/harvey/модели/стенд кисти/рендер кисти.png

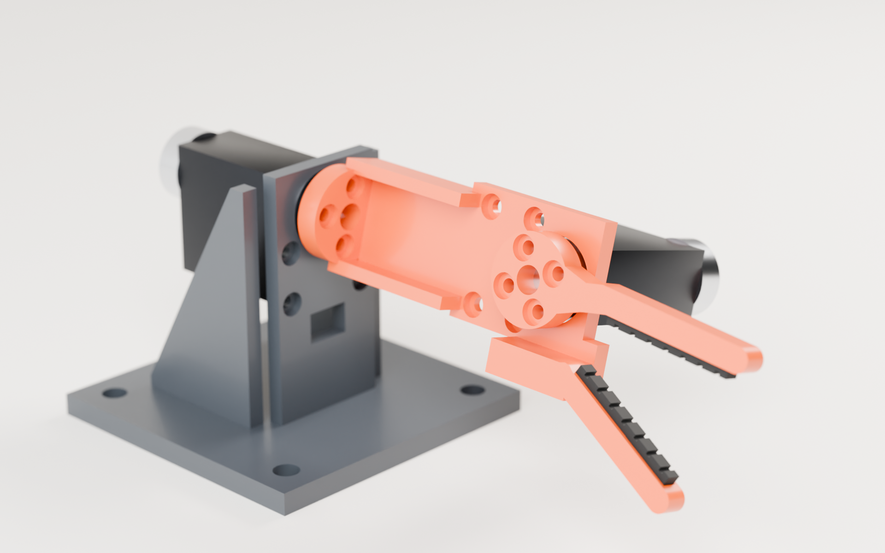
модели/стенд кисти/рендер кисти.png
