iamharveststorm/harvey/модели/стенд кисти/сборка кисти.png

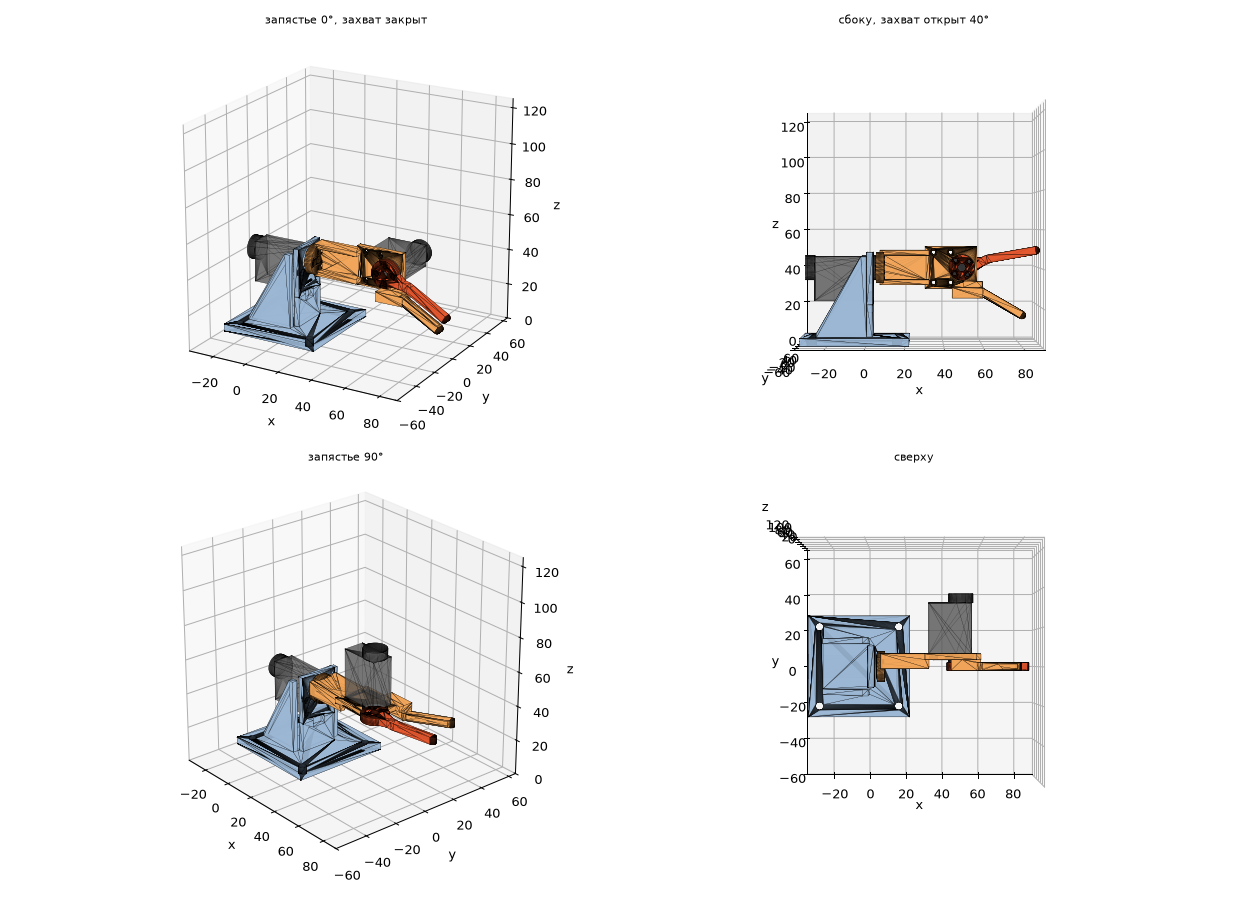
модели/стенд кисти/сборка кисти.png
