iamharveststorm/harvey/модели/стенд ноги/рендер ног.png

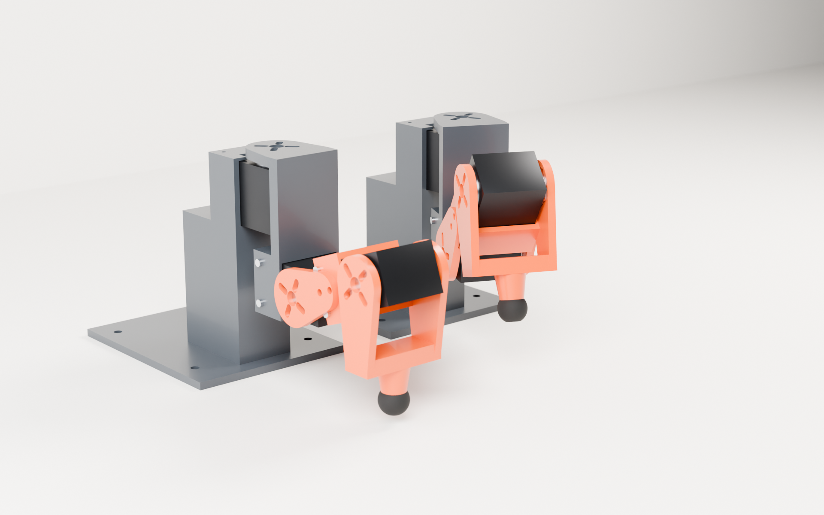
модели/стенд ноги/рендер ног.png
