iamharveststorm/harvey/схемы/beacon.png

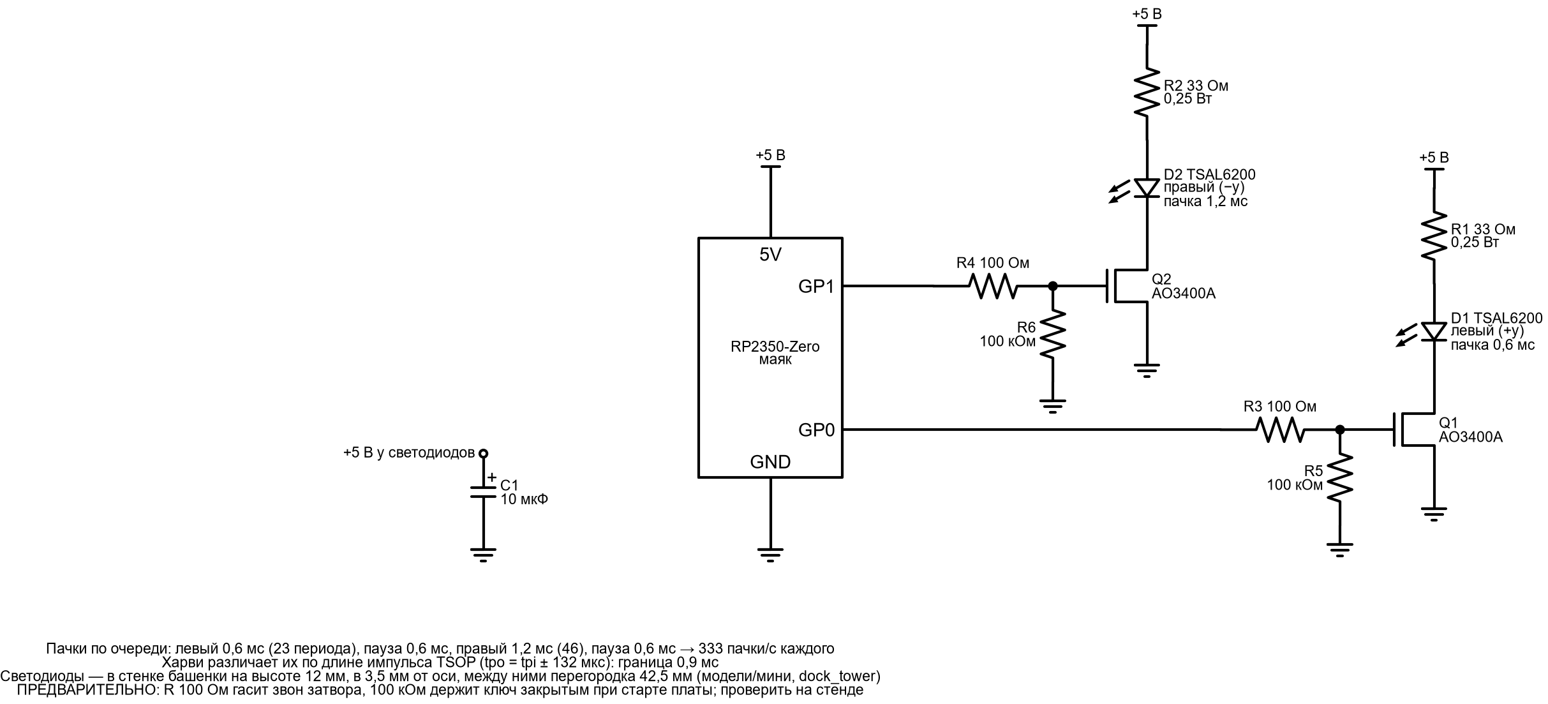
схемы/beacon.png
