iamharveststorm/harvey/схемы/bus_buffer.png

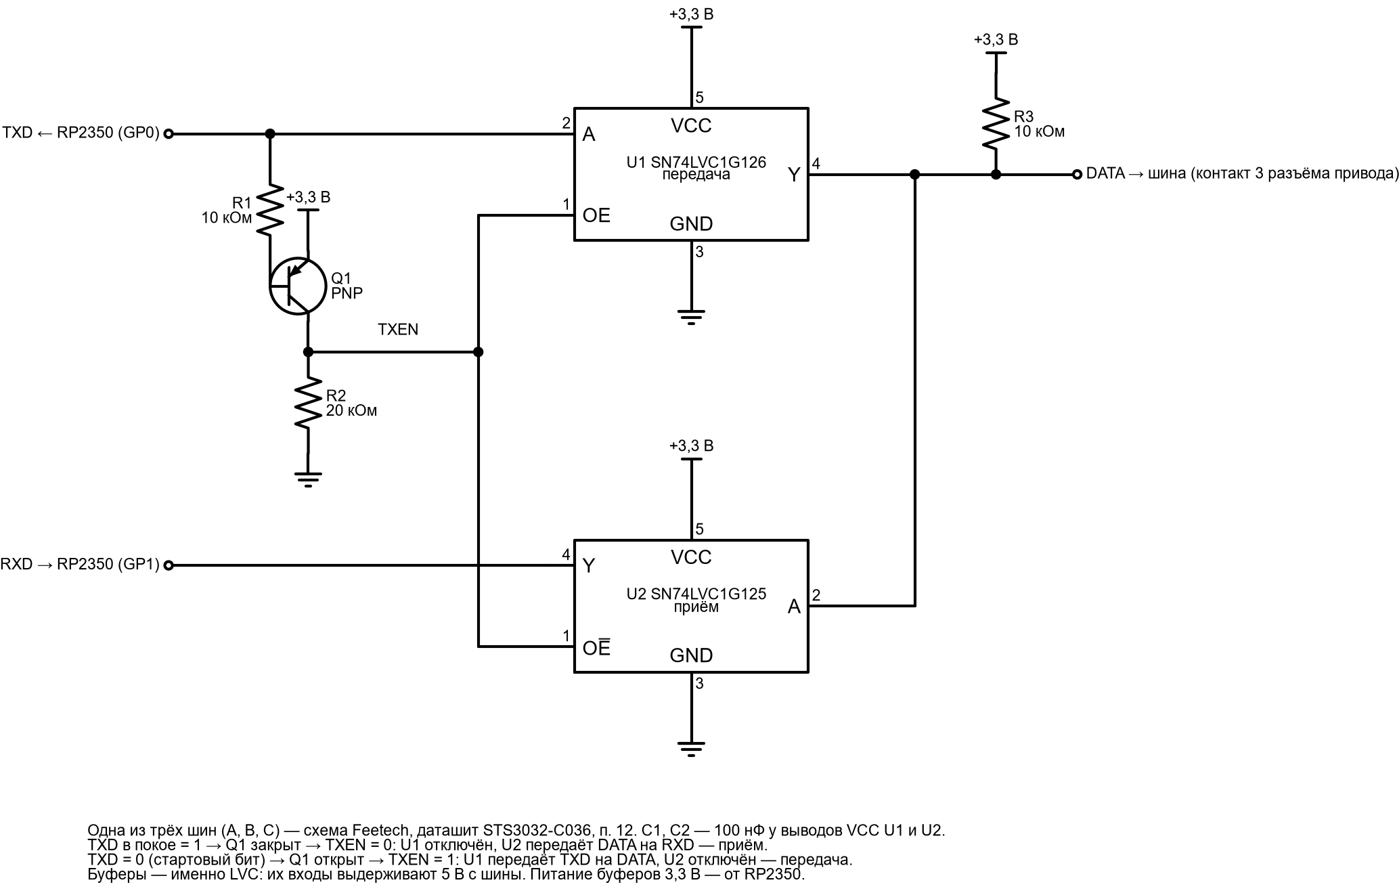
схемы/bus_buffer.png
