iamharveststorm/harvey/схемы/mini_bus.png

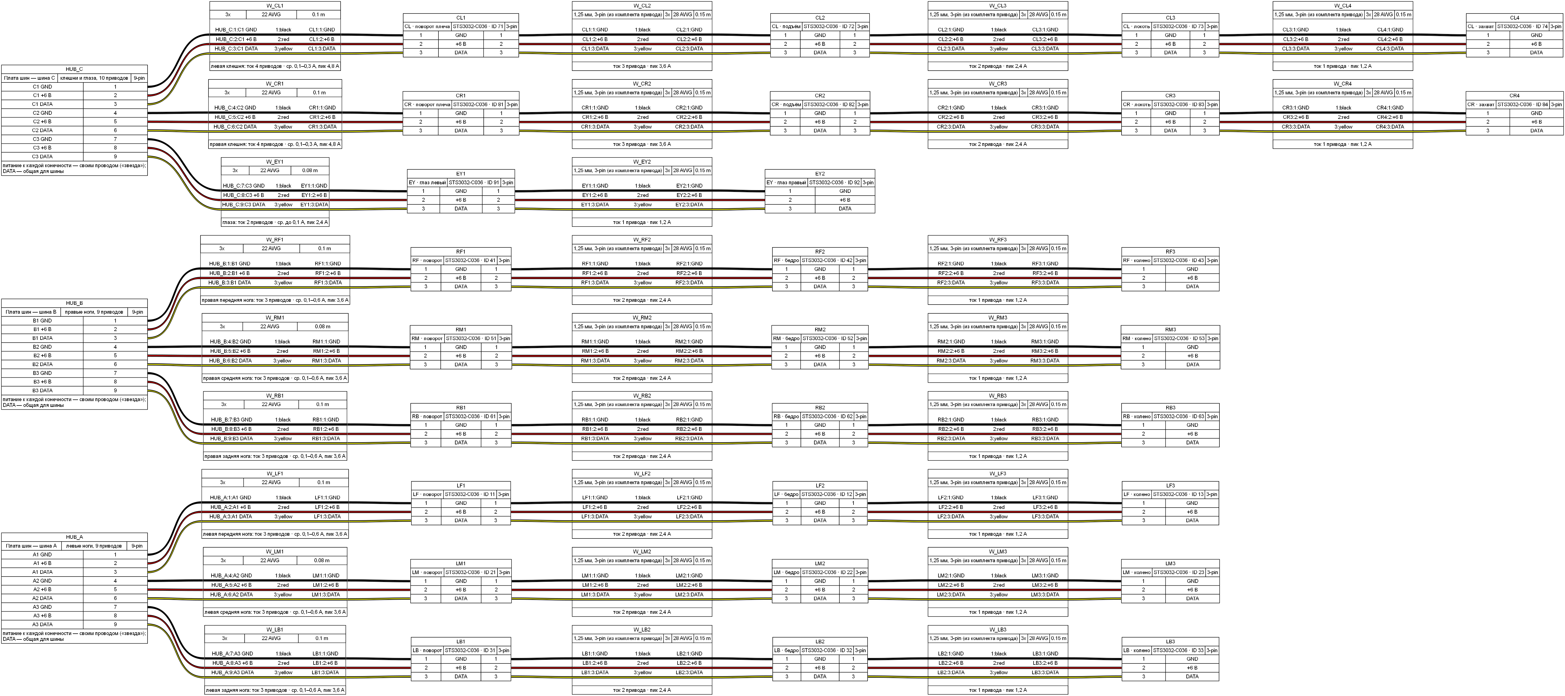
схемы/mini_bus.png
