iamharveststorm/harvey/схемы/mini_pi.png

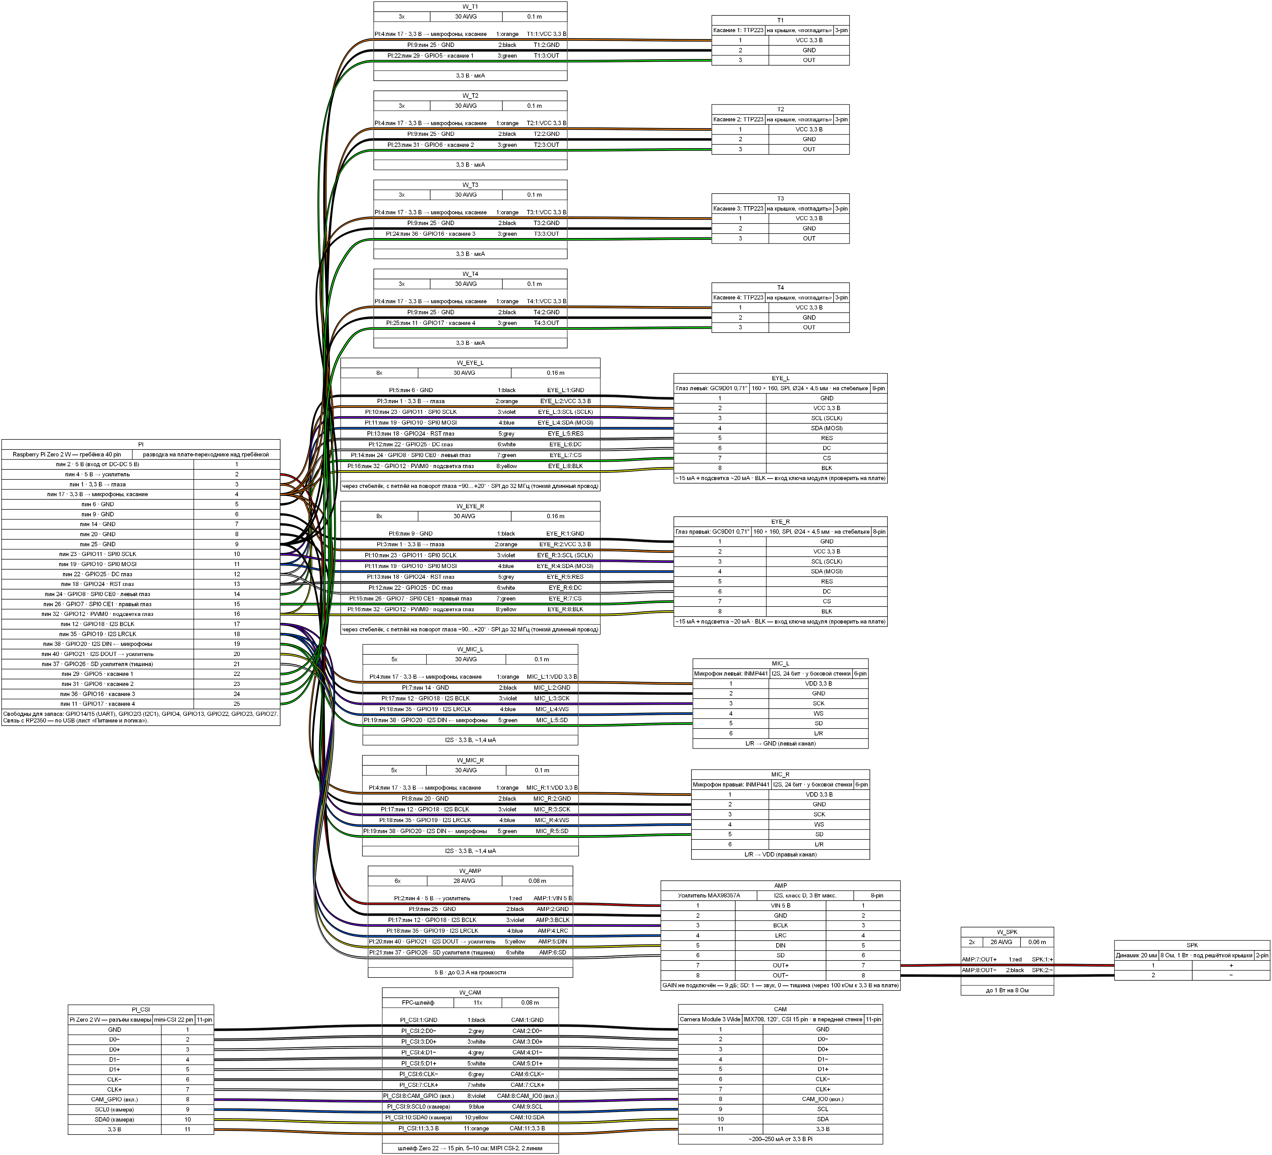
схемы/mini_pi.png
