iamharveststorm/harvey/схемы/mini_power.png

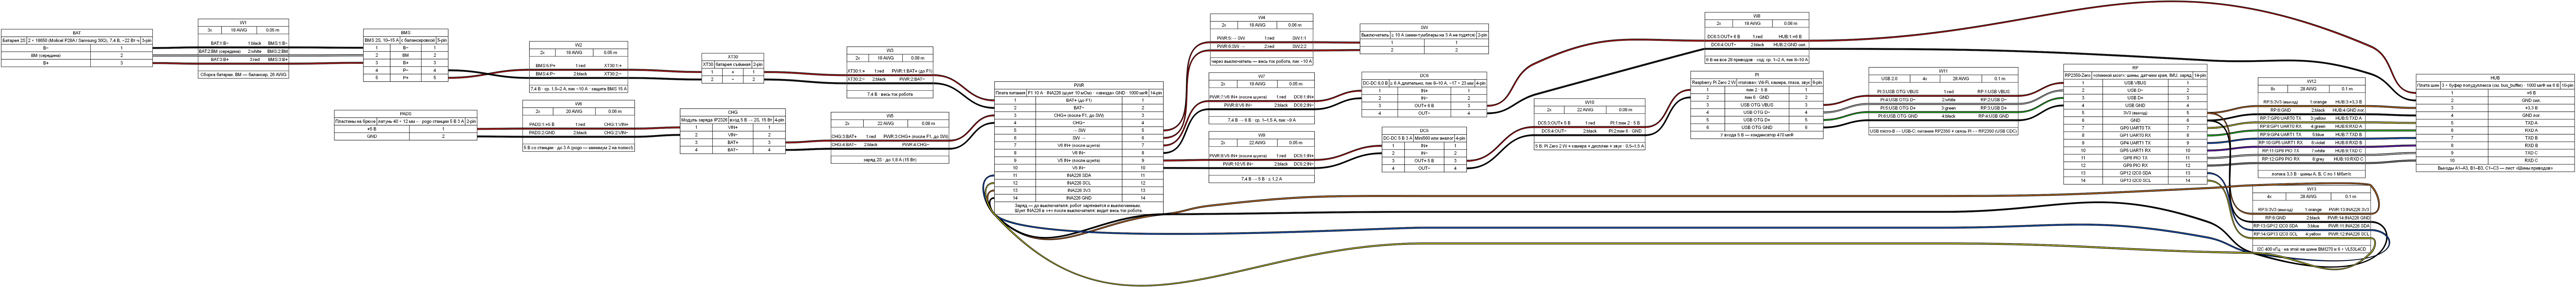
схемы/mini_power.png
