iamharveststorm/harvey/схемы/mini_sensors.png

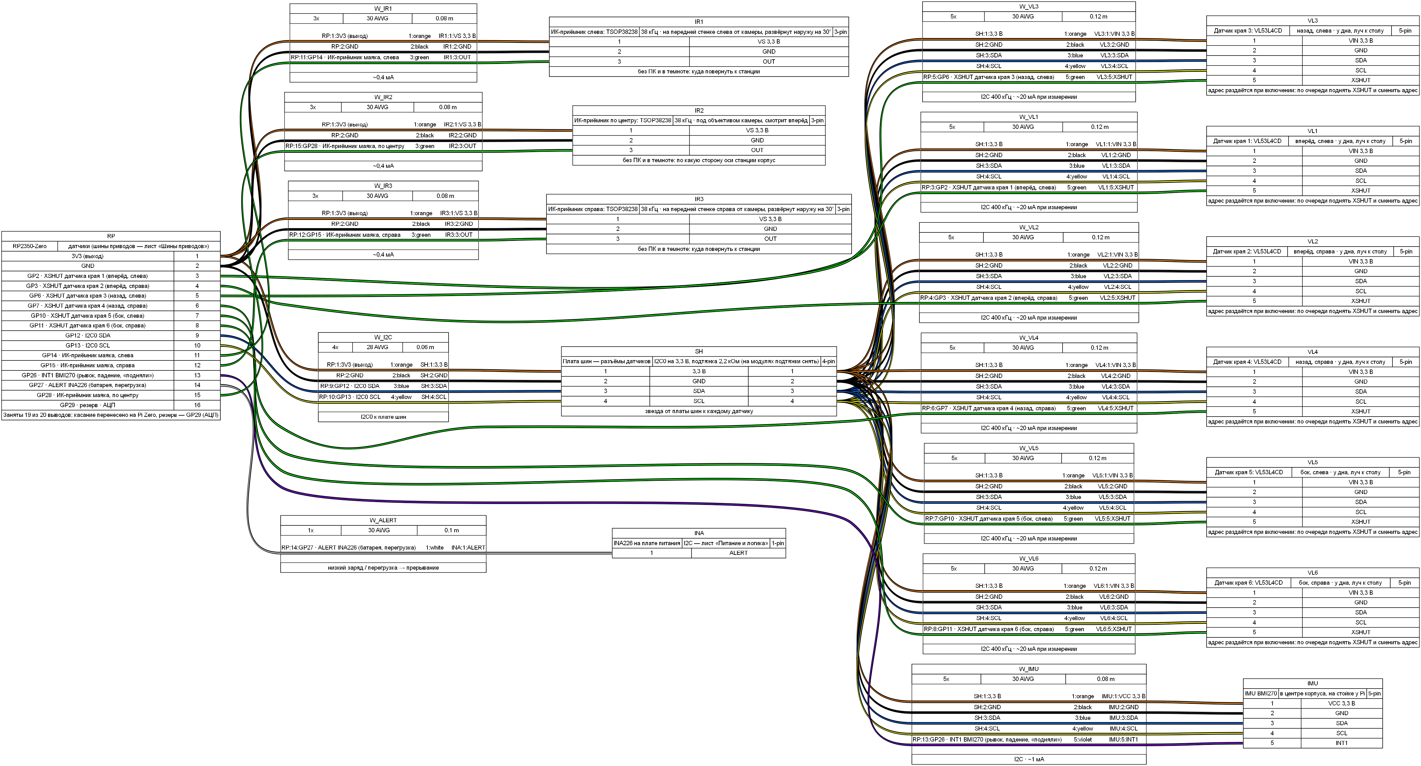
схемы/mini_sensors.png
