iamharveststorm/harvey/схемы/station.png

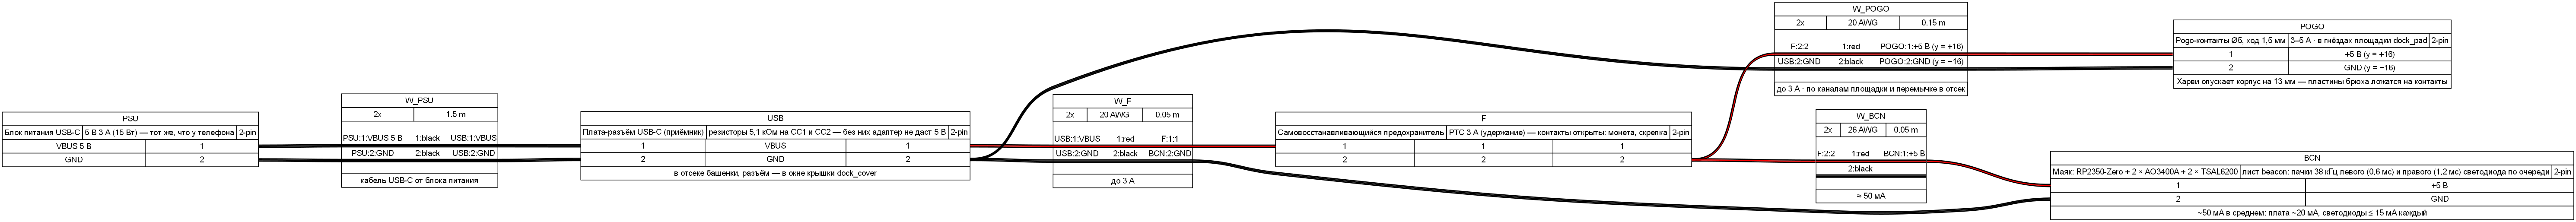
схемы/station.png
