iamharveststorm/harvey/код/симуляция/мини/assets/dock_tower.stl

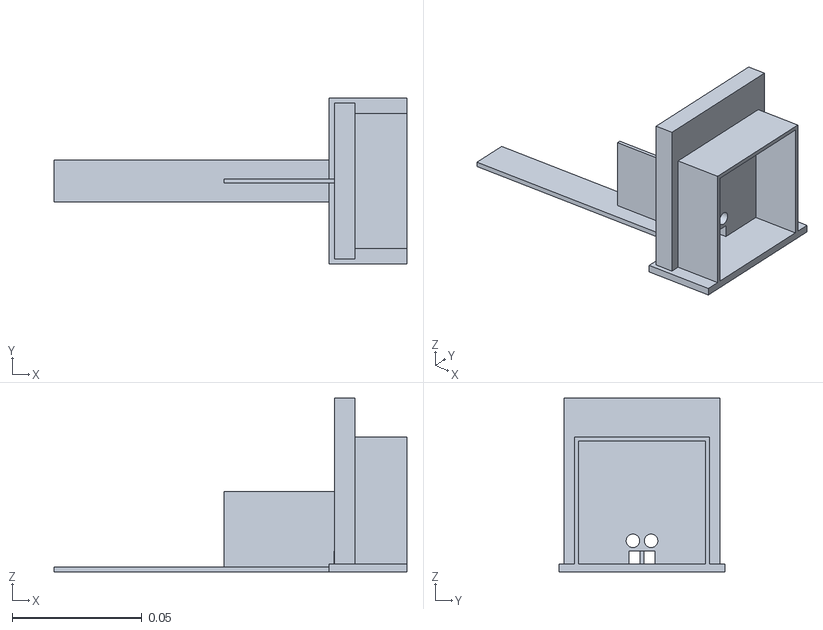
[picture p67: CAD file, 2026-11-03]
код/симуляция/мини/assets/dock_tower.stl
0.136 x 0.064 x 0.067
