iamharveststorm/harvey/код/симуляция/управление с клавиатуры/assets/robot/leg_coxa__orange.stl

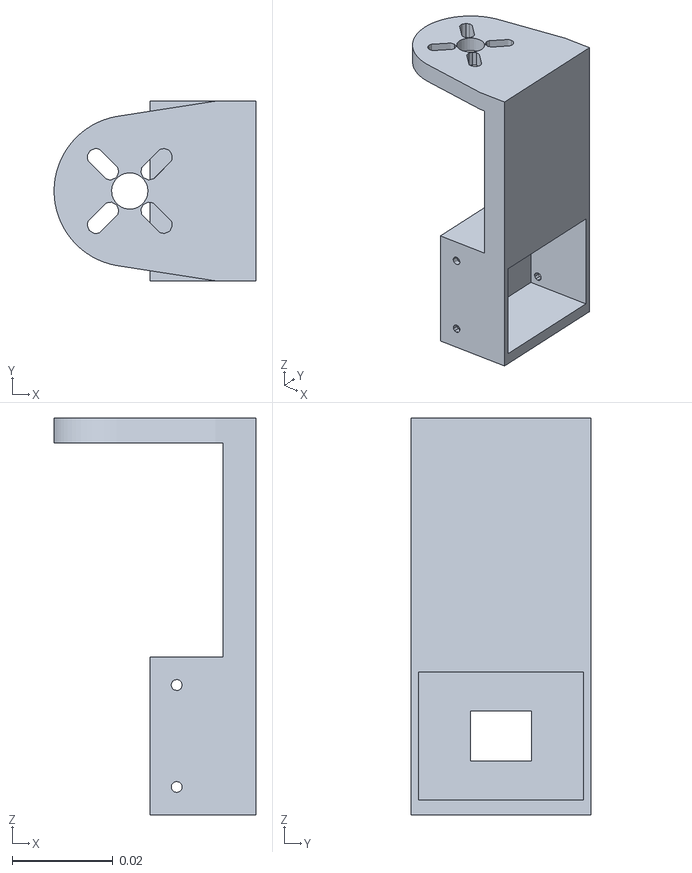
[picture p68: CAD file, 2026-10-16]
код/симуляция/управление с клавиатуры/assets/robot/leg_coxa__orange.stl
0.04 x 0.0356 x 0.0787
