iamharveststorm/harvey/модели/глаза/stl/R_01_horn_adapter.stl

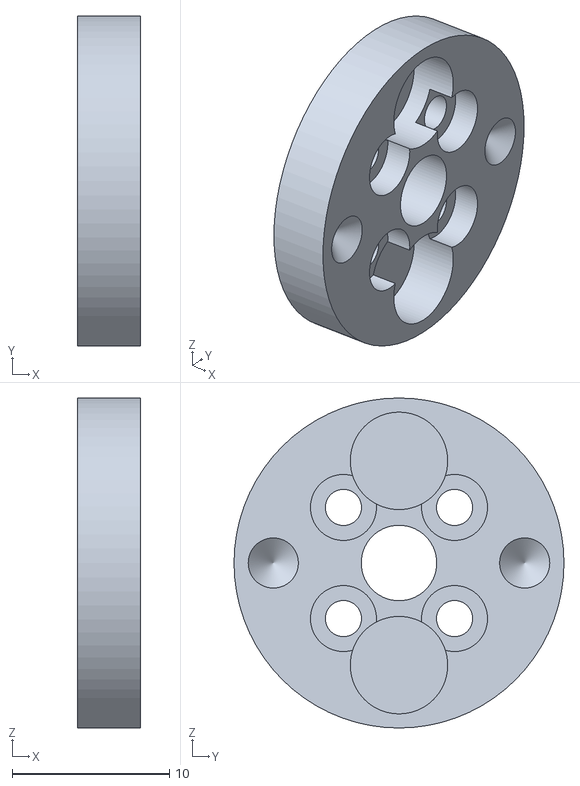
[picture p69: CAD file, 2026-10-16]
модели/глаза/stl/R_01_horn_adapter.stl
4.00 x 21.0 x 21.0
