iamharveststorm/harvey/модели/клешни/render_parts/petg_grey.stl

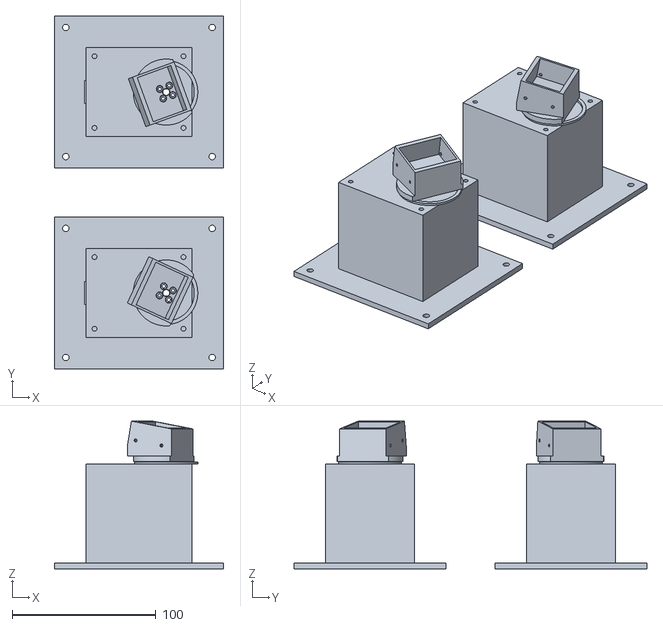
[picture p70: CAD file, 2026-10-16]
модели/клешни/render_parts/petg_grey.stl
118.0 x 246.0 x 103.0
