iamharveststorm/harvey/модели/клешни/stl/00_test_stand.stl

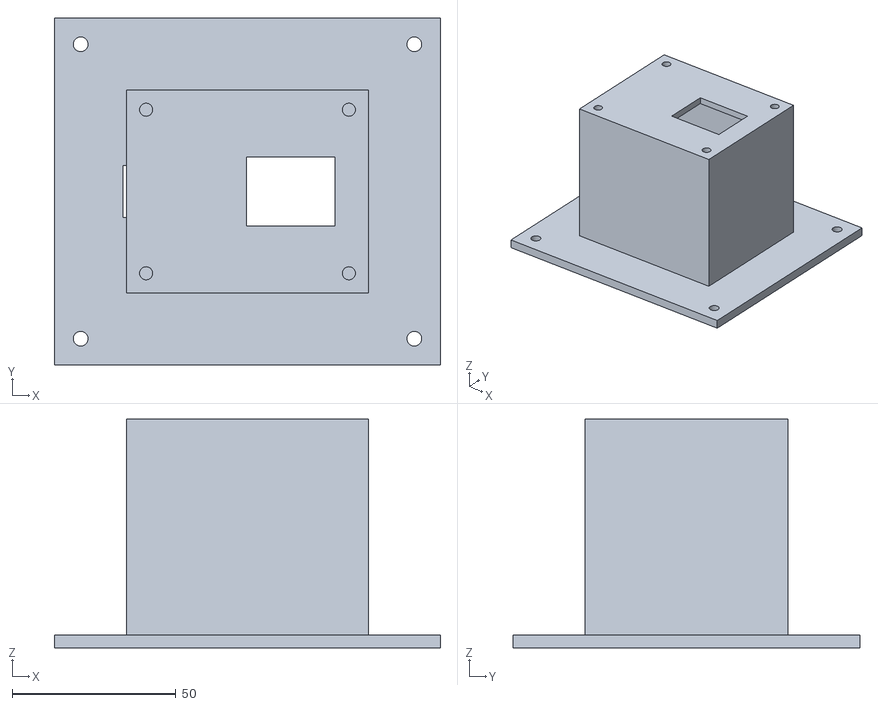
[picture p71: CAD file, 2026-10-16]
модели/клешни/stl/00_test_stand.stl
118.0 x 106.0 x 70.0
