iamharveststorm/harvey/модели/корпус/stl/03_front_deck.stl

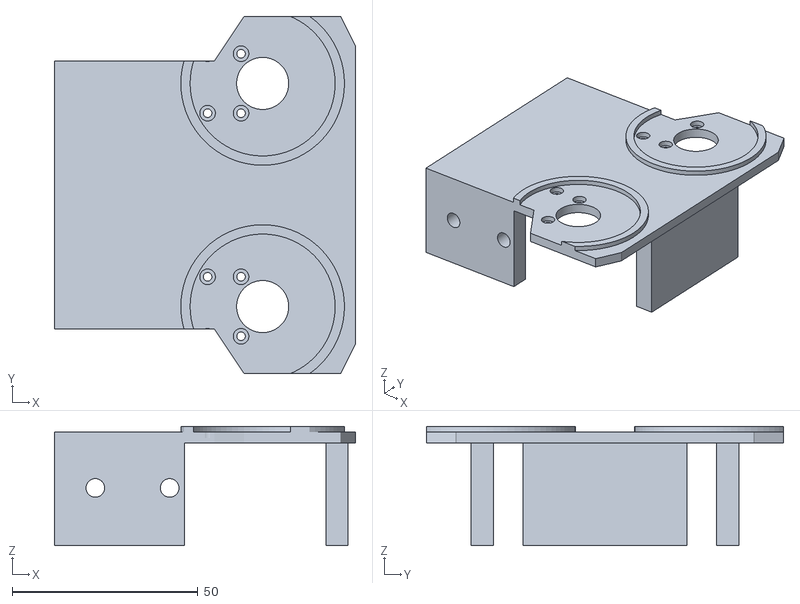
[picture p72: CAD file, 2026-10-16]
модели/корпус/stl/03_front_deck.stl
81.0 x 96.0 x 32.0
