iamharveststorm/harvey/модели/мини/stl/calib_jig_PLA.stl

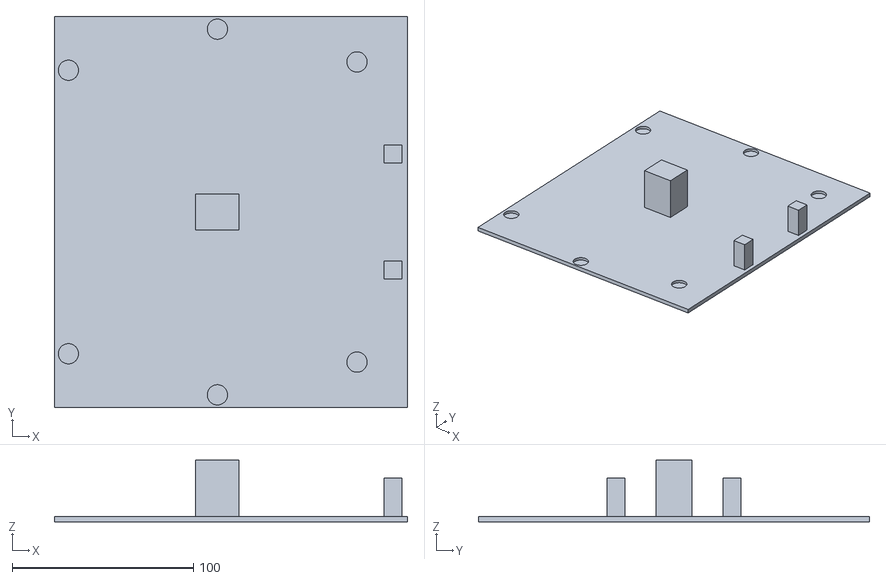
[picture p73: CAD file, 2026-11-04]
модели/мини/stl/calib_jig_PLA.stl
195.0 x 216.0 x 34.0
