iamharveststorm/harvey/модели/рендер/parts/soft/tpu.stl

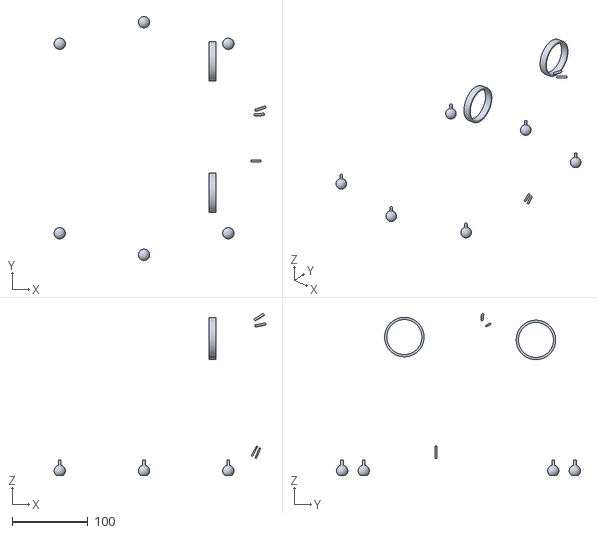
[picture p74: CAD file, 2026-10-16]
модели/рендер/parts/soft/tpu.stl
280.3 x 322.8 x 215.0
