iamharveststorm/harvey/модели/рендер/parts/tech/pcb.stl

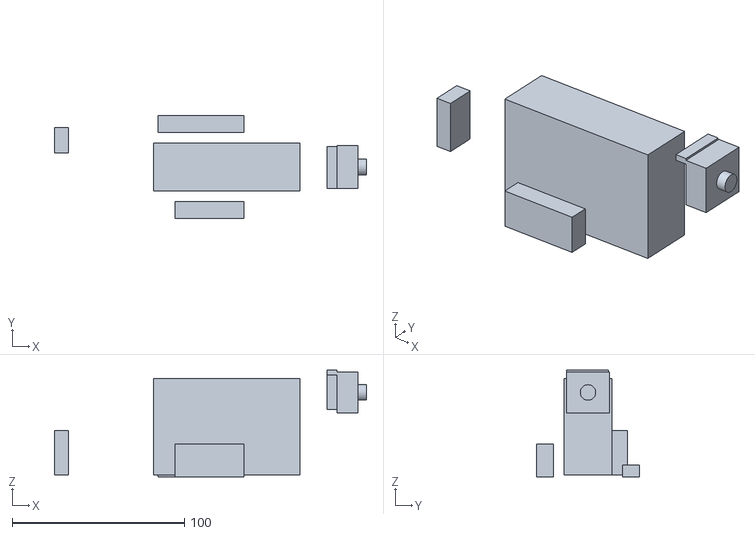
[picture p75: CAD file, 2026-10-16]
модели/рендер/parts/tech/pcb.stl
181.0 x 60.0 x 62.0
