iamharveststorm/harvey/модели/рендер/parts_mini/tech/case.stl

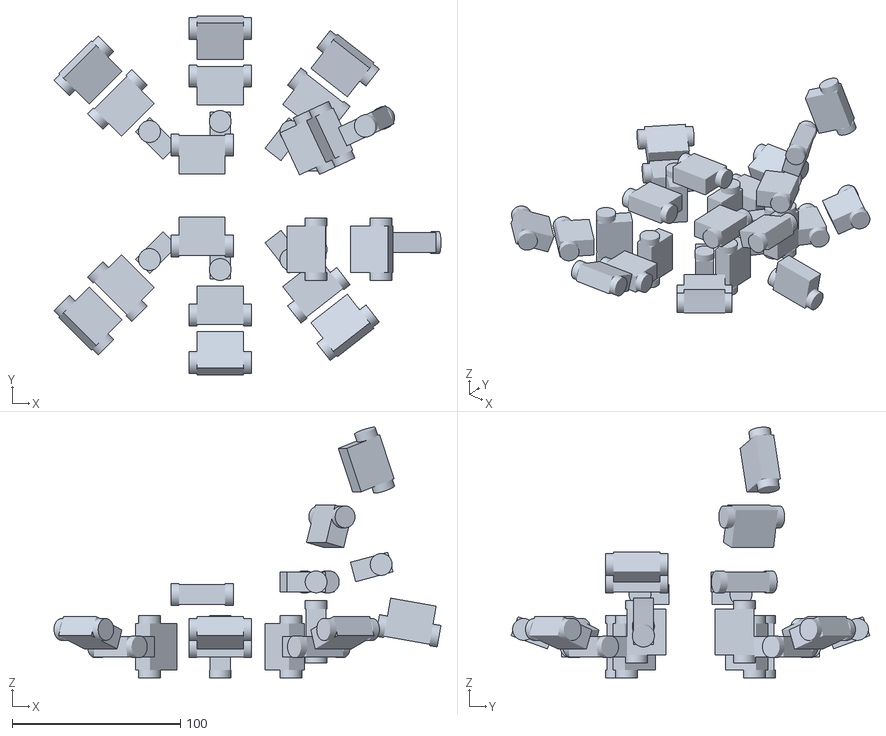
[picture p76: CAD file, 2026-10-16]
модели/рендер/parts_mini/tech/case.stl
229.9 x 213.2 x 149.0
