iamharveststorm/harvey/модели/стенд кисти/render_parts/palm.stl

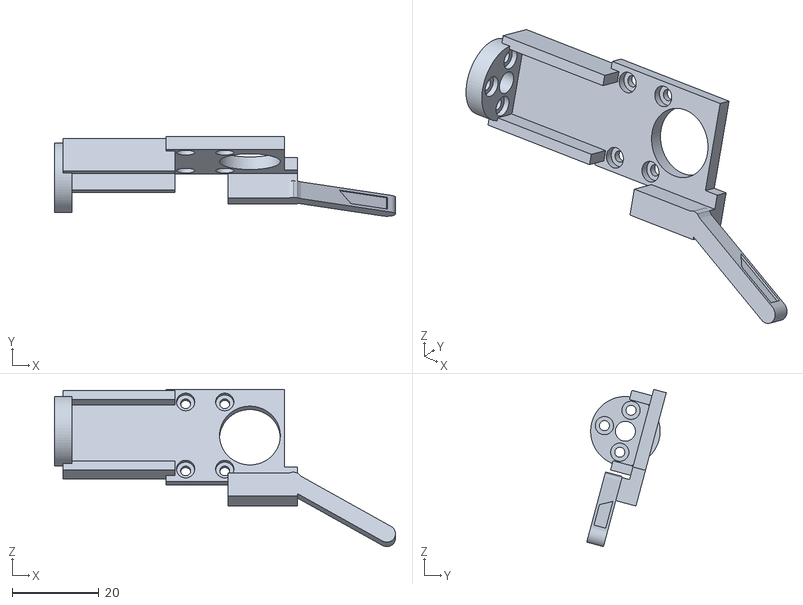
[picture p77: CAD file, 2026-10-16]
модели/стенд кисти/render_parts/palm.stl
78.5 x 18.3 x 36.2
