iamharveststorm/harvey/модели/стенд кисти/stl/harvey_hand_pad_TPU_x2.stl

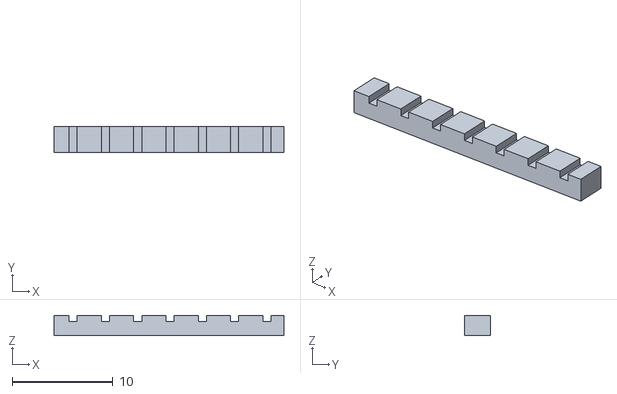
[picture p78: CAD file, 2026-10-16]
модели/стенд кисти/stl/harvey_hand_pad_TPU_x2.stl
22.8 x 2.60 x 2.00
