iamharveststorm/harvey/модели/стенд ноги/render_parts/case.stl

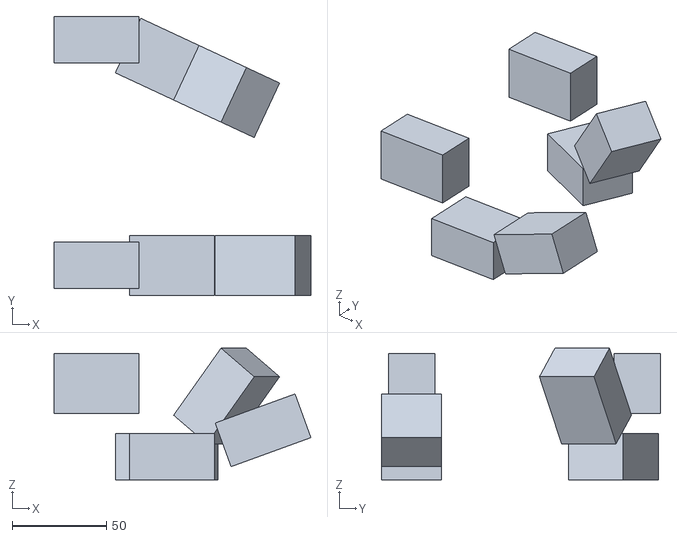
[picture p79: CAD file, 2026-10-16]
модели/стенд ноги/render_parts/case.stl
136.6 x 148.3 x 70.0
