iamharveststorm/harvey/модели/стенд ноги/stl/harvey_coxa_bracket.stl

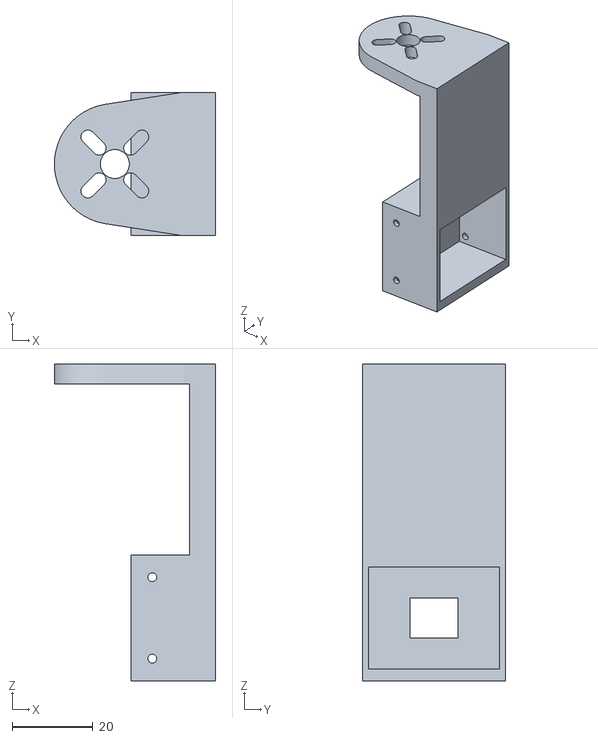
[picture p80: CAD file, 2026-10-16]
модели/стенд ноги/stl/harvey_coxa_bracket.stl
40.0 x 35.6 x 78.7
