iamharveststorm/harvey/модели/хвост/stl/02_yaw_bracket.stl

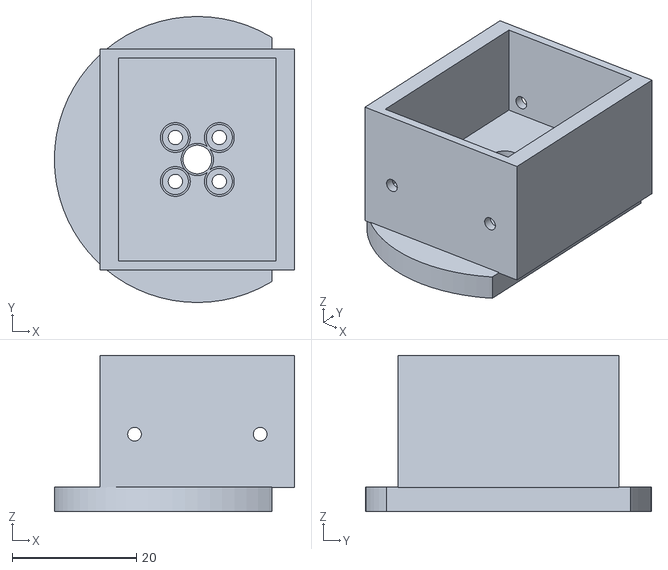
[picture p81: CAD file, 2026-10-16]
модели/хвост/stl/02_yaw_bracket.stl
38.6 x 46.0 x 25.2
