iamharveststorm/harvey/модели/чертежи/Рычаг_100мм.step

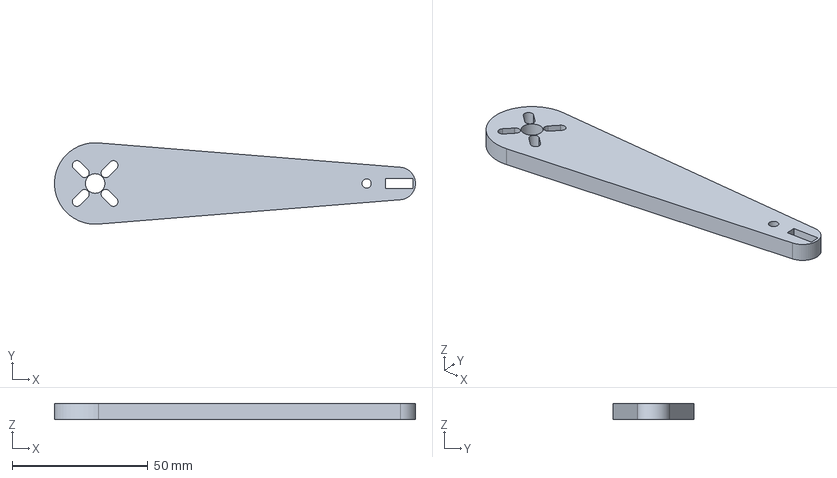
[picture p82: CAD file, 2026-10-16]
модели/чертежи/Рычаг_100мм.step
133.0 x 30.0 x 6.00 mm
