iamharveststorm/harvey/код/симуляция/мини/assets/torso__pcb.stl

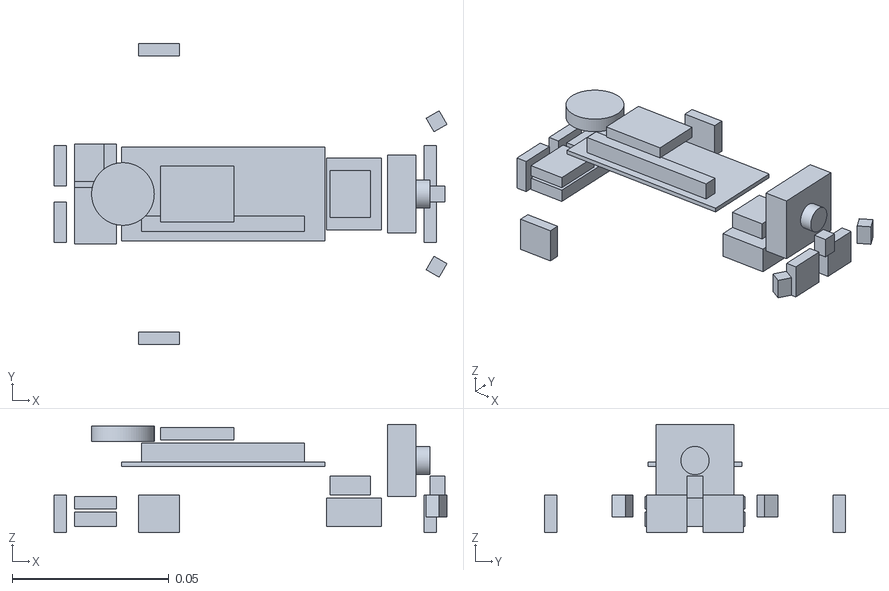
[picture p83: CAD file, 2026-11-03]
код/симуляция/мини/assets/torso__pcb.stl
0.125 x 0.096 x 0.0345
