iamharveststorm/harvey/код/симуляция/управление с клавиатуры/assets/robot/R_ay__grey.stl

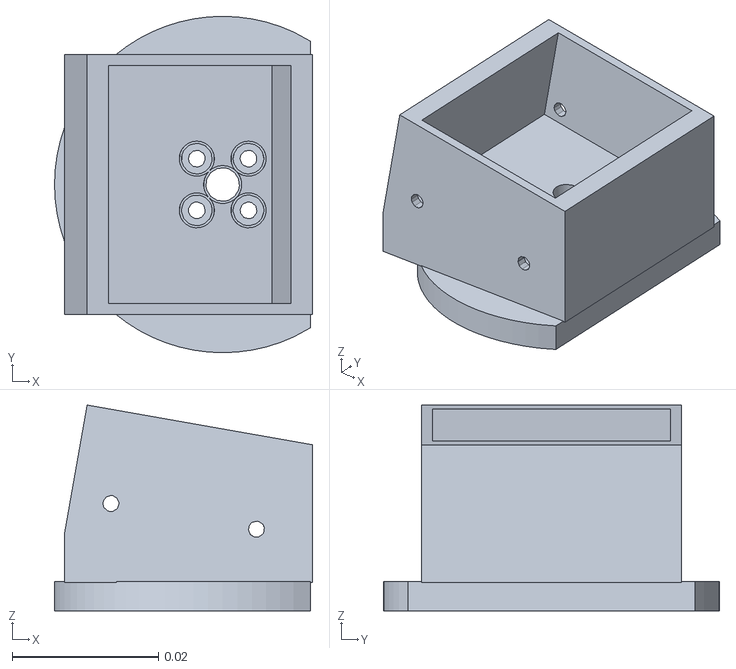
[picture p84: CAD file, 2026-10-16]
код/симуляция/управление с клавиатуры/assets/robot/R_ay__grey.stl
0.0353 x 0.046 x 0.0282
