iamharveststorm/harvey/модели/глаза/stl/R_02_stalk_with_cover.stl

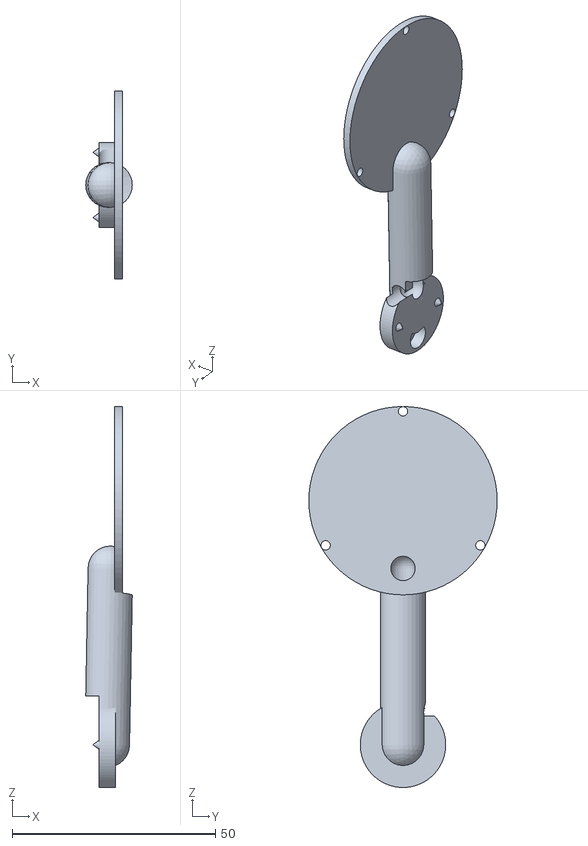
[picture p85: CAD file, 2026-10-16]
модели/глаза/stl/R_02_stalk_with_cover.stl
11.5 x 46.3 x 93.7
