iamharveststorm/harvey/модели/клешни/render_parts/petg_orange.stl

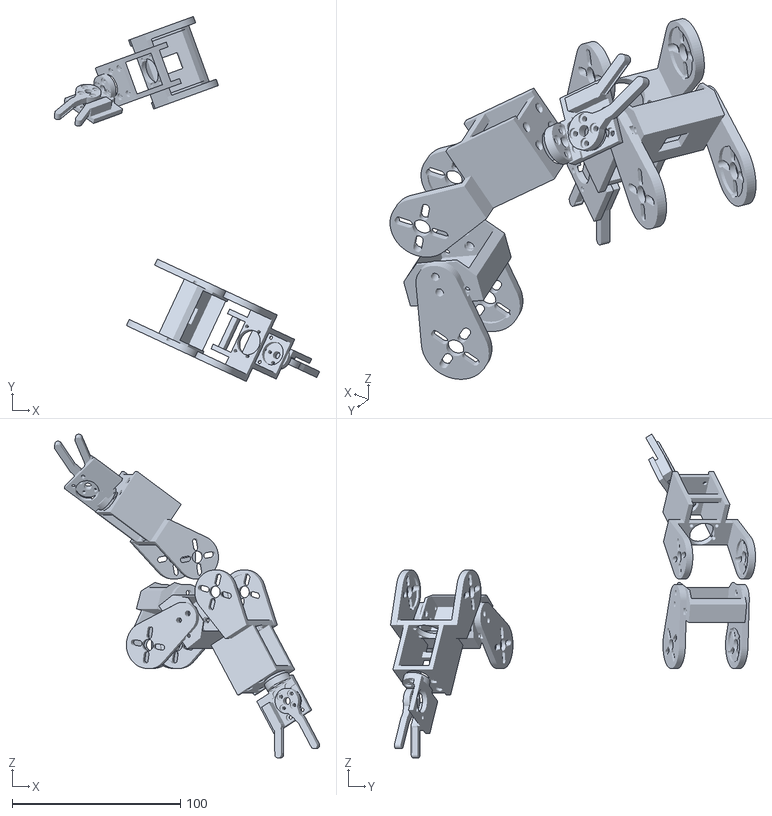
[picture p86: CAD file, 2026-10-16]
модели/клешни/render_parts/petg_orange.stl
157.6 x 216.8 x 192.2
