iamharveststorm/harvey/модели/клешни/stl/R_05_elbow_sleeve.stl

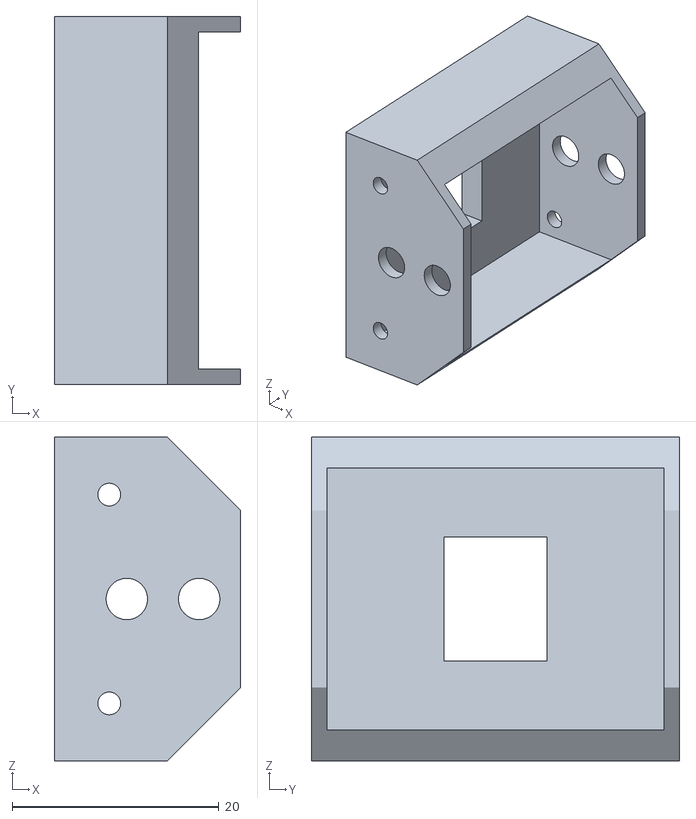
[picture p87: CAD file, 2026-10-16]
модели/клешни/stl/R_05_elbow_sleeve.stl
18.0 x 35.6 x 31.3
