iamharveststorm/harvey/модели/корпус/stl/04_tail_mount.stl

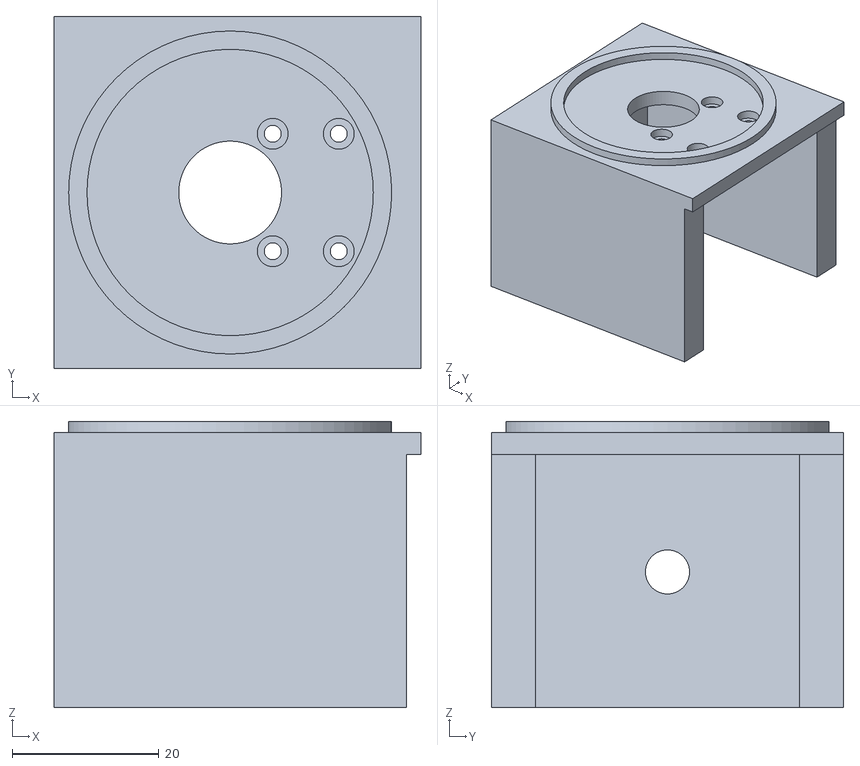
[picture p88: CAD file, 2026-10-16]
модели/корпус/stl/04_tail_mount.stl
50.0 x 48.0 x 39.0
