iamharveststorm/harvey/модели/мини/stl/dock_tower_PLA.stl

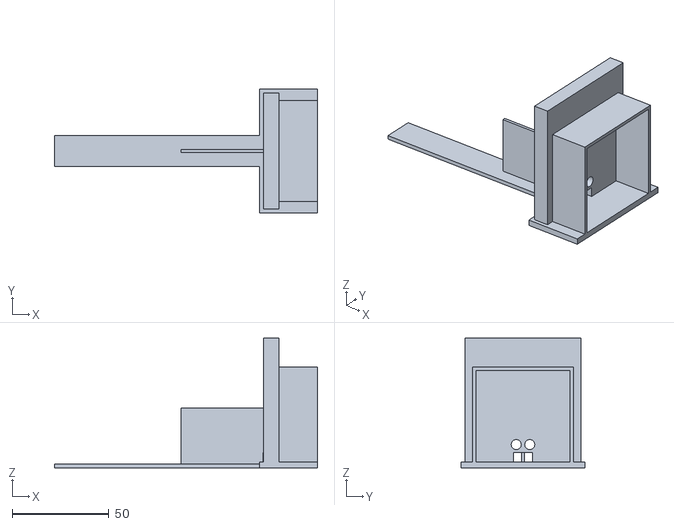
[picture p89: CAD file, 2026-11-03]
модели/мини/stl/dock_tower_PLA.stl
136.0 x 64.0 x 67.0
