iamharveststorm/harvey/модели/рендер/parts/soft/silicone.stl

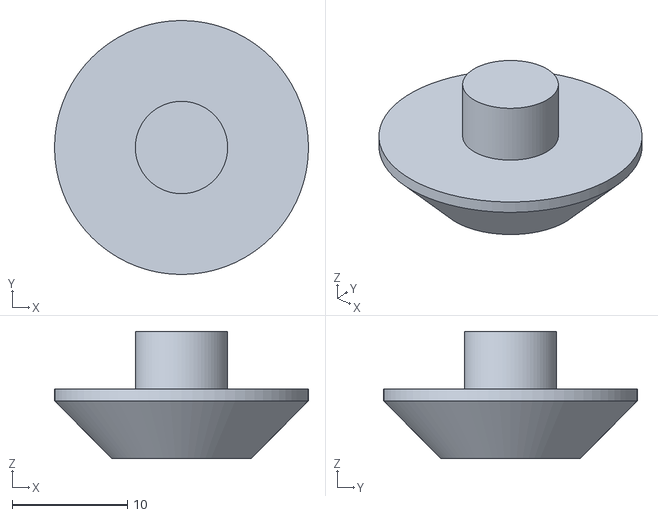
[picture p90: CAD file, 2026-10-16]
модели/рендер/parts/soft/silicone.stl
22.0 x 22.0 x 11.0
