iamharveststorm/harvey/модели/рендер/parts/tech/case.stl

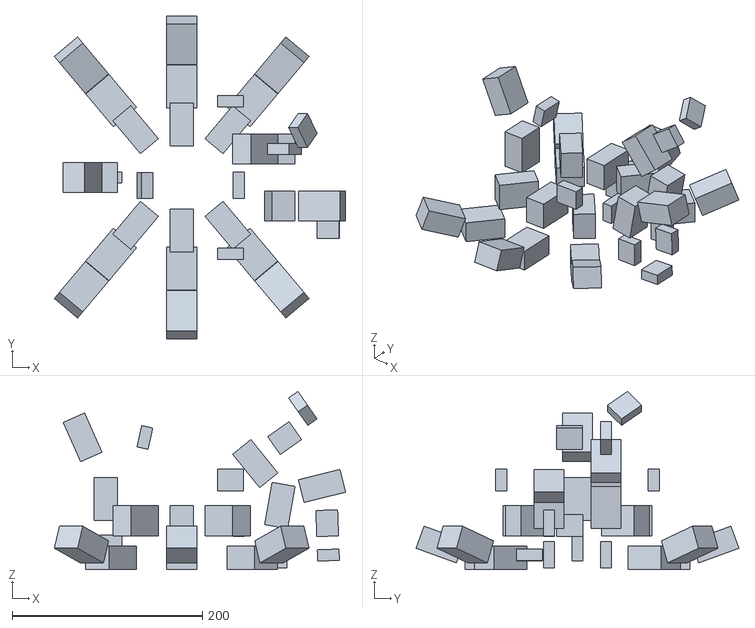
[picture p91: CAD file, 2026-10-16]
модели/рендер/parts/tech/case.stl
306.6 x 339.8 x 187.4
