iamharveststorm/harvey/модели/рендер/parts_mini/tech/tpu.stl

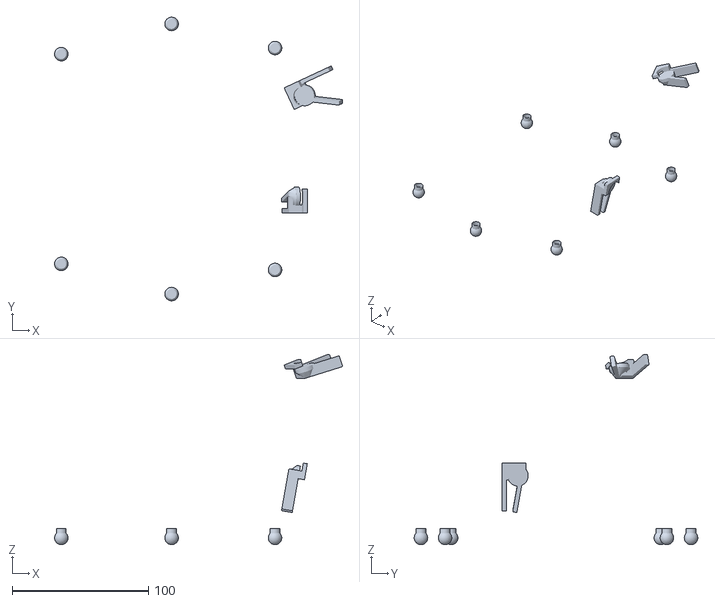
[picture p92: CAD file, 2026-10-16]
модели/рендер/parts_mini/tech/tpu.stl
211.6 x 208.4 x 139.8
