iamharveststorm/harvey/модели/стенд кисти/render_parts/servo21_horns.stl

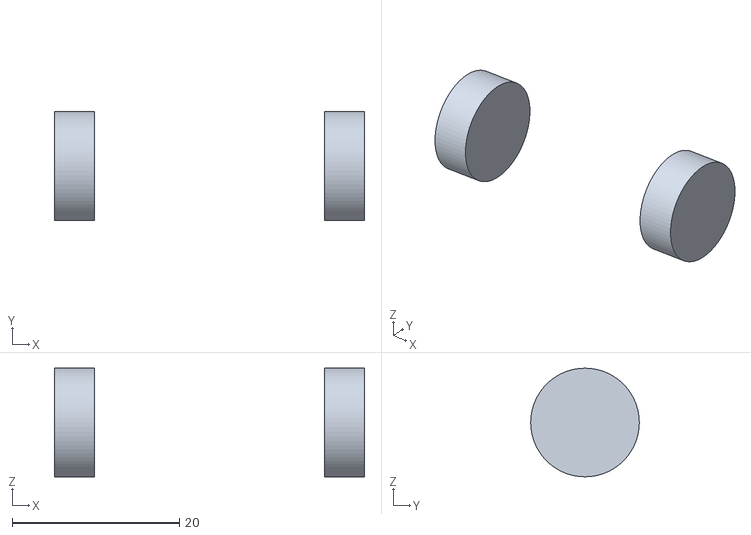
[picture p93: CAD file, 2026-10-16]
модели/стенд кисти/render_parts/servo21_horns.stl
37.1 x 13.0 x 13.0
