iamharveststorm/harvey/модели/стенд кисти/stl/harvey_hand_cradle_sts3032.stl

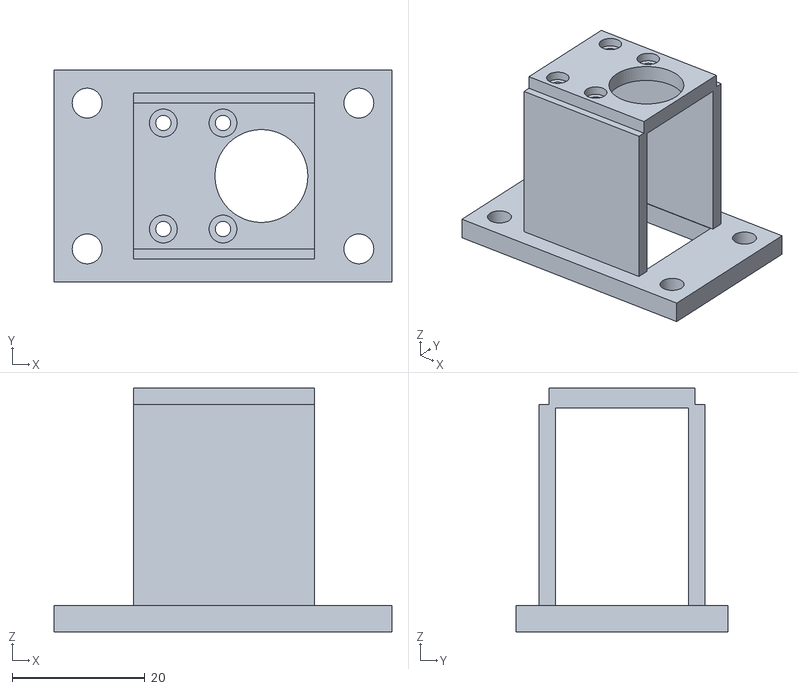
[picture p94: CAD file, 2026-10-16]
модели/стенд кисти/stl/harvey_hand_cradle_sts3032.stl
51.0 x 32.0 x 36.8
