iamharveststorm/harvey/модели/стенд ноги/render_parts/petg_grey.stl

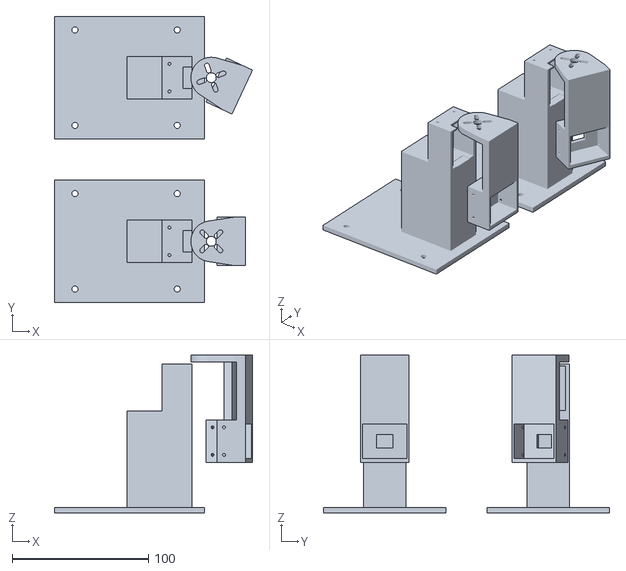
[picture p95: CAD file, 2026-10-16]
модели/стенд ноги/render_parts/petg_grey.stl
145.2 x 210.0 x 115.6
