iamharveststorm/harvey/модели/стенд ноги/stl/harvey_femur_plate_x2.stl

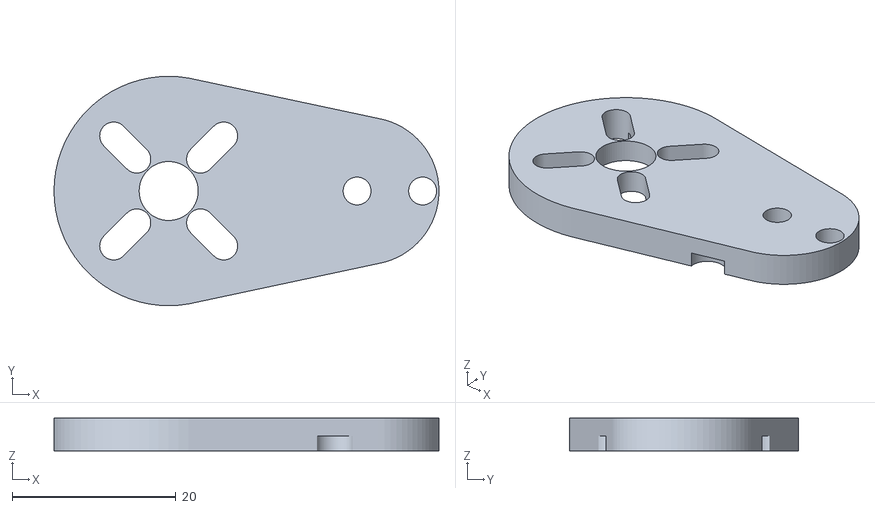
[picture p96: CAD file, 2026-10-16]
модели/стенд ноги/stl/harvey_femur_plate_x2.stl
47.0 x 28.0 x 4.00
