iamharveststorm/harvey/модели/хвост/stl/07_cup_holder.stl

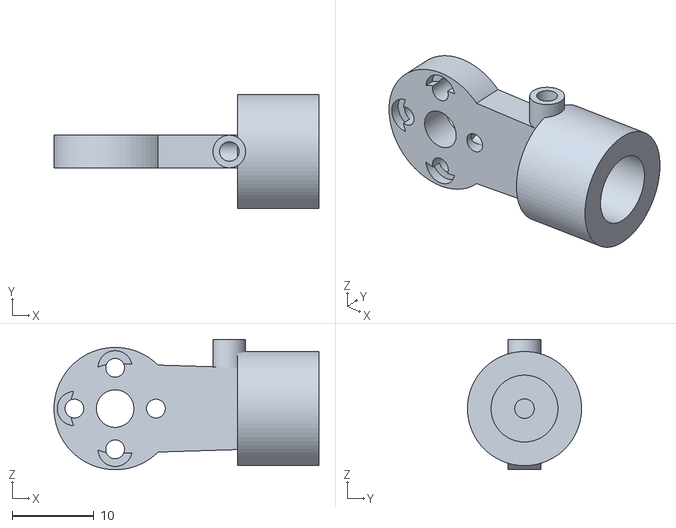
[picture p97: CAD file, 2026-10-16]
модели/хвост/stl/07_cup_holder.stl
32.5 x 14.0 x 16.0
