iamharveststorm/harvey/модели/чертежи/Ладонь_кисти.step

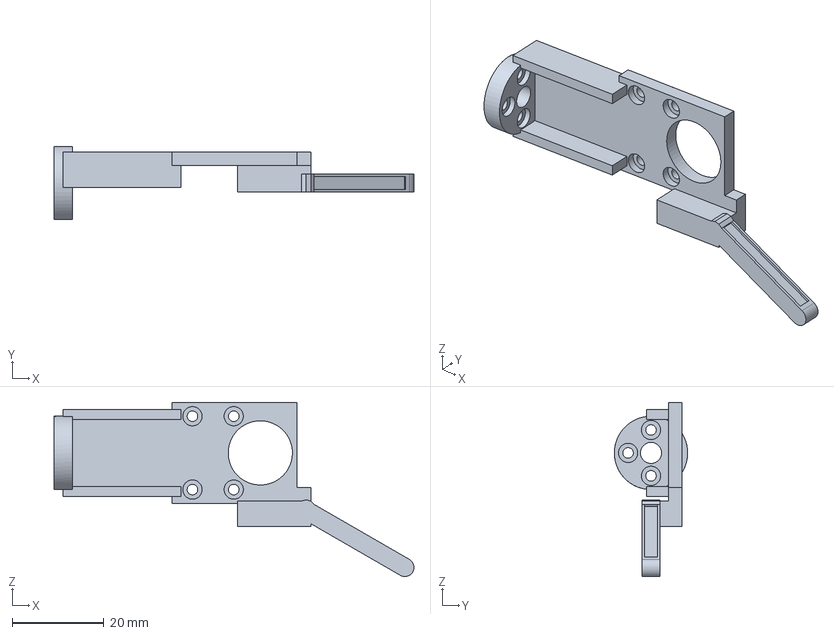
[picture p98: CAD file, 2026-10-16]
модели/чертежи/Ладонь_кисти.step
78.5 x 16.0 x 38.0 mm
