iamharveststorm/harvey/код/симуляция/мини/assets/dock_cover.stl

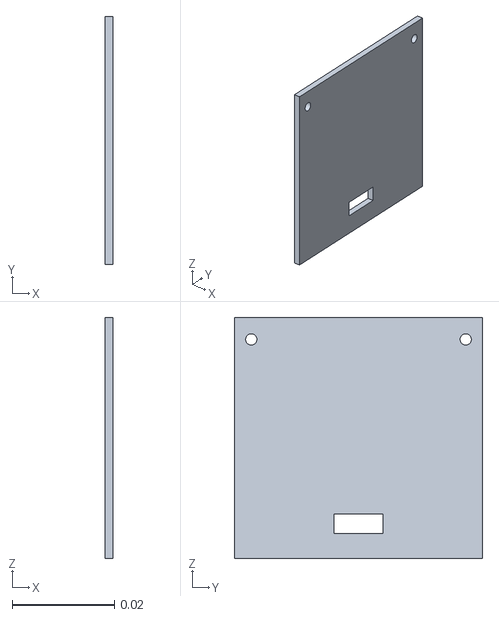
[picture p99: CAD file, 2026-11-02]
код/симуляция/мини/assets/dock_cover.stl
0.0016 x 0.0486 x 0.0472
