iamharveststorm/harvey/код/симуляция/управление с клавиатуры/assets/robot/leg_femur__orange.stl

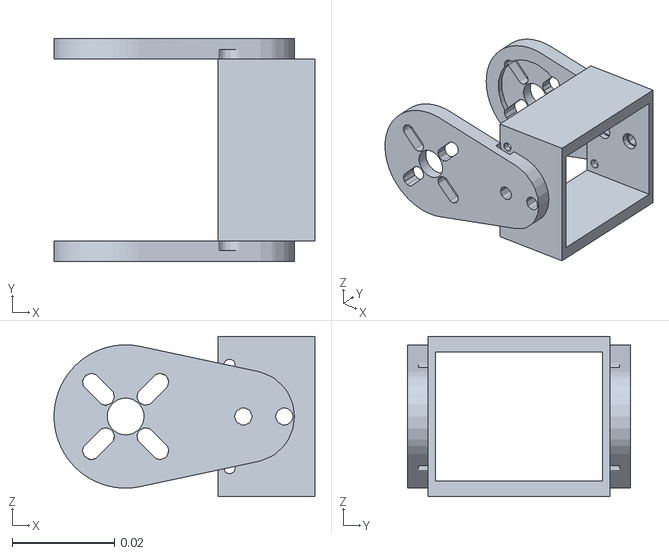
[picture p100: CAD file, 2026-10-16]
код/симуляция/управление с клавиатуры/assets/robot/leg_femur__orange.stl
0.051 x 0.0436 x 0.0313
