iamharveststorm/harvey/модели/глаза/stl/L_03_housing.stl

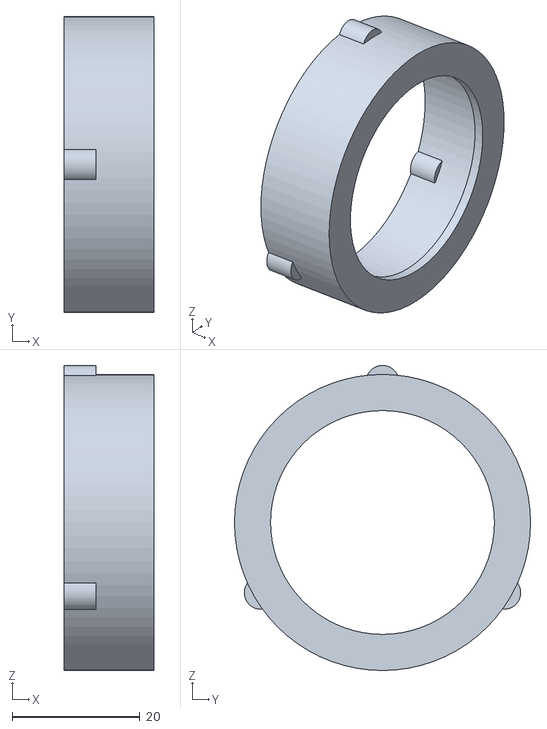
[picture p101: CAD file, 2026-10-16]
модели/глаза/stl/L_03_housing.stl
14.1 x 46.3 x 47.7
