iamharveststorm/harvey/модели/клешни/render_parts/case.stl

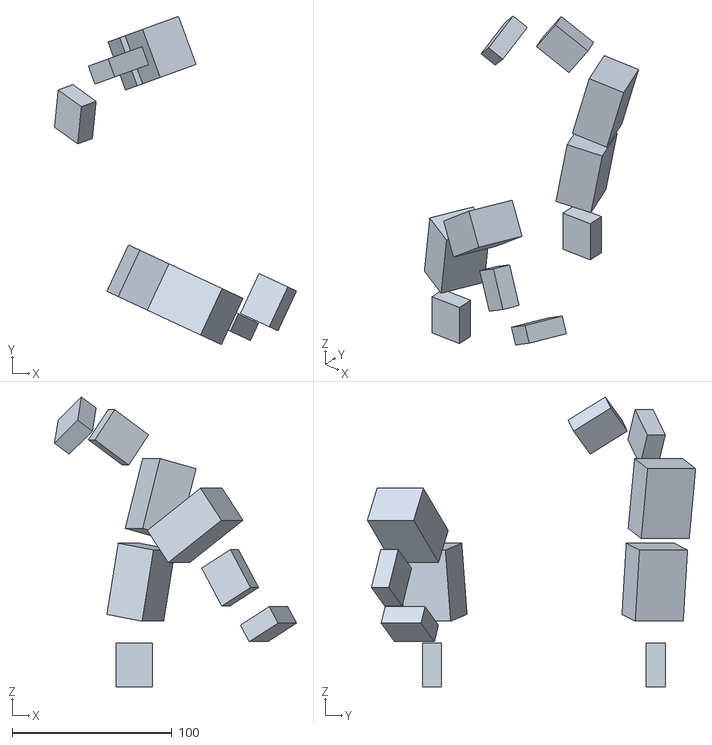
[picture p102: CAD file, 2026-10-16]
модели/клешни/render_parts/case.stl
151.5 x 205.4 x 181.4
