iamharveststorm/harvey/модели/клешни/stl/L_08_jaw.stl

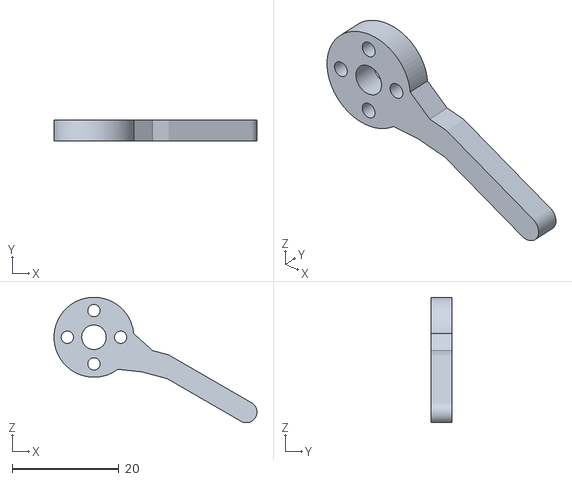
[picture p103: CAD file, 2026-10-16]
модели/клешни/stl/L_08_jaw.stl
38.1 x 4.00 x 23.5
