iamharveststorm/harvey/модели/корпус/stl/01_belly.stl

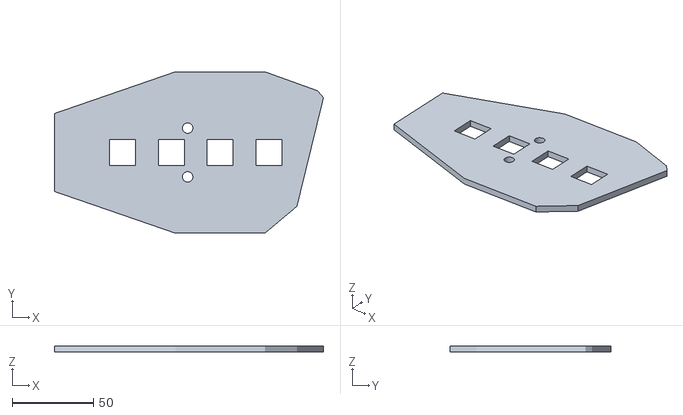
[picture p104: CAD file, 2026-10-16]
модели/корпус/stl/01_belly.stl
165.6 x 99.3 x 4.00
