iamharveststorm/harvey/модели/мини/stl/dock_cover_PLA.stl

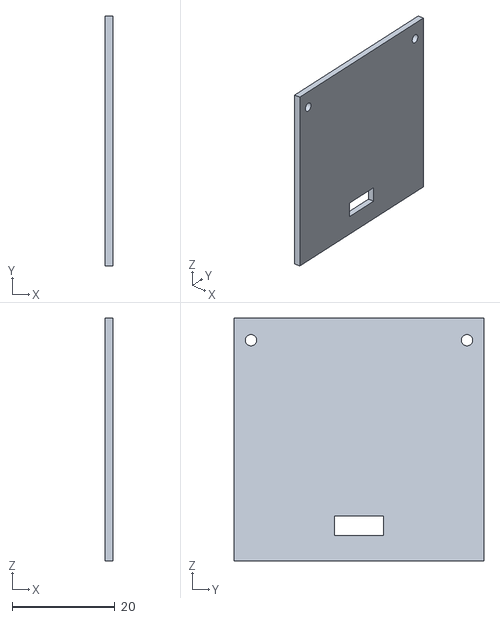
[picture p105: CAD file, 2026-11-02]
модели/мини/stl/dock_cover_PLA.stl
1.60 x 48.6 x 47.2
