iamharveststorm/harvey/модели/рендер/parts/soft/metal.stl

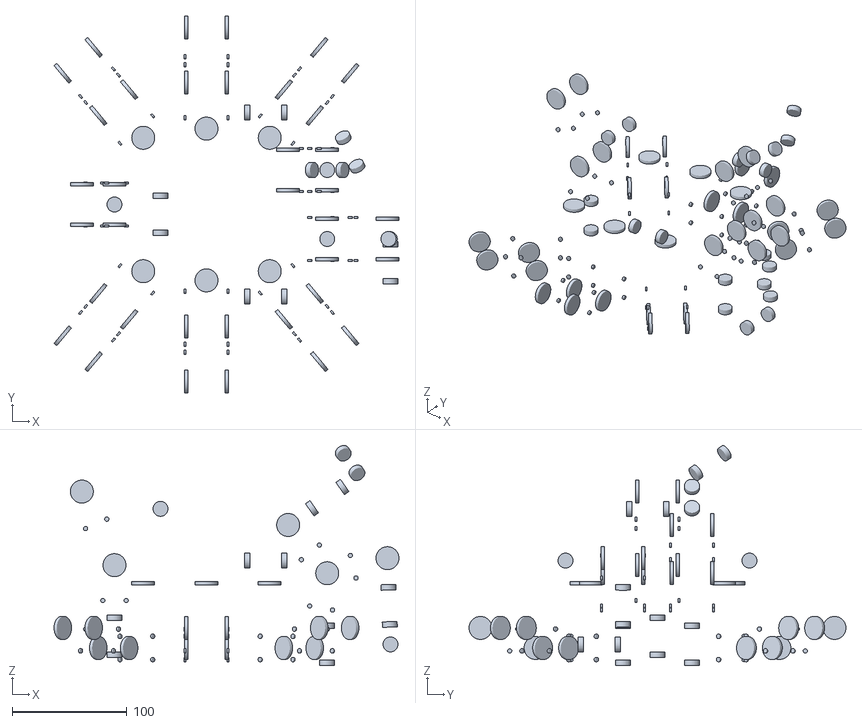
[picture p106: CAD file, 2026-10-16]
модели/рендер/parts/soft/metal.stl
300.0 x 327.8 x 191.4
