iamharveststorm/harvey/модели/рендер/parts/tech/orange.stl

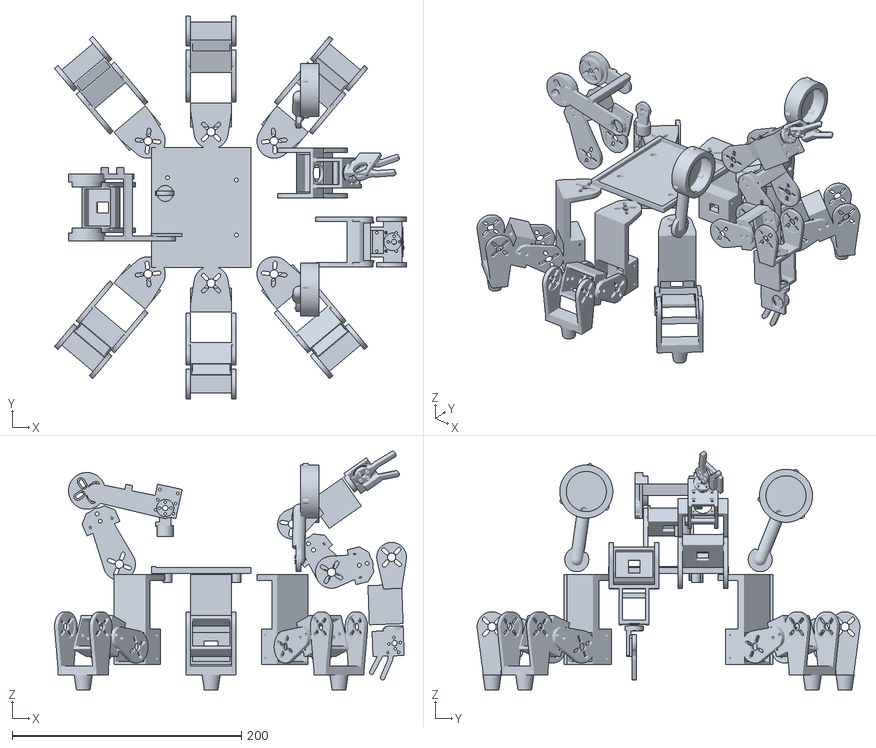
[picture p107: CAD file, 2026-10-16]
модели/рендер/parts/tech/orange.stl
307.0 x 333.8 x 208.2
