iamharveststorm/harvey/модели/рендер/parts_mini/tech/orange.stl

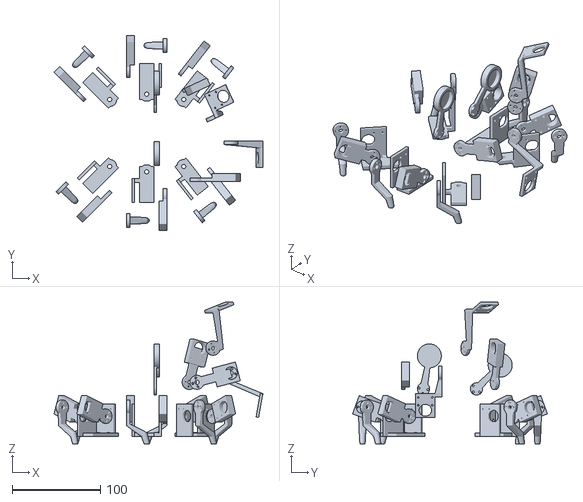
[picture p108: CAD file, 2026-10-16]
модели/рендер/parts_mini/tech/orange.stl
236.9 x 220.9 x 160.5
