iamharveststorm/harvey/модели/стенд кисти/render_parts/servo22_case.stl

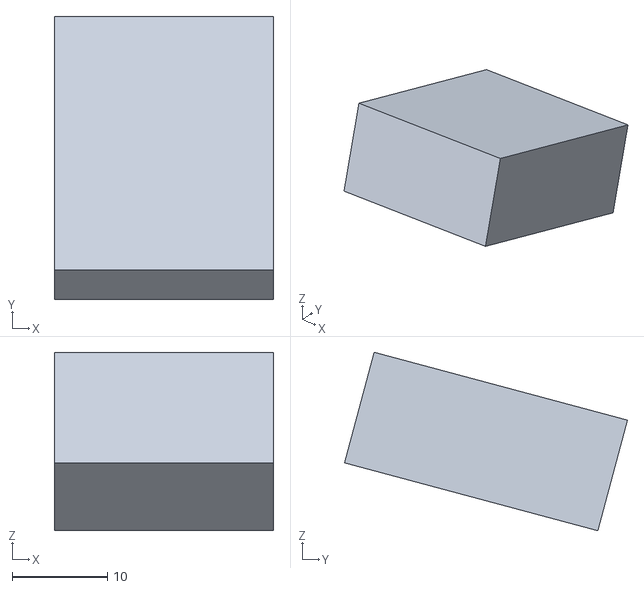
[picture p109: CAD file, 2026-10-16]
модели/стенд кисти/render_parts/servo22_case.stl
23.0 x 29.7 x 18.7
