iamharveststorm/harvey/модели/стенд кисти/stl/harvey_hand_jaw.stl

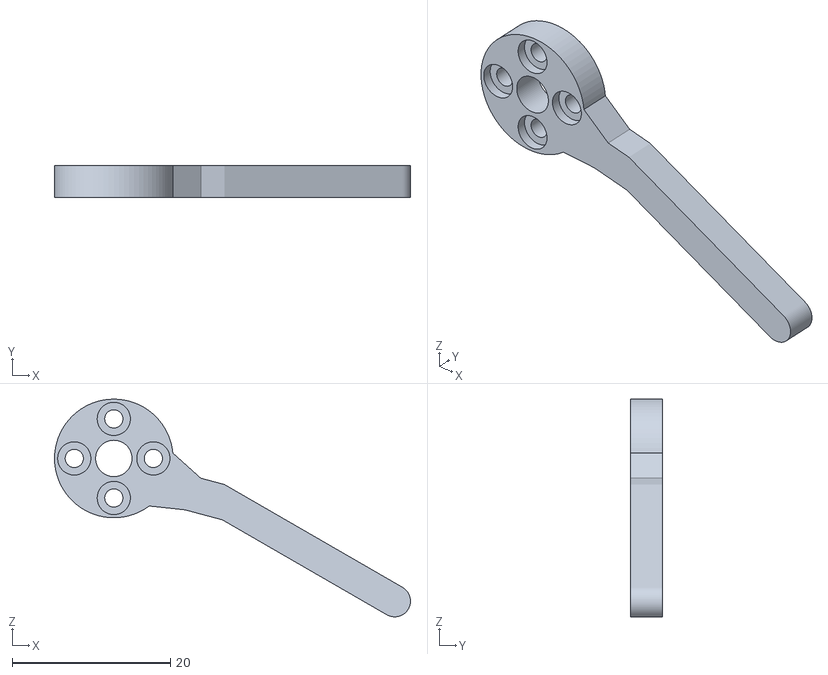
[picture p110: CAD file, 2026-10-16]
модели/стенд кисти/stl/harvey_hand_jaw.stl
45.0 x 4.00 x 27.5
