iamharveststorm/harvey/модели/стенд ноги/render_parts/tpu.stl

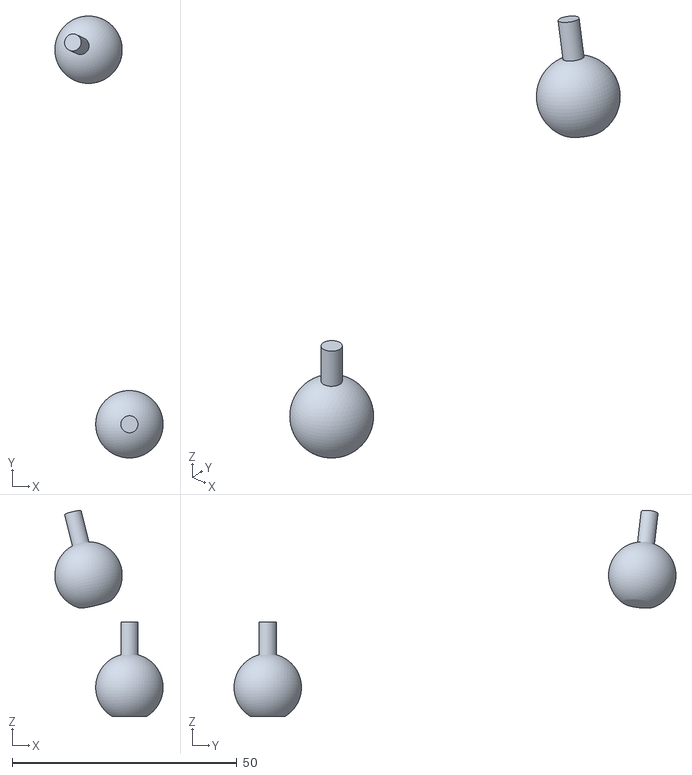
[picture p111: CAD file, 2026-10-16]
модели/стенд ноги/render_parts/tpu.stl
24.1 x 98.2 x 45.9
