iamharveststorm/harvey/модели/стенд ноги/stl/harvey_leg_tower.stl

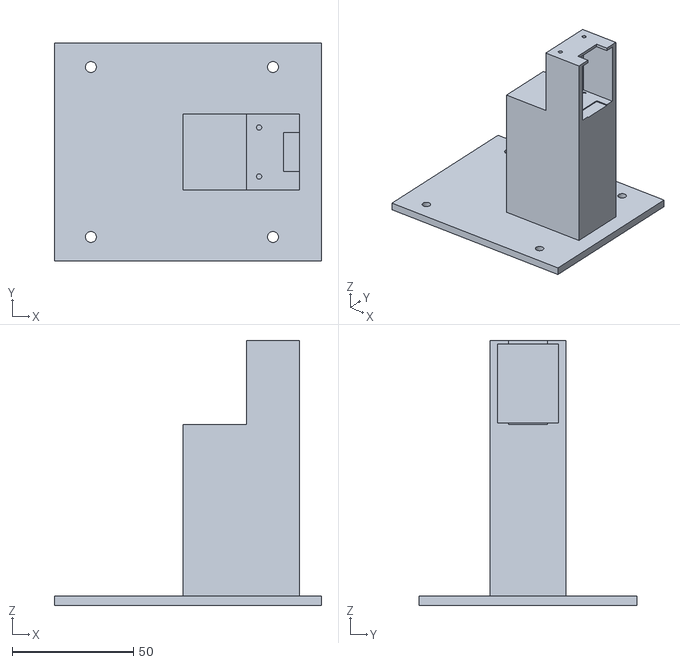
[picture p112: CAD file, 2026-10-16]
модели/стенд ноги/stl/harvey_leg_tower.stl
110.0 x 90.0 x 109.3
