iamharveststorm/harvey/модели/хвост/stl/01_base.stl

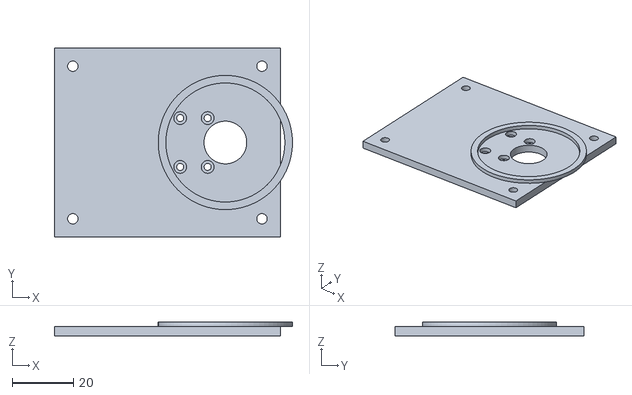
[picture p113: CAD file, 2026-10-16]
модели/хвост/stl/01_base.stl
78.0 x 62.0 x 4.50
