iamharveststorm/harvey/код/симуляция/мини/assets/torso__grey.stl

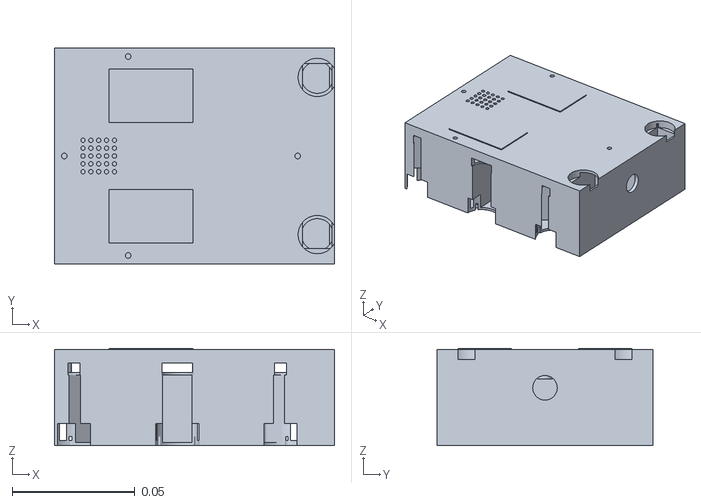
[picture p114: CAD file, 2026-10-16]
код/симуляция/мини/assets/torso__grey.stl
0.114 x 0.088 x 0.0395
