iamharveststorm/harvey/код/симуляция/управление с клавиатуры/assets/robot/T_up__metal.stl

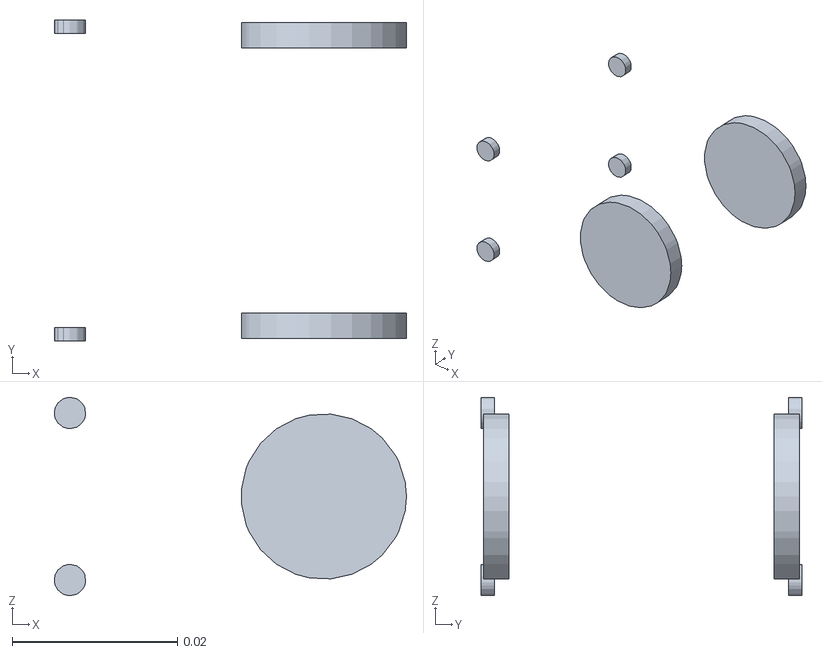
[picture p115: CAD file, 2026-10-16]
код/симуляция/управление с клавиатуры/assets/robot/T_up__metal.stl
0.0426 x 0.0388 x 0.024
