iamharveststorm/harvey/модели/клешни/render_parts/tpu.stl

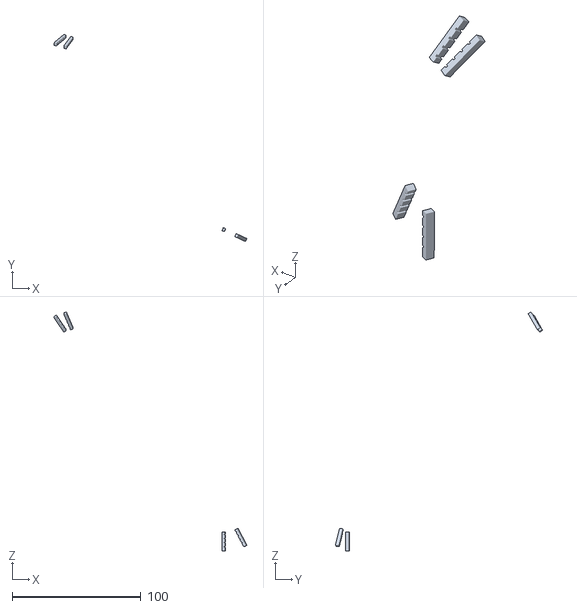
[picture p116: CAD file, 2026-10-16]
модели/клешни/render_parts/tpu.stl
149.8 x 160.9 x 185.6
