iamharveststorm/harvey/модели/клешни/stl/R_09_pad_TPU.stl

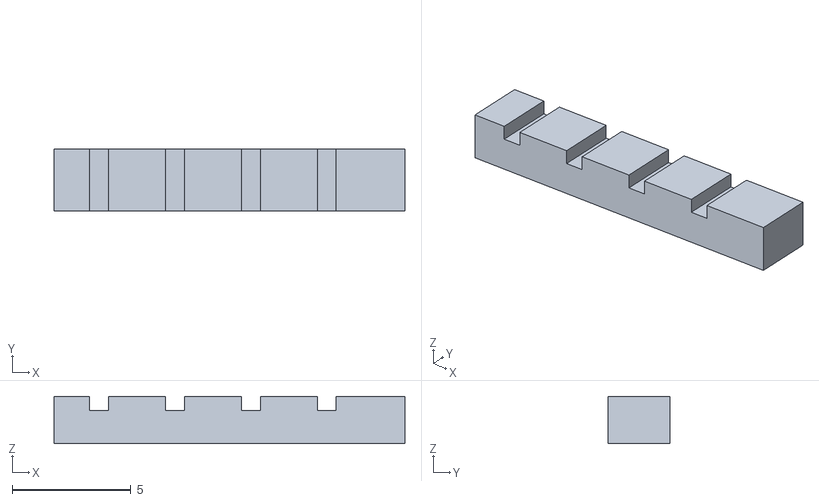
[picture p117: CAD file, 2026-10-16]
модели/клешни/stl/R_09_pad_TPU.stl
14.8 x 2.60 x 2.00
