iamharveststorm/harvey/модели/корпус/stl/08_edge_sensor_4.stl

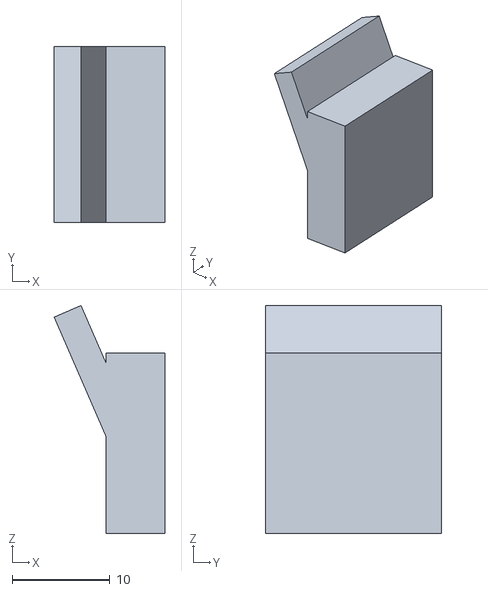
[picture p118: CAD file, 2026-10-16]
модели/корпус/stl/08_edge_sensor_4.stl
11.3 x 18.0 x 23.3
