iamharveststorm/harvey/модели/мини/stl/lid_PLA.stl

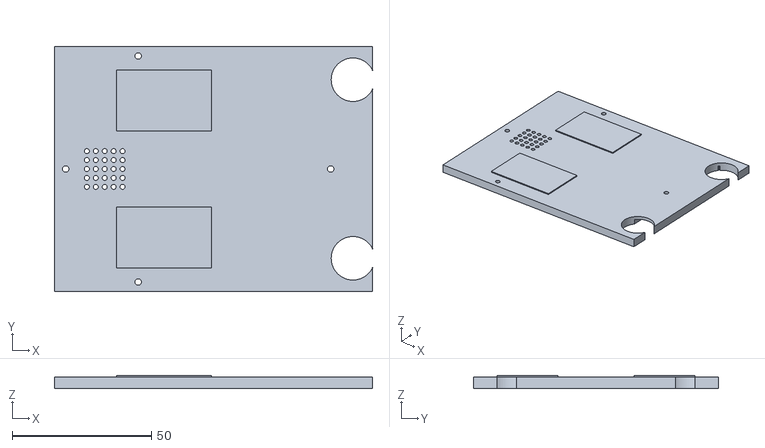
[picture p119: CAD file, 2026-10-16]
модели/мини/stl/lid_PLA.stl
114.0 x 88.0 x 4.51
