iamharveststorm/harvey/модели/рендер/parts/soft/glass.stl

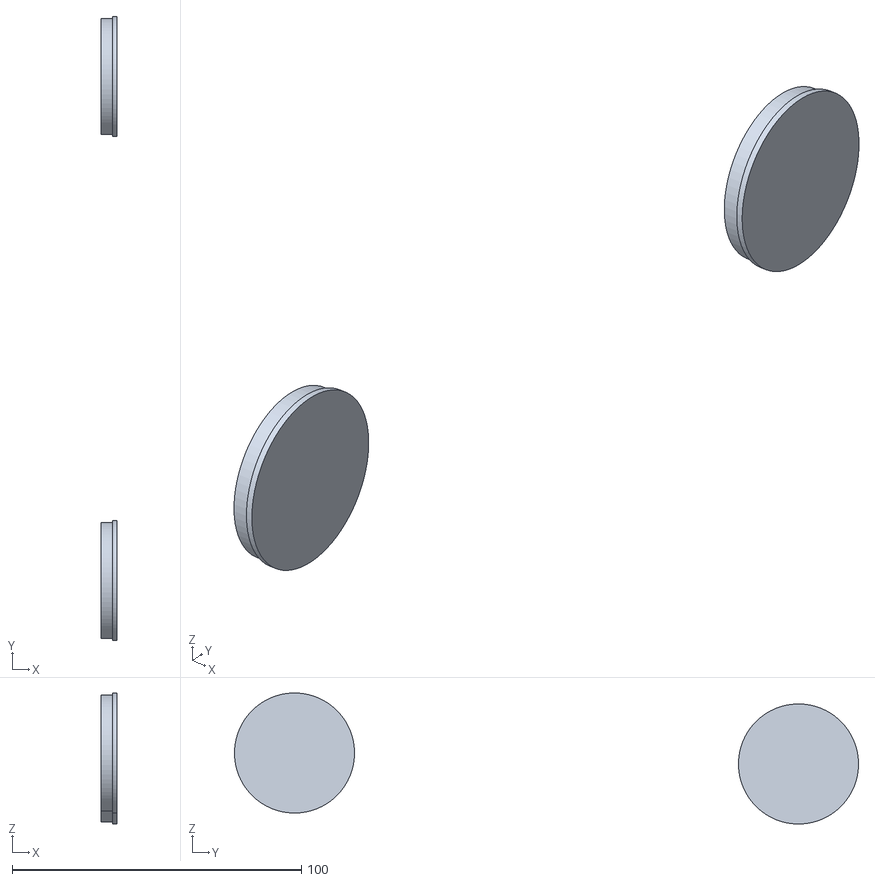
[picture p120: CAD file, 2026-10-16]
модели/рендер/parts/soft/glass.stl
5.55 x 215.6 x 45.3
