iamharveststorm/harvey/модели/рендер/parts/tech/battery.stl

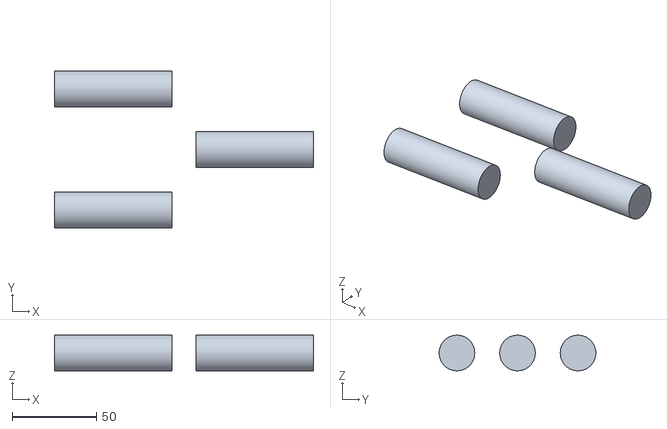
[picture p121: CAD file, 2026-10-16]
модели/рендер/parts/tech/battery.stl
154.0 x 93.2 x 21.2
