iamharveststorm/harvey/модели/рендер/parts_mini/tech/grey.stl

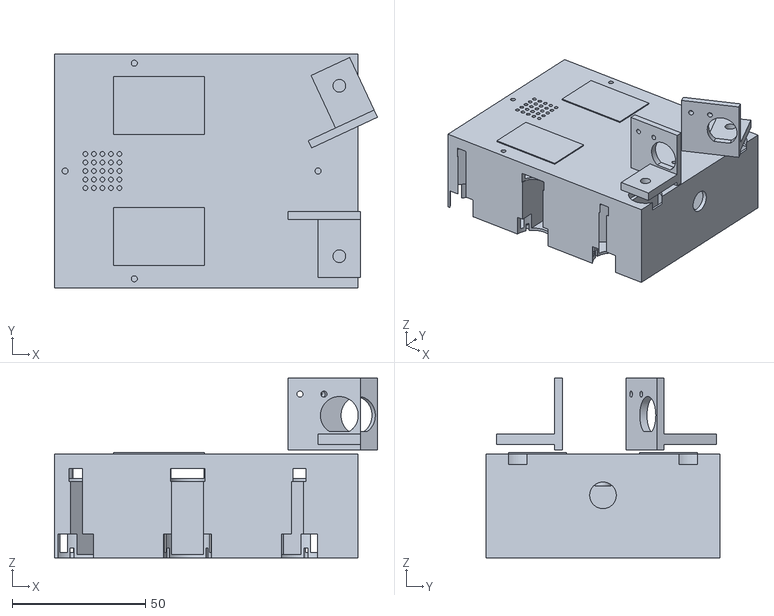
[picture p122: CAD file, 2026-10-16]
модели/рендер/parts_mini/tech/grey.stl
121.3 x 88.0 x 67.5
