iamharveststorm/harvey/модели/стенд кисти/render_parts/stand.stl

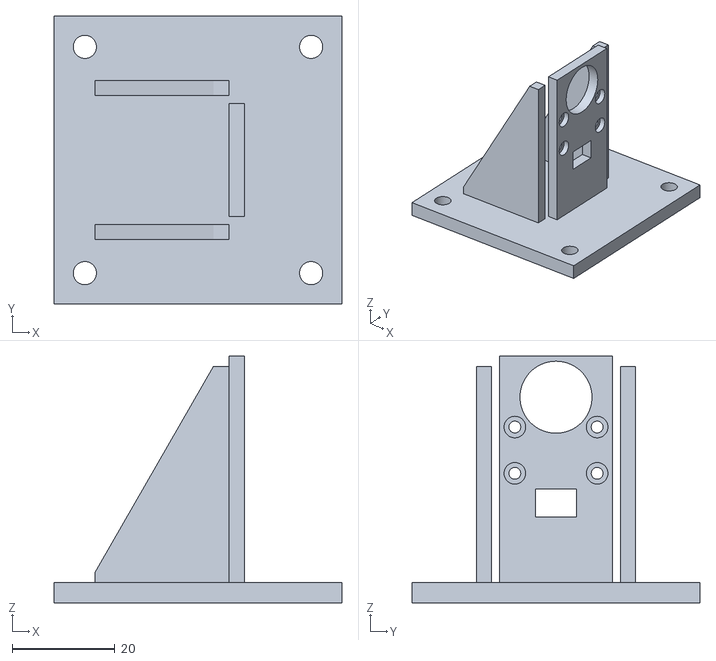
[picture p123: CAD file, 2026-10-16]
модели/стенд кисти/render_parts/stand.stl
56.0 x 56.0 x 48.0
