iamharveststorm/harvey/модели/стенд кисти/stl/harvey_hand_palm.stl

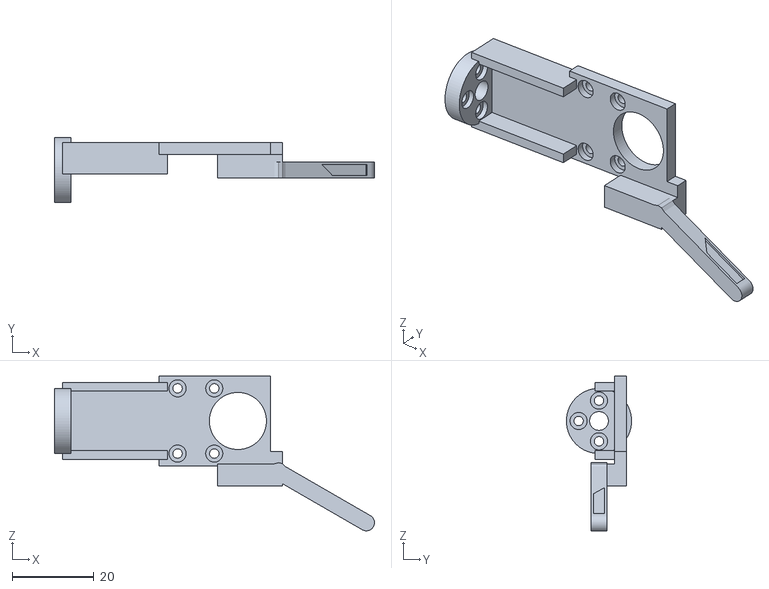
[picture p124: CAD file, 2026-10-16]
модели/стенд кисти/stl/harvey_hand_palm.stl
78.5 x 16.0 x 38.0
