iamharveststorm/harvey/модели/стенд ноги/stl/harvey_knee_sleeve.stl

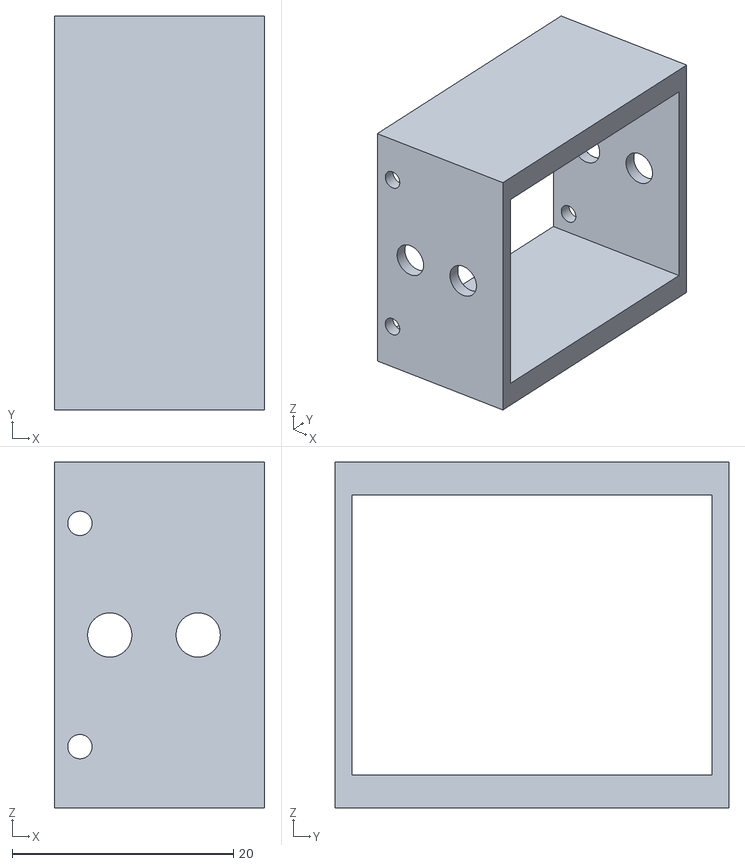
[picture p125: CAD file, 2026-10-16]
модели/стенд ноги/stl/harvey_knee_sleeve.stl
19.0 x 35.6 x 31.3
