iamharveststorm/harvey/код/симуляция/мини/assets/leg_femur__orange.stl

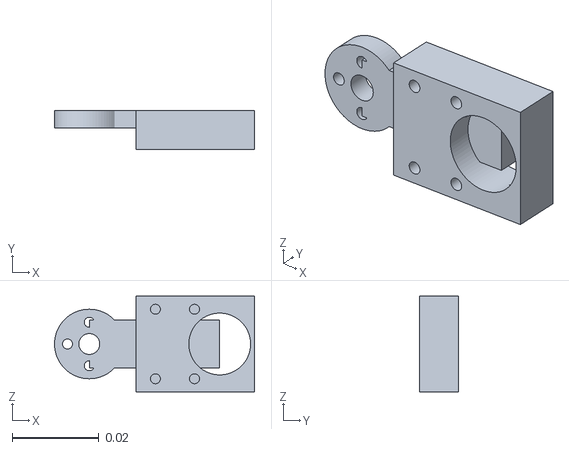
[picture p126: CAD file, 2026-10-16]
код/симуляция/мини/assets/leg_femur__orange.stl
0.046 x 0.009 x 0.022
