iamharveststorm/harvey/код/симуляция/управление с клавиатуры/assets/robot/R_fore__servo.stl

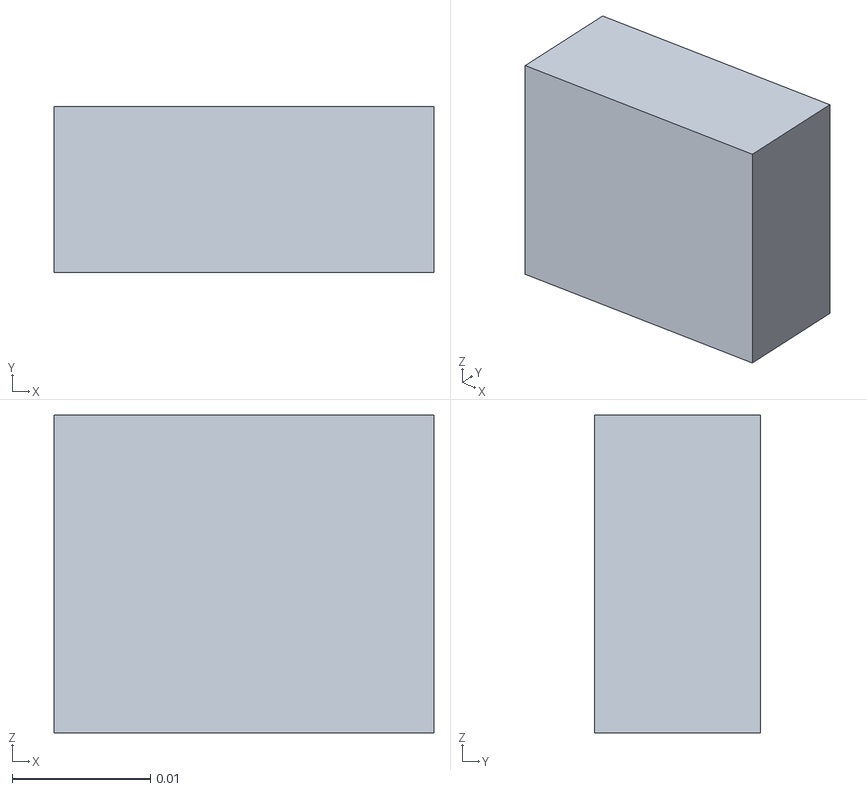
[picture p127: CAD file, 2026-10-16]
код/симуляция/управление с клавиатуры/assets/robot/R_fore__servo.stl
0.0275 x 0.012 x 0.023
