iamharveststorm/harvey/модели/клешни/render_parts/metal.stl

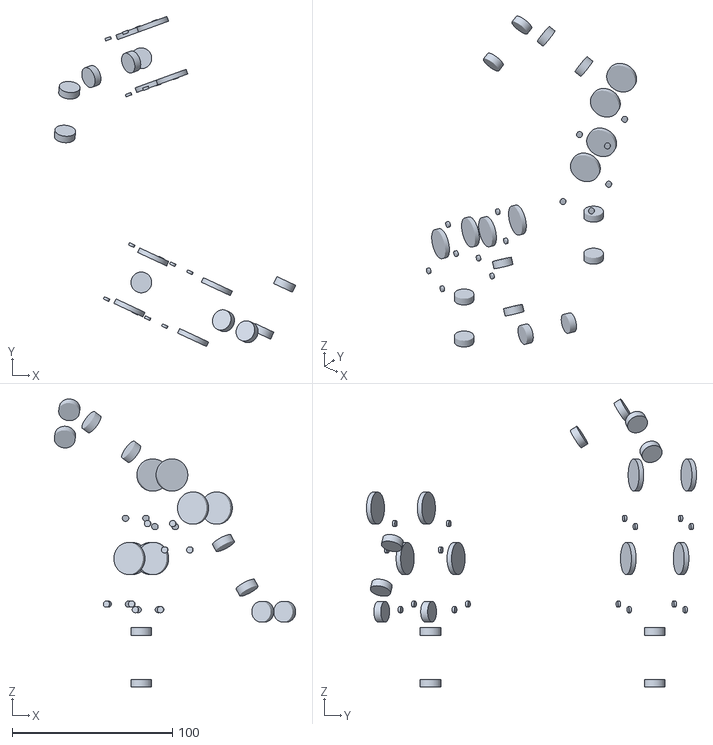
[picture p128: CAD file, 2026-10-16]
модели/клешни/render_parts/metal.stl
150.8 x 206.2 x 179.9
