iamharveststorm/harvey/модели/клешни/stl/L_07_hand.stl

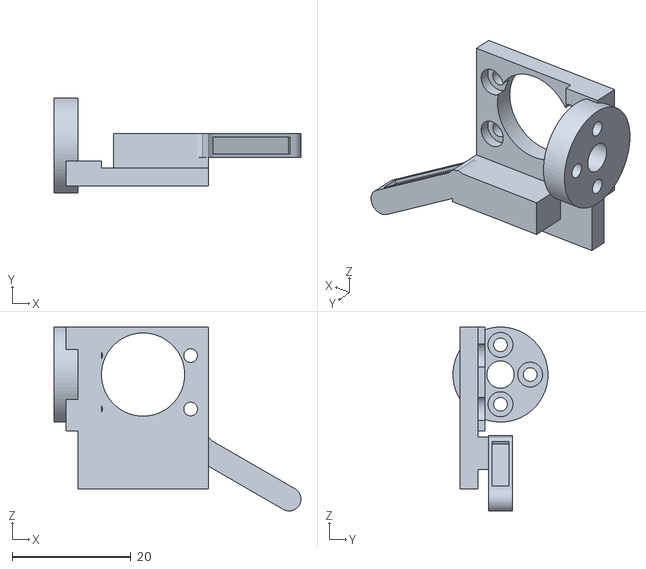
[picture p129: CAD file, 2026-10-16]
модели/клешни/stl/L_07_hand.stl
41.6 x 16.0 x 31.0
