iamharveststorm/harvey/модели/мини/stl/chassis_PLA.stl

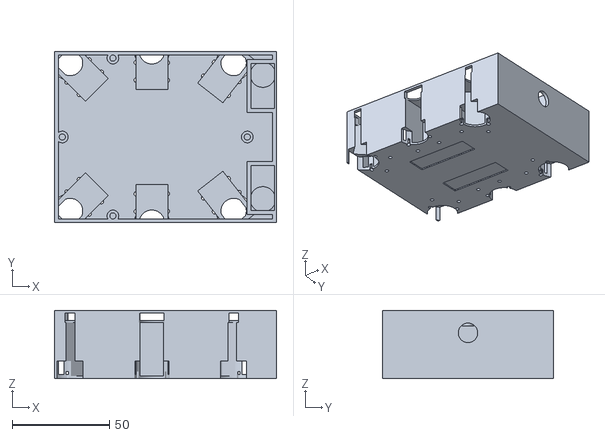
[picture p130: CAD file, 2026-10-16]
модели/мини/stl/chassis_PLA.stl
114.0 x 88.0 x 35.0
