iamharveststorm/harvey/модели/рендер/parts_mini/tech/battery.stl

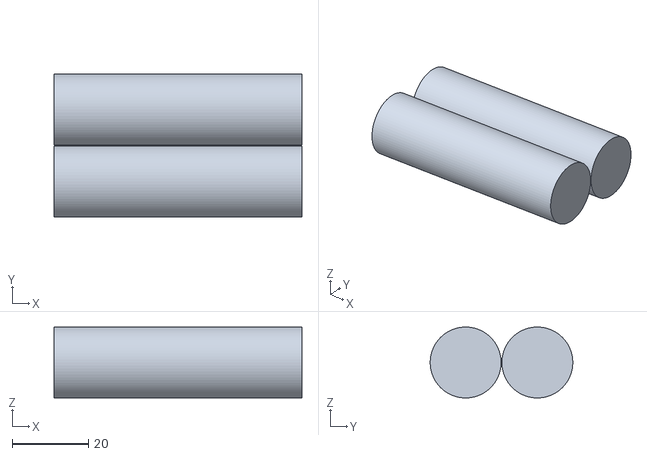
[picture p131: CAD file, 2026-10-16]
модели/рендер/parts_mini/tech/battery.stl
65.0 x 37.4 x 18.6
