iamharveststorm/harvey/модели/стенд кисти/render_parts/jaw.stl

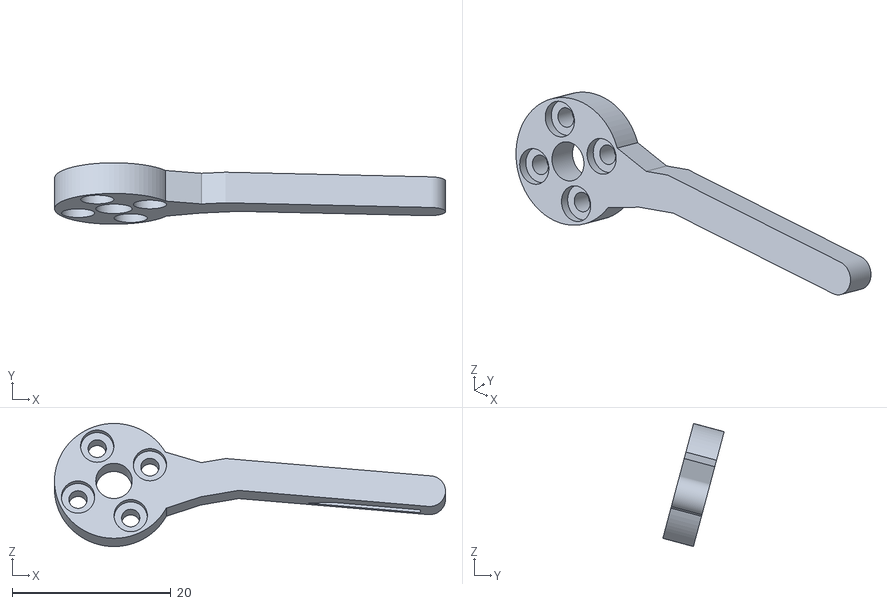
[picture p132: CAD file, 2026-10-16]
модели/стенд кисти/render_parts/jaw.stl
49.3 x 7.75 x 15.5
