iamharveststorm/harvey/модели/стенд кисти/stl/_сборка_для_просмотра.stl

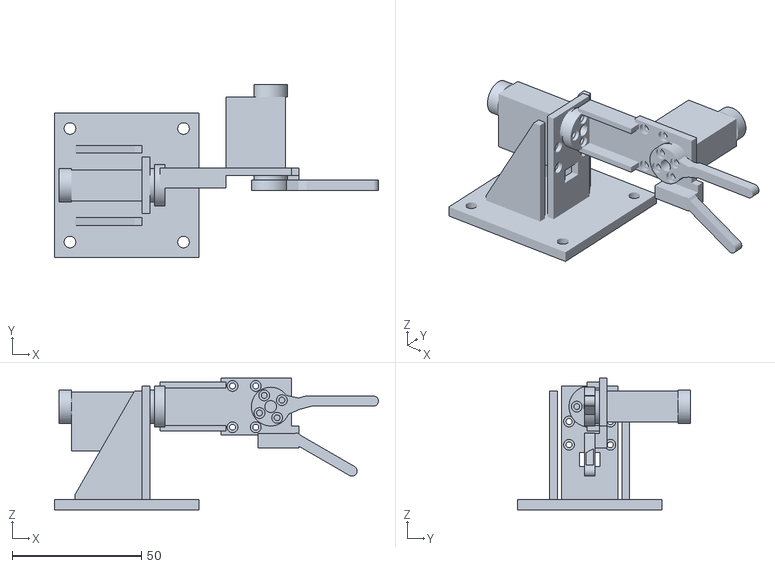
[picture p133: CAD file, 2026-10-16]
модели/стенд кисти/stl/_сборка_для_просмотра.stl
125.6 x 67.1 x 51.0
