iamharveststorm/harvey/модели/стенд ноги/render_parts/petg_orange.stl

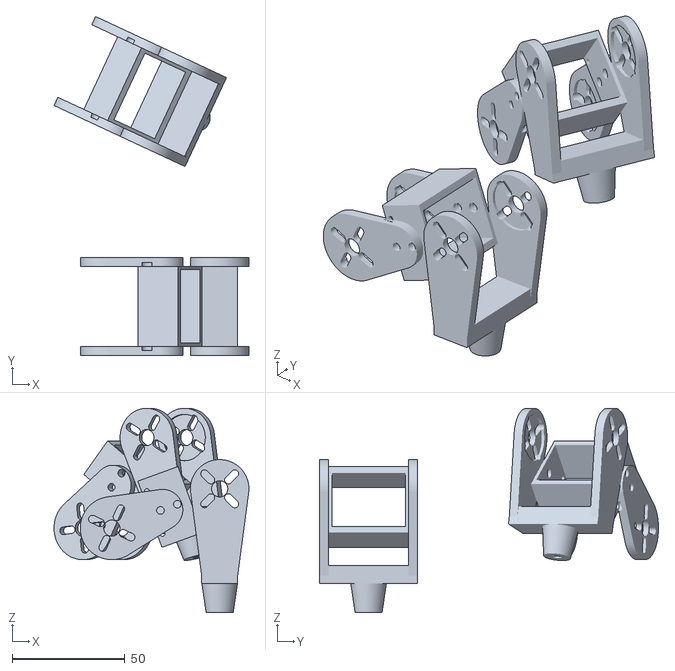
[picture p134: CAD file, 2026-10-16]
модели/стенд ноги/render_parts/petg_orange.stl
86.6 x 150.6 x 90.8
