iamharveststorm/harvey/модели/стенд ноги/stl/harvey_tibia_fork.stl

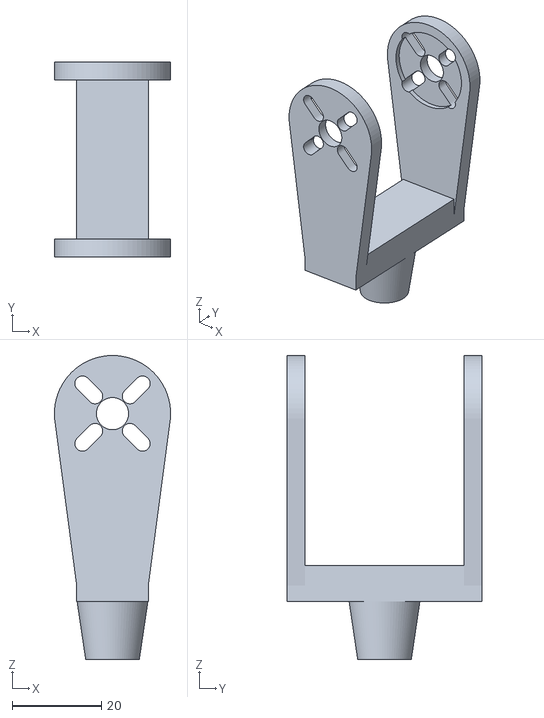
[picture p135: CAD file, 2026-10-16]
модели/стенд ноги/stl/harvey_tibia_fork.stl
26.0 x 43.6 x 68.0
