iamharveststorm/harvey/модели/хвост/stl/06_forearm.stl

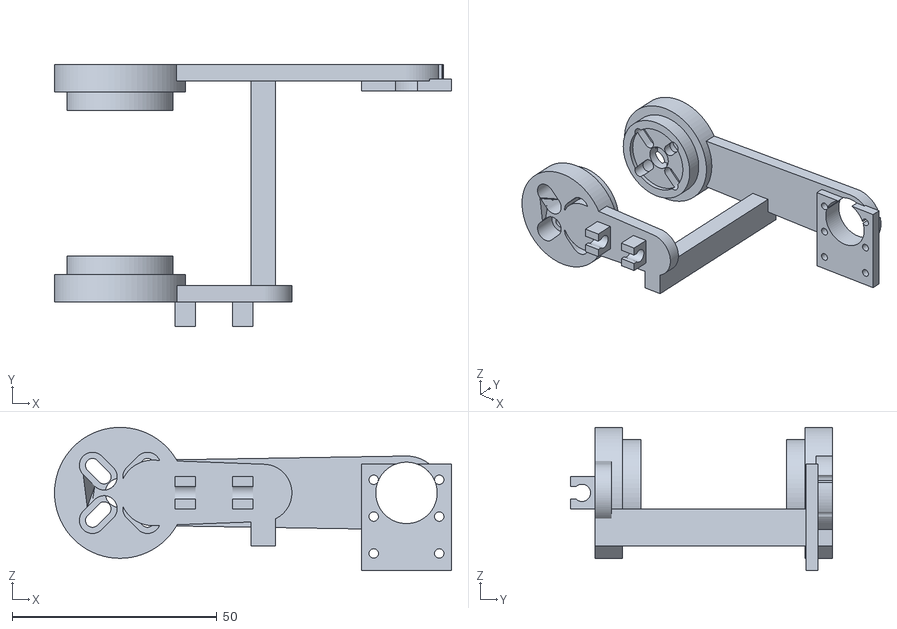
[picture p136: CAD file, 2026-10-16]
модели/хвост/stl/06_forearm.stl
97.0 x 64.0 x 35.0
