iamharveststorm/harvey/код/симуляция/мини/assets/R_eye__screen.stl

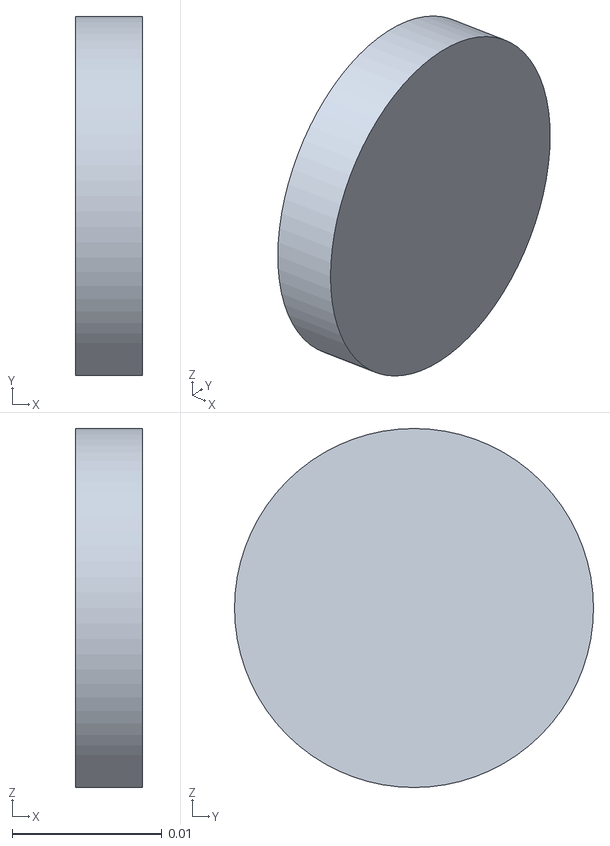
[picture p137: CAD file, 2026-10-16]
код/симуляция/мини/assets/R_eye__screen.stl
0.0045 x 0.024 x 0.024
