iamharveststorm/harvey/код/симуляция/управление с клавиатуры/assets/robot/L_fore__orange.stl

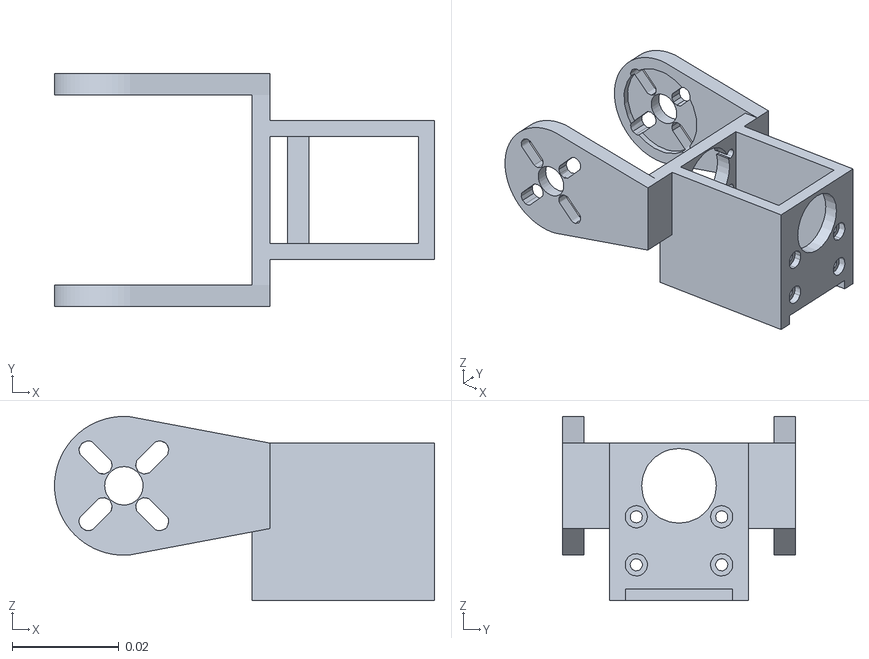
[picture p138: CAD file, 2026-10-16]
код/симуляция/управление с клавиатуры/assets/robot/L_fore__orange.stl
0.0712 x 0.0436 x 0.0345
