iamharveststorm/harvey/модели/глаза/stl/R_04_bumper_TPU.stl

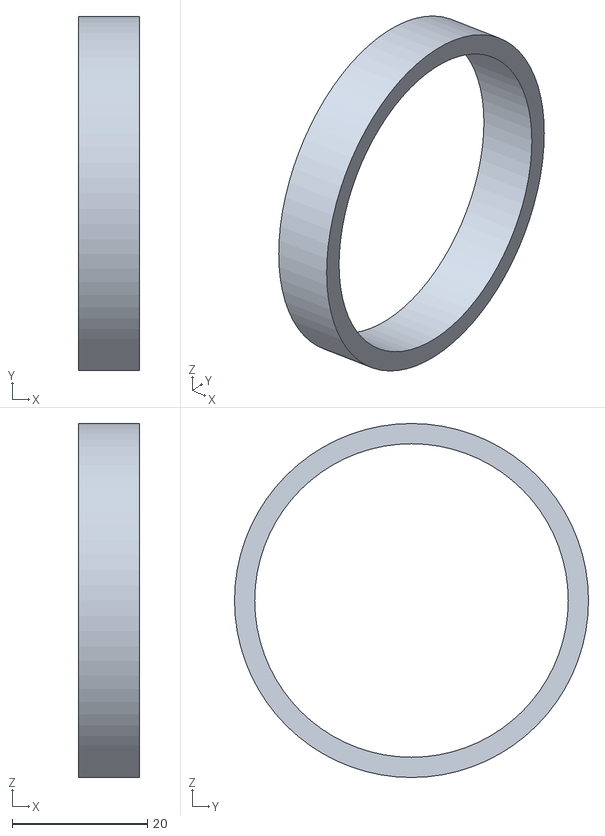
[picture p139: CAD file, 2026-10-16]
модели/глаза/stl/R_04_bumper_TPU.stl
9.00 x 52.3 x 52.3
