iamharveststorm/harvey/модели/клешни/stl/_сборка_для_просмотра.stl

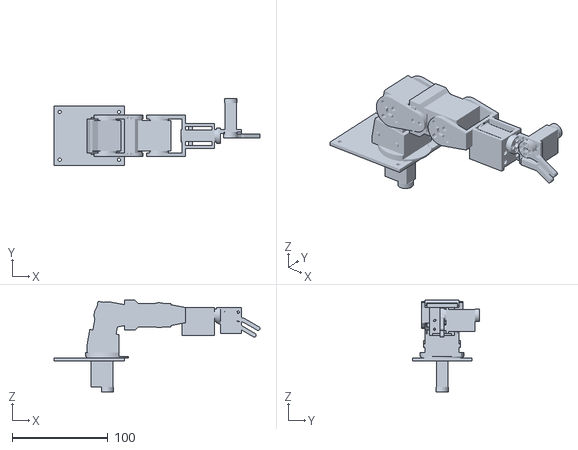
[picture p140: CAD file, 2026-10-16]
модели/клешни/stl/_сборка_для_просмотра.stl
215.6 x 70.1 x 95.9
