iamharveststorm/harvey/модели/корпус/stl/07_camera_mount.stl

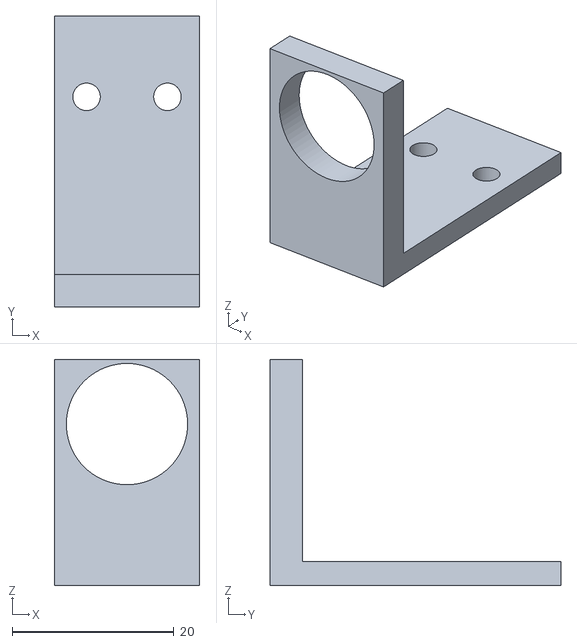
[picture p141: CAD file, 2026-10-16]
модели/корпус/stl/07_camera_mount.stl
18.0 x 36.0 x 28.0
