iamharveststorm/harvey/модели/мини/stl/leg_stand_PLA.stl

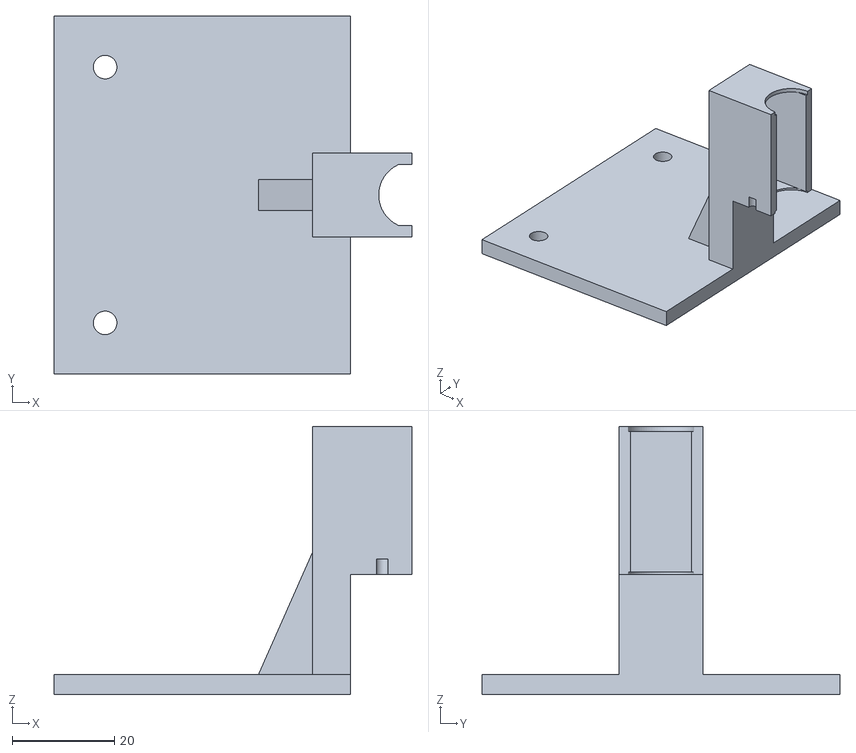
[picture p142: CAD file, 2026-10-16]
модели/мини/stl/leg_stand_PLA.stl
70.0 x 70.0 x 52.5
