iamharveststorm/harvey/модели/рендер/parts/tech/grey.stl

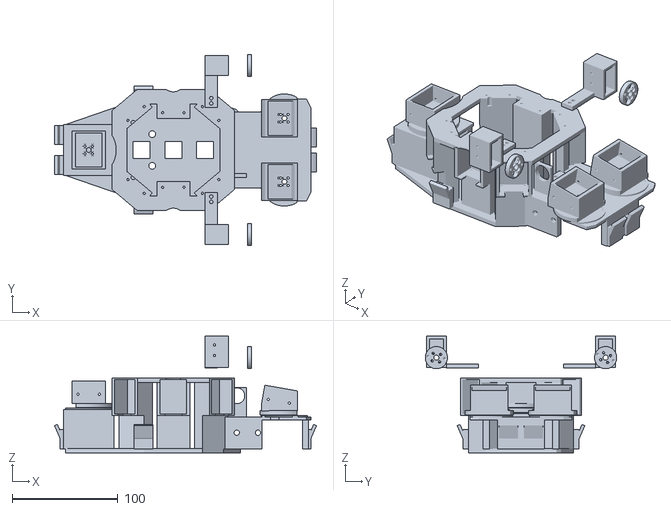
[picture p143: CAD file, 2026-10-16]
модели/рендер/parts/tech/grey.stl
247.7 x 181.0 x 110.3
