iamharveststorm/harvey/модели/рендер/parts_mini/tech/pcb.stl

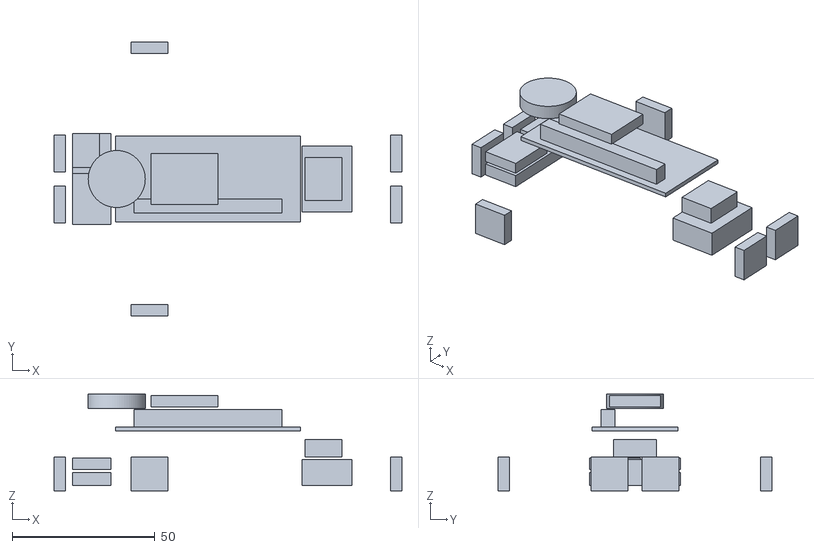
[picture p144: CAD file, 2026-10-16]
модели/рендер/parts_mini/tech/pcb.stl
122.0 x 96.0 x 34.0
