iamharveststorm/harvey/модели/стенд кисти/render_parts/servo21_case.stl

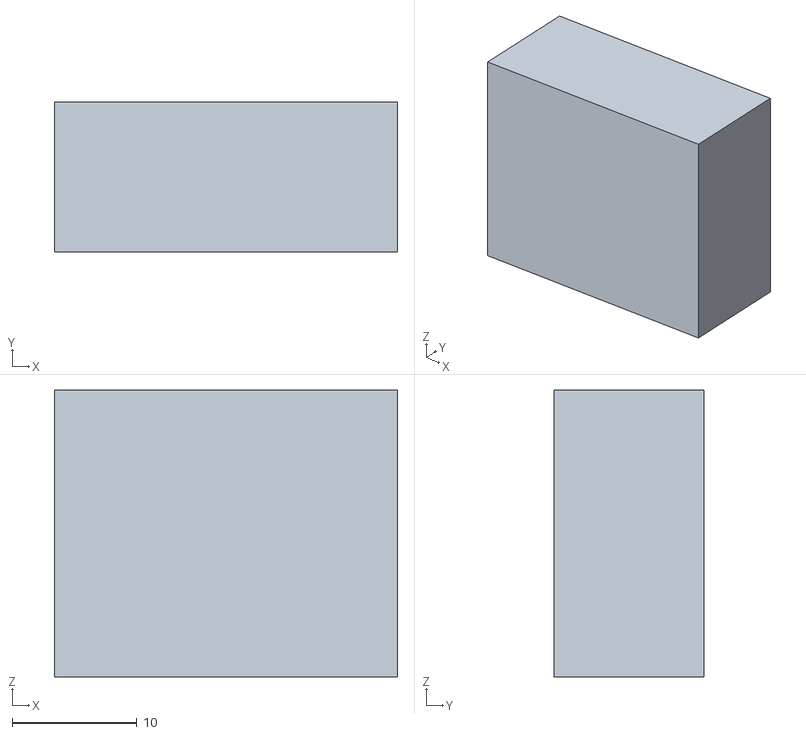
[picture p145: CAD file, 2026-10-16]
модели/стенд кисти/render_parts/servo21_case.stl
27.5 x 12.0 x 23.0
