iamharveststorm/harvey/модели/стенд кисти/stl/harvey_hand_grip_lever_25mm.stl

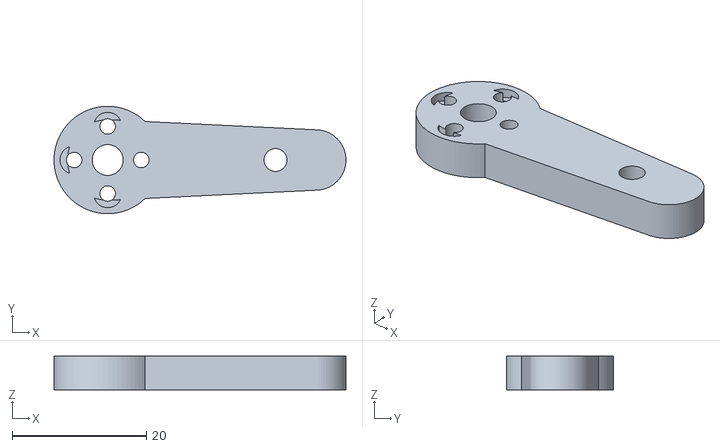
[picture p146: CAD file, 2026-10-16]
модели/стенд кисти/stl/harvey_hand_grip_lever_25mm.stl
43.5 x 16.0 x 5.00
