iamharveststorm/harvey/модели/стенд ноги/render_parts/metal.stl

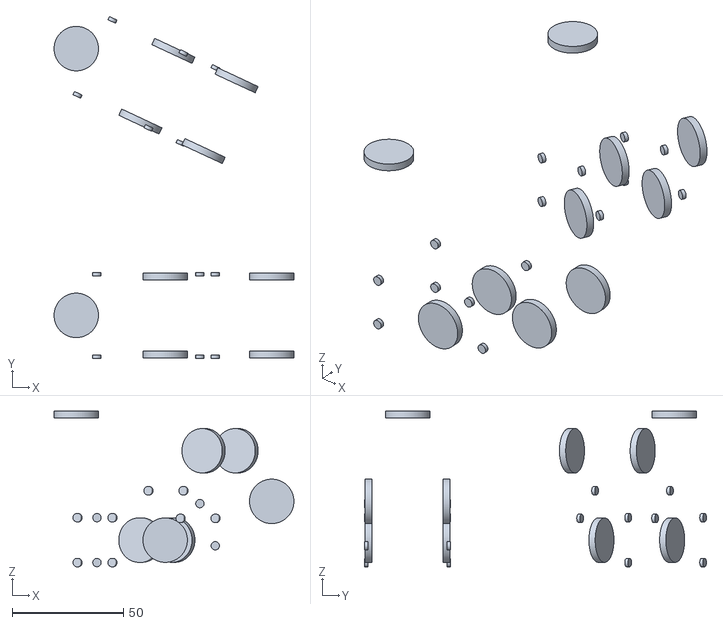
[picture p147: CAD file, 2026-10-16]
модели/стенд ноги/render_parts/metal.stl
107.9 x 153.9 x 70.0
