iamharveststorm/harvey/модели/стенд ноги/stl/harvey_cradle_servo.stl

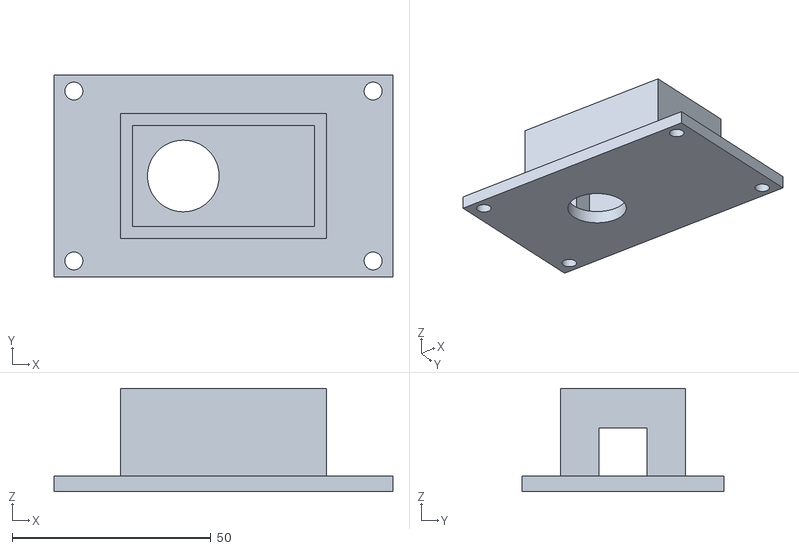
[picture p148: CAD file, 2026-10-16]
модели/стенд ноги/stl/harvey_cradle_servo.stl
85.2 x 50.7 x 26.0
