iamharveststorm/harvey/модели/хвост/stl/03_arm_plate_outer.stl

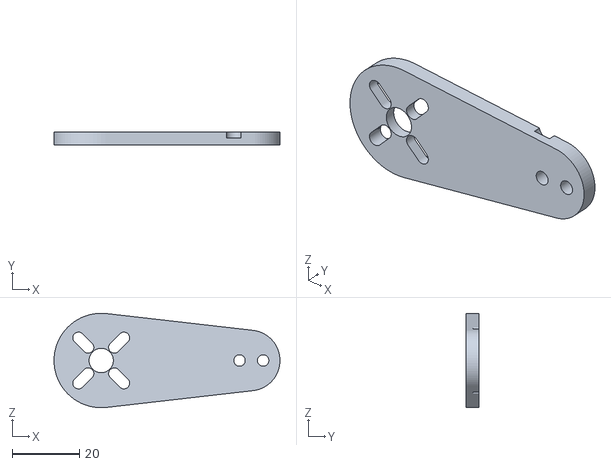
[picture p149: CAD file, 2026-10-16]
модели/хвост/stl/03_arm_plate_outer.stl
67.0 x 4.00 x 28.0
