iamharveststorm/harvey/код/симуляция/мини/assets/L_fore__orange.stl

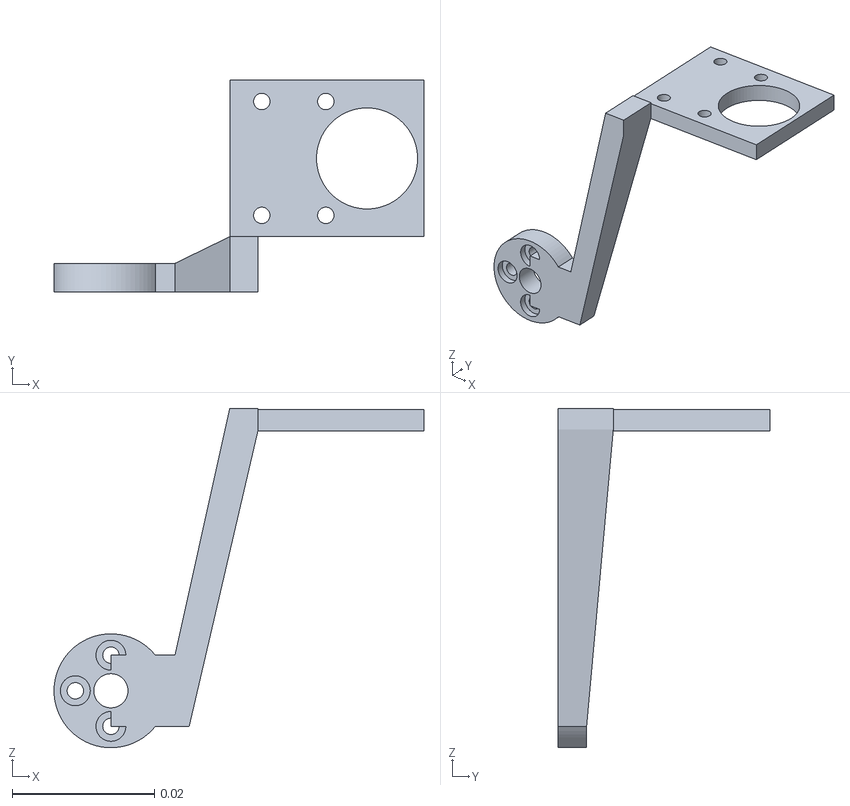
[picture p150: CAD file, 2026-10-16]
код/симуляция/мини/assets/L_fore__orange.stl
0.052 x 0.0297 x 0.0477
