iamharveststorm/harvey/код/симуляция/управление с клавиатуры/assets/robot/T_cup__cup.stl

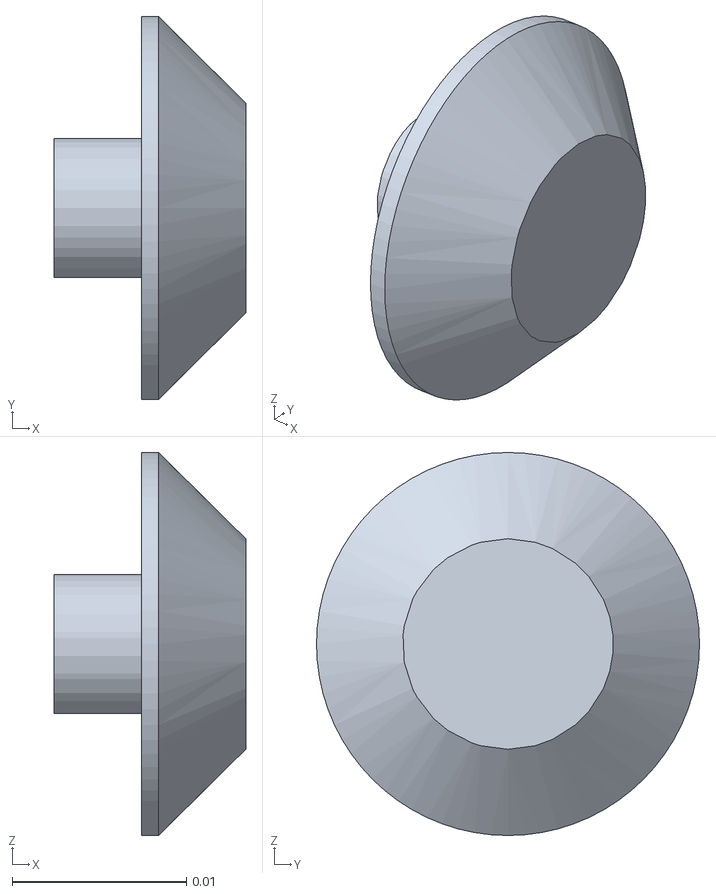
[picture p151: CAD file, 2026-10-16]
код/симуляция/управление с клавиатуры/assets/robot/T_cup__cup.stl
0.011 x 0.022 x 0.022
