iamharveststorm/harvey/модели/мини/stl/coxa_bracket_x6_PLA.stl

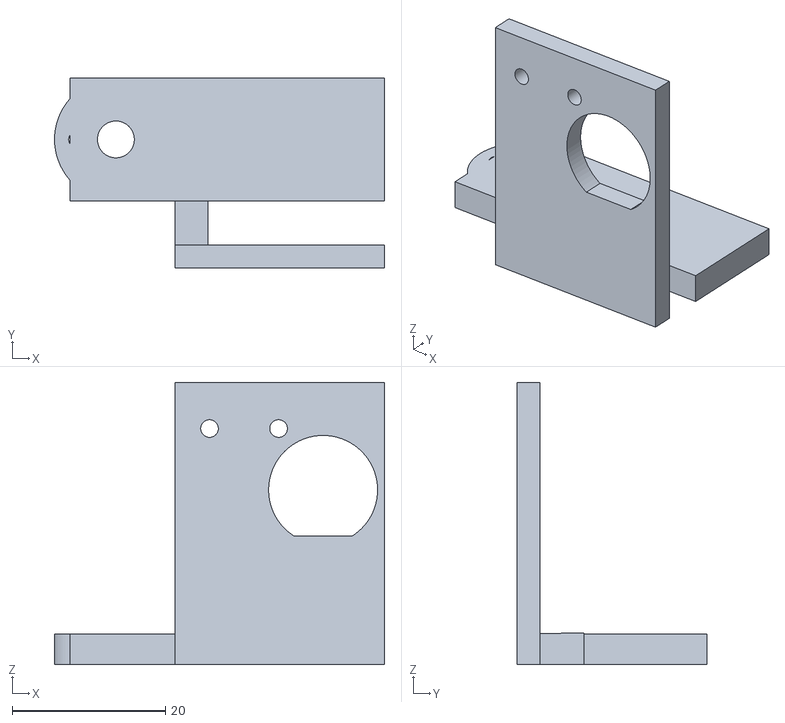
[picture p152: CAD file, 2026-10-16]
модели/мини/stl/coxa_bracket_x6_PLA.stl
43.0 x 24.8 x 36.8
