iamharveststorm/harvey/модели/рендер/parts/soft/shell.stl

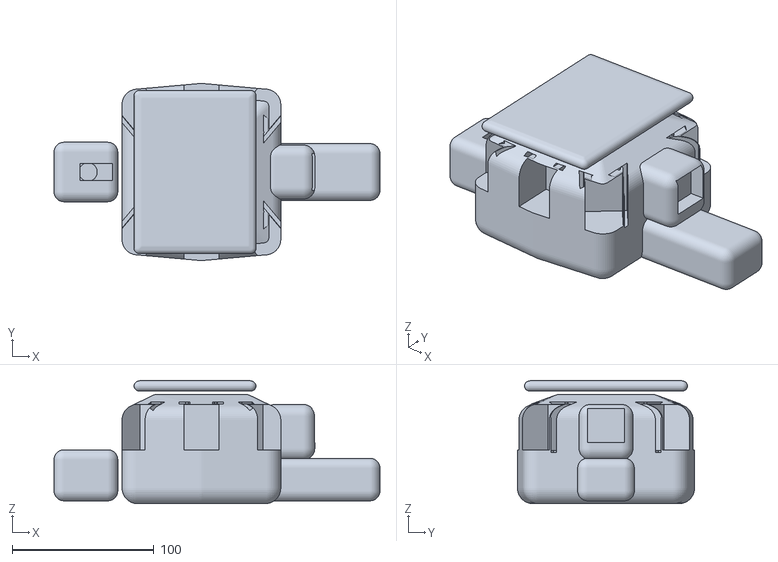
[picture p153: CAD file, 2026-10-16]
модели/рендер/parts/soft/shell.stl
230.0 x 125.0 x 87.0
