iamharveststorm/harvey/модели/рендер/parts/tech/red.stl

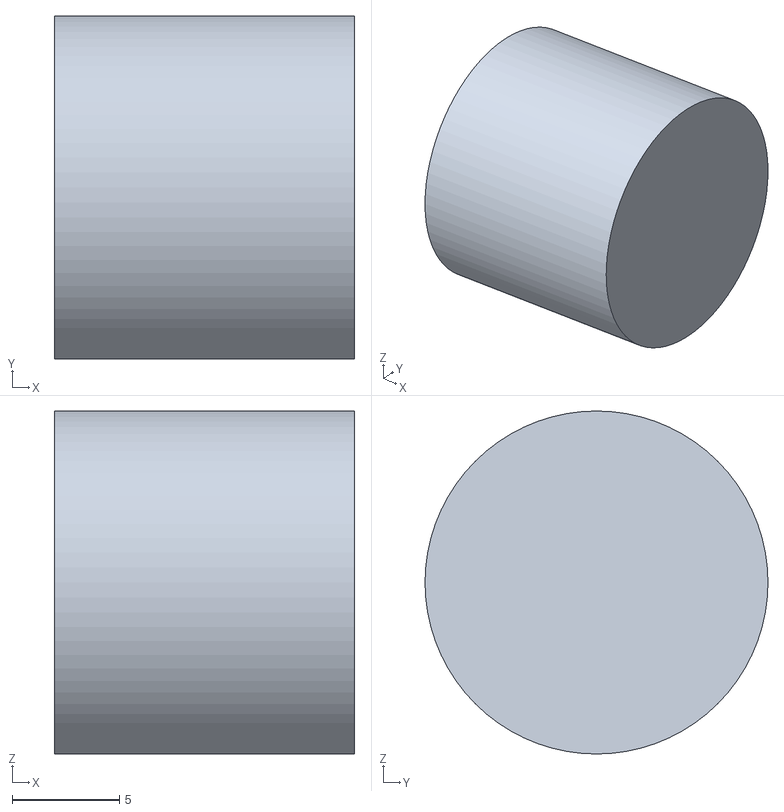
[picture p154: CAD file, 2026-10-16]
модели/рендер/parts/tech/red.stl
14.0 x 16.0 x 16.0
