iamharveststorm/harvey/модели/рендер/parts_mini/tech/dark.stl

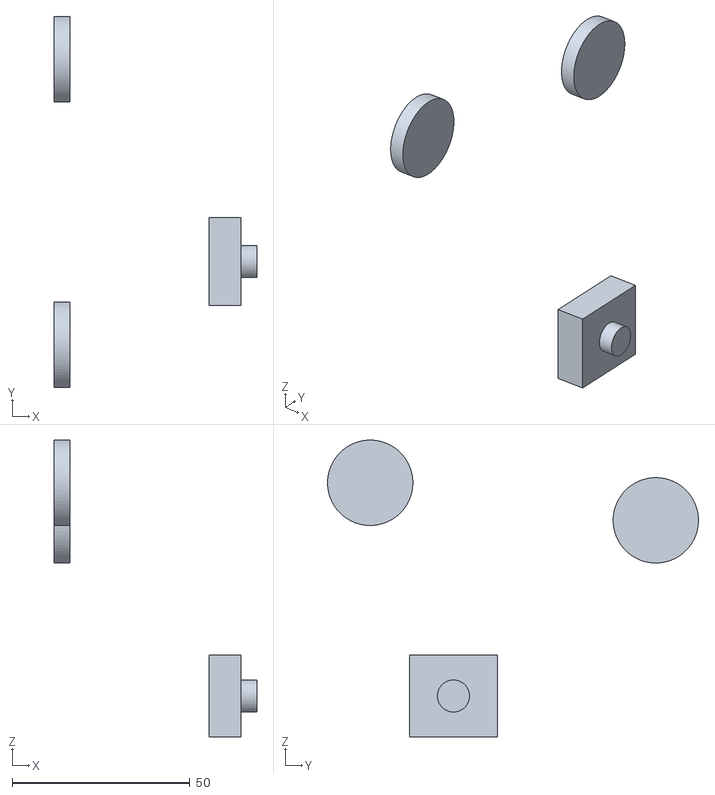
[picture p155: CAD file, 2026-10-16]
модели/рендер/parts_mini/tech/dark.stl
56.9 x 104.3 x 83.4
