iamharveststorm/harvey/модели/стенд кисти/render_parts/pad_up.stl

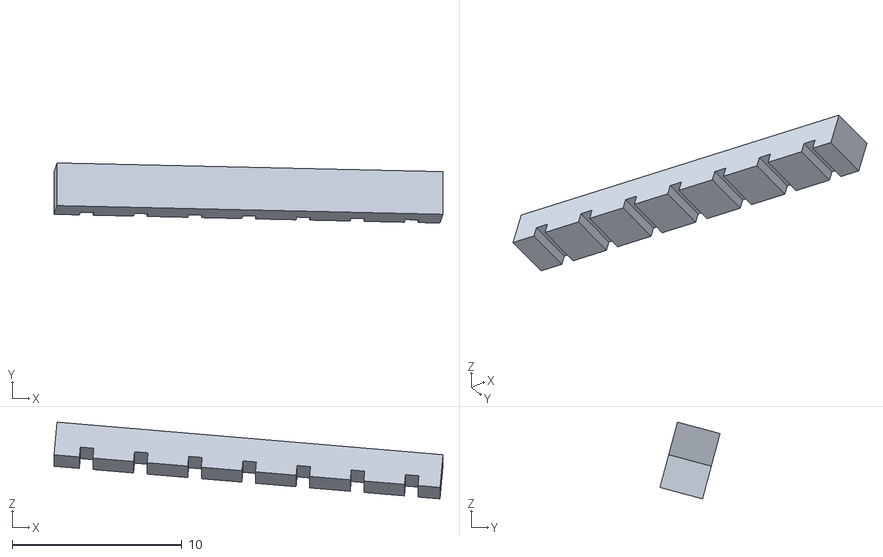
[picture p156: CAD file, 2026-10-16]
модели/стенд кисти/render_parts/pad_up.stl
22.9 x 3.54 x 4.52
