iamharveststorm/harvey/код/симуляция/мини/assets/L_ay__grey.stl

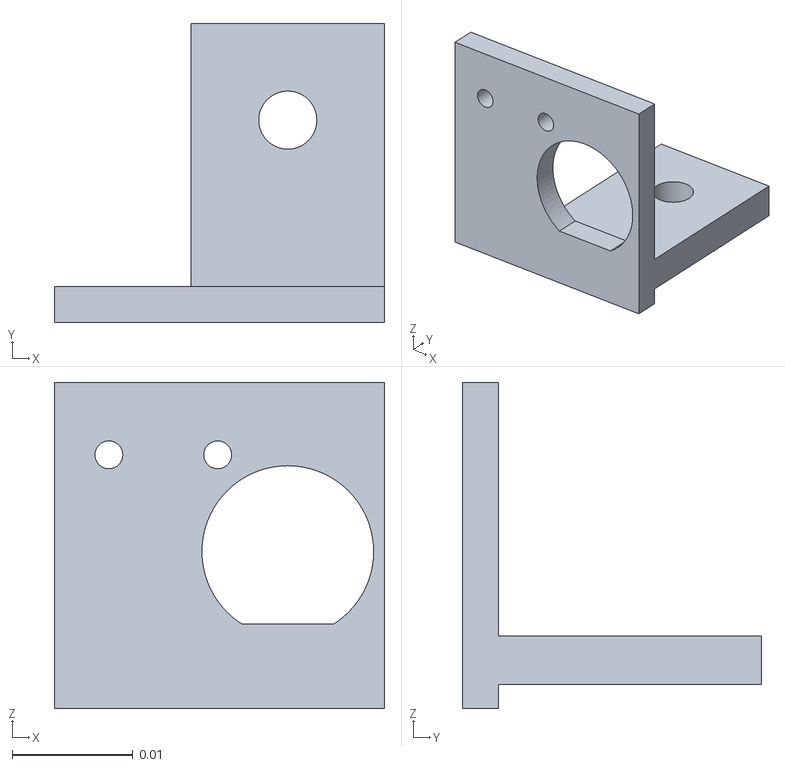
[picture p157: CAD file, 2026-10-16]
код/симуляция/мини/assets/L_ay__grey.stl
0.0273 x 0.0248 x 0.027
