iamharveststorm/harvey/код/симуляция/управление с клавиатуры/assets/robot/L_ay__servo.stl

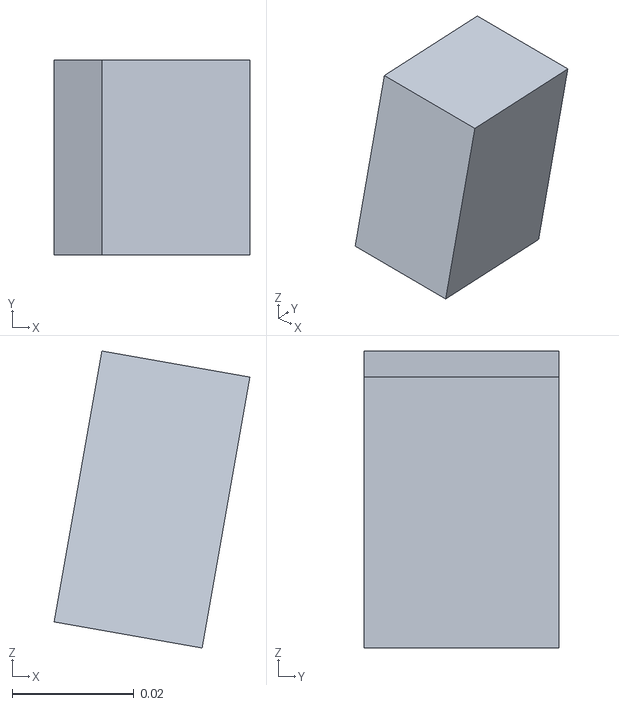
[picture p158: CAD file, 2026-10-16]
код/симуляция/управление с клавиатуры/assets/robot/L_ay__servo.stl
0.0322 x 0.032 x 0.0488
