iamharveststorm/harvey/модели/корпус/stl/02_ring_frame.stl

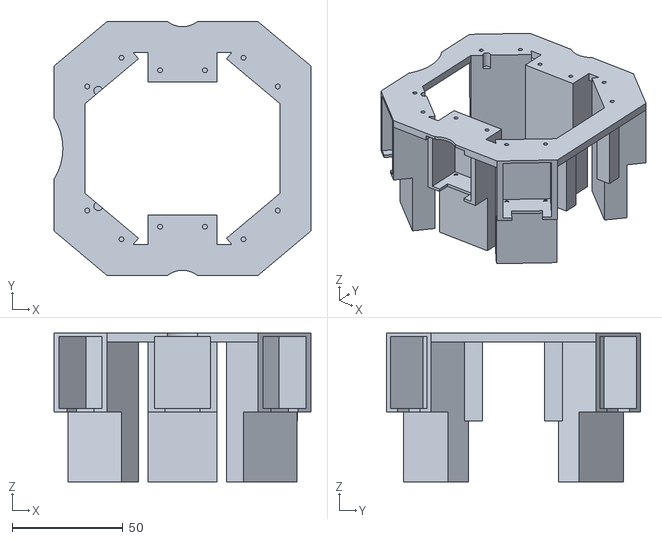
[picture p159: CAD file, 2026-10-16]
модели/корпус/stl/02_ring_frame.stl
116.0 x 114.7 x 67.2
