iamharveststorm/harvey/модели/мини/stl/femur_link_x6_PLA.stl

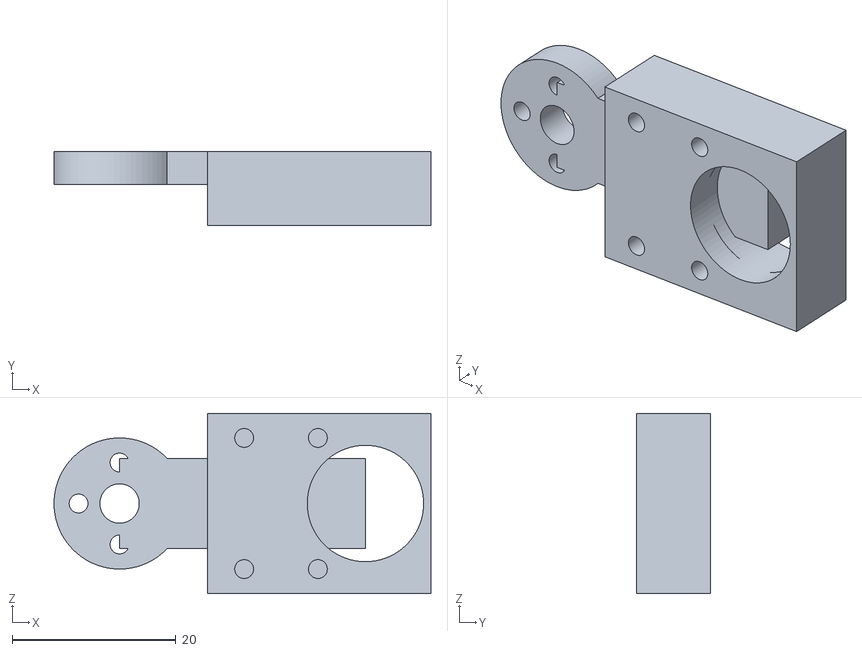
[picture p160: CAD file, 2026-10-16]
модели/мини/stl/femur_link_x6_PLA.stl
46.0 x 9.00 x 22.0
