iamharveststorm/harvey/модели/рендер/parts/tech/dark.stl

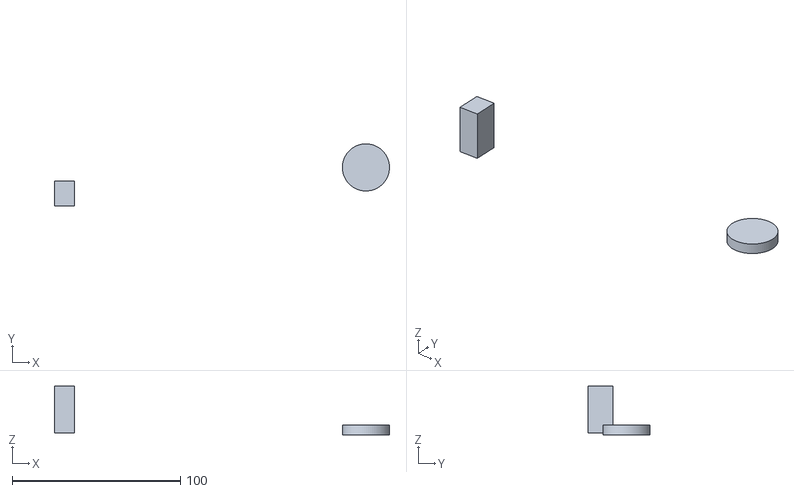
[picture p161: CAD file, 2026-10-16]
модели/рендер/parts/tech/dark.stl
199.0 x 37.0 x 29.0
