iamharveststorm/harvey/модели/стенд кисти/render_parts/pad_low.stl

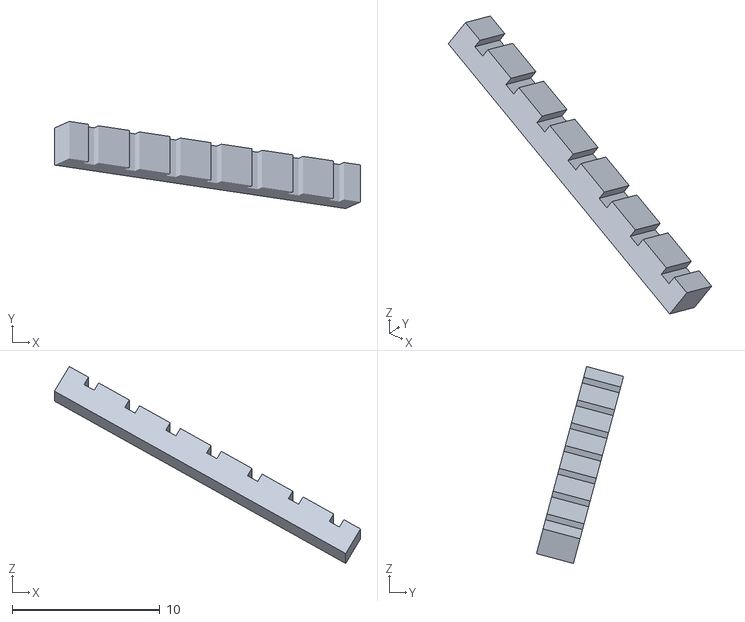
[picture p162: CAD file, 2026-10-16]
модели/стенд кисти/render_parts/pad_low.stl
20.7 x 5.91 x 13.4
