iamharveststorm/harvey/модели/стенд ноги/stl/harvey_foot_TPU.stl

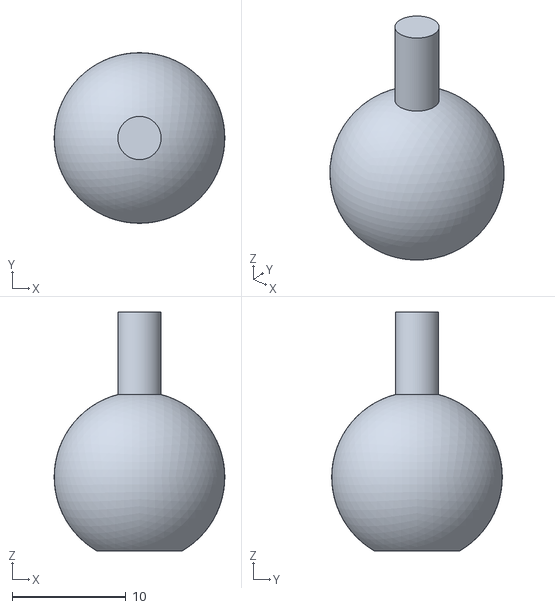
[picture p163: CAD file, 2026-10-16]
модели/стенд ноги/stl/harvey_foot_TPU.stl
15.0 x 15.0 x 21.0
