iamharveststorm/harvey/код/симуляция/мини/assets/R_jaw__tpu.stl

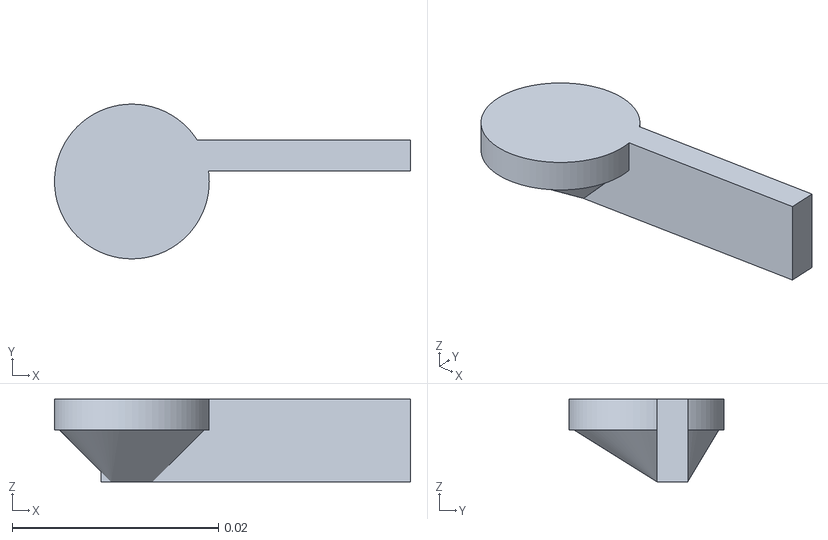
[picture p164: CAD file, 2026-10-16]
код/симуляция/мини/assets/R_jaw__tpu.stl
0.0345 x 0.015 x 0.008
