iamharveststorm/harvey/код/симуляция/управление с клавиатуры/assets/robot/torso__orange.stl

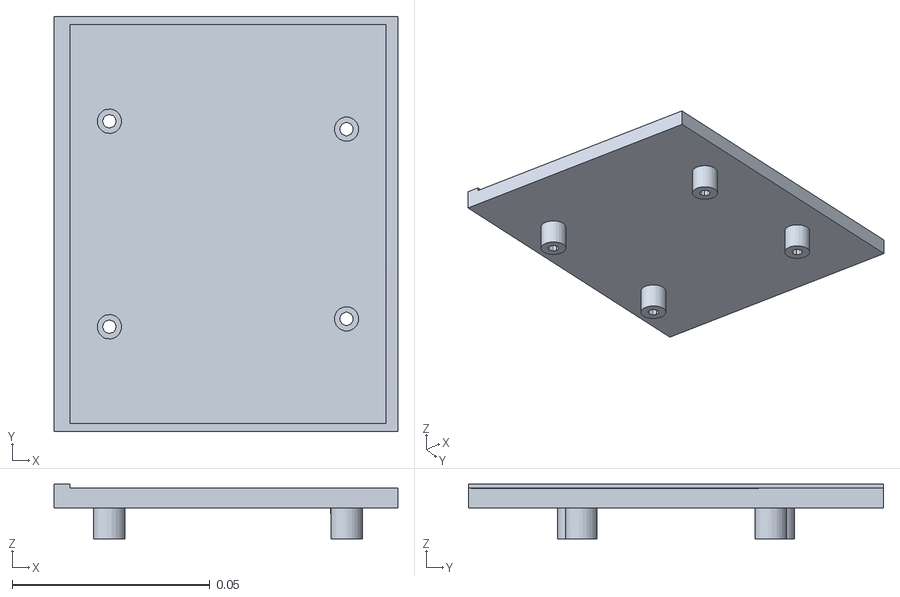
[picture p165: CAD file, 2026-10-16]
код/симуляция/управление с клавиатуры/assets/robot/torso__orange.stl
0.087 x 0.105 x 0.0138
