iamharveststorm/harvey/модели/клешни/stl/L_04_arm_plate_inner.stl

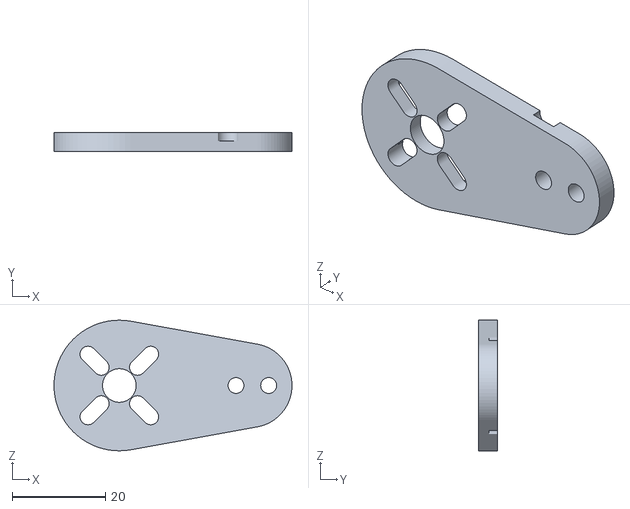
[picture p166: CAD file, 2026-10-16]
модели/клешни/stl/L_04_arm_plate_inner.stl
51.0 x 4.00 x 28.0
