iamharveststorm/harvey/модели/мини/stl/upper_arm_x2_PLA.stl

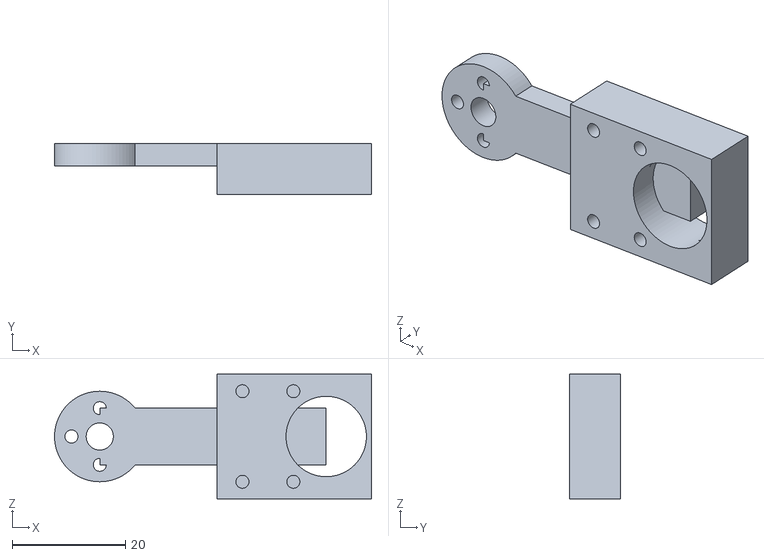
[picture p167: CAD file, 2026-10-16]
модели/мини/stl/upper_arm_x2_PLA.stl
56.0 x 9.00 x 22.0
