iamharveststorm/harvey/модели/стенд кисти/render_parts/servo22_horns.stl

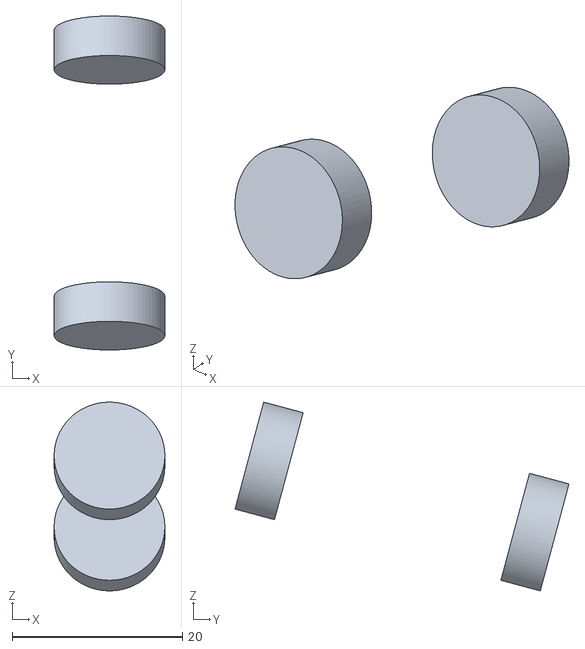
[picture p168: CAD file, 2026-10-16]
модели/стенд кисти/render_parts/servo22_horns.stl
13.0 x 39.2 x 22.2
