iamharveststorm/harvey/код/симуляция/мини/assets/L_eye__orange.stl

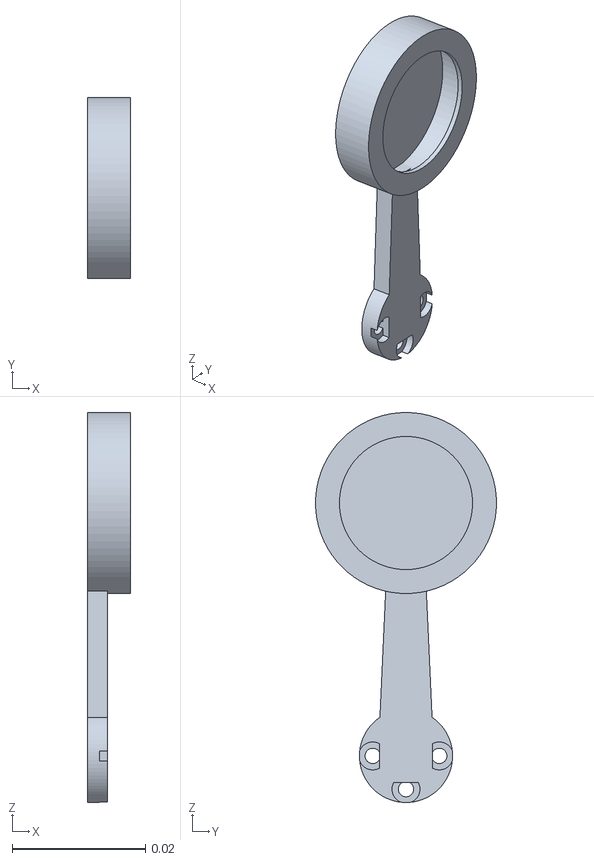
[picture p169: CAD file, 2026-10-16]
код/симуляция/мини/assets/L_eye__orange.stl
0.0065 x 0.0272 x 0.0586
