iamharveststorm/harvey/модели/клешни/stl/R_02_yaw_bracket.stl

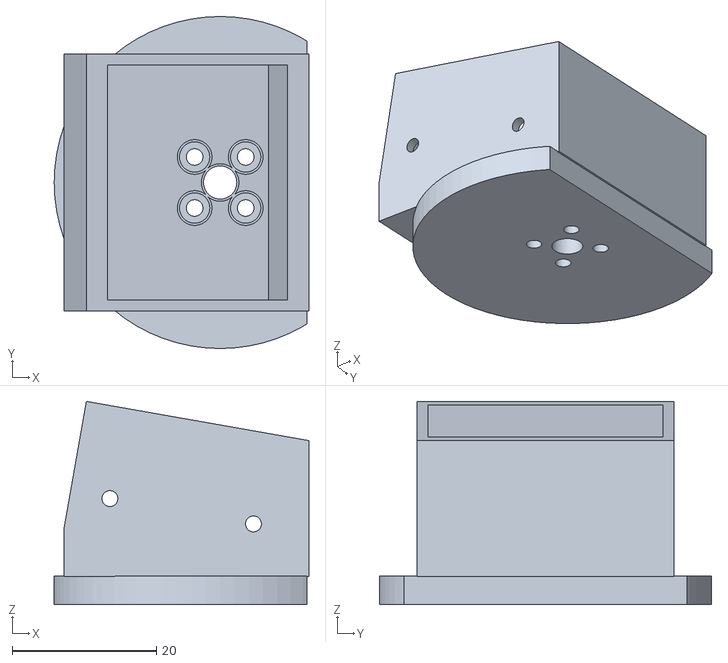
[picture p170: CAD file, 2026-10-16]
модели/клешни/stl/R_02_yaw_bracket.stl
35.3 x 46.0 x 28.2
