iamharveststorm/harvey/модели/корпус/stl/06_eye_mount_L.stl

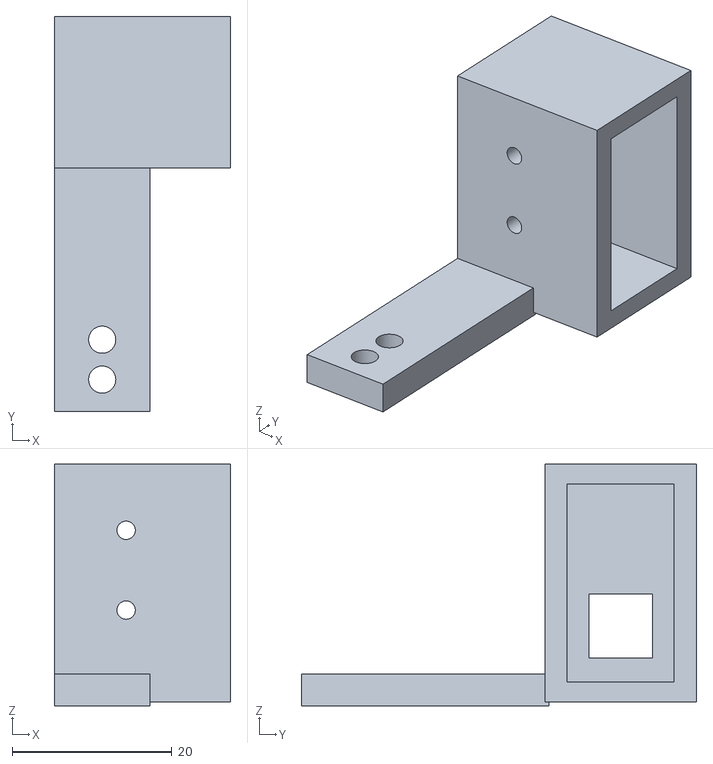
[picture p171: CAD file, 2026-10-16]
модели/корпус/stl/06_eye_mount_L.stl
22.1 x 49.5 x 30.3
