iamharveststorm/harvey/модели/мини/stl/moving_jaw_R_PLA.stl

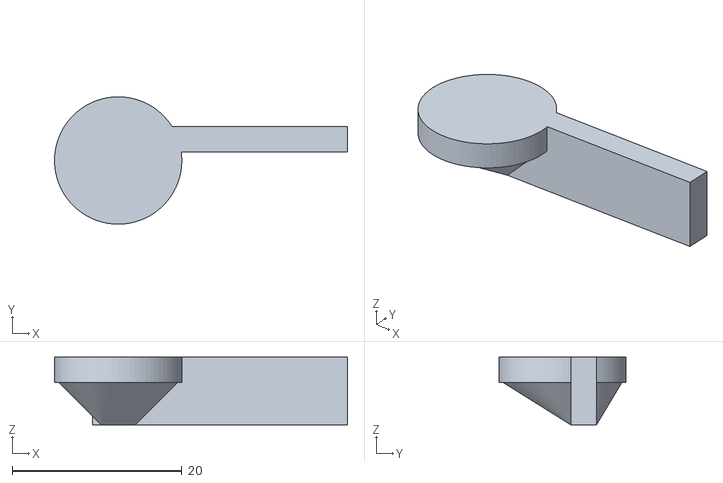
[picture p172: CAD file, 2026-10-16]
модели/мини/stl/moving_jaw_R_PLA.stl
34.5 x 15.0 x 8.00
