iamharveststorm/harvey/код/симуляция/управление с клавиатуры/assets/robot/R_eye__grey.stl

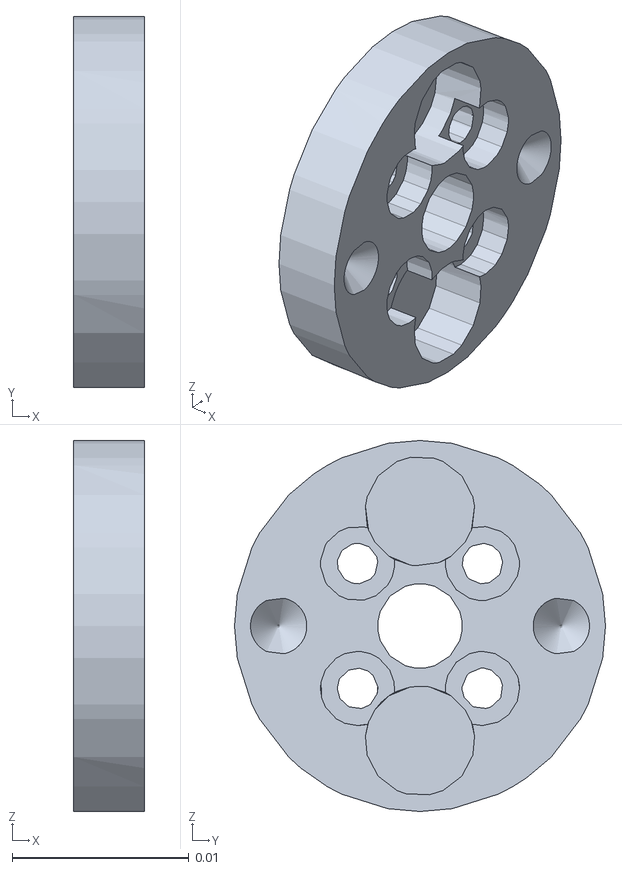
[picture p173: CAD file, 2026-10-16]
код/симуляция/управление с клавиатуры/assets/robot/R_eye__grey.stl
0.004 x 0.021 x 0.021
