iamharveststorm/harvey/модели/клешни/stl/R_06_forearm.stl

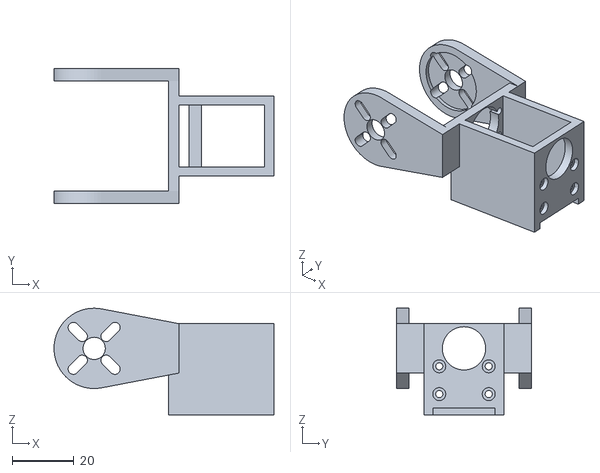
[picture p174: CAD file, 2026-10-16]
модели/клешни/stl/R_06_forearm.stl
71.2 x 43.6 x 34.5
