iamharveststorm/harvey/модели/корпус/stl/05_tray.stl

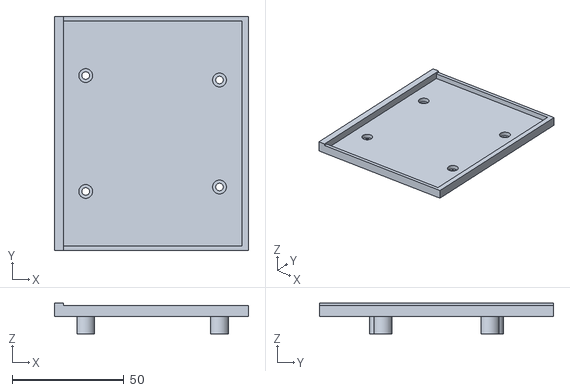
[picture p175: CAD file, 2026-10-16]
модели/корпус/stl/05_tray.stl
87.0 x 105.0 x 13.8
