iamharveststorm/harvey/модели/мини/stl/forearm_x2_PLA.stl

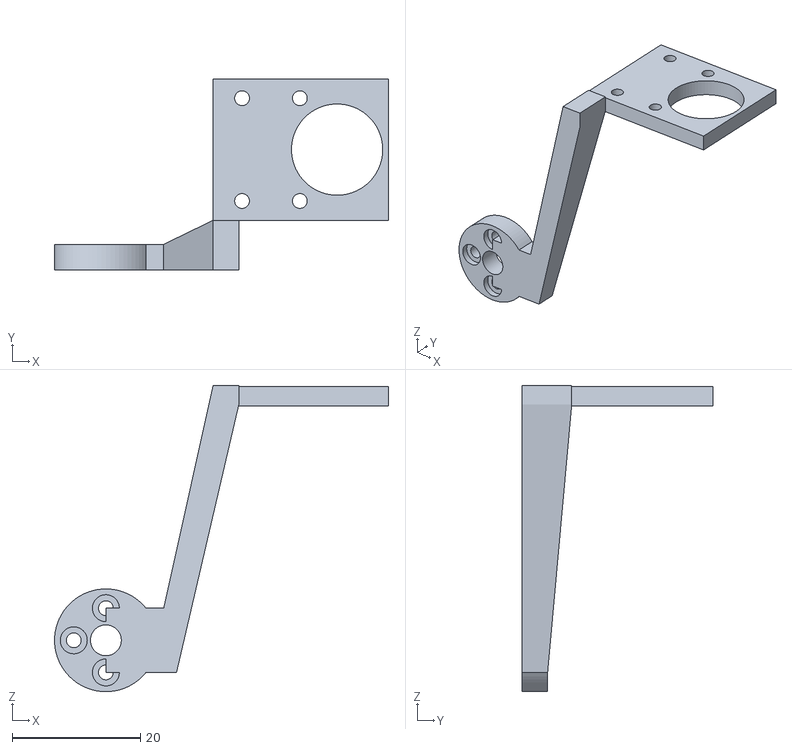
[picture p176: CAD file, 2026-10-16]
модели/мини/stl/forearm_x2_PLA.stl
52.0 x 29.8 x 47.7
