iamharveststorm/harvey/код/симуляция/мини/assets/leg_tibia__orange.stl

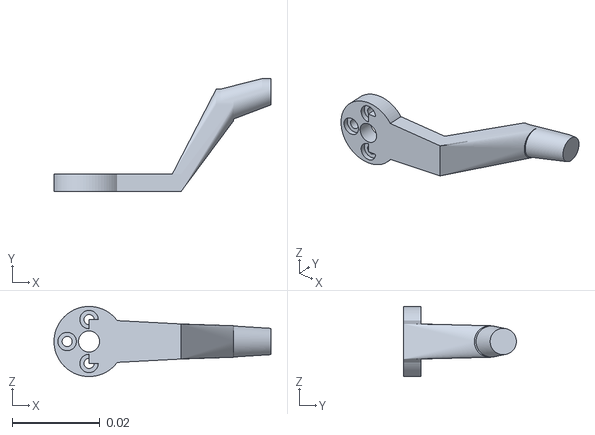
[picture p177: CAD file, 2026-10-16]
код/симуляция/мини/assets/leg_tibia__orange.stl
0.0495 x 0.0257 x 0.016
