iamharveststorm/harvey/модели/мини/stl/dock_pad_PLA.stl

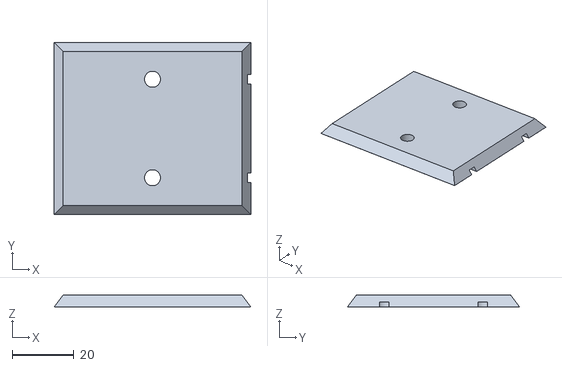
[picture p178: CAD file, 2026-10-16]
модели/мини/stl/dock_pad_PLA.stl
64.0 x 56.0 x 4.00
