iamharveststorm/harvey/код/симуляция/мини/assets/leg_coxa__orange.stl

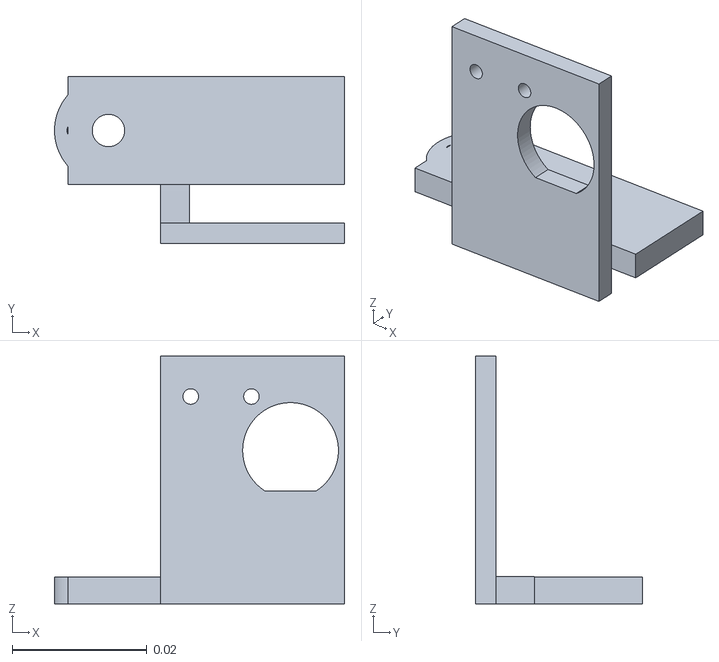
[picture p179: CAD file, 2026-10-16]
код/симуляция/мини/assets/leg_coxa__orange.stl
0.043 x 0.0248 x 0.0367
