iamharveststorm/harvey/код/симуляция/управление с клавиатуры/assets/robot/L_hand__orange.stl

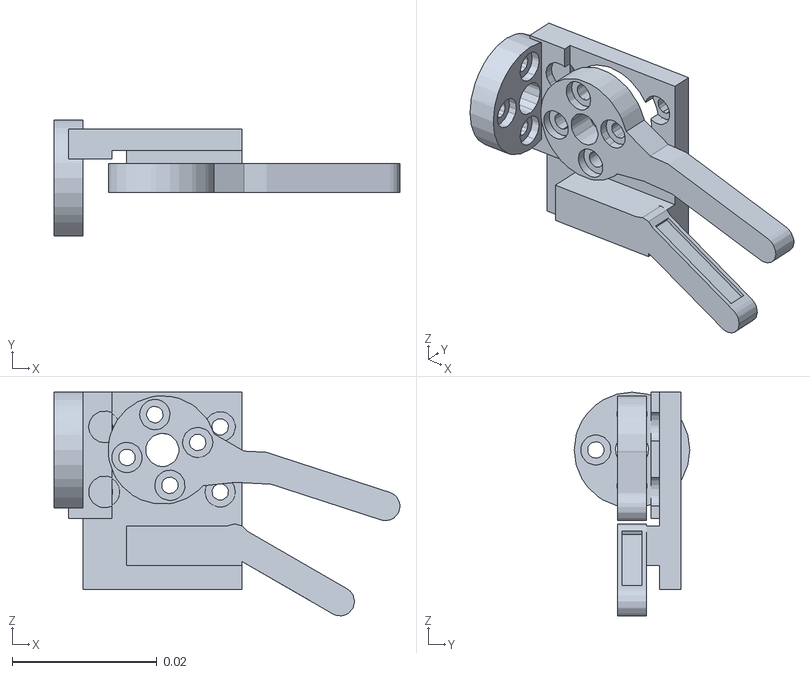
[picture p180: CAD file, 2026-10-16]
код/симуляция/управление с клавиатуры/assets/robot/L_hand__orange.stl
0.0479 x 0.016 x 0.031
