iamharveststorm/harvey/модели/мини/stl/eye_stalk_R_PLA.stl

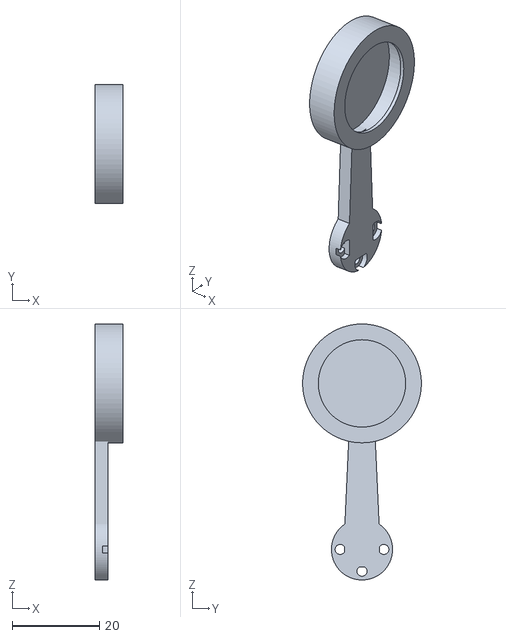
[picture p181: CAD file, 2026-10-16]
модели/мини/stl/eye_stalk_R_PLA.stl
6.50 x 27.2 x 58.6
