iamharveststorm/harvey/код/симуляция/мини/assets/R_hand__servo.stl

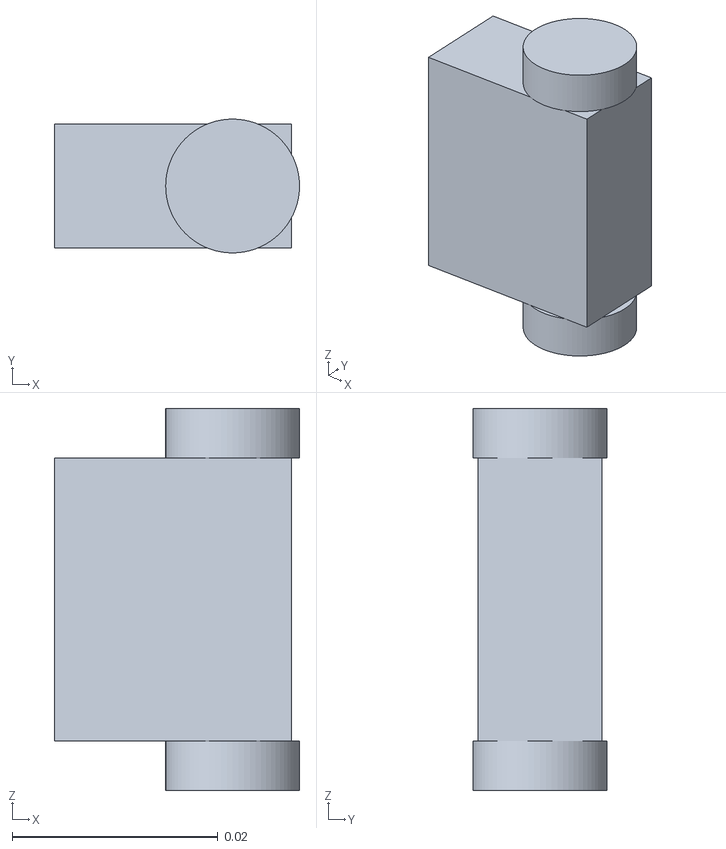
[picture p182: CAD file, 2026-10-16]
код/симуляция/мини/assets/R_hand__servo.stl
0.0238 x 0.013 x 0.0371
