iamharveststorm/harvey/код/симуляция/управление с клавиатуры/assets/robot/R_ay__metal.stl

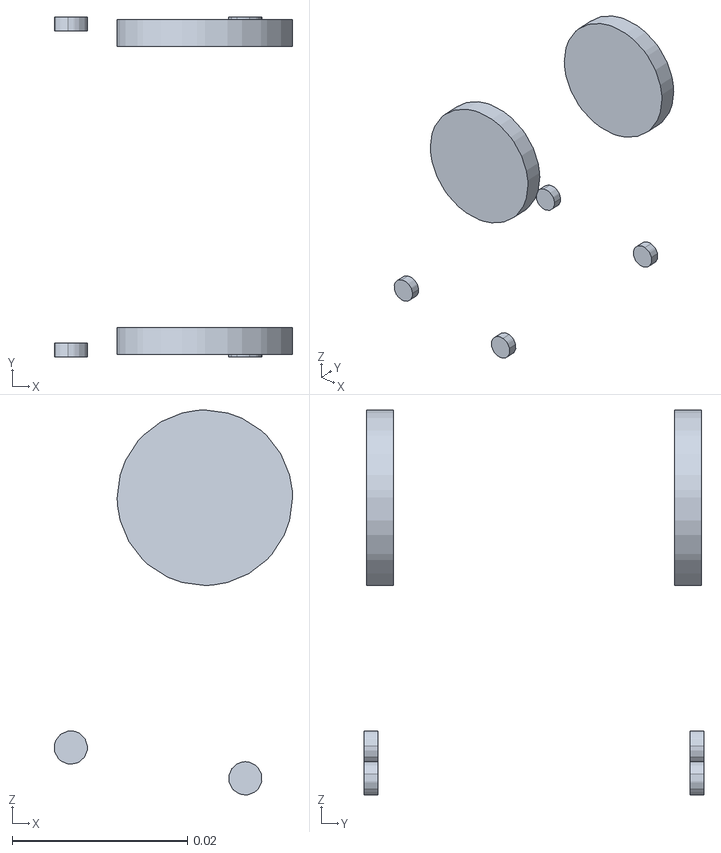
[picture p183: CAD file, 2026-10-16]
код/симуляция/управление с клавиатуры/assets/robot/R_ay__metal.stl
0.0271 x 0.0388 x 0.0439
