iamharveststorm/harvey/модели/мини/stl/foot_x6_TPU.stl

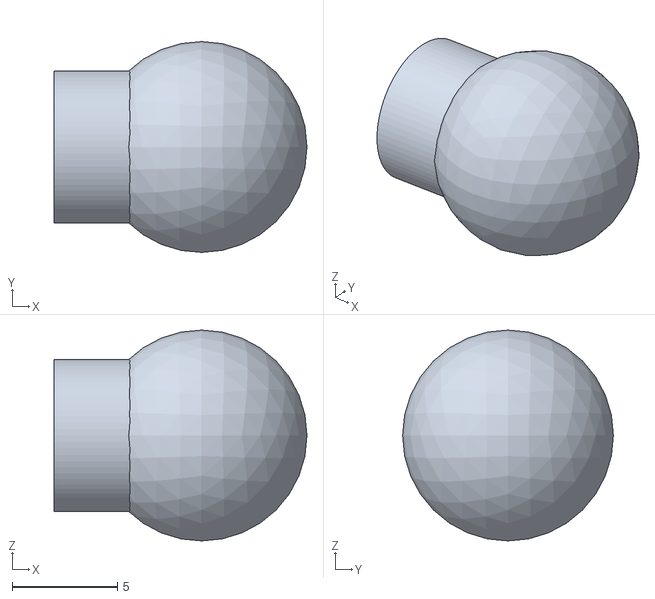
[picture p184: CAD file, 2026-10-16]
модели/мини/stl/foot_x6_TPU.stl
12.0 x 10.0 x 10.0
