iamharveststorm/harvey/(list of files, cad)

Other CAD files:
модели/чертежи/Харви_чертежи.FCStd
модели/глаза/stl/R_03_housing.stl
модели/стенд ноги/render_parts/stand.stl
модели/хвост/stl/05_elbow_sleeve.stl
модели/глаза/stl/L_01_horn_adapter.stl
модели/корпус/stl/08_edge_sensor_1.stl
модели/глаза/stl/L_04_bumper_TPU.stl
модели/корпус/stl/08_edge_sensor_3.stl
модели/стенд ноги/stl/harvey_lever_100mm.stl
модели/хвост/stl/04_arm_plate_inner.stl
модели/глаза/stl/L_02_stalk_with_cover.stl
модели/клешни/stl/L_09_pad_TPU.stl
модели/корпус/stl/08_edge_sensor_5.stl
код/симуляция/управление с клавиатуры/assets/robot/leg_femur__metal.stl
код/симуляция/мини/assets/L_jaw__tpu.stl
код/симуляция/управление с клавиатуры/assets/robot/R_up__metal.stl
модели/клешни/stl/R_04_arm_plate_inner.stl
модели/корпус/stl/06_eye_mount_R.stl
модели/клешни/stl/R_03_arm_plate_outer.stl
модели/корпус/stl/08_edge_sensor_6.stl
модели/клешни/stl/L_05_elbow_sleeve.stl
модели/корпус/stl/08_edge_sensor_2.stl
код/симуляция/мини/assets/L_ay__servo.stl
код/симуляция/мини/assets/L_eye__screen.stl
код/симуляция/мини/assets/L_hand__servo.stl
код/симуляция/мини/assets/L_hand__tpu.stl
код/симуляция/мини/assets/L_up__orange.stl
код/симуляция/мини/assets/L_up__servo.stl
код/симуляция/мини/assets/R_ay__grey.stl
код/симуляция/мини/assets/R_ay__servo.stl
код/симуляция/мини/assets/R_eye__orange.stl
код/симуляция/мини/assets/R_fore__orange.stl
код/симуляция/мини/assets/R_hand__tpu.stl
код/симуляция/мини/assets/R_up__orange.stl
код/симуляция/мини/assets/R_up__servo.stl
код/симуляция/мини/assets/dock_pad.stl
код/симуляция/мини/assets/leg_coxa__servo.stl
код/симуляция/мини/assets/leg_femur__servo.stl
код/симуляция/мини/assets/leg_tibia__tpu.stl
код/симуляция/мини/assets/torso__battery.stl
код/симуляция/мини/assets/torso__servo.stl
код/симуляция/управление с клавиатуры/assets/robot/L_ay__grey.stl
код/симуляция/управление с клавиатуры/assets/robot/L_ay__metal.stl
код/симуляция/управление с клавиатуры/assets/robot/L_eye__grey.stl
код/симуляция/управление с клавиатуры/assets/robot/L_eye__orange.stl
код/симуляция/управление с клавиатуры/assets/robot/L_eye__tpu.stl
код/симуляция/управление с клавиатуры/assets/robot/L_fore__metal.stl
код/симуляция/управление с клавиатуры/assets/robot/L_fore__servo.stl
код/симуляция/управление с клавиатуры/assets/robot/L_hand__metal.stl
код/симуляция/управление с клавиатуры/assets/robot/L_hand__servo.stl
код/симуляция/управление с клавиатуры/assets/robot/L_hand__tpu.stl
код/симуляция/управление с клавиатуры/assets/robot/L_up__metal.stl
код/симуляция/управление с клавиатуры/assets/robot/L_up__orange.stl
код/симуляция/управление с клавиатуры/assets/robot/L_up__servo.stl
код/симуляция/управление с клавиатуры/assets/robot/R_ay__servo.stl
код/симуляция/управление с клавиатуры/assets/robot/R_eye__orange.stl
код/симуляция/управление с клавиатуры/assets/robot/R_eye__tpu.stl
код/симуляция/управление с клавиатуры/assets/robot/R_fore__metal.stl
код/симуляция/управление с клавиатуры/assets/robot/R_fore__orange.stl
код/симуляция/управление с клавиатуры/assets/robot/R_hand__metal.stl
код/симуляция/управление с клавиатуры/assets/robot/R_hand__orange.stl
код/симуляция/управление с клавиатуры/assets/robot/R_hand__servo.stl
код/симуляция/управление с клавиатуры/assets/robot/R_hand__tpu.stl
код/симуляция/управление с клавиатуры/assets/robot/R_up__orange.stl
код/симуляция/управление с клавиатуры/assets/robot/R_up__servo.stl
код/симуляция/управление с клавиатуры/assets/robot/T_base__grey.stl
код/симуляция/управление с клавиатуры/assets/robot/T_base__metal.stl
код/симуляция/управление с клавиатуры/assets/robot/T_base__servo.stl
код/симуляция/управление с клавиатуры/assets/robot/T_fore__metal.stl
код/симуляция/управление с клавиатуры/assets/robot/T_fore__orange.stl
код/симуляция/управление с клавиатуры/assets/robot/T_fore__servo.stl
код/симуляция/управление с клавиатуры/assets/robot/T_up__orange.stl
код/симуляция/управление с клавиатуры/assets/robot/T_up__servo.stl
код/симуляция/управление с клавиатуры/assets/robot/T_wr__orange.stl
код/симуляция/управление с клавиатуры/assets/robot/leg_coxa__metal.stl
код/симуляция/управление с клавиатуры/assets/robot/leg_coxa__servo.stl
код/симуляция/управление с клавиатуры/assets/robot/leg_femur__servo.stl
код/симуляция/управление с клавиатуры/assets/robot/leg_tibia__orange.stl
код/симуляция/управление с клавиатуры/assets/robot/leg_tibia__tpu.stl
код/симуляция/управление с клавиатуры/assets/robot/torso__battery.stl
код/симуляция/управление с клавиатуры/assets/robot/torso__grey.stl
код/симуляция/управление с клавиатуры/assets/robot/torso__metal.stl
код/симуляция/управление с клавиатуры/assets/robot/torso__pcb.stl
код/симуляция/управление с клавиатуры/assets/robot/torso__red.stl
код/симуляция/управление с клавиатуры/assets/robot/torso__servo.stl
модели/клешни/stl/L_01_base.stl
модели/клешни/stl/L_02_yaw_bracket.stl
модели/клешни/stl/L_03_arm_plate_outer.stl
модели/клешни/stl/L_06_forearm.stl
модели/клешни/stl/R_07_hand.stl
модели/клешни/stl/R_08_jaw.stl
модели/мини/stl/eye_stalk_x2_PLA.stl
модели/мини/stl/fixed_jaw_R_PLA.stl
модели/мини/stl/fixed_jaw_x2_PLA.stl
модели/мини/stl/moving_jaw_x2_PLA.stl
модели/мини/stl/tibia_x6_PLA.stl
модели/мини/stl/yaw_bracket_x2_PLA.stl
