iamharveststorm/harvey/код/симуляция/управление с клавиатуры/sim_results.txt

REACH: кончик достаёт до стола на 194 мм от центра корпуса (119 мм перед панцирем); полный вылет 157 мм
HOLD 0,2 кг на вытянутой клешне: τ подъём=0.45 локоть=0.27 поворот=0.003 Н·м; запас устойчивости=72 мм
SQUARE 20 мм: ошибка слежения средняя=0.35 мм, макс=0.73 мм (без люфта)
PHONE 200 г двумя клешнями на спину: τ пик подъём=1.95 локоть=2.94 поворот=0.038 запястье=0.440; стебельки=0.003 Н·м; мин. запас устойчивости=73 мм; касаний предмет↔корпус/глаза=0; клешня↔глаза=0; лёг на спину=True; удержался при ходьбе=True; положение=[-21.  -0. 108.]; шаги с касанием=[]
PEN 15 г одной клешнёй на спину: τ пик подъём=2.94 локоть=2.94; мин. запас устойчивости=87 мм; касаний=0/0; лёг на спину=True; удержался при ходьбе=True; положение=[ 2.  0. 75.]
WALK comfort payload=0.5: v=12.9 см/с; τ пик c/f/k=0.55/1.51/2.18; выше номинала f/k=3.6/10.4%; запас=21 мм; мощность=146 Вт
WALK fast payload=0.5: v=17.2 см/с; τ пик c/f/k=0.71/1.84/1.98; выше номинала f/k=9.1/14.5%; запас=21 мм; мощность=169 Вт
MASS: 2.596 кг
