iamharveststorm/harvey/код/голова/tests/golden/alarm_left.png

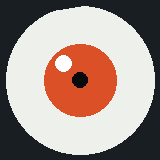
код/голова/tests/golden/alarm_left.png
