iamharveststorm/harvey/код/голова/tests/golden/asleep_left.png

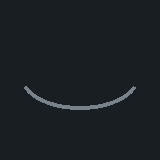
код/голова/tests/golden/asleep_left.png
