iamharveststorm/harvey/код/голова/tests/golden/half_tilt_left.png

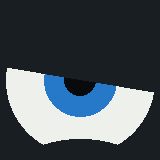
код/голова/tests/golden/half_tilt_left.png
