iamharveststorm/harvey/код/голова/tests/golden/happy_left.png

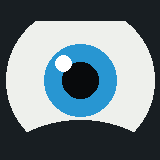
код/голова/tests/golden/happy_left.png
