iamharveststorm/harvey/код/голова/tests/golden/look_x_left.png

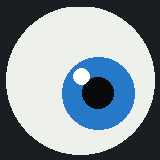
код/голова/tests/golden/look_x_left.png
