iamharveststorm/harvey/код/голова/tests/golden/look_x_right.png

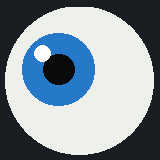
код/голова/tests/golden/look_x_right.png
