iamharveststorm/harvey/код/голова/tests/golden/sad_left.png

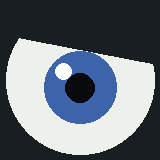
код/голова/tests/golden/sad_left.png
