iamharveststorm/harvey/код/голова/tests/golden/sad_right.png

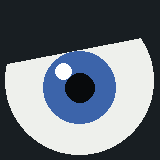
код/голова/tests/golden/sad_right.png
