iamharveststorm/harvey/код/голова/tests/golden/sleepy_left.png

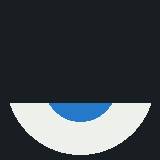
код/голова/tests/golden/sleepy_left.png
