iamharveststorm/harvey/код/голова/tests/golden/tired_left.png

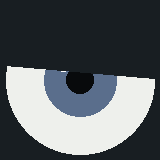
код/голова/tests/golden/tired_left.png
