iamharveststorm/harvey/модели/чертежи/ХАРВИ.01.001 Рычаг 100 мм.pdf

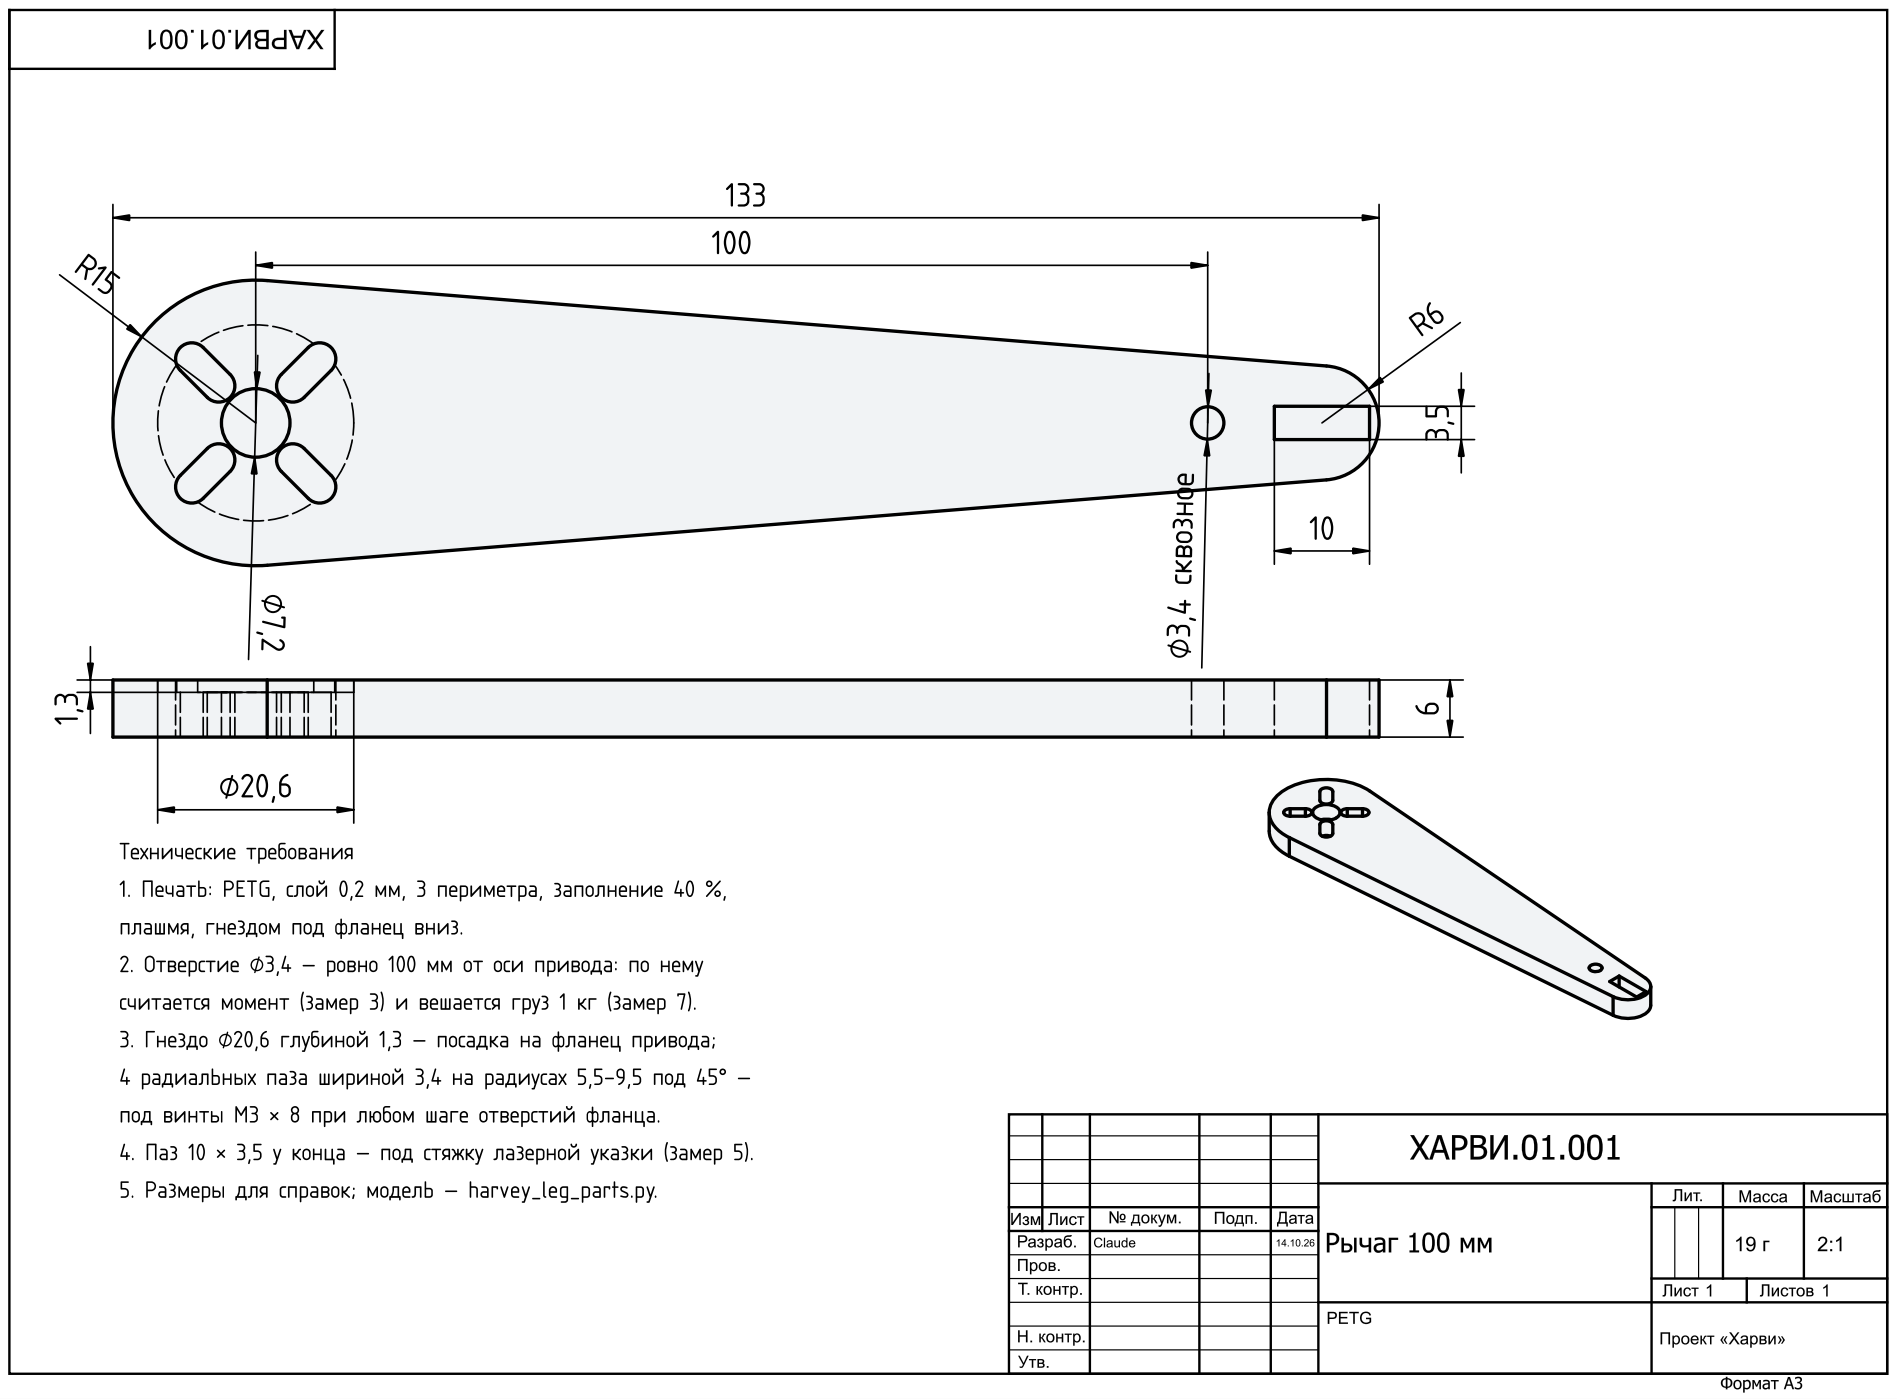
[picture p195: page 1]
