iamharveststorm/harvey/модели/чертежи/ХАРВИ.02.002 Ладонь кисти.pdf

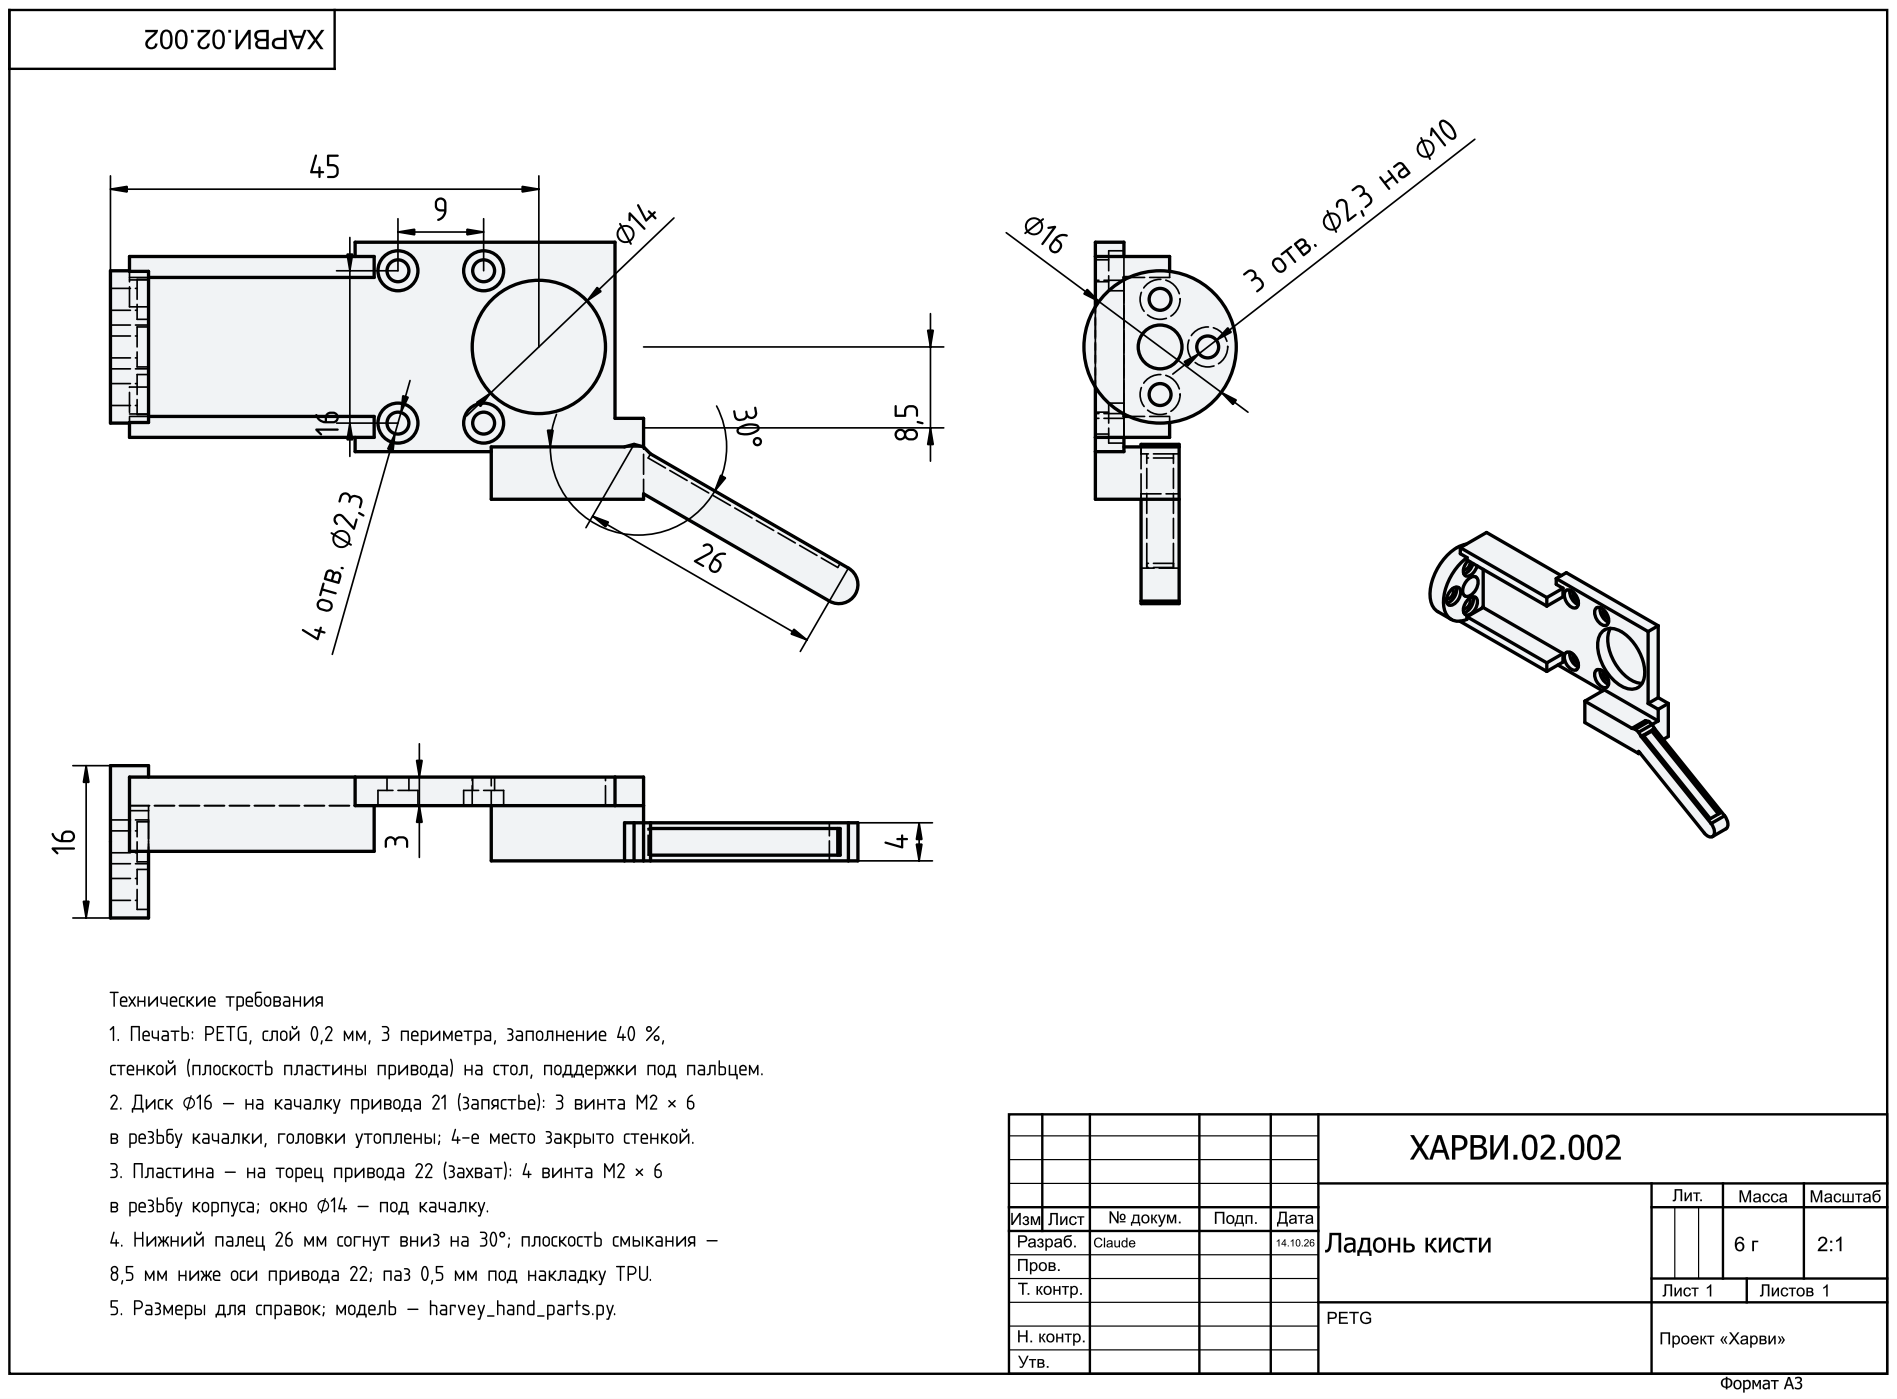
[picture p196: page 1]
