iamharveststorm/harvey/схемы/make_wiring.py

"""Харви «Компакт мини» — схемы проводки (WireViz) и интерфейса шины приводов (schemdraw).

Источник чисел — заметки/Компакт мини.md, заметки/Комплектация мини.md, заметки/Питание и проводка.md
и даташит STS3032-C036 (документы/). Запуск: make_schemes.bat или
    C:\\venvs\\harvey-schemes\\Scripts\\python.exe make_wiring.py
Пишет mini_power.yml / mini_bus.yml и рядом .svg, .png, .html и .bom.tsv (спецификация жгутов) + bus_buffer.svg/.png.
"""
import os
import subprocess
import sys

import yaml

HERE = os.path.dirname(os.path.abspath(__file__))
OPT = {"fontname": "Arial", "bgcolor": "WH", "bgcolor_node": "WH", "bgcolor_connector": "WH", "bgcolor_cable": "WH",
       "color_mode": "full", "mini_bom_mode": False}
SERVO = {"type": "STS3032-C036", "subtype": "6 В; упор 1,2 А, номинал 0,4 А", "pinlabels": ["GND", "+6 В", "DATA"]}
G3 = ["BK", "RD", "YE"]                       # GND, +6 В, DATA — как провода Feetech


# ------------------------------------------------------------------ лист 1: питание и логика
def power_sheet():
    c, w, x = {}, {}, []
    c["BAT"] = {"type": "Батарея 2S", "subtype": "2 × 18650 (Molicel P28A / Samsung 30Q), 7,4 В, ~22 Вт·ч",
                "pinlabels": ["B−", "BM (середина)", "B+"]}
    c["BMS"] = {"type": "BMS 2S, 10–15 А", "subtype": "с балансировкой", "pinlabels": ["B−", "BM", "B+", "P−", "P+"]}
    c["XT30"] = {"type": "XT30", "subtype": "батарея съёмная", "pinlabels": ["+", "−"]}
    c["PWR"] = {"type": "Плата питания", "subtype": "F1 10 А · INA226 (шунт 10 мОм) · «звезда» GND · 1000 мкФ",
                "pinlabels": ["BAT+ (до F1)", "BAT−", "CHG+ (после F1, до SW)", "CHG−", "→ SW", "SW →",
                              "V6 IN+ (после шунта)", "V6 IN−", "V5 IN+ (после шунта)", "V5 IN−",
                              "INA226 SDA", "INA226 SCL", "INA226 3V3", "INA226 GND"],
                "notes": "Заряд — до выключателя: робот заряжается и выключенным.<br/>Шунт INA226 в «+» после выключателя: видит весь ток робота."}
    c["SW"] = {"type": "Выключатель", "subtype": "≥ 10 А (мини-тумблеры на 3 А не годятся)", "pinlabels": ["1", "2"]}
    c["CHG"] = {"type": "Модуль заряда IP2326", "subtype": "вход 5 В → 2S, 15 Вт", "pinlabels": ["VIN+", "VIN−", "BAT+", "BAT−"]}
    c["PADS"] = {"type": "Пластины на брюхе", "subtype": "латунь 40 × 12 мм ← pogo станции 5 В 3 А", "pinlabels": ["+5 В", "GND"]}
    c["DC6"] = {"type": "DC-DC 6,0 В", "subtype": "≥ 6 А длительно, пик 8–10 А, ~17 × 23 мм",
                "pinlabels": ["IN+", "IN−", "OUT+ 6 В", "OUT−"]}
    c["DC5"] = {"type": "DC-DC 5 В 3 А", "subtype": "Mini560 или аналог", "pinlabels": ["IN+", "IN−", "OUT+ 5 В", "OUT−"]}
    c["HUB"] = {"type": "Плата шин", "subtype": "3 × буфер полудуплекса (см. bus_buffer) · 1000 мкФ на 6 В",
                "pinlabels": ["+6 В", "GND сил.", "+3,3 В", "GND лог.", "TXD A", "RXD A", "TXD B", "RXD B", "TXD C", "RXD C"],
                "notes": "Выходы A1–A3, B1–B3, C1–C3 — лист «Шины приводов»"}
    c["PI"] = {"type": "Raspberry Pi Zero 2 W", "subtype": "«голова»: Wi-Fi, камера, глаза, звук",
               "pinlabels": ["пин 2 · 5 В", "пин 6 · GND", "USB OTG VBUS", "USB OTG D−", "USB OTG D+", "USB OTG GND"],
               "notes": "У входа 5 В — конденсатор 470 мкФ"}
    c["RP"] = {"type": "RP2350-Zero", "subtype": "«спинной мозг»: шины, датчики края, IMU, заряд",
               "pinlabels": ["USB VBUS", "USB D−", "USB D+", "USB GND", "3V3 (выход)", "GND",
                             "GP0 UART0 TX", "GP1 UART0 RX", "GP4 UART1 TX", "GP5 UART1 RX",
                             "GP8 PIO TX", "GP9 PIO RX", "GP12 I2C0 SDA", "GP13 I2C0 SCL"]}

    def cab(name, n, gauge, length, colors, note, typ=None):
        w[name] = {"wirecount": n, "gauge": gauge, "length": length, "colors": colors, "notes": note}
        if typ:
            w[name]["type"] = typ

    cab("W1", 3, "18 AWG", 0.05, ["BK", "WH", "RD"], "Сборка батареи. BM — балансир, 26 AWG")
    cab("W2", 2, "18 AWG", 0.05, ["RD", "BK"], "7,4 В · ср. 1,5–2 А, пик ~10 А · защита BMS 15 А")
    cab("W3", 2, "18 AWG", 0.08, ["RD", "BK"], "7,4 В · весь ток робота")
    cab("W4", 2, "18 AWG", 0.06, ["RD", "RD"], "через выключатель — весь ток робота, пик ~10 А")
    cab("W5", 2, "22 AWG", 0.08, ["RD", "BK"], "заряд 2S · до 1,8 А (15 Вт)")
    cab("W6", 2, "20 AWG", 0.06, ["RD", "BK"], "5 В со станции · до 3 А (pogo — минимум 2 на полюс!)")
    cab("W7", 2, "18 AWG", 0.05, ["RD", "BK"], "7,4 В → 6 В · ср. 1–1,5 А, пик ~9 А")
    cab("W8", 2, "18 AWG", 0.08, ["RD", "BK"], "6 В на все 28 приводов · ход: ср. 1–2 А, пик 8–10 А")
    cab("W9", 2, "22 AWG", 0.05, ["RD", "BK"], "7,4 В → 5 В · ≤ 1,2 А")
    cab("W10", 2, "22 AWG", 0.08, ["RD", "BK"], "5 В: Pi Zero 2 W + камера + дисплеи + звук · 0,5–1,5 А")
    cab("W11", 4, "28 AWG", 0.10, ["RD", "WH", "GN", "BK"], "USB micro-B ↔ USB-C: питание RP2350 + связь Pi ↔ RP2350 (USB CDC)",
        typ="USB 2.0")
    cab("W12", 8, "28 AWG", 0.10, ["OG", "BK", "YE", "GN", "BU", "VT", "WH", "GY"], "логика 3,3 В · шины A, B, C по 1 Мбит/с")
    cab("W13", 4, "28 AWG", 0.10, ["OG", "BK", "BU", "YE"], "I2C 400 кГц · на этой же шине BMI270 и 6 × VL53L4CD")

    x += [[{"BAT": [1, 2, 3]}, {"W1": [1, 2, 3]}, {"BMS": [1, 2, 3]}],
          [{"BMS": [5, 4]}, {"W2": [1, 2]}, {"XT30": [1, 2]}],
          [{"XT30": [1, 2]}, {"W3": [1, 2]}, {"PWR": [1, 2]}],
          [{"PWR": [5, 6]}, {"W4": [1, 2]}, {"SW": [1, 2]}],
          [{"PADS": [1, 2]}, {"W6": [1, 2]}, {"CHG": [1, 2]}],
          [{"CHG": [3, 4]}, {"W5": [1, 2]}, {"PWR": [3, 4]}],
          [{"PWR": [7, 8]}, {"W7": [1, 2]}, {"DC6": [1, 2]}],
          [{"DC6": [3, 4]}, {"W8": [1, 2]}, {"HUB": [1, 2]}],
          [{"PWR": [9, 10]}, {"W9": [1, 2]}, {"DC5": [1, 2]}],
          [{"DC5": [3, 4]}, {"W10": [1, 2]}, {"PI": [1, 2]}],
          [{"PI": [3, 4, 5, 6]}, {"W11": [1, 2, 3, 4]}, {"RP": [1, 2, 3, 4]}],
          [{"RP": [5, 6, 7, 8, 9, 10, 11, 12]}, {"W12": [1, 2, 3, 4, 5, 6, 7, 8]}, {"HUB": [3, 4, 5, 6, 7, 8, 9, 10]}],
          [{"RP": [5, 6, 13, 14]}, {"W13": [1, 2, 3, 4]}, {"PWR": [13, 14, 11, 12]}]]
    return {"metadata": {"title": "Харви «Компакт мини» — питание и логика"}, "options": OPT,
            "connectors": c, "cables": w, "connections": x}


# ------------------------------------------------------------------ лист 2: шины приводов
LIMBS = [  # (имя, шина, выход, суставы, длина до первого привода, пик тока, ср. ток)
    ("LF", "A", 1, ["поворот", "бедро", "колено"], 0.10, "3,6", "0,1–0,6"),
    ("LM", "A", 2, ["поворот", "бедро", "колено"], 0.08, "3,6", "0,1–0,6"),
    ("LB", "A", 3, ["поворот", "бедро", "колено"], 0.10, "3,6", "0,1–0,6"),
    ("RF", "B", 1, ["поворот", "бедро", "колено"], 0.10, "3,6", "0,1–0,6"),
    ("RM", "B", 2, ["поворот", "бедро", "колено"], 0.08, "3,6", "0,1–0,6"),
    ("RB", "B", 3, ["поворот", "бедро", "колено"], 0.10, "3,6", "0,1–0,6"),
    ("CL", "C", 1, ["поворот плеча", "подъём", "локоть", "захват"], 0.10, "4,8", "0,1–0,3"),
    ("CR", "C", 2, ["поворот плеча", "подъём", "локоть", "захват"], 0.10, "4,8", "0,1–0,3"),
    ("EY", "C", 3, ["глаз левый", "глаз правый"], 0.08, "2,4", "до 0,1"),
]
LIMB_RU = {"LF": "левая передняя нога", "LM": "левая средняя нога", "LB": "левая задняя нога",
           "RF": "правая передняя нога", "RM": "правая средняя нога", "RB": "правая задняя нога",
           "CL": "левая клешня", "CR": "правая клешня", "EY": "глаза"}
LIMB_ID = {"LF": 10, "LM": 20, "LB": 30, "RF": 40, "RM": 50, "RB": 60, "CL": 70, "CR": 80, "EY": 90}


def bus_sheet():
    c, w, x = {}, {}, []
    for bus, what in (("A", "левые ноги, 9 приводов"), ("B", "правые ноги, 9 приводов"), ("C", "клешни и глаза, 10 приводов")):
        lab = []
        for k in (1, 2, 3):
            lab += [f"{bus}{k} GND", f"{bus}{k} +6 В", f"{bus}{k} DATA"]
        c[f"HUB_{bus}"] = {"type": f"Плата шин — шина {bus}", "subtype": what, "pinlabels": lab,
                           "notes": "питание к каждой конечности — своим проводом («звезда»);<br/>DATA — общая для шины"}
    for n, bus, k, joints, ln, peak, avg in LIMBS:
        base = (k - 1) * 3
        prev = f"HUB_{bus}"
        prev_pins = [base + 1, base + 2, base + 3]
        for j, jn in enumerate(joints, 1):
            sid = LIMB_ID[n] + j
            cn = f"{n}{j}"
            c[cn] = dict(SERVO, type=f"{n} · {jn}", subtype=f"STS3032-C036 · ID {sid}")
            wn = f"W_{n}{j}"
            if j == 1:
                left = len(joints)
                w[wn] = {"wirecount": 3, "gauge": "22 AWG", "length": ln, "colors": G3,
                         "notes": f"{LIMB_RU[n]}: ток {left} приводов · ср. {avg} А, пик {peak} А"}
            else:
                left = len(joints) - j + 1
                w[wn] = {"wirecount": 3, "gauge": "28 AWG", "length": 0.15, "colors": G3,
                         "type": "1,25 мм, 3-pin (из комплекта привода)",
                         "notes": f"ток {left} {'привода' if left < 5 else 'приводов'} · пик {1.2 * left:.1f} А".replace(".", ",")}
            x.append([{prev: prev_pins}, {wn: [1, 2, 3]}, {cn: [1, 2, 3]}])
            prev, prev_pins = cn, [1, 2, 3]
    return {"metadata": {"title": "Харви «Компакт мини» — шины приводов"}, "options": OPT,
            "connectors": c, "cables": w, "connections": x}


# ------------------------------------------------------------------ интерфейс шины (schemdraw)
def bus_buffer():
    """Интерфейс одной шины по схеме Feetech (даташит STS3032-C036, п. 12): два буфера и автопереключение направления."""
    import schemdraw
    import schemdraw.elements as elm
    schemdraw.use("matplotlib")
    schemdraw.config(font="Arial", fontsize=11)
    d = schemdraw.Drawing(show=False)
    L = lambda a, b: elm.Line().at(a).to(b)
    with d:
        u1 = elm.Ic(pins=[elm.IcPin(name="A", pin="2", side="left", slot="2/2"), elm.IcPin(name="OE", pin="1", side="left", slot="1/2"),
                          elm.IcPin(name="Y", pin="4", side="right"), elm.IcPin(name="VCC", pin="5", side="top"),
                          elm.IcPin(name="GND", pin="3", side="bot")],
                    size=(4.6, 2.6), label="U1 SN74LVC1G126\nпередача").at((0, 0))
        d += u1
        u2 = elm.Ic(pins=[elm.IcPin(name="Y", pin="4", side="left", slot="2/2"), elm.IcPin(name="OE̅", anchorname="nOE", pin="1", side="left", slot="1/2"),
                          elm.IcPin(name="A", pin="2", side="right"), elm.IcPin(name="VCC", pin="5", side="top"),
                          elm.IcPin(name="GND", pin="3", side="bot")],
                    size=(4.6, 2.6), label="U2 SN74LVC1G125\nприём").at((0, -8.5))
        d += u2
        for u in (u1, u2):
            d += elm.Line().up(0.7).at(u.VCC); d += elm.Vdd().label("+3,3 В")
            d += elm.Line().down(0.5).at(u.GND); d += elm.Ground()
        # TXD → U1.A, отвод на базу Q1
        xa, ya = u1.A
        d += L((xa - 7.5, ya), (xa, ya))
        d += elm.Dot(open=True).at((xa - 7.5, ya)).label("TXD ← RP2350 (GP0)", "left")
        d += elm.Dot().at((xa - 5.5, ya))
        d += elm.Resistor().down(3.0).at((xa - 5.5, ya)).label("R1\n10 кОм", loc="top")
        q = elm.BjtPnp(circle=True).right().anchor("base").label("Q1\nPNP", loc="right")
        d += q
        d += elm.Line().up(0.4).at(q.emitter); d += elm.Vdd().label("+3,3 В")
        d += elm.Line().down(0.6).at(q.collector)
        txen = d.here
        d += elm.Dot()
        d += elm.Resistor().down(2.0).label("R2\n20 кОм", loc="bottom"); d += elm.Ground()
        # TXEN → U1.OE и U2.OE̅
        xo, yo = u1.OE
        xj = xo - 1.4
        d += L(txen, (xj, txen[1])); d += elm.Label().at(((txen[0] + xj) / 2, txen[1] + 0.35)).label("TXEN")
        d += elm.Dot().at((xj, txen[1]))
        d += L((xj, txen[1]), (xj, yo)); d += L((xj, yo), (xo, yo))
        xn, yn = u2.nOE
        d += L((xj, txen[1]), (xj, yn)); d += L((xj, yn), (xn, yn))
        # U2.Y → RXD
        xy, yy = u2.Y
        d += L((xy, yy), (xa - 7.5, yy)); d += elm.Dot(open=True).at((xa - 7.5, yy)).label("RXD → RP2350 (GP1)", "left")
        # DATA: U1.Y и U2.A, подтяжка, разъём
        x1, y1 = u1.Y; x2, y2 = u2.A
        xd = x1 + 1.6
        d += L((x1, y1), (xd + 3.2, y1)); d += elm.Dot().at((xd, y1))
        d += L((xd, y1), (xd, y2)); d += L((xd, y2), (x2, y2))
        d += elm.Dot().at((xd + 1.6, y1))
        d += elm.Resistor().up(2.0).at((xd + 1.6, y1)).label("R3\n10 кОм", loc="bottom"); d += elm.Vdd().label("+3,3 В")
        d += elm.Dot(open=True).at((xd + 3.2, y1)).label("DATA → шина (контакт 3 разъёма привода)", "right")
        d += elm.Label().at((xa - 9.0, y2 - 4.4)).label(
            "Одна из трёх шин (A, B, C) — схема Feetech, даташит STS3032-C036, п. 12. C1, C2 — 100 нФ у выводов VCC U1 и U2.\n"
            "TXD в покое = 1 → Q1 закрыт → TXEN = 0: U1 отключён, U2 передаёт DATA на RXD — приём.\n"
            "TXD = 0 (стартовый бит) → Q1 открыт → TXEN = 1: U1 передаёт TXD на DATA, U2 отключён — передача.\n"
            "Буферы — именно LVC: их входы выдерживают 5 В с шины. Питание буферов 3,3 В — от RP2350.",
            halign="left", valign="top")
    return d


# ------------------------------------------------------------------ лист 3: Pi Zero 2 W — камера, глаза, звук, касание
# Гребёнка Pi Zero 2 W: физический номер пина → (GPIO, функция). Используются только эти.
PI_PINS = [
    (2, "5 В (вход от DC-DC 5 В)"), (4, "5 В → усилитель"), (1, "3,3 В → глаза"), (17, "3,3 В → микрофоны, касание"),
    (6, "GND"), (9, "GND"), (14, "GND"), (20, "GND"), (25, "GND"),
    (23, "GPIO11 · SPI0 SCLK"), (19, "GPIO10 · SPI0 MOSI"), (22, "GPIO25 · DC глаз"), (18, "GPIO24 · RST глаз"),
    (24, "GPIO8 · SPI0 CE0 · левый глаз"), (26, "GPIO7 · SPI0 CE1 · правый глаз"), (32, "GPIO12 · PWM0 · подсветка глаз"),
    (12, "GPIO18 · I2S BCLK"), (35, "GPIO19 · I2S LRCLK"), (38, "GPIO20 · I2S DIN ← микрофоны"), (40, "GPIO21 · I2S DOUT → усилитель"),
    (37, "GPIO26 · SD усилителя (тишина)"),
    (29, "GPIO5 · касание 1"), (31, "GPIO6 · касание 2"), (36, "GPIO16 · касание 3"), (11, "GPIO17 · касание 4"),
]


def pi_sheet():
    c, w, x = {}, {}, []
    pin = {p: i + 1 for i, (p, _) in enumerate(PI_PINS)}             # физический пин → номер строки в таблице
    c["PI"] = {"type": "Raspberry Pi Zero 2 W — гребёнка 40 pin", "subtype": "разводка на плате-переходнике над гребёнкой",
               "pinlabels": [f"пин {p} · {f}" for p, f in PI_PINS], "show_pincount": False,
               "notes": "Свободны для запаса: GPIO14/15 (UART), GPIO2/3 (I2C1), GPIO4, GPIO13, GPIO22, GPIO23, GPIO27.<br/>"
                        "Связь с RP2350 — по USB (лист «Питание и логика»)."}
    c["PI_CSI"] = {"type": "Pi Zero 2 W — разъём камеры", "subtype": "mini-CSI 22 pin",
                   "pinlabels": ["GND", "D0−", "D0+", "D1−", "D1+", "CLK−", "CLK+", "CAM_GPIO (вкл.)", "SCL0 (камера)", "SDA0 (камера)", "3,3 В"]}
    c["CAM"] = {"type": "Camera Module 3 Wide", "subtype": "IMX708, 120°, CSI 15 pin · в передней стенке",
                "pinlabels": ["GND", "D0−", "D0+", "D1−", "D1+", "CLK−", "CLK+", "CAM_IO0 (вкл.)", "SCL", "SDA", "3,3 В"],
                "notes": "~200–250 мА от 3,3 В Pi"}
    for s, nm in (("L", "левый"), ("R", "правый")):
        c[f"EYE_{s}"] = {"type": f"Глаз {nm}: GC9D01 0,71″", "subtype": "160 × 160, SPI, Ø24 × 4,5 мм · на стебельке",
                         "pinlabels": ["GND", "VCC 3,3 В", "SCL (SCLK)", "SDA (MOSI)", "RES", "DC", "CS", "BLK"],
                         "notes": "~15 мА + подсветка ~20 мА · BLK — вход ключа модуля (проверить на плате)"}
        c[f"MIC_{s}"] = {"type": f"Микрофон {nm}: INMP441", "subtype": "I2S, 24 бит · у боковой стенки",
                         "pinlabels": ["VDD 3,3 В", "GND", "SCK", "WS", "SD", "L/R"],
                         "notes": "L/R → GND (левый канал)" if s == "L" else "L/R → VDD (правый канал)"}
    c["AMP"] = {"type": "Усилитель MAX98357A", "subtype": "I2S, класс D, 3 Вт макс.",
                "pinlabels": ["VIN 5 В", "GND", "BCLK", "LRC", "DIN", "SD", "OUT+", "OUT−"],
                "notes": "GAIN не подключён — 9 дБ; SD: 1 — звук, 0 — тишина (через 100 кОм к 3,3 В на плате)"}
    c["SPK"] = {"type": "Динамик 20 мм", "subtype": "8 Ом, 1 Вт · под решёткой крышки", "pinlabels": ["+", "−"]}
    for k in range(1, 5):
        c[f"T{k}"] = {"type": f"Касание {k}: TTP223", "subtype": "на крышке, «погладить»", "pinlabels": ["VCC 3,3 В", "GND", "OUT"]}

    def cab(name, n, gauge, length, colors, note, typ=None):
        w[name] = {"wirecount": n, "length": length, "colors": colors, "notes": note}
        if gauge:
            w[name]["gauge"] = gauge
        if typ:
            w[name]["type"] = typ

    cab("W_CAM", 11, None, 0.08, ["BK", "GY", "WH", "GY", "WH", "GY", "WH", "VT", "BU", "YE", "OG"],
        "шлейф Zero 22 → 15 pin, 5–10 см; MIPI CSI-2, 2 линии", typ="FPC-шлейф")
    for s in ("L", "R"):
        cab(f"W_EYE_{s}", 8, "30 AWG", 0.16, ["BK", "OG", "VT", "BU", "GY", "WH", "GN", "YE"],
            "через стебелёк, с петлёй на поворот глаза −90…+20° · SPI до 32 МГц (тонкий длинный провод)")
        cab(f"W_MIC_{s}", 5, "30 AWG", 0.10, ["OG", "BK", "VT", "BU", "GN"], "I2S · 3,3 В, ~1,4 мА")
    cab("W_AMP", 6, "28 AWG", 0.08, ["RD", "BK", "VT", "BU", "YE", "WH"], "5 В · до 0,3 А на громкости")
    cab("W_SPK", 2, "26 AWG", 0.06, ["RD", "BK"], "до 1 Вт на 8 Ом")
    for k in range(1, 5):
        cab(f"W_T{k}", 3, "30 AWG", 0.10, ["OG", "BK", "GN"], "3,3 В · мкА")

    P = lambda *ps: [pin[p] for p in ps]
    x.append([{"PI_CSI": list(range(1, 12))}, {"W_CAM": list(range(1, 12))}, {"CAM": list(range(1, 12))}])
    x.append([{"PI": P(6, 1, 23, 19, 18, 22, 24, 32)}, {"W_EYE_L": list(range(1, 9))}, {"EYE_L": list(range(1, 9))}])
    x.append([{"PI": P(9, 1, 23, 19, 18, 22, 26, 32)}, {"W_EYE_R": list(range(1, 9))}, {"EYE_R": list(range(1, 9))}])
    for s, g in (("L", 14), ("R", 20)):
        x.append([{"PI": P(17, g, 12, 35, 38)}, {f"W_MIC_{s}": [1, 2, 3, 4, 5]}, {f"MIC_{s}": [1, 2, 3, 4, 5]}])
    x.append([{"PI": P(4, 25, 12, 35, 40, 37)}, {"W_AMP": [1, 2, 3, 4, 5, 6]}, {"AMP": [1, 2, 3, 4, 5, 6]}])
    x.append([{"AMP": [7, 8]}, {"W_SPK": [1, 2]}, {"SPK": [1, 2]}])
    for k, g in zip(range(1, 5), (29, 31, 36, 11)):
        x.append([{"PI": P(17, 25, g)}, {f"W_T{k}": [1, 2, 3]}, {f"T{k}": [1, 2, 3]}])
    return {"metadata": {"title": "Харви «Компакт мини» — Pi Zero 2 W: камера, глаза, звук, касание"}, "options": OPT,
            "connectors": c, "cables": w, "connections": x}


# ------------------------------------------------------------------ лист 4: RP2350-Zero — датчики
# Все 20 выводов RP2350-Zero (GP0–GP15, GP26–GP29). Предварительное назначение.
RP_MAP = [
    ("GP0", "шина A · UART0 TX"), ("GP1", "шина A · UART0 RX"), ("GP2", "XSHUT датчика края 1 (вперёд, слева)"),
    ("GP3", "XSHUT датчика края 2 (вперёд, справа)"), ("GP4", "шина B · UART1 TX"), ("GP5", "шина B · UART1 RX"),
    ("GP6", "XSHUT датчика края 3 (назад, слева)"), ("GP7", "XSHUT датчика края 4 (назад, справа)"),
    ("GP8", "шина C · PIO UART TX"), ("GP9", "шина C · PIO UART RX"), ("GP10", "XSHUT датчика края 5 (бок, слева)"),
    ("GP11", "XSHUT датчика края 6 (бок, справа)"), ("GP12", "I2C0 SDA"), ("GP13", "I2C0 SCL"),
    ("GP14", "ИК-приёмник маяка, слева"), ("GP15", "ИК-приёмник маяка, справа"), ("GP26", "INT1 BMI270 (рывок, падение, «подняли»)"),
    ("GP27", "ALERT INA226 (батарея, перегрузка)"), ("GP28", "ИК-приёмник маяка, по центру"), ("GP29", "резерв · АЦП"),
]
EDGE = [("вперёд, слева", "GP2"), ("вперёд, справа", "GP3"), ("назад, слева", "GP6"), ("назад, справа", "GP7"),
        ("бок, слева", "GP10"), ("бок, справа", "GP11")]


def rp_sheet():
    c, w, x = {}, {}, []
    lab = ["3V3 (выход)", "GND"] + [f"{g} · {f}" for g, f in RP_MAP if not f.startswith("шина")]
    idx = {l.split(" · ")[0]: i + 1 for i, l in enumerate(lab)}
    c["RP"] = {"type": "RP2350-Zero", "subtype": "датчики (шины приводов — лист «Шины приводов»)", "pinlabels": lab, "show_pincount": False,
               "notes": "Заняты 19 из 20 выводов: касание перенесено на Pi Zero, резерв — GP29 (АЦП)"}
    c["SH"] = {"type": "Плата шин — разъёмы датчиков", "subtype": "I2C0 на 3,3 В, подтяжка 2,2 кОм (на модулях подтяжки снять)",
               "pinlabels": ["3,3 В", "GND", "SDA", "SCL"], "notes": "звезда от платы шин к каждому датчику"}
    for k, (where, g) in enumerate(EDGE, 1):
        c[f"VL{k}"] = {"type": f"Датчик края {k}: VL53L4CD", "subtype": f"{where} · у дна, луч к столу",
                       "pinlabels": ["VIN 3,3 В", "GND", "SDA", "SCL", "XSHUT"],
                       "notes": "адрес раздаётся при включении: по очереди поднять XSHUT и сменить адрес"}
        w[f"W_VL{k}"] = {"wirecount": 5, "gauge": "30 AWG", "length": 0.12, "colors": ["OG", "BK", "BU", "YE", "GN"],
                         "notes": "I2C 400 кГц · ~20 мА при измерении"}
        x.append([{"SH": [1, 2, 3, 4]}, {f"W_VL{k}": [1, 2, 3, 4]}, {f"VL{k}": [1, 2, 3, 4]}])
        x.append([{"RP": [idx[g]]}, {f"W_VL{k}": [5]}, {f"VL{k}": [5]}])
    c["IMU"] = {"type": "IMU BMI270", "subtype": "в центре корпуса, на стойке у Pi", "pinlabels": ["VCC 3,3 В", "GND", "SDA", "SCL", "INT1"]}
    w["W_IMU"] = {"wirecount": 5, "gauge": "30 AWG", "length": 0.08, "colors": ["OG", "BK", "BU", "YE", "VT"], "notes": "I2C · ~1 мА"}
    x.append([{"SH": [1, 2, 3, 4]}, {"W_IMU": [1, 2, 3, 4]}, {"IMU": [1, 2, 3, 4]}])
    x.append([{"RP": [idx["GP26"]]}, {"W_IMU": [5]}, {"IMU": [5]}])
    w["W_I2C"] = {"wirecount": 4, "gauge": "28 AWG", "length": 0.06, "colors": ["OG", "BK", "BU", "YE"], "notes": "I2C0 к плате шин"}
    x.append([{"RP": [idx["3V3 (выход)"], idx["GND"], idx["GP12"], idx["GP13"]]}, {"W_I2C": [1, 2, 3, 4]}, {"SH": [1, 2, 3, 4]}])
    c["INA"] = {"type": "INA226 на плате питания", "subtype": "I2C — лист «Питание и логика»", "pinlabels": ["ALERT"]}
    w["W_ALERT"] = {"wirecount": 1, "gauge": "30 AWG", "length": 0.10, "colors": ["WH"], "notes": "низкий заряд / перегрузка → прерывание"}
    x.append([{"RP": [idx["GP27"]]}, {"W_ALERT": [1]}, {"INA": [1]}])
    for k, (nm, g, where, note) in enumerate((
            ("слева", "GP14", "на передней стенке слева от камеры, развёрнут наружу на 30°", "куда повернуть к станции"),
            ("по центру", "GP28", "под объективом камеры, смотрит вперёд", "по какую сторону оси станции корпус"),
            ("справа", "GP15", "на передней стенке справа от камеры, развёрнут наружу на 30°", "куда повернуть к станции")), 1):
        c[f"IR{k}"] = {"type": f"ИК-приёмник {nm}: TSOP38238", "subtype": f"38 кГц · {where}",
                       "pinlabels": ["VS 3,3 В", "GND", "OUT"], "notes": f"без ПК и в темноте: {note}"}
        w[f"W_IR{k}"] = {"wirecount": 3, "gauge": "30 AWG", "length": 0.08, "colors": ["OG", "BK", "GN"], "notes": "~0,4 мА"}
        x.append([{"RP": [idx["3V3 (выход)"], idx["GND"], idx[g]]}, {f"W_IR{k}": [1, 2, 3]}, {f"IR{k}": [1, 2, 3]}])
    return {"metadata": {"title": "Харви «Компакт мини» — RP2350: датчики"}, "options": OPT,
            "connectors": c, "cables": w, "connections": x}


# ------------------------------------------------------------------ станция: проводка и маяк
def station_sheet():
    """Станция-«гнездо»: USB-C 5 В 3 А → предохранитель → контакты pogo и плата маяка. «+» — слева, если стоять
    за башенкой лицом к площадке так же, как Харви (BELLY_Y в модели: +16 мм — «+»)."""
    c, w, x = {}, {}, []
    c["PSU"] = {"type": "Блок питания USB-C", "subtype": "5 В 3 А (15 Вт) — тот же, что у телефона", "pinlabels": ["VBUS 5 В", "GND"]}
    c["USB"] = {"type": "Плата-разъём USB-C (приёмник)", "subtype": "резисторы 5,1 кОм на CC1 и CC2 — без них адаптер не даст 5 В",
                "pinlabels": ["VBUS", "GND"], "notes": "в отсеке башенки, разъём — в окне крышки dock_cover"}
    c["F"] = {"type": "Самовосстанавливающийся предохранитель", "subtype": "PTC 3 А (удержание) — контакты открыты: монета, скрепка",
              "pinlabels": ["1", "2"]}
    c["POGO"] = {"type": "Pogo-контакты Ø5, ход 1,5 мм", "subtype": "3–5 А · в гнёздах площадки dock_pad", "pinlabels": ["+5 В (y = +16)", "GND (y = −16)"],
                 "notes": "Харви опускает корпус на 13 мм — пластины брюха ложатся на контакты"}
    c["BCN"] = {"type": "Маяк: RP2350-Zero + 2 × AO3400A + 2 × TSAL6200", "subtype": "лист beacon: пачки 38 кГц левого (0,6 мс) и правого (1,2 мс) светодиода по очереди",
                "pinlabels": ["+5 В", "GND"], "notes": "~50 мА в среднем: плата ~20 мА, светодиоды ≤ 15 мА каждый"}
    for name, n, gauge, length, colors, note in (
            ("W_PSU", 2, None, 1.5, ["BK", "BK"], "кабель USB-C от блока питания"),
            ("W_F", 2, "20 AWG", 0.05, ["RD", "BK"], "до 3 А"),
            ("W_POGO", 2, "20 AWG", 0.15, ["RD", "BK"], "до 3 А · по каналам площадки и перемычке в отсек"),
            ("W_BCN", 2, "26 AWG", 0.05, ["RD", "BK"], "≈ 50 мА")):
        w[name] = {"wirecount": n, "length": length, "colors": colors, "notes": note}
        if gauge:
            w[name]["gauge"] = gauge
    x += [[{"PSU": [1, 2]}, {"W_PSU": [1, 2]}, {"USB": [1, 2]}],
          [{"USB": [1]}, {"W_F": [1]}, {"F": [1]}],
          [{"F": [2]}, {"W_POGO": [1]}, {"POGO": [1]}],
          [{"USB": [2]}, {"W_POGO": [2]}, {"POGO": [2]}],
          [{"F": [2]}, {"W_BCN": [1]}, {"BCN": [1]}],
          [{"USB": [2]}, {"W_F": [2]}, {"BCN": [2]}]]
    return {"metadata": {"title": "Харви «Компакт мини» — станция: питание и маяк"}, "options": OPT,
            "connectors": c, "cables": w, "connections": x}


def beacon():
    """Маяк станции на RP2350-Zero (код/прошивка/станция/beacon_station.py): ШИМ 38 кГц (1/3) по очереди на левый
    (GP0, пачка 0,6 мс) и правый (GP1, 1,2 мс) светодиод, пауза 0,6 мс. TSOP382 (документы/TSOP382 — даташит Vishay.pdf):
    пачка ≥ 10 периодов, пауза ≥ 12, ≤ 1700 пачек/с — здесь 23 и 46 периодов, пауза 23, 667 пачек/с.
    Ключи AO3400A (документы/AO3400A — даташит AOS.pdf: Vgs(th) ≤ 1,45 В, Rds(on) < 48 мОм при 2,5 В) — открываются от
    3,3 В вывода. Светодиод TSAL6200: (5 − 1,35) / 33 ≈ 110 мА в импульсе (IFM 200 мА), в среднем ≤ 15 мА."""
    import schemdraw
    import schemdraw.elements as elm
    schemdraw.use("matplotlib")
    schemdraw.config(font="Arial", fontsize=11)
    d = schemdraw.Drawing(show=False)
    pins = [elm.IcPin(name="5V", side="top"), elm.IcPin(name="GND", side="bot"),
            elm.IcPin(name="GP0", side="right", slot="1/2"), elm.IcPin(name="GP1", side="right", slot="2/2")]
    tag = lambda at, text, loc: elm.Dot(open=True).at(at).label(text, loc)
    with d:
        u = elm.Ic(pins=pins, size=(3.0, 5.0), edgepadH=1.0).label("RP2350-Zero\nмаяк", "center")
        d += u
        d += elm.Line().up(0.6).at(u["5V"]); d += elm.Vdd().label("+5 В")
        d += elm.Line().down(0.6).at(u.GND); d += elm.Ground()
        # ближний к плате канал — от верхнего вывода (GP1), дальний — от нижнего (GP0): провода не пересекаются
        for k, (pin, name, burst, nr) in enumerate(((u.GP1, "правый (−y)", "1,2 мс", 2), (u.GP0, "левый (+y)", "0,6 мс", 1))):
            xg, y = pin[0] + 4.5 + k * 6.0, pin[1]
            d += elm.Line().at(pin).to((xg - 3.1, y))
            d += elm.Resistor().at((xg - 3.1, y)).to((xg - 0.6, y)).label(f"R{2 + nr} 100 Ом", "top")
            d += elm.Dot().at((xg - 0.6, y))
            d += elm.Line().at((xg - 0.6, y)).to((xg, y))
            q = elm.NFet(bulk=False).reverse().anchor("gate").at((xg, y)).label(f"Q{nr}\nAO3400A", "right")
            d += q
            d += elm.Resistor().at((xg - 0.6, y)).down(2.0).label(f"R{4 + nr}\n100 кОм", "top"); d += elm.Ground()
            d += elm.Line().down(0.5).at(q.source); d += elm.Ground()
            d += elm.Line().up(0.3).at(q.drain)
            d += elm.LED().up(2.0).reverse().label(f"D{nr} TSAL6200\n{name}\nпачка {burst}", "bottom")
            d += elm.Resistor().up(2.0).label(f"R{nr} 33 Ом\n0,25 Вт", "bottom")
            d += elm.Vdd().label("+5 В")
        bx, by = u.GND[0] - 6.0, u.GND[1] + 1.0
        d += elm.Capacitor(polar=True).at((bx, by)).down(1.6).label("C1\n10 мкФ", "bottom"); d += elm.Ground()
        d += tag((bx, by), "+5 В у светодиодов", "left")
        d += elm.Label().at((u.GND[0] - 7.0, u.GND[1] - 4.0)).label(
            "Пачки по очереди: левый 0,6 мс (23 периода), пауза 0,6 мс, правый 1,2 мс (46), пауза 0,6 мс → 333 пачки/с каждого\n"
            "Харви различает их по длине импульса TSOP (tpo = tpi ± 132 мкс): граница 0,9 мс\n"
            "Светодиоды — в стенке башенки на высоте 12 мм, в 3,5 мм от оси, между ними перегородка 42,5 мм (модели/мини, dock_tower)\n"
            "ПРЕДВАРИТЕЛЬНО: R 100 Ом гасит звон затвора, 100 кОм держит ключ закрытым при старте платы; проверить на стенде", "right")
    return d


def render(name, data):
    path = os.path.join(HERE, name + ".yml")
    with open(path, "w", encoding="utf-8") as f:
        yaml.safe_dump(data, f, allow_unicode=True, sort_keys=False)
    exe = os.path.join(os.path.dirname(sys.executable), "wireviz.exe")
    env = dict(os.environ, PYTHONUTF8="1")            # WireViz читает файлы кодировкой по умолчанию — в Windows это cp1251
    subprocess.run([exe if os.path.exists(exe) else "wireviz", "-f", "hpst", path], check=True, env=env)
    print("готово:", name)


if __name__ == "__main__":
    os.environ["PATH"] = r"C:\Program Files\Graphviz\bin;" + os.environ.get("PATH", "")
    render("mini_power", power_sheet())
    render("mini_bus", bus_sheet())
    render("mini_pi", pi_sheet())
    render("mini_sensors", rp_sheet())
    d = bus_buffer()
    d.save(os.path.join(HERE, "bus_buffer.svg"))
    d.save(os.path.join(HERE, "bus_buffer.png"), dpi=150)
    print("готово: bus_buffer")
    render("station", station_sheet())
    d = beacon()
    d.save(os.path.join(HERE, "beacon.svg"))
    d.save(os.path.join(HERE, "beacon.png"), dpi=150)
    print("готово: beacon")
