iamharveststorm/harvey/код/прошивка/rp2350/BMI270-CONFIG-LICENSE.txt

bmi270_config.bin — массив bmi270_config_file из Bosch Sensortec BMI270 Sensor API v2.86.1 (bmi270.c, 2023-05-03),
https://github.com/boschsensortec/BMI270_SensorAPI. Распространяется по лицензии ниже.

Copyright (c) 2023 Bosch Sensortec GmbH. All rights reserved.

BSD-3-Clause

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
1. Redistributions of source code must retain the above copyright
   notice, this list of conditions and the following disclaimer.

2. Redistributions in binary form must reproduce the above copyright
   notice, this list of conditions and the following disclaimer in the
   documentation and/or other materials provided with the distribution.

3. Neither the name of the copyright holder nor the names of its
   contributors may be used to endorse or promote products derived from
   this software without specific prior written permission.

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
@file       bmi270.c
@date       2023-05-03
@version    v2.86.1
