iamharveststorm/harvey/код/прошивка/rp2350/pins.py

# Харви «Компакт мини» — выводы RP2350-Zero и настройки «спинного мозга».
# ПРЕДВАРИТЕЛЬНО: карта выводов — из схемы (схемы/README.md, «Выводы RP2350-Zero»), проверить на стенде
# до пайки. Пороги батареи и края — оценки, уточняются замерами.

# Шины приводов (ID = 10 × конечность + сустав, схемы/README.md «Номера приводов»)
BUS_A = dict(uart=0, tx=0, rx=1)        # левые ноги: 11–13, 21–23, 31–33 — UART0
BUS_B = dict(uart=1, tx=4, rx=5)        # правые ноги: 41–43, 51–53, 61–63 — UART1
BUS_C = dict(pio=0, tx=8, rx=9)         # клешни 71–74, 81–84, глаза 91, 92 — UART на PIO
BUS_BAUD = 1000000

# I2C0: INA226 (0x40), BMI270 (0x68), 6 × VL53L4CD (после смены адресов 0x30–0x35)
I2C_ID, SDA, SCL, I2C_HZ = 0, 12, 13, 400000

# Датчики края: порядок = порядок в телеметрии; XSHUT — выход RP2350 (VL53L4CD, разд. 2: активный низкий)
EDGE_NAMES = ("FL", "FR", "BL", "BR", "L", "R")   # вперёд-слева, вперёд-справа, назад-слева, назад-справа, бока
EDGE_XSHUT = (2, 3, 6, 7, 10, 11)
EDGE_ADDR0 = 0x30                       # новые 7-битные адреса: 0x30 + номер
EDGE_MARGIN_MM = 25                     # край: дальше опорного расстояния до стола больше чем на 25 мм
EDGE_NOMINAL_MM = (72, 72, 72, 72, 104, 104)   # расчётное расстояние до стола в стойке (CAD + симуляция мини), предварительно
EDGE_BUDGET_MS = 20                     # время замера VL53L4CD (10–200 мс, драйвер ULD): 50 замеров в секунду

IMU_INT1 = 26                           # BMI270 INT1: готовы данные (INT_MAP_DATA.drdy_int1)
INA_ALERT = 27                          # INA226 ALERT: напряжение батареи ниже порога (BUL)
IR_LEFT, IR_RIGHT = 14, 15              # TSOP38238 слева / справа: выход 0, пока идёт пачка 38 кГц
IR_CENTER = 28                          # TSOP38238 по центру (был резерв): с какой стороны оси станции корпус

SHUNT_OHM = 0.010                       # заметки/Комплектация мини.md: INA226, шунт 10 мОм
CURRENT_LSB_A = 0.00025                 # 0,25 мА: предел шунта 81,92 мВ / 10 мОм = 8,19 А (INA226, разд. 7.1.2)
BAT_LOW_V = 6.8                         # 2S: 3,4 В на банку — пора на станцию
BAT_CRITICAL_V = 6.4                    # 3,2 В на банку — сесть и ждать

TELEMETRY_MS = 50                       # телеметрия на Pi — 20 раз в секунду
