iamharveststorm/harvey/код/стенд привода/tests/test_bench.py

"""Замеры одного привода на имитации: связь и номер, ток, момент, скорость, люфт, точность, нагрев, размеры, калибровка тока."""
import json
from pathlib import Path

import pytest

from harvey_bench import fake, sts
from harvey_bench.bench import CALIB_FILE, STEP_DEG, Bench, measure_servo
from harvey_bench.fake import FakeBus, FakeServo
from helpers import answer, result

SPEEDUP = 50.0


def make(key: str, ids=(1,)) -> Bench:
    bus = FakeBus(ids=ids, speedup=SPEEDUP, profile=sts.PROFILES[key])
    return Bench(bus, auto=True, speedup=bus.speedup, clock=bus.clock, profile=sts.PROFILES[key])


@pytest.fixture
def big():
    return make("sts3215")


@pytest.fixture
def mini():
    return make("sts3032")


def released(b: Bench) -> bool:
    return all(s.mem[sts.TORQUE_ENABLE[0]] == 0 for s in b.bus.servos.values())


# ---------- калибровка тока в файле ----------
def test_saved_current_scale_is_loaded_per_servo_type():
    CALIB_FILE.write_text(json.dumps({"sts3215": 0.004, "sts3032": 0.009, "sts3032_sensor": True}), encoding="utf-8")
    assert make("sts3215").lsb == 0.004
    m = make("sts3032")
    assert m.lsb == 0.009 and m.current_ok is True


def test_old_calibration_key_still_works_for_sts3215():
    CALIB_FILE.write_text(json.dumps({"current_lsb_a": 0.005}), encoding="utf-8")
    assert make("sts3215").lsb == 0.005
    assert make("sts3032").lsb == sts.CURRENT_LSB_A                 # старый ключ — только про STS3215
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
