iamharveststorm/harvey/(commit log)

2026-10-16 Харви v2 «Компакт»: компоновка v2, рама и мягкий кожух, клешни, хвост, глаза, стенды этапа 1, симуляция (мир, адаптивная походка, физика веществ, режим «фото»)
    [00_test_stand.stl, 01_base.stl, 01_belly.stl, 02_ring_frame.stl, 02_yaw_bracket.stl, 03_arm_plate_outer.stl, 03_front_deck.stl, 04_arm_plate_inner.stl]
2026-10-16 Компакт мини: решения по узлам, первая симуляция (ходьба, ручка)
2026-10-16 Компакт мини: CAD целиком, станция зарядки, симуляция из CAD, кадры и документация
    - модели/мини: 14 печатных деталей + станция, 889 г, 0 столкновений во всех разрешённых позах, правила движения
    - код/симуляция/мини: размеры и массы из CAD; ходьба, разворот, ручка, салфетка, край стола, станция — все проверки пройдены
    - заметки: Компакт мини (комплектация ≈ 47–108 тыс. ₽), журнал решений, галерея
    Co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
    [L_ay__grey.stl, L_ay__servo.stl, L_eye__orange.stl, L_eye__screen.stl, L_fore__orange.stl, L_hand__servo.stl, L_hand__tpu.stl, L_jaw__tpu.stl]
2026-10-16 Мини: рендеры на столе в Blender (масштаб 1:1), полный список запчастей, стенд ноги, DC-DC и крепёж в CAD
    - render_desk.py: режим HARVEY_ROBOT=mini; реквизит в реальных размерах без пересечений (кружка, лампа, цветок, карандаши исправлены)
    - заметки/Комплектация мини: этап 1, полный список (≈ 48–111 тыс. ₽), крепёж, 3D-печать
    - модели/мини: leg_stand, стойки крышки, винты в дно гнёзд, DC-DC 6 В реального размера; 0 столкновений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
    [battery.stl, case.stl, chassis_PLA.stl, dark.stl, grey.stl, leg_stand_PLA.stl, lid_PLA.stl, orange.stl]
2026-10-16 README рендера: исправлен путь к Blender
2026-10-16 README рендера: путь к окружению CAD
2026-10-16 Компакт перерендерен в масштабе 1:1: робот на столе по нижней точке, реквизит без пересечений
    [battery.stl, case.stl, dark.stl, glass.stl, grey.stl, metal.stl, orange.stl, pcb.stl]
2026-10-16 Комплектация мини: что уже есть из заказа этапа 1 и что докупить; кабели STS3032 — шаг 1,25 мм; размеры C036 по даташиту
2026-10-16 Мини: управление с клавиатуры — физика MuJoCo, картинка Filament PBR, станция, батарея, автопилот домой; боковые датчики края 3,5:1
2026-10-16 Мини: настоящие ручки и карандаш (форма, масса, трение), захват по пределу момента, вид глазами Харви (V), наклон корпуса для обзора, поза «поджато» не закрывает камеру
2026-10-16 Смета мини по реальной цене STS3032-C036 (3 280 ₽, Feetech Official Store): весь мини 116–161 тыс. ₽; печать стенда — после замера приводов
2026-10-17 Комплектация мини: буферы шины, макетка и Dupont ещё не куплены — список для проверки шины от Pico 2
2026-10-17 Pico 2 ещё не куплена: брать Pico 2 H (со штырьками) для стенда
2026-10-17 Pico 2 H заказана (AliExpress, Joyful Chip Store)
2026-10-17 Кабель micro-USB для Pico 2 H заказан
2026-10-17 Заказаны приводы STS3032-C036, винты M2 и провода Dupont
2026-10-17 Кабель 1,25 мм со свободным концом скорее всего не нужен: хватит переходника из комплекта привода
2026-10-17 Заказаны макетная плата и разъёмы 1,25 мм с проводами
2026-10-17 Адаптер шины Waveshare (A) для проверки шины от Pico
2026-10-17 Адаптер шины заказан: для стенда мини заказано всё
2026-10-17 Чек-лист стенда мини: всё по пунктам, включая инструмент, пайку и питание
2026-10-17 Чек-лист стенда мини: внесены заказы (блок питания, URT-1, мультиметр, инструмент); не хватает привода, шестигранник нужен 1,5 мм
2026-10-17 Чек-лист стенда мини: термоусадка, крокодилы, флюс, каптон; припой с кислотным флюсом — заменить
2026-10-17 Чек-лист стенда мини: флюс ЛТИ-120 — карточка 3421736512
2026-10-17 Чек-лист стенда мини: припой ПОС-61 с канифолью вместо кислотного
2026-10-17 Чек-лист стенда мини: ещё 2 привода, винты M2 до 60, шестигранник 1,5 мм
2026-10-17 Чек-лист стенда мини: отвёртка Xiaomi Duka ATuMan E3 — обязательное для стенда куплено
2026-10-17 Чек-лист стенда мини: бокорезы VIRA и стриппер Pro'sKit 8PK-3001D
2026-10-17 Чек-лист стенда мини: бокорезы и стриппер заказаны
2026-10-17 Чек-лист стенда мини: крокодилы, каптон, припой, флюс, термоусадка заказаны
2026-10-17 Стенд мини: программа для STS3032 и ноги целиком, прошивка Pico 2 для шины
    - профили приводов (STS3215 / STS3032) с нормами из даташитов, состояние одним чтением, запись «середины»
    - нога: калибровка в позе «Г», позы, стойка на весах, момент бедра, шаг 10 мин, оценка батареи
    - имитация ноги с весами (--sim), 17 тестов; run_bench_mini_windows.bat
    - код/прошивка/pico: шина Feetech на MicroPython, замер 12, проверка на ПК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
2026-10-17 Pico 2: Thonny и MicroPython 1.29 установлены, *.uf2 не в git
2026-10-17 Главная заметка: «Компакт мини», чек-лист стенда, программа стенда мини и прошивка Pico
2026-10-17 Корневой README: короткий вход — версии, текущий этап, папки, как открыть
2026-10-17 graphify: граф обновлён — мини, стенд, прошивка Pico, заметки (1541 узел, 3304 связи, 83 сообщества); шум (three.js, текстуры, JSON-данные) исключён
2026-10-25 Двойник «Компакт мини» в браузере; визуализация «Компакта» помечена; стенд мини ссылается на даташиты
    - визуализация/Двойник мини.html: детали из CAD мини, позы, клешни по углам приводов с правилами движения,
    глаза (правило 2), камера (доля кадра под клешнями, лицо), 6 датчиков края, опора, момент бедра
    - модели/рендер/export_web_mini.py → визуализация/lib/harvey_mini_meshes.js
    - переключатель версий в обоих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
2026-10-25 graphify: полная пересборка — двойник мини, ссылки на даташиты (1544 узла, 3317 связей, 80 сообществ)
2026-10-25 graphify как карта проекта: правило в CLAUDE.md и git-хуки (код в графе обновляется после коммита)
2026-10-25 graphify: stat-index кэша не версионировать
2026-10-25 Навыки Obsidian (kepano/obsidian-skills, MIT): markdown, Bases, Canvas, CLI, Defuddle, Knap — в .claude/skills проекта
2026-10-25 graphify: навыки .claude и .obsidian не в графе; кэш и резервные копии — вне git
2026-10-25 Схемы «Компакт мини»: проводка (WireViz), шины приводов с ID, интерфейс шины (schemdraw)
    - схемы/make_wiring.py → mini_power, mini_bus (svg/png/html + спецификация жгутов), bus_buffer
    - токи и сечения по участкам, ID = 10 × конечность + сустав, выводы RP2350 (предварительно)
    - поправки списка: pogo 3–5 А, выключатель ≥ 10 А, провод 22 AWG; станция 5 В в сводке мини
    [mini_bus.bom.tsv, mini_power.bom.tsv]
2026-10-25 graphify: граф после схем (хук)
2026-10-25 Схемы мини: листы Pi Zero 2 W (камера, глаза, звук, кнопки) и датчиков RP2350; предварительные карты выводов
    [mini_pi.bom.tsv, mini_sensors.bom.tsv]
2026-10-25 graphify: граф после схем Pi и датчиков (хук)
2026-10-25 Комплектация мини по схемам проводки; главная, README и чек-лист стенда — ссылки на схемы
2026-10-25 CLAUDE.md: правило работы с даташитами
2026-10-25 CLAUDE.md: копия проекта на GitHub и как её обновлять
2026-10-25 Репозиторий на GitHub открыт для всех
2026-10-31 Качество кода: скил ub-mode, плагин superpowers для проекта, проверка crapper/dryer для стенда
    Правило в CLAUDE.md: правка кода — тест до правки, CRAP < 10, без дублей.
    Отчёты .metrics/ не версионируются.
2026-10-31 ub-mode SOURCE.txt: путь к окружению
2026-10-31 Проверка качества стенда: покрытие в окружении стенда, crapper/dryer/mutator работают на Windows
    crapper сам звал заглушку python3 из Microsoft Store и ставил 0 %;
    check_quality.bat считает покрытие через harvey-bench и передаёт его crapper.
    Проверено: 17 тестов, покрытие 28 %, дублей нет, мутанты sts.py 46/68.
2026-10-31 .gitignore: отчёты coverage/mutator во вложенных папках; вернуть окончания строк
    Правило target/coverage/ действовало только от корня; SOURCE.txt — снова LF.
2026-11-02 Стенд: bench.main разбит на части, тесты меню и программы целиком
    Почему: main был одной функцией на 38 ветвлений (CRAP 1482) — правка любого пункта меню рисковала остальными.
    Что: parse_args, open_bench, compact_actions / mini_actions (таблицы пунктов), run_menu, release; Session помнит номер привода.
    Проверка: 7 тестов программы целиком (автопрогоны обоих стендов, неизвестный пункт, номер привода, Ctrl+C отпускает приводы)
    написаны д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
2026-11-02 Стенд: тесты ноги мини, траектория шага — чистая функция step_pose
    Почему: у leg.py было 22 % покрытия, а на нём весь стенд ноги.
    Что: 64 теста на имитации (калибровка, позы, стойка, момент бедра, шаг, батарея, пороги норм); step_pose вынесен из gait
    по TDD (тесты падали без функции).
    Проверка: покрытие leg.py 99 %, мутанты пойманы на 76 % (было 57 %).
2026-11-02 Журнал: тесты и разбиение стенда; вторая правка mutator для Windows
2026-11-02 Стенд: stance_scale и gait разбиты, нормы — чистые функции
    Почему: обе функции были полностью покрыты, но слишком разветвлены (CRAP 24 и 17 при цели 10).
    Что: нормы и разбор ввода — parse_grams, stance_ok, abort_reason, gait_ok, LOG_HEADER (по TDD: 22 теста падали без них);
    stance_scale → _press_until_weight, _scale_hint, _hold_stance, _stance_readings; gait → _walk, _log_sample, _gait_report.
    Проверка: 102 теста проходят; CRAP stance_scale 6, gait 5; функций с CRAP ≥ 10 — 11 из 117; мутанты leg.py 76,6 %.
    Co-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
2026-11-02 Журнал: разбиение stance_scale и gait, итоги всех проверок
2026-11-02 graphify: граф после тестов и разбиения стенда (хук)
2026-11-02 Стенд: тесты замеров одного привода с точными числами
    Почему: замеры STS3215 / STS3032 проверялись только на попадание в отчёт — ошибка в расчёте прошла бы незамеченной.
    Что: 58 тестов на имитации — калибровка тока (файл, старый ключ, масштаб по блоку питания), окно напряжения и 60 °C,
    поиск и номер привода, ток покоя и упора (2,4–3,0 А, мини ≤ 0,08 А), момент при 12 и 10,2 В, скорость по паспорту,
    люфт по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
2026-11-02 Журнал: тесты замеров одного привода
2026-11-02 graphify: граф после тестов замеров (хук)
2026-11-02 Стенд: heat_test разбит, нормы нагрева — чистые функции
    Почему: heat_test — самая разветвлённая функция стенда (сложность 16).
    Что: heat_abort (70 °C, ток > 2,2 А дольше 5 с) и heat_ok — по TDD (12 тестов падали без них); цикл — _heat_run,
    нагрузка имитации — _sim_load; ещё 2 теста: момент включён весь замер, корпус по умолчанию = датчик − 3 °C.
    Проверка: 174 теста; CRAP heat_test 5; мутанты кода нагрева 72 %, норм — 100 %.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
2026-11-02 Журнал: разбиение heat_test
2026-11-02 graphify: граф после разбиения heat_test (хук)
2026-11-02 Стенд: calibrate и femur_torque разбиты, расчёты — чистые функции
    Почему: последние разветвлённые функции ноги (CRAP 11 и 12).
    Что: middle_offset, direction, torque_nm, stall_current — по TDD (17 тестов падали без них); calibrate →
    _write_middle, _ask_direction, _sim_table; femur_torque → _press_femur, _torque_report.
    Ещё 3 теста по выжившим мутантам: бедро отпущено после замера, подъём на 3° сразу после упора,
    ход 10° от настоящей «Г», когда середина не записалась — ка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
    [leg.py, test_leg.py]
2026-11-02 Журнал: разбиение calibrate и femur_torque
2026-11-02 graphify: граф после разбиения calibrate и femur_torque (хук)
2026-11-02 Стенд: scan и current_test разбиты; 2 ошибки исправлены
    Почему: обе функции на границе CRAP 10, а при разборе нашлись две ошибки.
    Ошибки (тесты падали до правки):
    - scan читал модель второй раз без защиты — если привод не ответил, весь поиск падал (теперь модель −1);
    - ток в упоре STS3215 перезаписывал bench_calibration.json целиком и стирал калибровку мини.
    Что: model_label, scan_note, scaled_lsb (по TDD); _model, _idle_current, _stall_current, _sim_block;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
    [bench.py, test_bench.py]
2026-11-02 Журнал: разбиение scan и current_test, 2 исправленные ошибки
2026-11-02 graphify: граф после разбиения scan и current_test (хук)
2026-11-02 Стенд: report.write разбит, тесты читают сам Excel-отчёт
    Почему: отчёт Excel не проверял ни один тест (только JSON), а write был на границе CRAP 10.
    Что: 11 тестов открывают .xlsx — листы, заголовки, строки замеров, цвет итога, ширины, журнал (5 и 11 колонок);
    verdict_fill — по TDD; write → _results_sheet, _log_sheet.
    Проверка: 219 тестов, check_quality.bat проходит; CRAP write 2; мутанты report.py 14 из 14.
2026-11-02 Журнал: report.write, итог программы стенда
2026-11-02 graphify: граф после разбиения report (хук)
2026-11-02 Документы: даташиты датчиков, дисплеев глаз и маяка станции
    Почему: правило CLAUDE.md — регистры, напряжения и тайминги только из документов с указанием источника.
    Что: VL53L4CD (ST, DS13812), BMI270 (Bosch), INA226 (TI), TSOP382 и TSAL6200 (Vishay), NE556 (TI),
    GC9D01N (Galaxycore) и код запуска панели 0,71″ от Waveshare; в Документы.md — что из каждого взято.
2026-11-02 Прошивка RP2350 «спинной мозг» мини: датчики, рефлексы, связь с Pi
    Почему: к приезду Pico прошивка датчиков должна быть готова и проверена на ПК.
    Что: драйверы VL53L4CD (порт ULD через Adafruit, MIT), BMI270 (файл конфигурации Bosch API, BSD-3),
    INA226; 6 датчиков края со сменой адресов через XSHUT; события IMU; ИК-маяк; протокол JSON с Pi;
    рефлексы — край, подняли, падение, батарея, станция; главный цикл Spine; UART на PIO для шины C.
    П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
    [BMI270-CONFIG-LICENSE.txt]
2026-11-02 Голова мини на Pi Zero 2 W: глаза, настроение, касания, звук, связь
    Почему: Харви должен жить и без ПК — реагировать на край, руки, поглаживание, батарею.
    Что: рисование глаз (10 выражений, моргание, взгляд), драйвер GC9D01 по коду Waveshare, настроение,
    касания TTP223 (погладить / коснуться / подержать), aplay/arecord, связь с RP2350 (USB) и ПК (TCP)
    с переподключением; предпросмотр глаз; найдено и исправлено: взгляд пр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
    [audio.py, config.py, eyes.py, gc9d01.py, head.py, links.py, main.py, mood.py]
2026-11-02 Симуляция мини: 69 тестов; массы клешней и замер поворота исправлены
    Почему: у симуляции не было ни одного теста, а по ней считаются нагрузки приводов.
    Что: тесты кинематики против MuJoCo, правил клешней, походки, сценариев с нормами, клавиш и
    самопроверки управления. Тесты нашли две ошибки:
    - привод локтя в модели весил 0,0001 кг вместо 20 г, привод подъёма плеча сидел в качающемся
    звене —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
    [harvey_mini.py, harvey_mini_teleop.py, mini_objects.py]
2026-11-02 Станция: маяк NE556, проводка, отсек электроники; ИК-приёмники на корпусе
    Почему: TSOP38238 подавляет непрерывные 38 кГц — маяку нужны пачки, одного NE555 мало;
    на корпусе робота приёмников в CAD не было.
    Что: схема маяка (пачки 1,40 / 0,57 мс, 508/с; несущая 38 кГц с подстройкой; TSAL6200 105 мА
    в импульсе, 37 мА в среднем) и лист проводки станции (USB-C 5 В 3 А → PTC 3 А → pogo и маяк);
    башенка с отсеком и крышкой dock_cover; 2 × T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
    [dock_cover.stl, dock_cover_PLA.stl, dock_tower.stl, dock_tower_PLA.stl, mini_sensors.bom.tsv, station.bom.tsv, torso__pcb.stl]
2026-11-02 Журнал и CLAUDE.md: прошивка RP2350, голова, тесты симуляции, станция
2026-11-02 graphify: код прошивки RP2350, головы и тестов симуляции в графе (update, без LLM)
2026-11-02 ub-mode SOURCE.txt: третья правка mutator — вывод упавших прогонов для поиска ложных поимок
2026-11-02 Симуляция мини: общая походка Walker, стол с краями, contact_force; план поведения по датчикам
2026-11-02 Симуляция мини: датчики края, IMU, ИК-маяк, шины и «зрение» руки для настоящей прошивки RP2350
2026-11-02 Симуляция мини: робот целиком через настоящий Spine — походка, рефлекс края, «подняли», телеметрия, заряд
2026-11-02 Голова мини: поведение — осмотреться, к руке, у края, подняли, домой по ИК-маяку (поиск, центрирование, площадка → башенка, лечь, повтор)
2026-11-03 Мини: курс по гироскопу (gyr в телеметрии RP2350), заход на станцию по метке AprilTag, центрирование по маяку в обе стороны, заряд — только под латунными пластинами
2026-11-03 Мини: сценарии поведения с нормами (домой 10/10 по метке, маяк, край, рука, подняли); калибровка края по расчётному расстоянию; документы и журнал
2026-11-03 Домой без ПК: метка AprilTag на голове (направление и расстояние), маяк станции на RP2350-Zero с двумя светодиодами (пачки 0,6 / 1,2 мс), Харви различает их и слушает третий приёмник по центру
2026-11-03 Домой без ПК и в темноте: выход на ось по клину двух светодиодов, станция с перегородкой (CAD, схема, комплектация), центральный ИК-приёмник; при свете 10/10, в темноте 8/10
    [dock_tower.stl, dock_tower_PLA.stl, mini_sensors.bom.tsv, station.bom.tsv, torso__pcb.stl]
2026-11-04 Голова мини: походка (gait.py), приводы (servos.py), тело (body.py), камера (camera.py); симуляция ведёт робота настоящей головой; домой в темноте 10/10, при свете 10/10
2026-11-04 Стенд без приводов для Pico 2 (selftest.py на плате, bench_pc.py на ПК) и калибровка нулей приводов (calibrate.py, запрос pos?, подставка calib_jig)
    [calib_jig_PLA.stl]
2026-11-04 «Большой мозг» на ПК, этап A: слово «Харви», быстрые команды, LLM через Ollama (прогрев, действия только по просьбе), TCP-сервер для головы; 88 тестов
2026-11-04 «Большой мозг», этап B: голос — микрофон → Silero VAD → GigaAM v2 → «Харви» по звуковому ключу → ответ голосом Piper (полудуплекс, без эха); модели вне репозитория (~/.harvey/models), sherpa-onnx 1.1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
2026-11-05 Установка головы на Pi Zero 2 W: deploy.py (ПК → Pi по ssh), provision.py (пакеты, venv, группы, config.txt, служба), check.py (проверка железа и связи), настройки из окружения; 234 теста
2026-11-05 Мозг ведёт Харви в симуляции: mini_brain.py (голова в MuJoCo подключается к harvey_brain по TCP, команды текстом → поведение и глаза), run_brain_sim.bat открывает окно мозга; домой по команде мозга з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
2026-11-05 Харви-помощник: время и дата, таймеры и напоминания (числа словами, «в 7 вечера», после перезапуска — «пока меня не было»), память об имени и фактах (~/.harvey/memory.json, подсказка LLM), без LLM и 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
2026-11-05 Звук и картинка между головой и ПК: медиа-связь :8766 (двоичные кадры), микрофоны головы → распознавание на ПК, голос ПК → динамик головы (полудуплекс), серые кадры камеры по запросу; arecord перезап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
2026-11-05 Зрение на ПК: лица (YuNet, OpenCV 5.0) — глаза следят за лицом, «Привет, <имя>!» после долгого отсутствия, «посмотри на меня» — поворот корпусом к человеку (цель turn у головы, короткой дорогой); кад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
